rivosinc/scampi/scampi.kicad_sch

## KiCad design scampi.kicad_sch (2025-05-27)

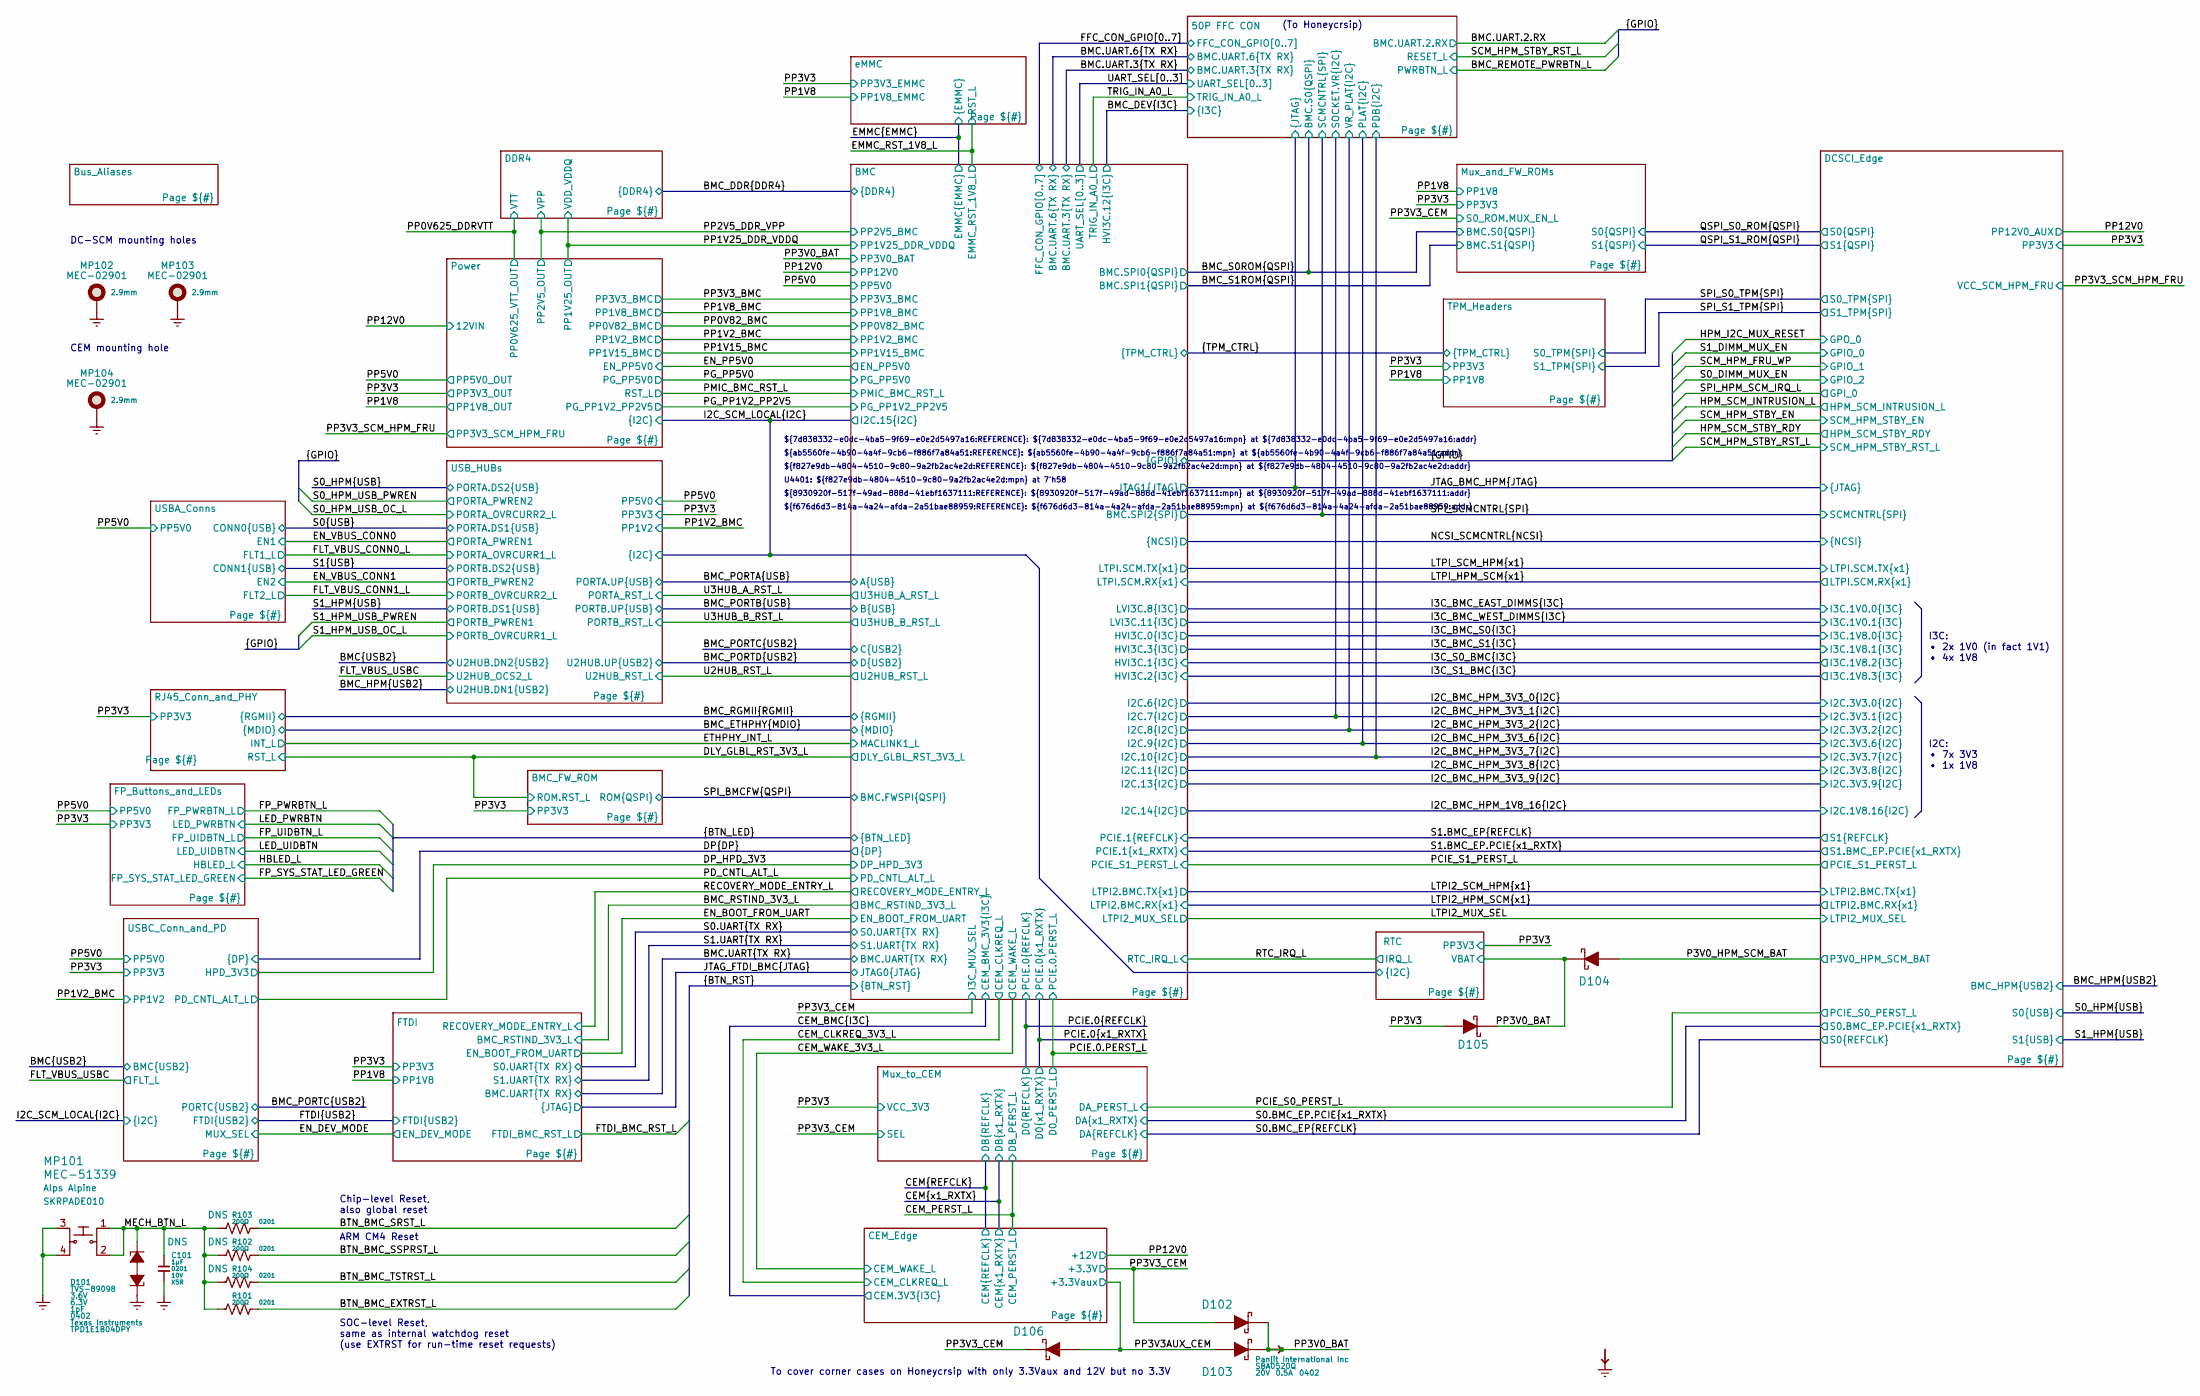
[picture p1: schematic scampi.kicad_sch]

Parts:
C101: CCM-710AD; mpn GRM033R61A105ME15
D101: TVS-89098; mpn TPD1E1B04DPY
D102, D103, D104, D105, D106: DIO-14387; mpn SBA0520Q
MP101: MEC-51339; mpn SKRPADE010
MP102, MP103, MP104: MEC-02901
R101, R102, R103, R104: RES-3200A

Connections:
BTN_BMC_EXTRST_L: R101.2
BTN_BMC_SRST_L: R103.2
BTN_BMC_SSPRST_L: R102.2
BTN_BMC_TSTRST_L: R104.2
GND: C101.2, D101.2, MP101.3, MP101.4, MP102.1, MP103.1, MP104.1
MECH_BTN_L: C101.1, D101.1, MP101.1, MP101.2, R101.1, R102.1, R103.1, R104.1
P3V0_HPM_SCM_BAT: D104.A
PP3V0_BAT: D102.K, D103.K, D104.K, D105.K
PP3V3: D105.A
PP3V3AUX_CEM: D103.A, D106.A
PP3V3_CEM: D102.A, D106.K

Notes on the sheet:
${f676d6d3-814a-4a24-afda-2a51bae88959:REFERENCE}: ${f676d6d3-814a-4a24-afda-2a51bae88959:mpn} at ${f676d6d3-814a-4a24-afda-2a51bae88959:addr}
I2C: • 7x 3V3 • 1x 1V8
${8930920f-517f-49ad-888d-41ebf1637111:REFERENCE}: ${8930920f-517f-49ad-888d-41ebf1637111:mpn} at ${8930920f-517f-49ad-888d-41ebf1637111:addr}
(To Honeycrsip)
DC-SCM mounting holes
${ab5560fe-4b90-4a4f-9cb6-f886f7a84a51:REFERENCE}: ${ab5560fe-4b90-4a4f-9cb6-f886f7a84a51:mpn} at ${ab5560fe-4b90-4a4f-9cb6-f886f7a84a51:addr}
CEM mounting hole
Chip-level Reset, also global reset
SOC-level Reset, same as internal watchdog reset (use EXTRST for run-time reset requests)
U4401: ${f827e9db-4804-4510-9c80-9a2fb2ac4e2d:mpn} at 7'h58
${7d838332-e0dc-4ba5-9f69-e0e2d5497a16:REFERENCE}: ${7d838332-e0dc-4ba5-9f69-e0e2d5497a16:mpn} at ${7d838332-e0dc-4ba5-9f69-e0e2d5497a16:addr}
ARM CM4 Reset
${f827e9db-4804-4510-9c80-9a2fb2ac4e2d:REFERENCE}: ${f827e9db-4804-4510-9c80-9a2fb2ac4e2d:mpn} at ${f827e9db-4804-4510-9c80-9a2fb2ac4e2d:addr}
I3C: • 2x 1V0 (in fact 1V1) • 4x 1V8
To cover corner cases on Honeycrsip with only 3.3Vaux and 12V but no 3.3V
