rivosinc/scampi/sch/adc.kicad_sch

## KiCad design sch/adc.kicad_sch (2025-05-27)

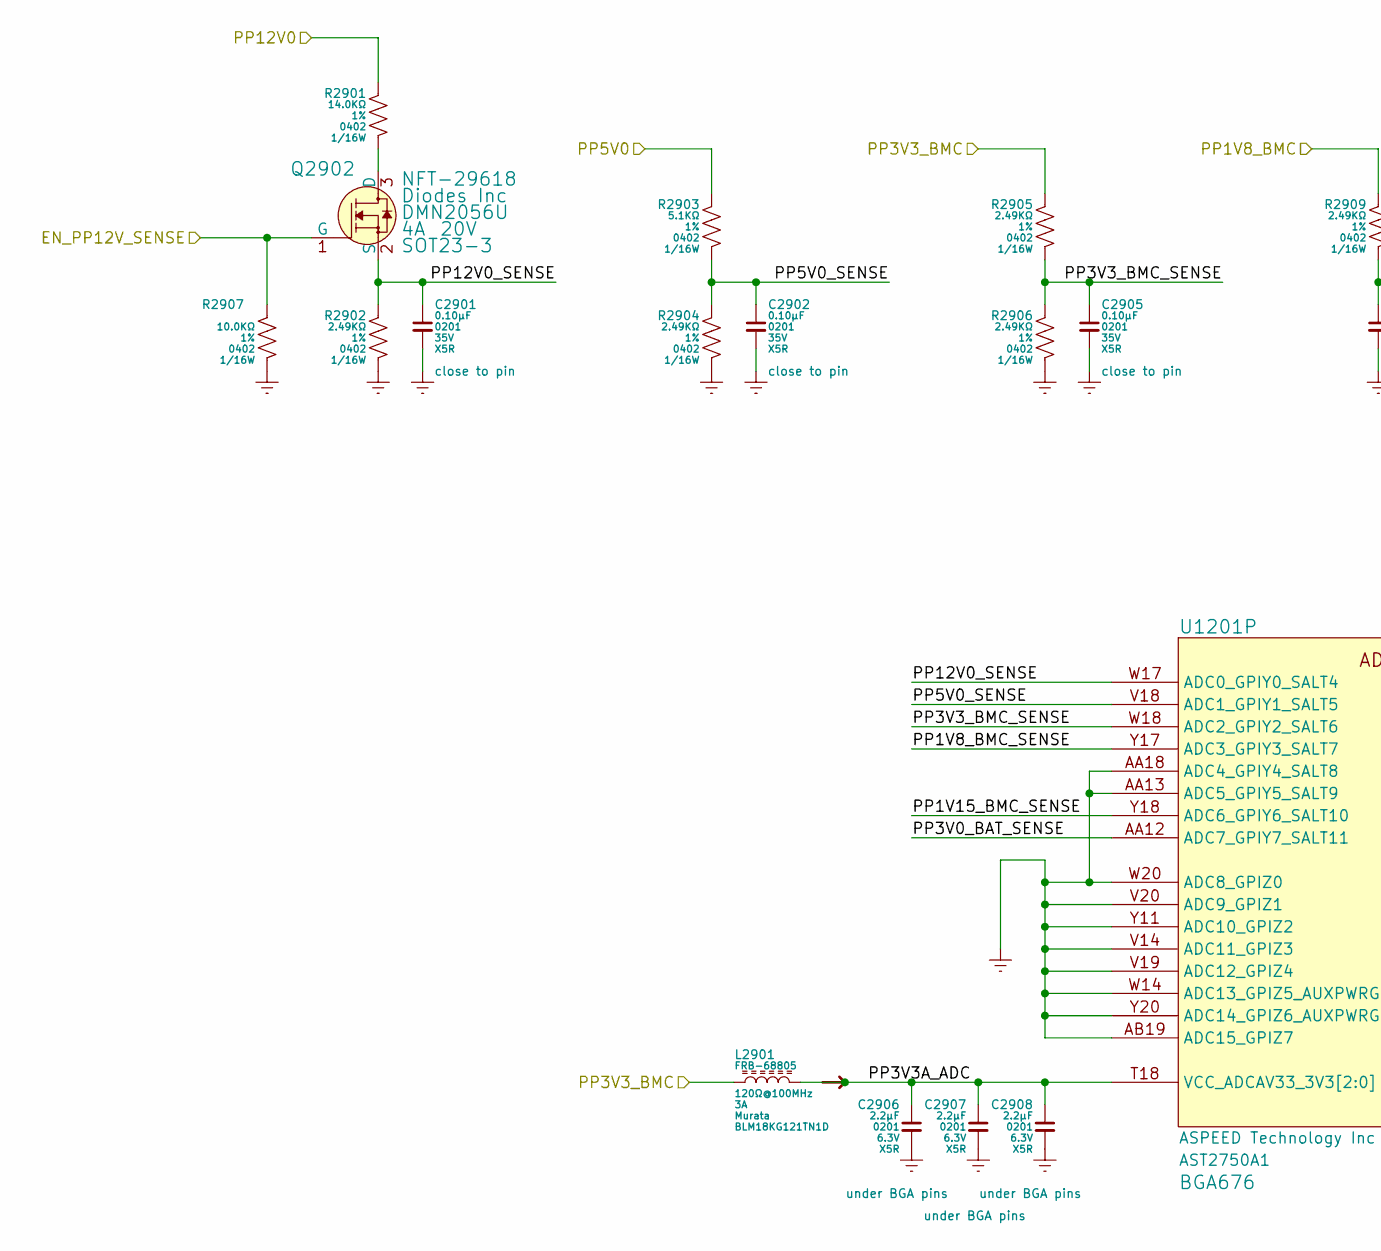
[picture p2: schematic adc.kicad_sch, part in row 1, column 1]

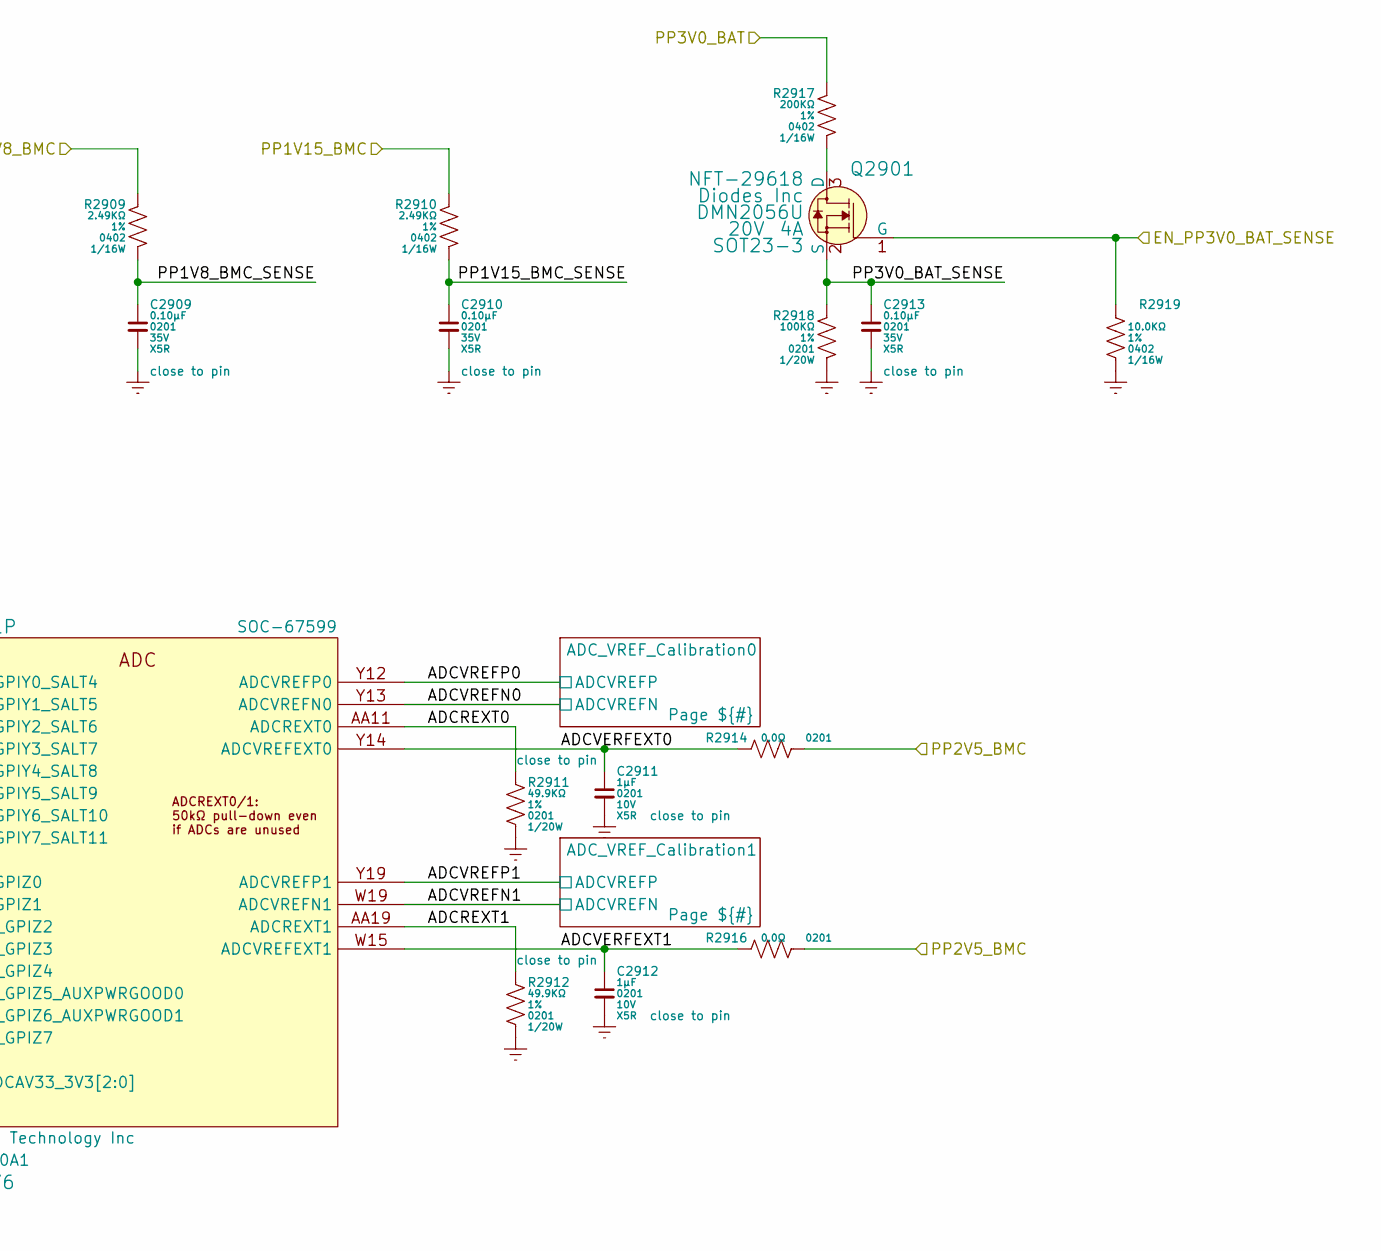
[picture p3: schematic adc.kicad_sch, part in row 1, column 2]

Parts:
C2901, C2902, C2905, C2909, C2910, C2913: CCM-610AE; mpn GRM033R6YA104ME14
C2906, C2907, C2908: CCM-722AA; mpn GRM033R60J225ME01
C2911, C2912: CCM-710AD; mpn GRM033R61A105ME15
L2901: FRB-68805; mpn BLM18KG121TN1D
Q2901, Q2902: NFT-29618; mpn DMN2056U
R2901: RES-5140B
R2902, R2904, R2905, R2906, R2909, R2910: RES-4249B
R2903: RES-4510B
R2907, R2919: RES-5100B
R2911, R2912: RES-5499A
R2914, R2916: RES-0000A
R2917: RES-6200B
R2918: RES-6100A
U1201: SOC-67599; mpn AST2750A1

Connections:
ADCREXT0: R2911.1, U1201.AA11 (ADCREXT0)
ADCREXT1: R2912.1, U1201.AA19 (ADCREXT1)
ADCVERFEXT0: C2911.1, R2914.1, U1201.Y14 (ADCVREFEXT0)
ADCVERFEXT1: C2912.1, R2916.1, U1201.W15 (ADCVREFEXT1)
ADCVREFN0: U1201.Y13 (ADCVREFN0)
ADCVREFN1: U1201.W19 (ADCVREFN1)
ADCVREFP0: U1201.Y12 (ADCVREFP0)
ADCVREFP1: U1201.Y19 (ADCVREFP1)
EN_PP3V0_BAT_SENSE: Q2901.1 (G), R2919.1
EN_PP12V_SENSE: Q2902.1 (G), R2907.1
GND: C2901.2, C2902.2, C2905.2, C2906.2, C2907.2, C2908.2, C2909.2, C2910.2, C2911.2, C2912.2, C2913.2, R2902.2, R2904.2, R2906.2, R2907.2, R2911.2, R2912.2, R2918.2, R2919.2, U1201.AA13 (ADC5_GPIY5_SALT9), U1201.AA18 (ADC4_GPIY4_SALT8), U1201.AB19 (ADC15_GPIZ7), U1201.V14 (ADC11_GPIZ3), U1201.V19 (ADC12_GPIZ4), U1201.V20 (ADC9_GPIZ1), U1201.W14 (ADC13_GPIZ5_AUXPWRGOOD0), U1201.W20 (ADC8_GPIZ0), U1201.Y11 (ADC10_GPIZ2), U1201.Y20 (ADC14_GPIZ6_AUXPWRGOOD1)
unnamed: Q2901.3 (D), R2917.2
unnamed: Q2902.3 (D), R2901.2
PP1V8_BMC: R2909.1
PP1V8_BMC_SENSE: C2909.1, R2909.2, U1201.Y17 (ADC3_GPIY3_SALT7)
PP1V15_BMC: R2910.1
PP1V15_BMC_SENSE: C2910.1, R2910.2, U1201.Y18 (ADC6_GPIY6_SALT10)
PP2V5_BMC: R2914.2, R2916.2
PP3V0_BAT: R2917.1
PP3V0_BAT_SENSE: C2913.1, Q2901.2 (S), R2918.1, U1201.AA12 (ADC7_GPIY7_SALT11)
PP3V3A_ADC: C2906.1, C2907.1, C2908.1, L2901.2, U1201.T18 (VCC_ADCAV33_3V3[2:0]), U1201.T19 (VCC_ADCAV33_3V3[2:0]), U1201.T20 (VCC_ADCAV33_3V3[2:0])
PP3V3_BMC: L2901.1, R2905.1
PP3V3_BMC_SENSE: C2905.1, R2905.2, R2906.1, U1201.W18 (ADC2_GPIY2_SALT6)
PP5V0: R2903.1
PP5V0_SENSE: C2902.1, R2903.2, R2904.1, U1201.V18 (ADC1_GPIY1_SALT5)
PP12V0: R2901.1
PP12V0_SENSE: C2901.1, Q2902.2 (S), R2902.1, U1201.W17 (ADC0_GPIY0_SALT4)
