rivosinc/scampi/sch/adc_vref_cali.kicad_sch

## KiCad design sch/adc_vref_cali.kicad_sch (2025-05-27)

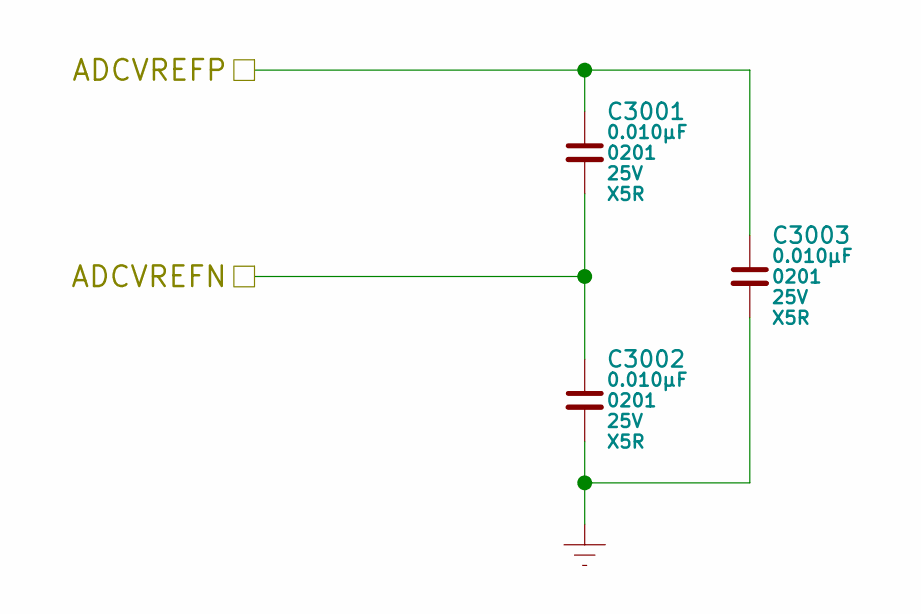
[picture p4: schematic adc_vref_cali.kicad_sch]

Parts:
C3001, C3002, C3003: CCM-510AC; mpn GRM033R61E103MA12

Connections:
ADCVREFN: C3001.2, C3002.1
ADCVREFP: C3001.1, C3003.1
GND: C3002.2, C3003.2
