rivosinc/scampi/sch/bmc.kicad_sch

## KiCad design sch/bmc.kicad_sch (2025-05-27)

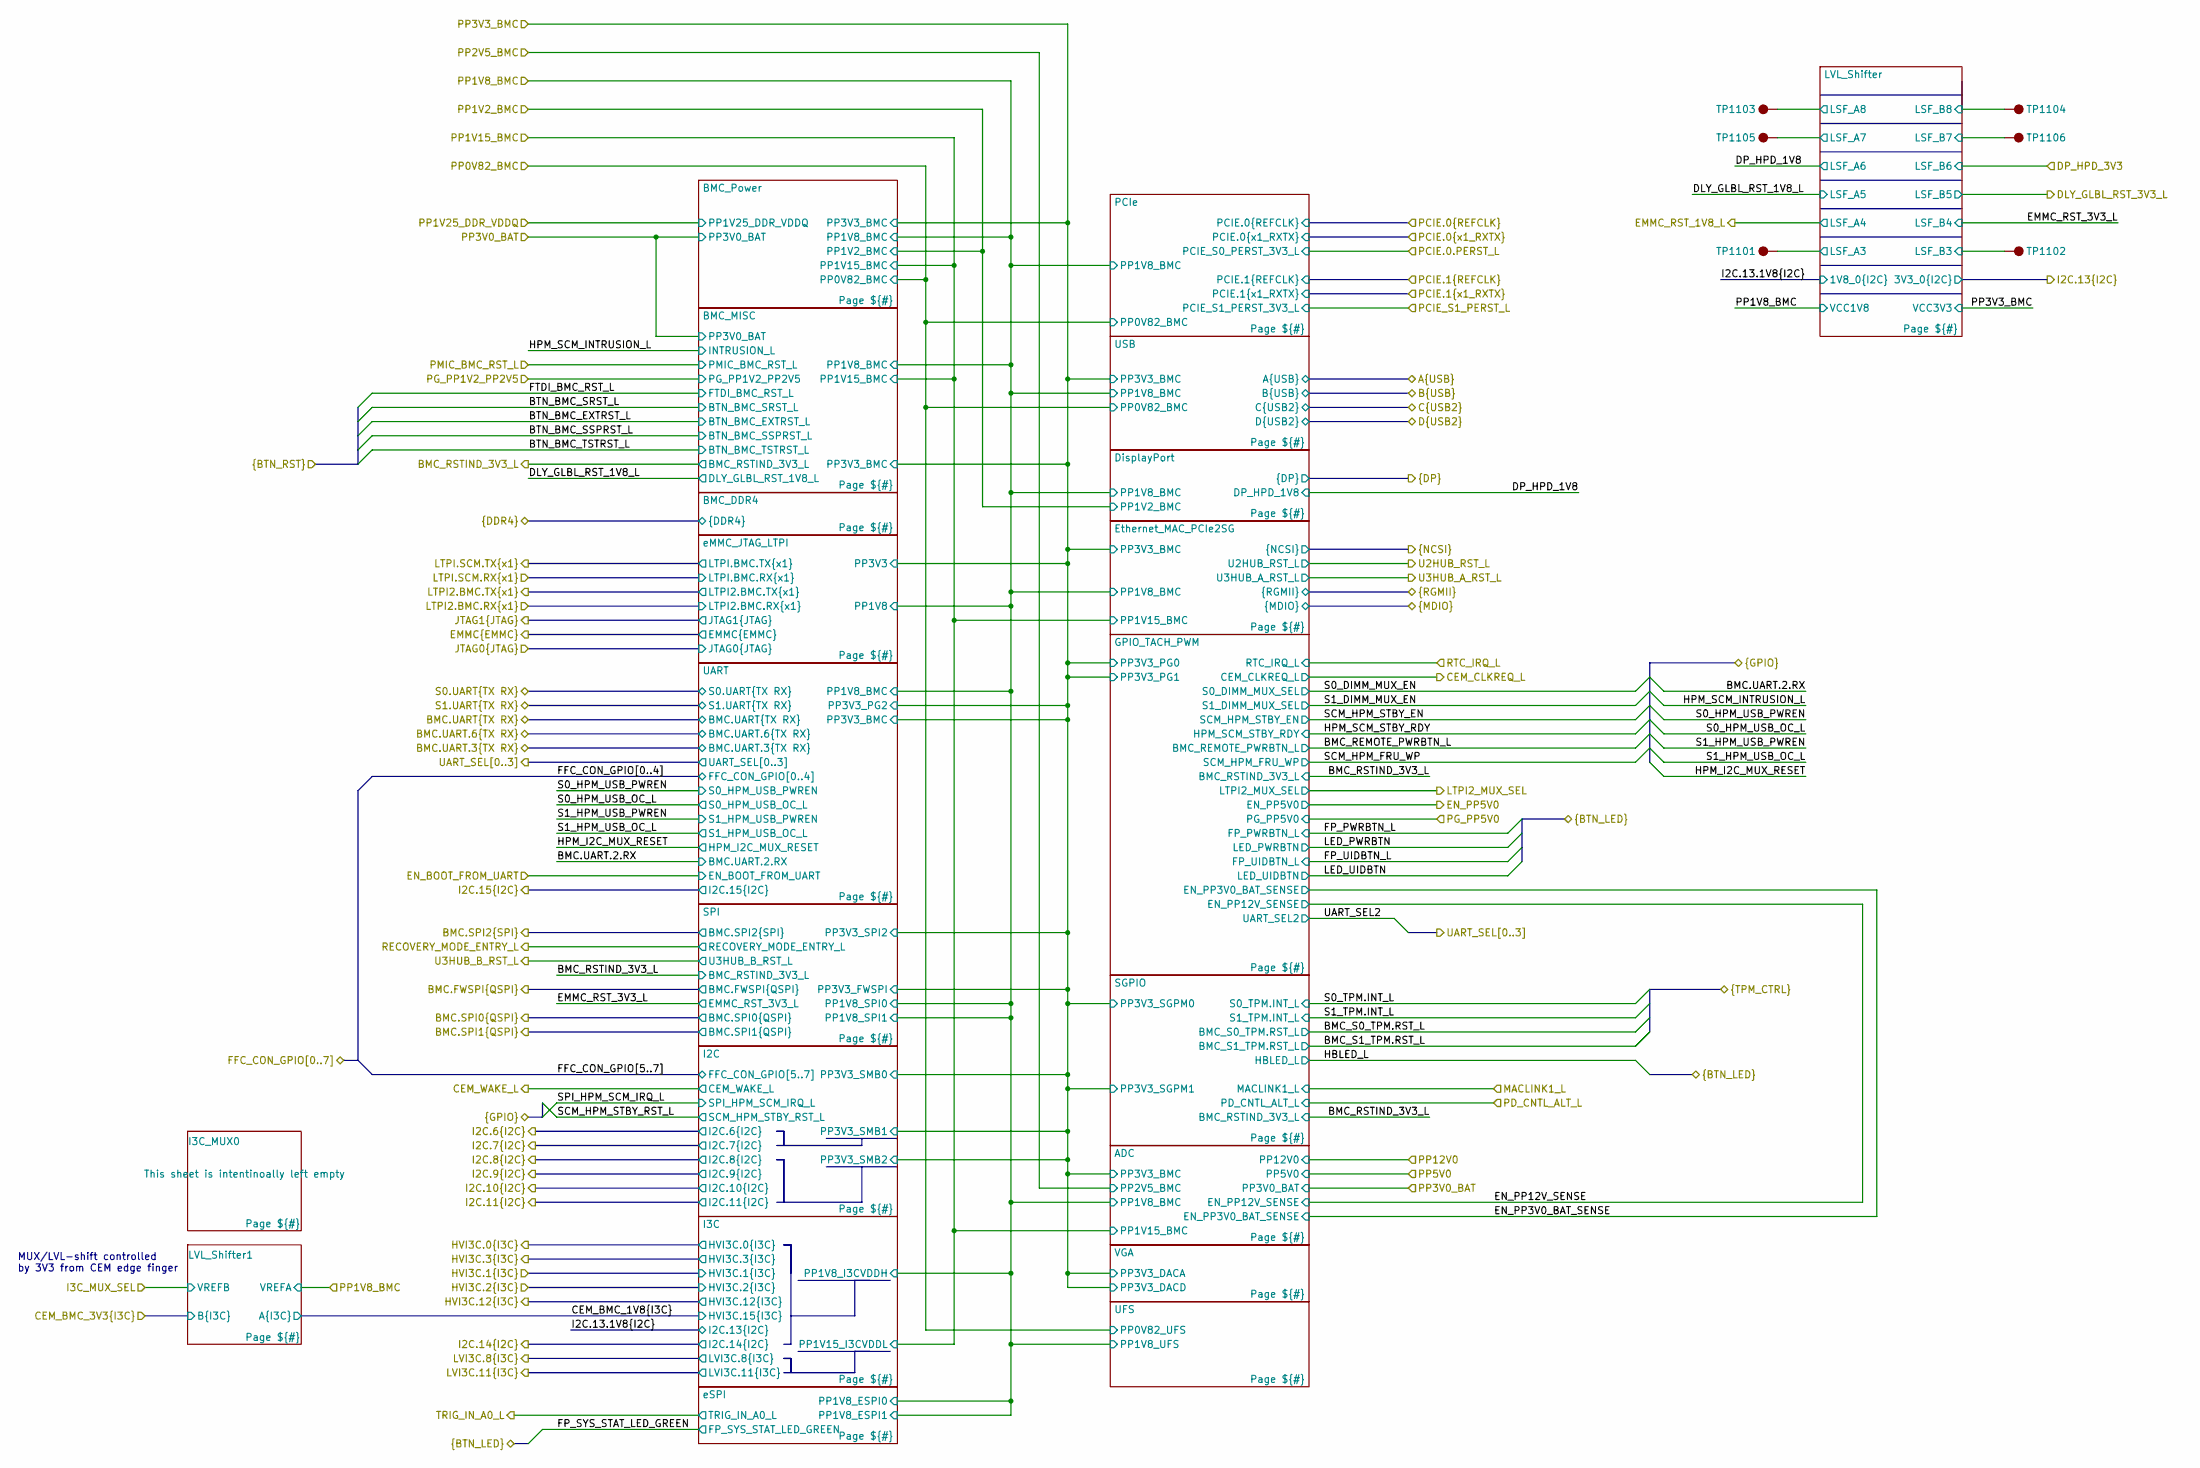
[picture p5: schematic bmc.kicad_sch]

Parts:
TP1101, TP1102, TP1103, TP1104, TP1105, TP1106: TST-01025

Connections:
LSF_A3: TP1101.1
LSF_A7: TP1105.1
LSF_A8: TP1103.1
LSF_B3: TP1102.1
LSF_B7: TP1106.1
LSF_B8: TP1104.1

Notes on the sheet:
MUX/LVL-shift controlled by 3V3 from CEM edge finger
