rivosinc/scampi/sch/bmc_ddr.kicad_sch

## KiCad design sch/bmc_ddr.kicad_sch (2025-05-27)

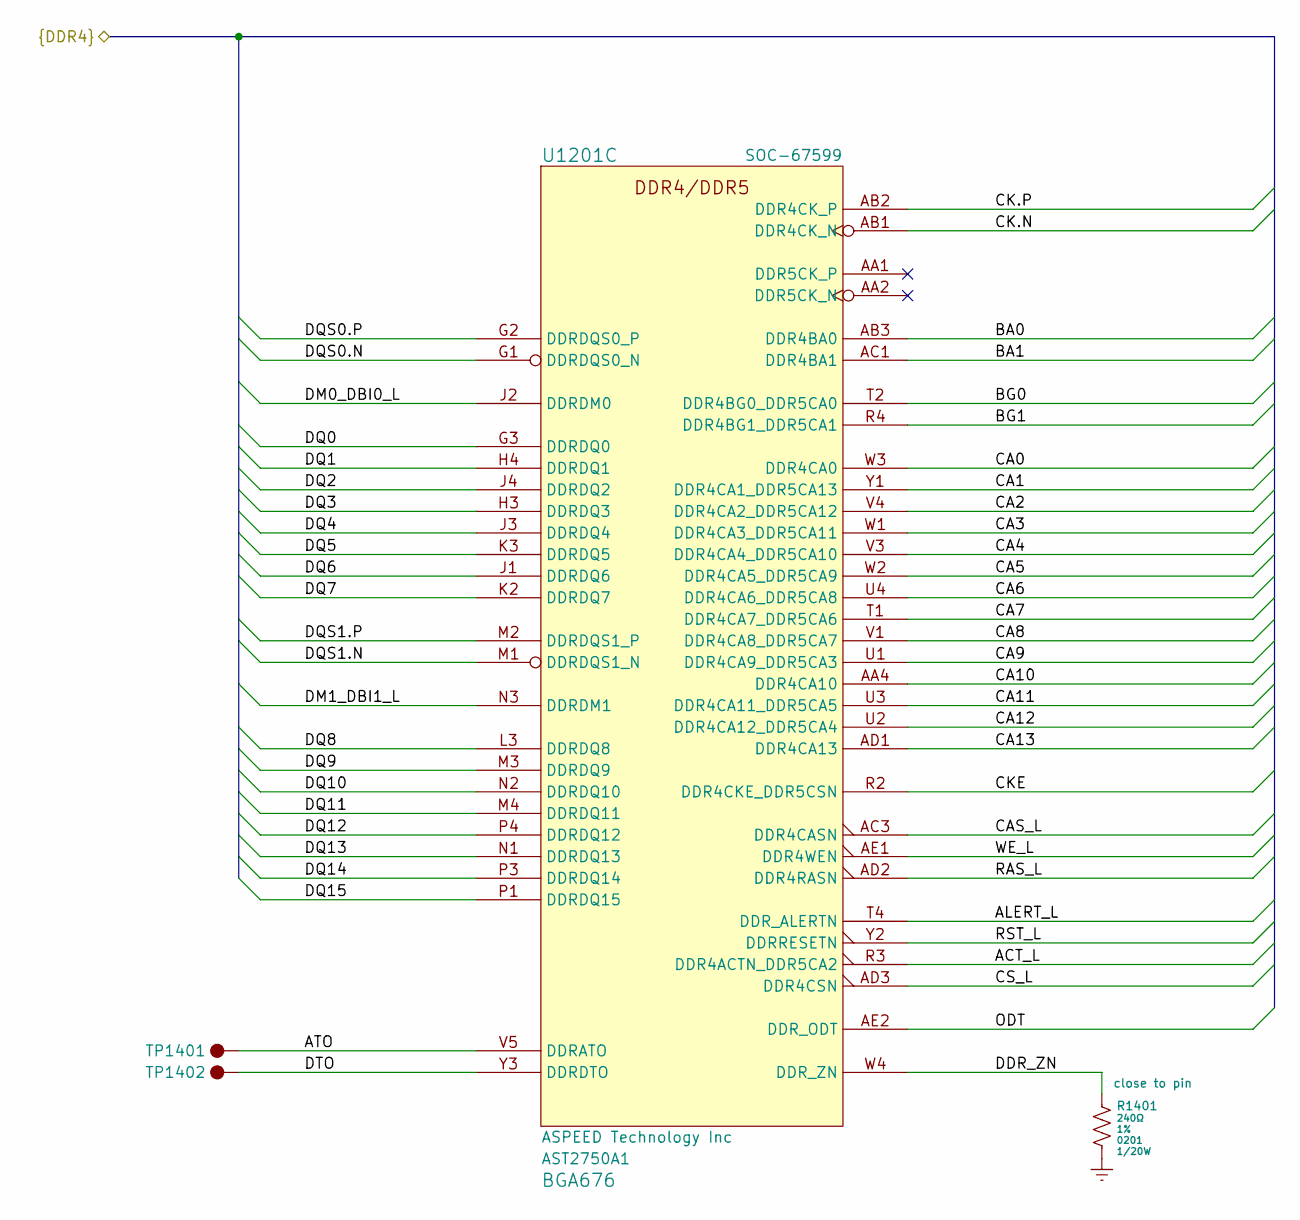
[picture p6: schematic bmc_ddr.kicad_sch]

Parts:
R1401: RES-3240A
TP1401, TP1402: TST-01025
U1201: SOC-67599; mpn AST2750A1

Connections:
ACT_L: U1201.R3 (DDR4ACTN_DDR5CA2)
ALERT_L: U1201.T4 (DDR_ALERTN)
ATO: TP1401.1, U1201.V5 (DDRATO)
BA0: U1201.AB3 (DDR4BA0)
BA1: U1201.AC1 (DDR4BA1)
BG0: U1201.T2 (DDR4BG0_DDR5CA0)
BG1: U1201.R4 (DDR4BG1_DDR5CA1)
CA0: U1201.W3 (DDR4CA0)
CA1: U1201.Y1 (DDR4CA1_DDR5CA13)
CA2: U1201.V4 (DDR4CA2_DDR5CA12)
CA3: U1201.W1 (DDR4CA3_DDR5CA11)
CA4: U1201.V3 (DDR4CA4_DDR5CA10)
CA5: U1201.W2 (DDR4CA5_DDR5CA9)
CA6: U1201.U4 (DDR4CA6_DDR5CA8)
CA7: U1201.T1 (DDR4CA7_DDR5CA6)
CA8: U1201.V1 (DDR4CA8_DDR5CA7)
CA9: U1201.U1 (DDR4CA9_DDR5CA3)
CA10: U1201.AA4 (DDR4CA10)
CA11: U1201.U3 (DDR4CA11_DDR5CA5)
CA12: U1201.U2 (DDR4CA12_DDR5CA4)
CA13: U1201.AD1 (DDR4CA13)
CAS_L: U1201.AC3 (DDR4CASN)
CK.N: U1201.AB1 (DDR4CK_N)
CK.P: U1201.AB2 (DDR4CK_P)
CKE: U1201.R2 (DDR4CKE_DDR5CSN)
CS_L: U1201.AD3 (DDR4CSN)
DDR_ZN: R1401.1, U1201.W4 (DDR_ZN)
DM0_DBI0_L: U1201.J2 (DDRDM0)
DM1_DBI1_L: U1201.N3 (DDRDM1)
DQ0: U1201.G3 (DDRDQ0)
DQ1: U1201.H4 (DDRDQ1)
DQ2: U1201.J4 (DDRDQ2)
DQ3: U1201.H3 (DDRDQ3)
DQ4: U1201.J3 (DDRDQ4)
DQ5: U1201.K3 (DDRDQ5)
DQ6: U1201.J1 (DDRDQ6)
DQ7: U1201.K2 (DDRDQ7)
DQ8: U1201.L3 (DDRDQ8)
DQ9: U1201.M3 (DDRDQ9)
DQ10: U1201.N2 (DDRDQ10)
DQ11: U1201.M4 (DDRDQ11)
DQ12: U1201.P4 (DDRDQ12)
DQ13: U1201.N1 (DDRDQ13)
DQ14: U1201.P3 (DDRDQ14)
DQ15: U1201.P1 (DDRDQ15)
DQS0.N: U1201.G1 (DDRDQS0_N)
DQS0.P: U1201.G2 (DDRDQS0_P)
DQS1.N: U1201.M1 (DDRDQS1_N)
DQS1.P: U1201.M2 (DDRDQS1_P)
DTO: TP1402.1, U1201.Y3 (DDRDTO)
GND: R1401.2
ODT: U1201.AE2 (DDR_ODT)
RAS_L: U1201.AD2 (DDR4RASN)
RST_L: U1201.Y2 (DDRRESETN)
WE_L: U1201.AE1 (DDR4WEN)
