rivosinc/scampi/sch/bmc_fw_rom.kicad_sch

## KiCad design sch/bmc_fw_rom.kicad_sch (2025-05-27)

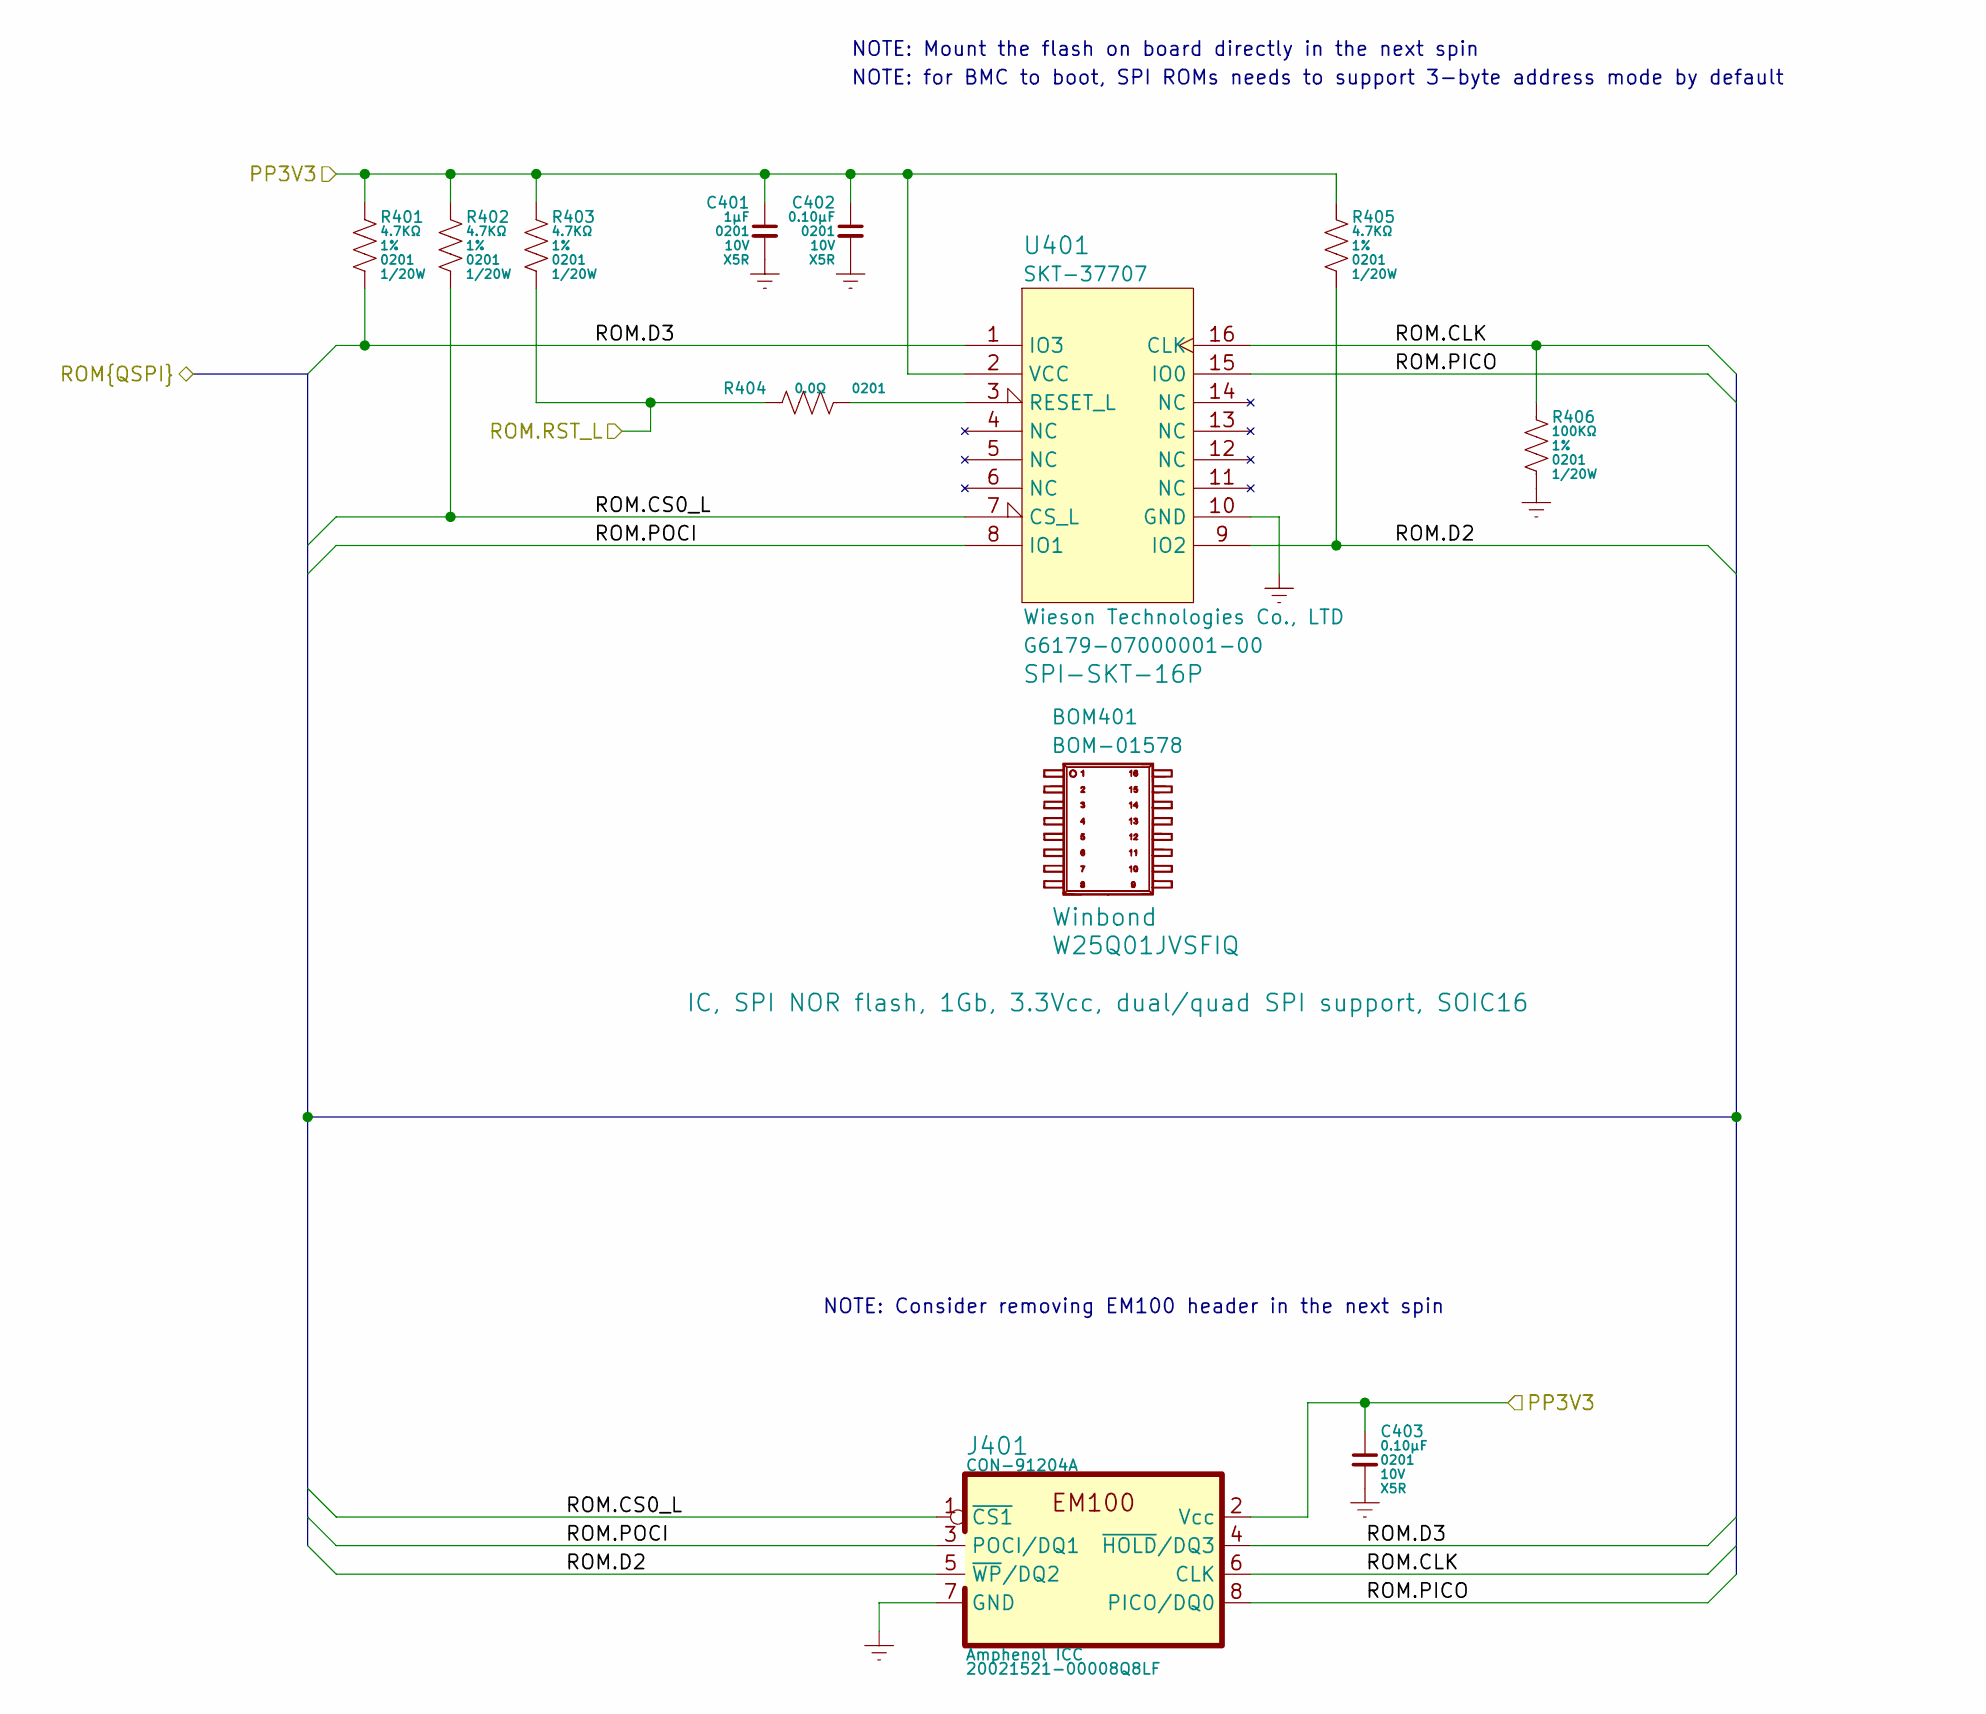
[picture p7: schematic bmc_fw_rom.kicad_sch]

Parts:
BOM401: BOM-01578; mpn W25Q01JVSFIQ
C401: CCM-710AD; mpn GRM033R61A105ME15
C402, C403: CCM-610AA; mpn GRM033R61A104ME15
J401: CON-91204A; mpn 20021521-00008Q8LF
R401, R402, R403, R405: RES-4470A
R404: RES-0000A
R406: RES-6100A
U401: SKT-37707; mpn G6179-07000001-00

Connections:
GND: C401.2, C402.2, C403.2, J401.7 (GND), R406.2, U401.10 (GND)
unnamed: R404.2, U401.3 (RESET_L)
PP3V3: C401.1, C402.1, C403.1, J401.2 (Vcc), R401.1, R402.1, R403.1, R405.1, U401.2 (VCC)
ROM.CLK: J401.6 (CLK), R406.1, U401.16 (CLK)
ROM.CS0_L: J401.1 (~CS1), R402.2, U401.7 (CS_L)
ROM.D2: J401.5 (~WP/DQ2), R405.2, U401.9 (IO2)
ROM.D3: J401.4 (~HOLD/DQ3), R401.2, U401.1 (IO3)
ROM.PICO: J401.8 (PICO/DQ0), U401.15 (IO0)
ROM.POCI: J401.3 (POCI/DQ1), U401.8 (IO1)
ROM.RST_L: R403.2, R404.1

Notes on the sheet:
NOTE: for BMC to boot, SPI ROMs needs to support 3-byte address mode by default
NOTE: Consider removing EM100 header in the next spin
NOTE: Mount the flash on board directly in the next spin
