rivosinc/scampi/sch/bmc_misc.kicad_sch

## KiCad design sch/bmc_misc.kicad_sch (2025-05-27)

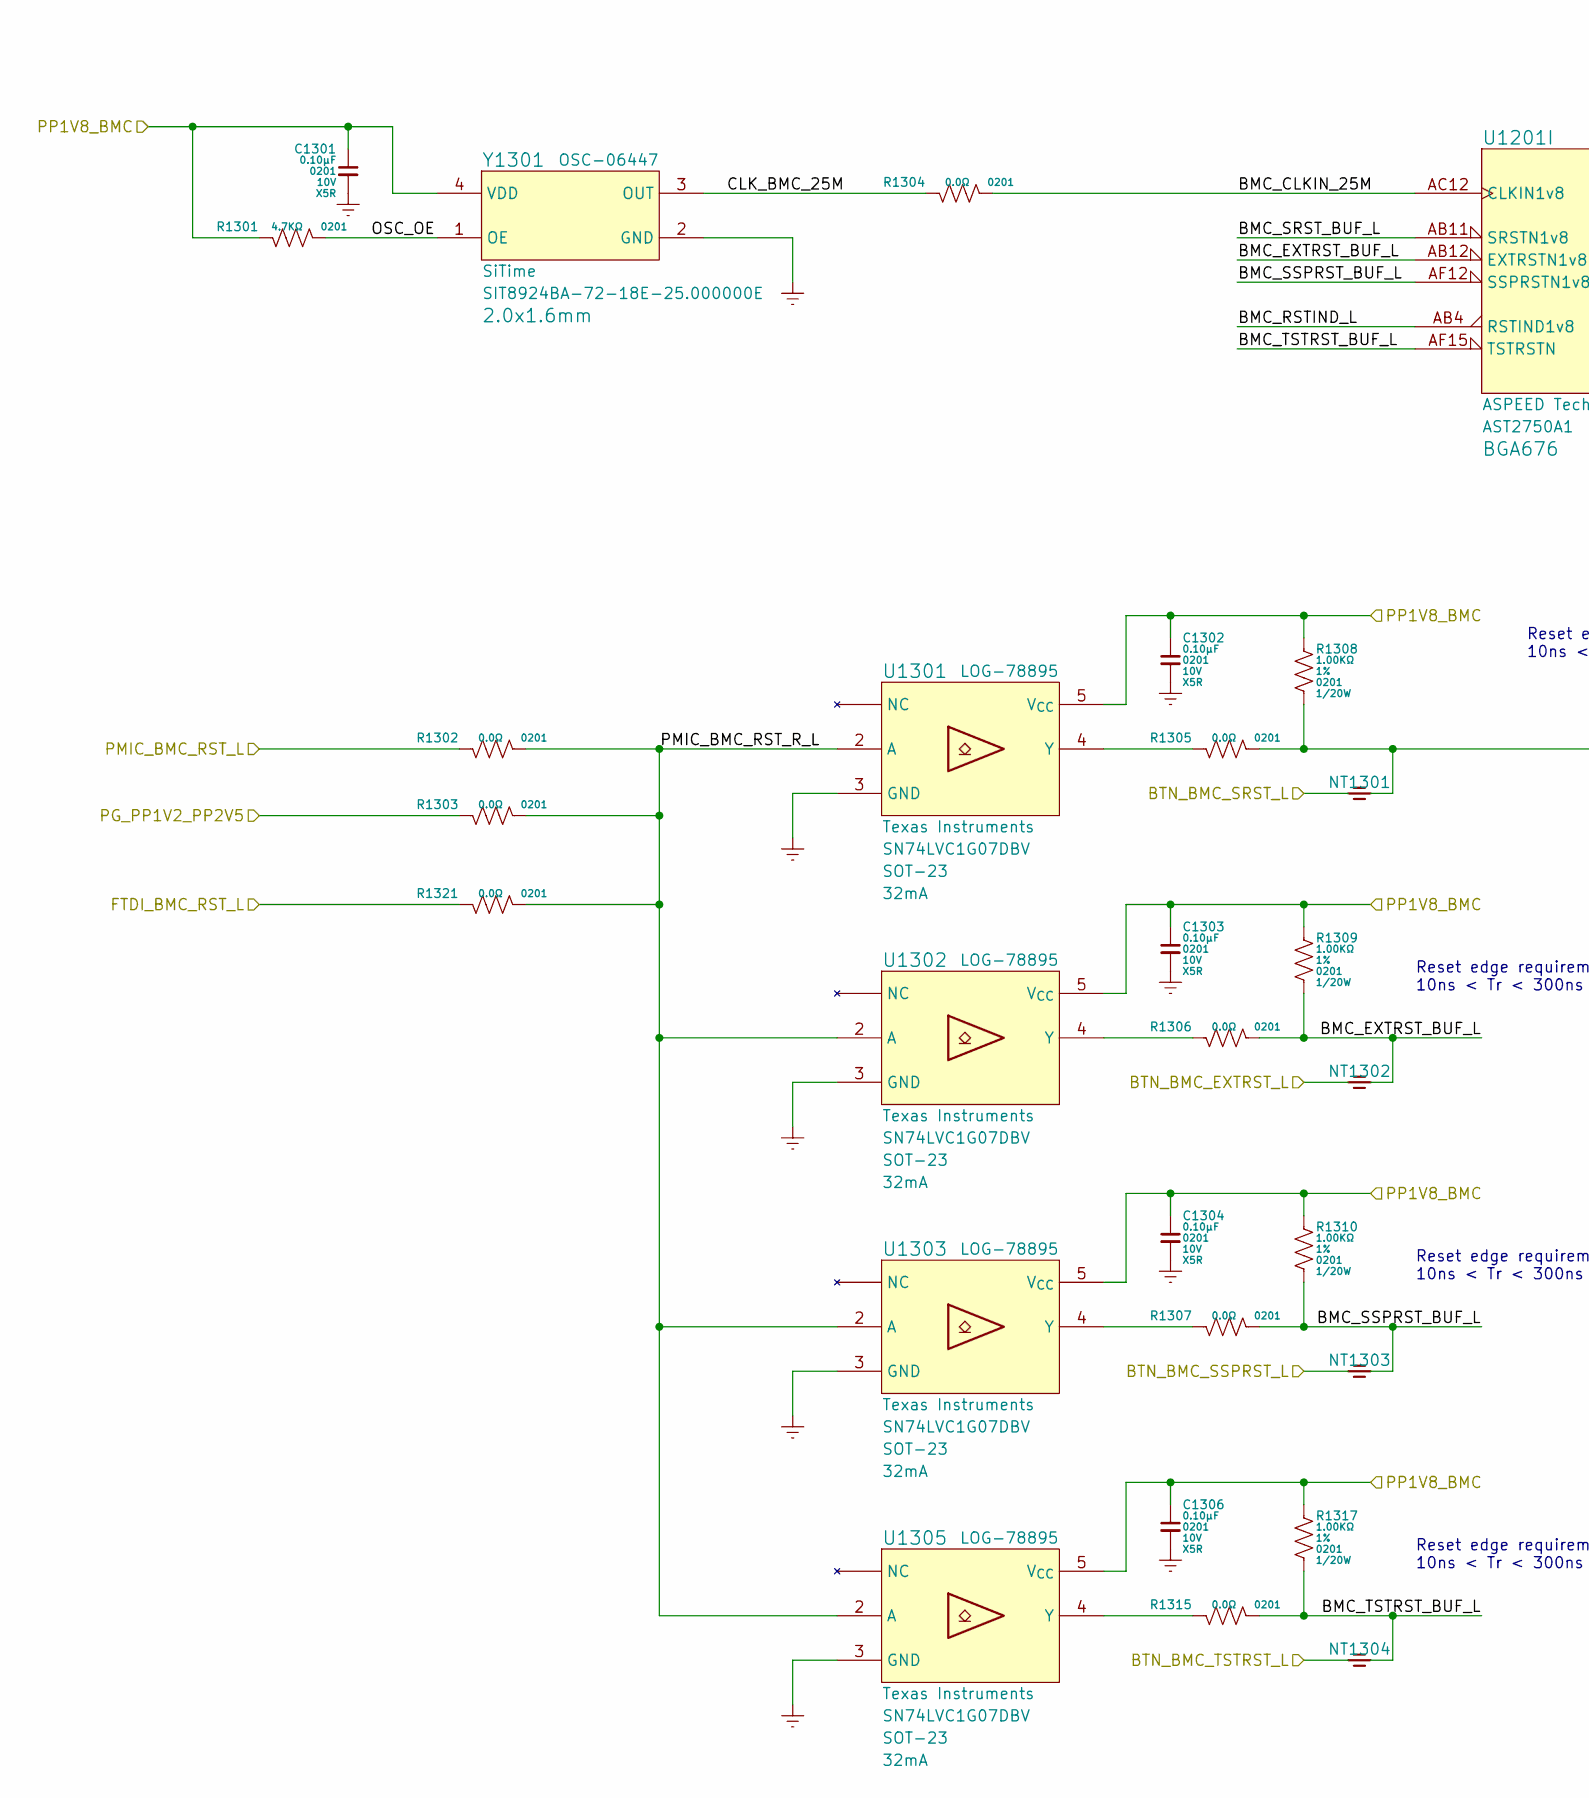
[picture p8: schematic bmc_misc.kicad_sch, part in row 1, column 1]

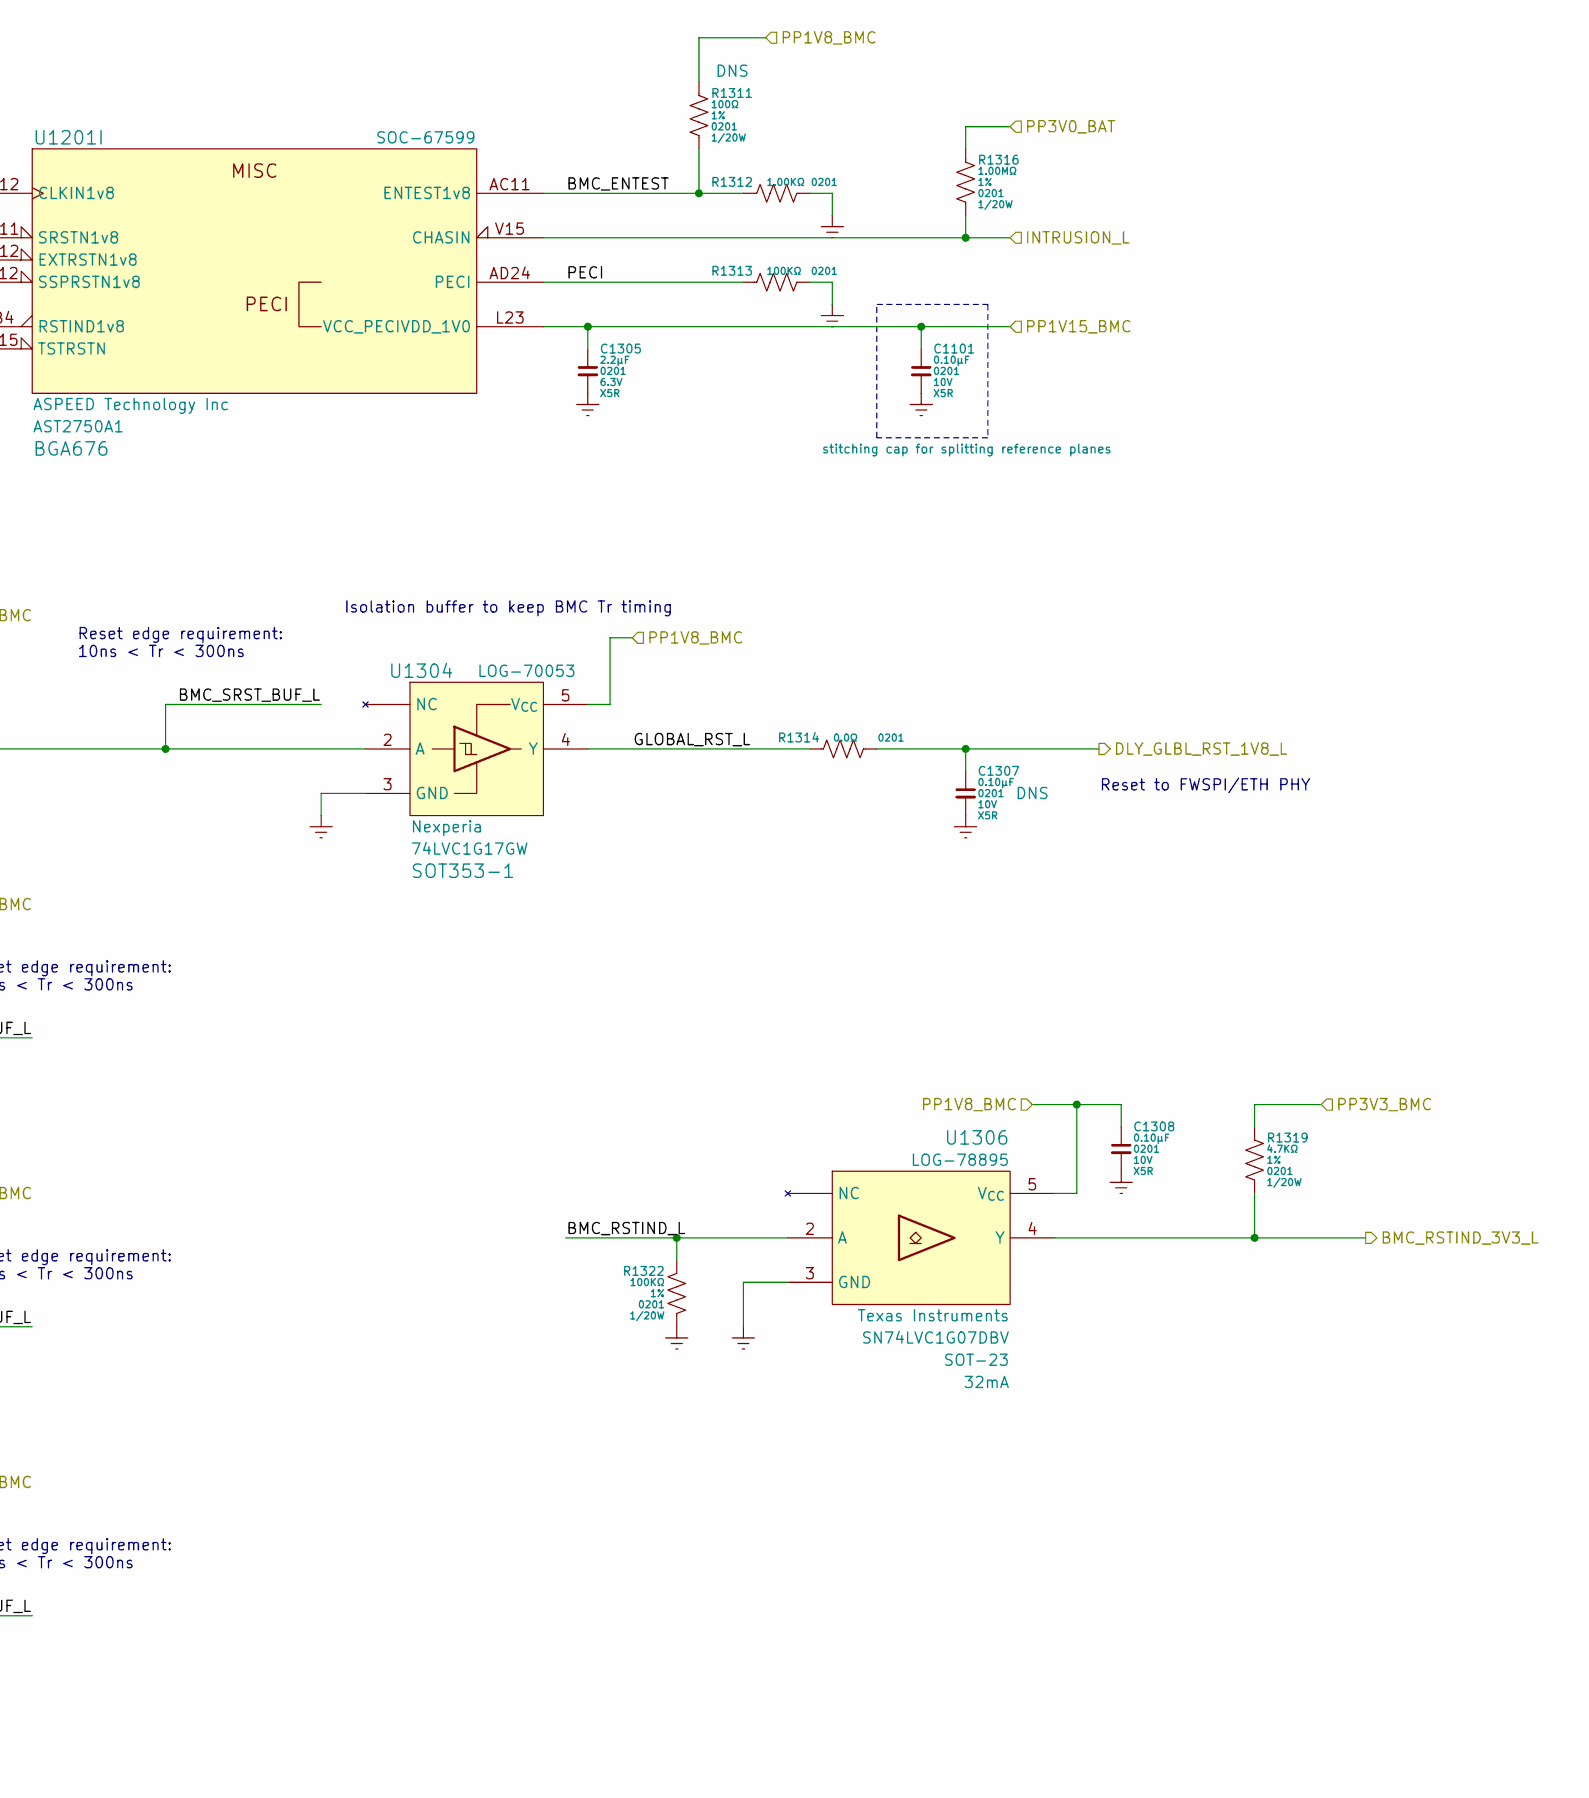
[picture p9: schematic bmc_misc.kicad_sch, part in row 1, column 2]

Parts:
C1101, C1301, C1302, C1303, C1304, C1306, C1307, C1308: CCM-610AA; mpn GRM033R61A104ME15
C1305: CCM-722AA; mpn GRM033R60J225ME01
NT1301, NT1302, NT1303, NT1304: NET-10002
R1301, R1319: RES-4470A
R1302, R1303, R1304, R1305, R1306, R1307, R1314, R1315, R1321: RES-0000A
R1308, R1309, R1310, R1312, R1317: RES-4100A
R1311: RES-3100A
R1313, R1322: RES-6100A
R1316: RES-7100A
U1201: SOC-67599; mpn AST2750A1
U1301, U1302, U1303, U1305, U1306: LOG-78895; mpn SN74LVC1G07DBV
U1304: LOG-70053; mpn 74LVC1G17GW
Y1301: OSC-06447; mpn SIT8924BA-72-18E-25.000000E

Connections:
BMC_CLKIN_25M: R1304.1, U1201.AC12 (CLKIN1v8)
BMC_ENTEST: R1311.2, R1312.1, U1201.AC11 (ENTEST1v8)
BMC_EXTRST_BUF_L: NT1302.2, R1306.1, R1309.2, U1201.AB12 (EXTRSTN1v8)
BMC_RSTIND_3V3_L: R1319.2, U1306.4 (Y)
BMC_RSTIND_L: R1322.1, U1201.AB4 (RSTIND1v8), U1306.2 (A)
BMC_SRST_BUF_L: NT1301.2, R1305.1, R1308.2, U1201.AB11 (SRSTN1v8), U1304.2 (A)
BMC_SSPRST_BUF_L: NT1303.2, R1307.1, R1310.2, U1201.AF12 (SSPRSTN1v8)
BMC_TSTRST_BUF_L: NT1304.2, R1315.1, R1317.2, U1201.AF15 (TSTRSTN)
BTN_BMC_EXTRST_L: NT1302.1
BTN_BMC_SRST_L: NT1301.1
BTN_BMC_SSPRST_L: NT1303.1
BTN_BMC_TSTRST_L: NT1304.1
CLK_BMC_25M: R1304.2, Y1301.3 (OUT)
DLY_GLBL_RST_1V8_L: C1307.1, R1314.2
FTDI_BMC_RST_L: R1321.2
GLOBAL_RST_L: R1314.1, U1304.4 (Y)
GND: C1101.2, C1301.2, C1302.2, C1303.2, C1304.2, C1305.2, C1306.2, C1307.2, C1308.2, R1312.2, R1313.2, R1322.2, U1301.3 (GND), U1302.3 (GND), U1303.3 (GND), U1304.3 (GND), U1305.3 (GND), U1306.3 (GND), Y1301.2 (GND)
INTRUSION_L: R1316.2, U1201.V15 (CHASIN)
unnamed: R1305.2, U1301.4 (Y)
unnamed: R1306.2, U1302.4 (Y)
unnamed: R1307.2, U1303.4 (Y)
unnamed: R1315.2, U1305.4 (Y)
OSC_OE: R1301.1, Y1301.1 (OE)
PECI: R1313.1, U1201.AD24 (PECI)
PG_PP1V2_PP2V5: R1303.2
PMIC_BMC_RST_L: R1302.2
PMIC_BMC_RST_R_L: R1302.1, R1303.1, R1321.1, U1301.2 (A), U1302.2 (A), U1303.2 (A), U1305.2 (A)
PP1V8_BMC: C1301.1, C1302.1, C1303.1, C1304.1, C1306.1, C1308.1, R1301.2, R1308.1, R1309.1, R1310.1, R1311.1, R1317.1, U1301.5 (V_{CC}), U1302.5 (V_{CC}), U1303.5 (V_{CC}), U1304.5 (V_{CC}), U1305.5 (V_{CC}), U1306.5 (V_{CC}), Y1301.4 (VDD)
PP1V15_BMC: C1101.1, C1305.1, U1201.L23 (VCC_PECIVDD_1V0)
PP3V0_BAT: R1316.1
PP3V3_BMC: R1319.1

Notes on the sheet:
Reset to FWSPI/ETH PHY
Reset edge requirement: 10ns < Tr < 300ns
Isolation buffer to keep BMC Tr timing
