rivosinc/scampi/sch/bmc_pwr.kicad_sch

## KiCad design sch/bmc_pwr.kicad_sch (2025-05-27)

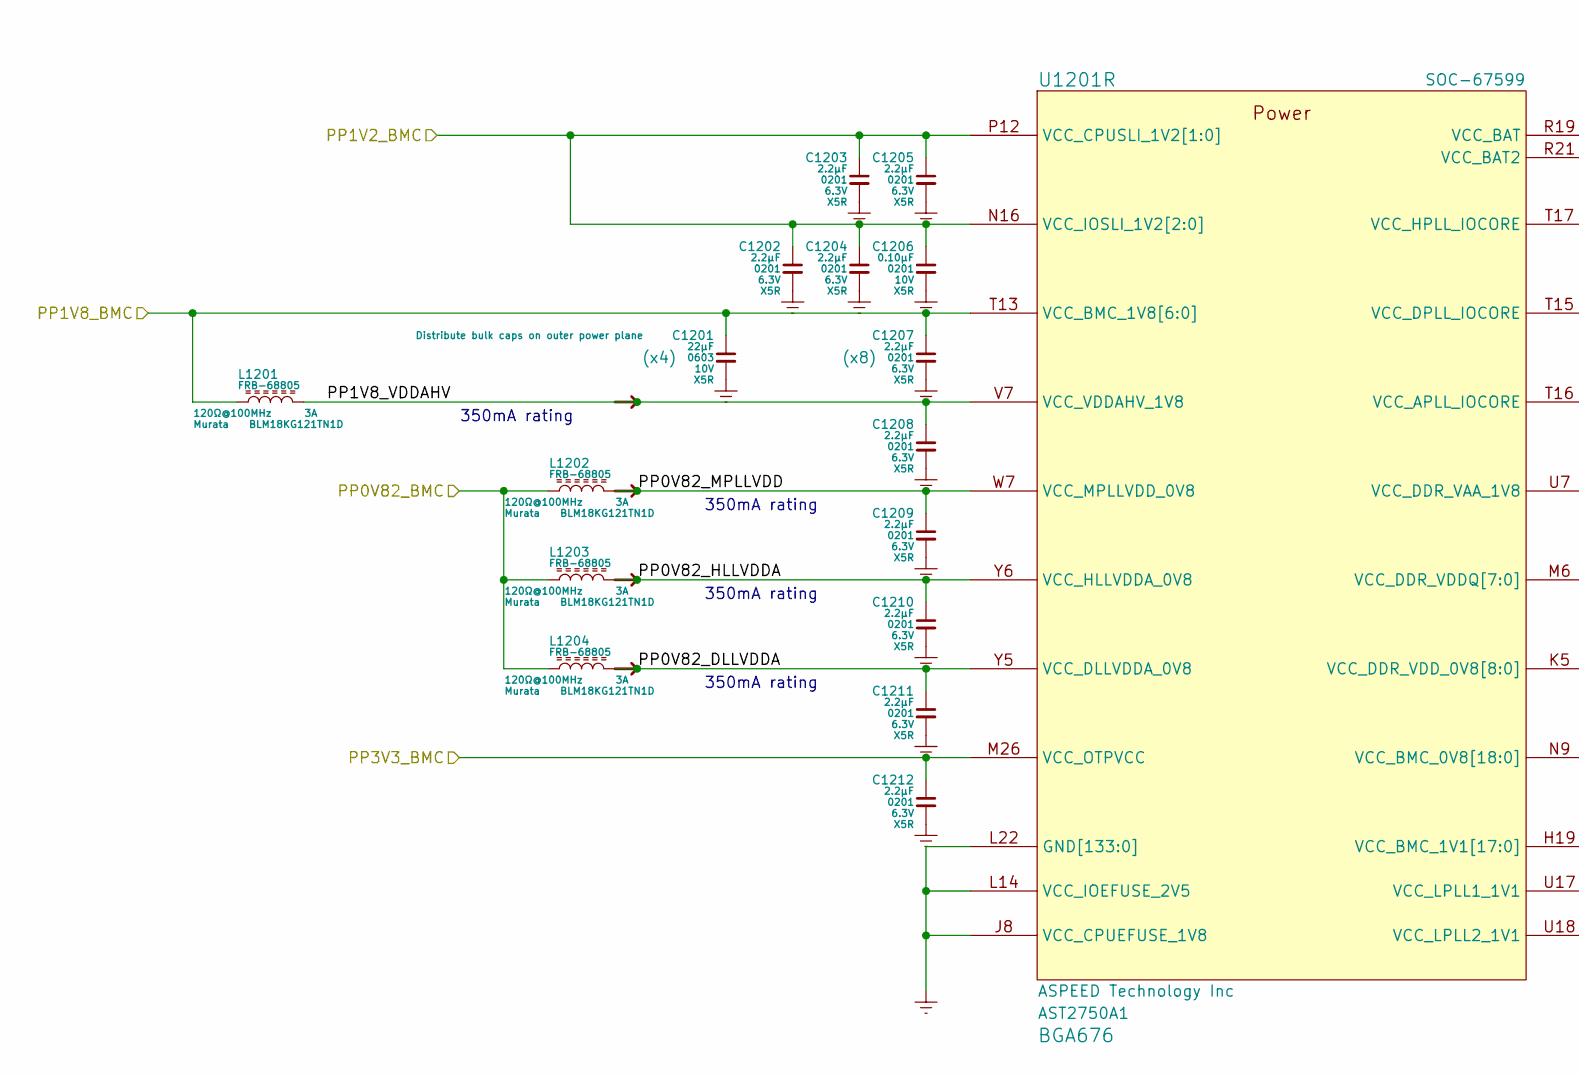
[picture p10: schematic bmc_pwr.kicad_sch, part in row 1, column 1]

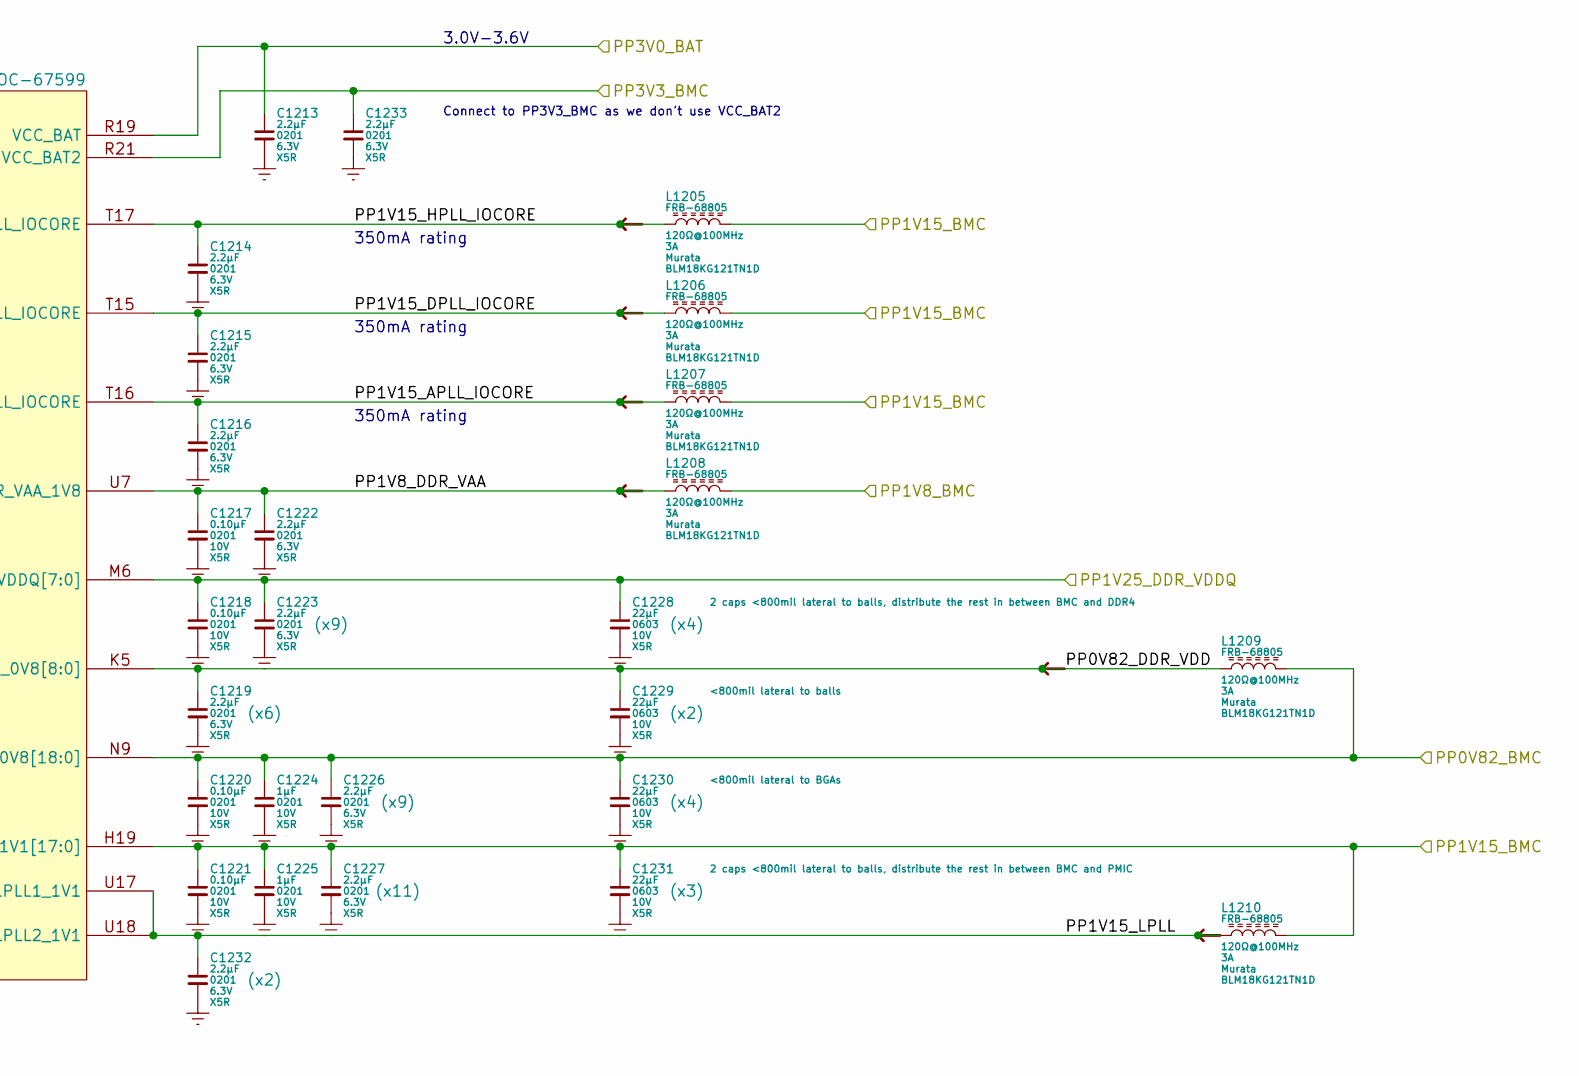
[picture p11: schematic bmc_pwr.kicad_sch, part in row 1, column 2]

Parts:
C1201, C1228, C1229, C1230, C1231: CCM-822CC; mpn GRM188R61A226ME15
C1202, C1203, C1204, C1205, C1207, C1208, C1209, C1210, C1211, C1212, C1213, C1214, C1215, C1216, C1219, C1222, C1223, C1226, C1227, C1232, C1233: CCM-722AA; mpn GRM033R60J225ME01
C1206, C1217, C1218, C1220, C1221: CCM-610AA; mpn GRM033R61A104ME15
C1224, C1225: CCM-710AD; mpn GRM033R61A105ME15
L1201, L1202, L1203, L1204, L1205, L1206, L1207, L1208, L1209, L1210: FRB-68805; mpn BLM18KG121TN1D
U1201: SOC-67599; mpn AST2750A1

Connections:
GND: C1201.2, C1202.2, C1203.2, C1204.2, C1205.2, C1206.2, C1207.2, C1208.2, C1209.2, C1210.2, C1211.2, C1212.2, C1213.2, C1214.2, C1215.2, C1216.2, C1217.2, C1218.2, C1219.2, C1220.2, C1221.2, C1222.2, C1223.2, C1224.2, C1225.2, C1226.2, C1227.2, C1228.2, C1229.2, C1230.2, C1231.2, C1232.2, C1233.2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
PP0V82_BMC: C1220.1, C1224.1, C1226.1, C1230.1, L1202.1, L1203.1, L1204.1, L1209.2, U1201.N9 (VCC_BMC_0V8[18:0]), U1201.N10 (VCC_BMC_0V8[18:0]), U1201.N11 (VCC_BMC_0V8[18:0]), U1201.P9 (VCC_BMC_0V8[18:0]), U1201.P10 (VCC_BMC_0V8[18:0]), U1201.P11 (VCC_BMC_0V8[18:0]), U1201.R9 (VCC_BMC_0V8[18:0]), U1201.R10 (VCC_BMC_0V8[18:0]), U1201.R11 (VCC_BMC_0V8[18:0]), U1201.T9 (VCC_BMC_0V8[18:0]), U1201.T10 (VCC_BMC_0V8[18:0]), U1201.T11 (VCC_BMC_0V8[18:0]), U1201.U9 (VCC_BMC_0V8[18:0]), U1201.U10 (VCC_BMC_0V8[18:0]), U1201.U11 (VCC_BMC_0V8[18:0]), U1201.V9 (VCC_BMC_0V8[18:0]), U1201.V10 (VCC_BMC_0V8[18:0]), U1201.V11 (VCC_BMC_0V8[18:0]), U1201.W10 (VCC_BMC_0V8[18:0])
PP0V82_DDR_VDD: C1219.1, C1229.1, L1209.1, U1201.K5 (VCC_DDR_VDD_0V8[8:0]), U1201.K6 (VCC_DDR_VDD_0V8[8:0]), U1201.L6 (VCC_DDR_VDD_0V8[8:0]), U1201.L7 (VCC_DDR_VDD_0V8[8:0]), U1201.M7 (VCC_DDR_VDD_0V8[8:0]), U1201.N7 (VCC_DDR_VDD_0V8[8:0]), U1201.P7 (VCC_DDR_VDD_0V8[8:0]), U1201.R7 (VCC_DDR_VDD_0V8[8:0]), U1201.T7 (VCC_DDR_VDD_0V8[8:0])
PP0V82_DLLVDDA: C1211.1, L1204.2, U1201.Y5 (VCC_DLLVDDA_0V8)
PP0V82_HLLVDDA: C1210.1, L1203.2, U1201.Y6 (VCC_HLLVDDA_0V8)
PP0V82_MPLLVDD: C1209.1, L1202.2, U1201.W7 (VCC_MPLLVDD_0V8)
PP1V2_BMC: C1202.1, C1203.1, C1204.1, C1205.1, C1206.1, U1201.N16 (VCC_IOSLI_1V2[2:0]), U1201.P12 (VCC_CPUSLI_1V2[1:0]), U1201.P16 (VCC_IOSLI_1V2[2:0]), U1201.R12 (VCC_CPUSLI_1V2[1:0]), U1201.R16 (VCC_IOSLI_1V2[2:0])
PP1V8_BMC: C1201.1, C1207.1, L1201.1, L1208.2, U1201.P17 (VCC_BMC_1V8[6:0]), U1201.P18 (VCC_BMC_1V8[6:0]), U1201.R17 (VCC_BMC_1V8[6:0]), U1201.T13 (VCC_BMC_1V8[6:0]), U1201.U13 (VCC_BMC_1V8[6:0]), U1201.V13 (VCC_BMC_1V8[6:0]), U1201.W13 (VCC_BMC_1V8[6:0])
PP1V8_DDR_VAA: C1217.1, C1222.1, L1208.1, U1201.U7 (VCC_DDR_VAA_1V8)
PP1V8_VDDAHV: C1208.1, L1201.2, U1201.V7 (VCC_VDDAHV_1V8)
PP1V15_APLL_IOCORE: C1216.1, L1207.1, U1201.T16 (VCC_APLL_IOCORE)
PP1V15_BMC: C1221.1, C1225.1, C1227.1, C1231.1, L1205.2, L1206.2, L1207.2, L1210.2, U1201.H19 (VCC_BMC_1V1[17:0]), U1201.H20 (VCC_BMC_1V1[17:0]), U1201.J18 (VCC_BMC_1V1[17:0]), U1201.J19 (VCC_BMC_1V1[17:0]), U1201.J20 (VCC_BMC_1V1[17:0]), U1201.J21 (VCC_BMC_1V1[17:0]), U1201.K18 (VCC_BMC_1V1[17:0]), U1201.K19 (VCC_BMC_1V1[17:0]), U1201.K20 (VCC_BMC_1V1[17:0]), U1201.K21 (VCC_BMC_1V1[17:0]), U1201.L18 (VCC_BMC_1V1[17:0]), U1201.L19 (VCC_BMC_1V1[17:0]), U1201.L20 (VCC_BMC_1V1[17:0]), U1201.L21 (VCC_BMC_1V1[17:0]), U1201.M18 (VCC_BMC_1V1[17:0]), U1201.M19 (VCC_BMC_1V1[17:0]), U1201.M20 (VCC_BMC_1V1[17:0]), U1201.M21 (VCC_BMC_1V1[17:0])
PP1V15_DPLL_IOCORE: C1215.1, L1206.1, U1201.T15 (VCC_DPLL_IOCORE)
PP1V15_HPLL_IOCORE: C1214.1, L1205.1, U1201.T17 (VCC_HPLL_IOCORE)
PP1V15_LPLL: C1232.1, L1210.1, U1201.U17 (VCC_LPLL1_1V1), U1201.U18 (VCC_LPLL2_1V1)
PP1V25_DDR_VDDQ: C1218.1, C1223.1, C1228.1, U1201.M6 (VCC_DDR_VDDQ[7:0]), U1201.N6 (VCC_DDR_VDDQ[7:0]), U1201.P6 (VCC_DDR_VDDQ[7:0]), U1201.R6 (VCC_DDR_VDDQ[7:0]), U1201.T6 (VCC_DDR_VDDQ[7:0]), U1201.U6 (VCC_DDR_VDDQ[7:0]), U1201.V6 (VCC_DDR_VDDQ[7:0]), U1201.W6 (VCC_DDR_VDDQ[7:0])
PP3V0_BAT: C1213.1, U1201.R19 (VCC_BAT)
PP3V3_BMC: C1212.1, C1233.1, U1201.M26 (VCC_OTPVCC), U1201.R21 (VCC_BAT2)

Notes on the sheet:
350mA rating
3.0V-3.6V
Connect to PP3V3_BMC as we don't use VCC_BAT2
