rivosinc/scampi/sch/cem_edge.kicad_sch

## KiCad design sch/cem_edge.kicad_sch (2025-05-27)

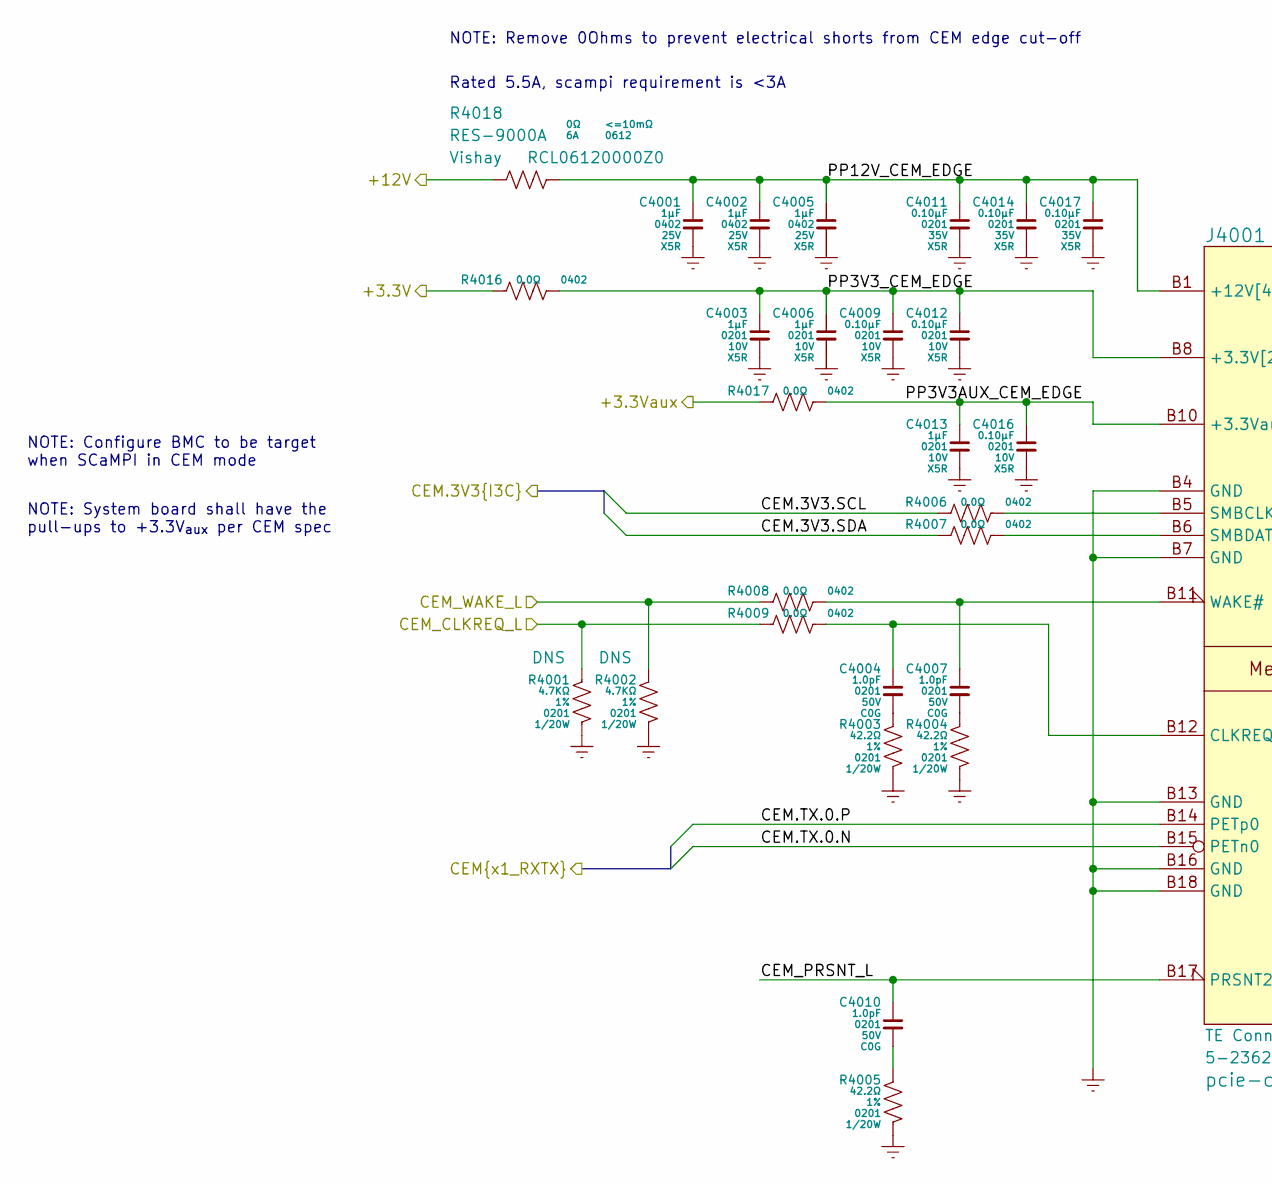
[picture p12: schematic cem_edge.kicad_sch, part in row 1, column 1]

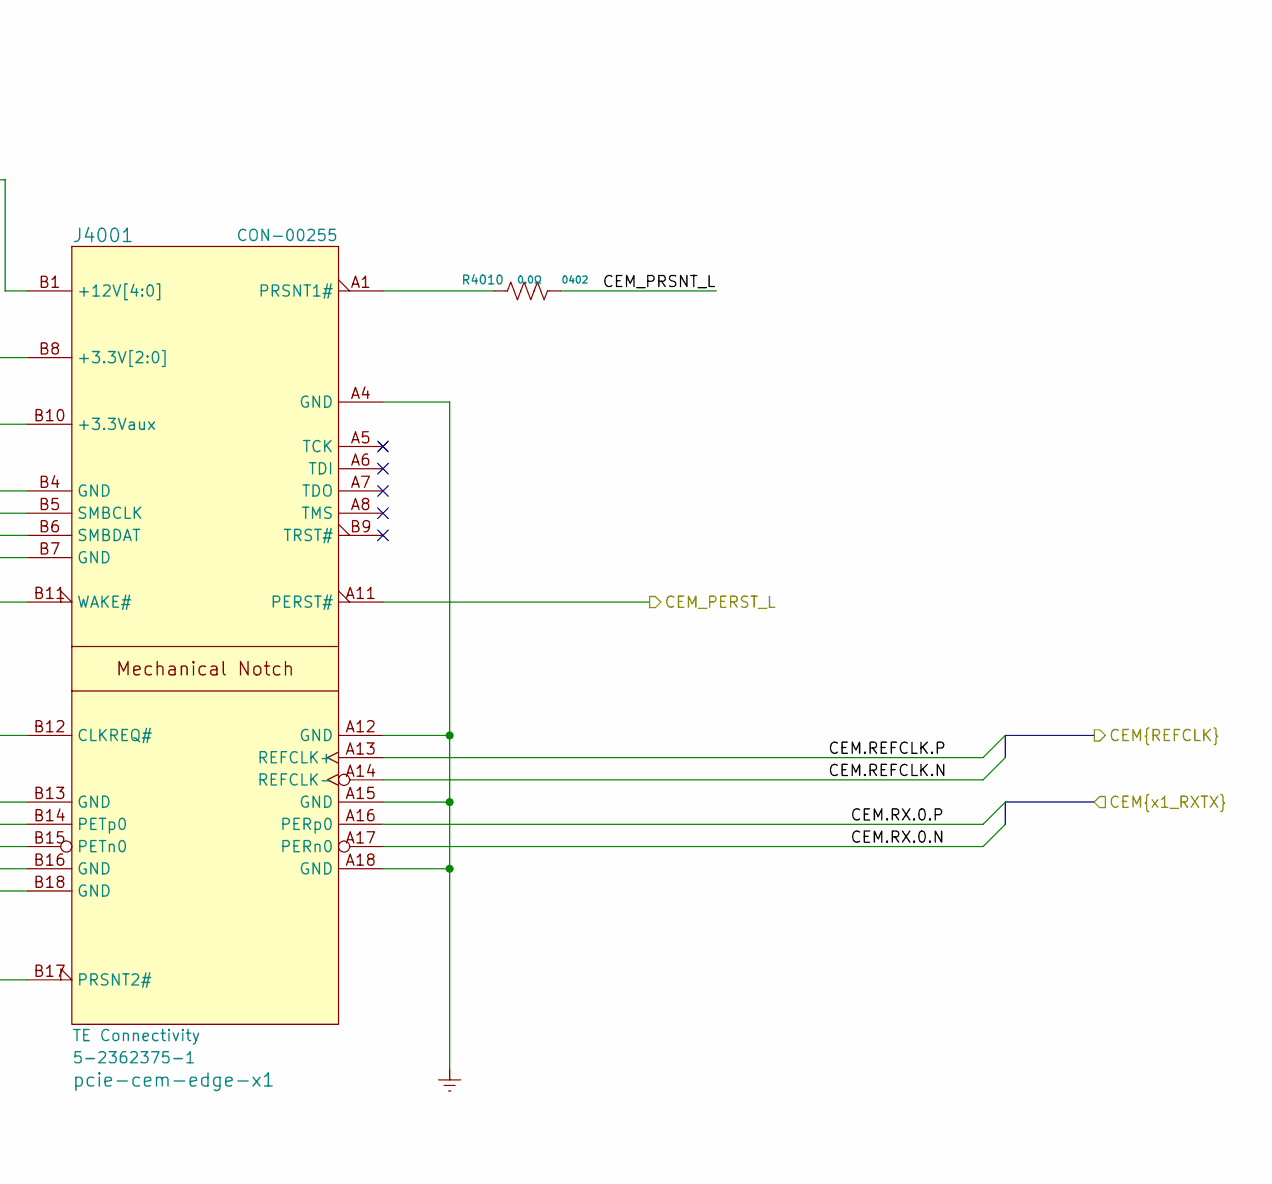
[picture p13: schematic cem_edge.kicad_sch, part in row 1, column 2]

Parts:
C4001, C4002, C4005: CCM-710BC; mpn GRM155R61E105KA12
C4003, C4006, C4013: CCM-710AD; mpn GRM033R61A105ME15
C4004, C4007, C4010: CCM-110AA; mpn GRM0335C1H1R0CA01
C4009, C4012, C4016: CCM-610AA; mpn GRM033R61A104ME15
C4011, C4014, C4017: CCM-610AE; mpn GRM033R6YA104ME14
J4001: CON-00255; mpn 5-2362375-1
R4001, R4002: RES-4470A
R4003, R4004, R4005: RES-2422A
R4006, R4007, R4008, R4009, R4010, R4016, R4017: RES-0000B
R4018: RES-9000A; mpn RCL06120000Z0

Connections:
+3.3V: R4016.1
+3.3Vaux: R4017.1
+12V: R4018.1
CEM.3V3.SCL: R4006.1
CEM.3V3.SDA: R4007.1
CEM.REFCLK.N: J4001.A14 (REFCLK-)
CEM.REFCLK.P: J4001.A13 (REFCLK+)
CEM.RX.0.N: J4001.A17 (PERn0)
CEM.RX.0.P: J4001.A16 (PERp0)
CEM.TX.0.N: J4001.B15 (PETn0)
CEM.TX.0.P: J4001.B14 (PETp0)
CEM_CLKREQ_L: R4001.1, R4009.1
CEM_PERST_L: J4001.A11 (PERST#)
CEM_PRSNT_L: C4010.1, J4001.B17 (PRSNT2#), R4010.2
CEM_WAKE_L: R4002.1, R4008.1
GND: C4001.2, C4002.2, C4003.2, C4005.2, C4006.2, C4009.2, C4011.2, C4012.2, C4013.2, C4014.2, C4016.2, C4017.2, J4001.A4 (GND), J4001.A12 (GND), J4001.A15 (GND), J4001.A18 (GND), J4001.B4 (GND), J4001.B7 (GND), J4001.B13 (GND), J4001.B16 (GND), J4001.B18 (GND), R4001.2, R4002.2, R4003.2, R4004.2, R4005.2
unnamed: C4004.1, J4001.B12 (CLKREQ#), R4009.2
unnamed: C4004.2, R4003.1
unnamed: C4007.1, J4001.B11 (WAKE#), R4008.2
unnamed: C4007.2, R4004.1
unnamed: C4010.2, R4005.1
unnamed: J4001.A1 (PRSNT1#), R4010.1
unnamed: J4001.B5 (SMBCLK), R4006.2
unnamed: J4001.B6 (SMBDAT), R4007.2
PP3V3AUX_CEM_EDGE: C4013.1, C4016.1, J4001.B10 (+3.3Vaux), R4017.2
PP3V3_CEM_EDGE: C4003.1, C4006.1, C4009.1, C4012.1, J4001.A9 (+3.3V[2:0]), J4001.A10 (+3.3V[2:0]), J4001.B8 (+3.3V[2:0]), R4016.2
PP12V_CEM_EDGE: C4001.1, C4002.1, C4005.1, C4011.1, C4014.1, C4017.1, J4001.A2 (+12V[4:0]), J4001.A3 (+12V[4:0]), J4001.B1 (+12V[4:0]), J4001.B2 (+12V[4:0]), J4001.B3 (+12V[4:0]), R4018.2

Notes on the sheet:
NOTE: Configure BMC to be target when SCaMPI in CEM mode
Rated 5.5A, scampi requirement is <3A
NOTE: System board shall have the pull-ups to +3.3V_{aux} per CEM spec
NOTE: Remove 0Ohms to prevent electrical shorts from CEM edge cut-off
