rivosinc/scampi/sch/dcsci_edge.kicad_sch

## KiCad design sch/dcsci_edge.kicad_sch (2025-05-27)

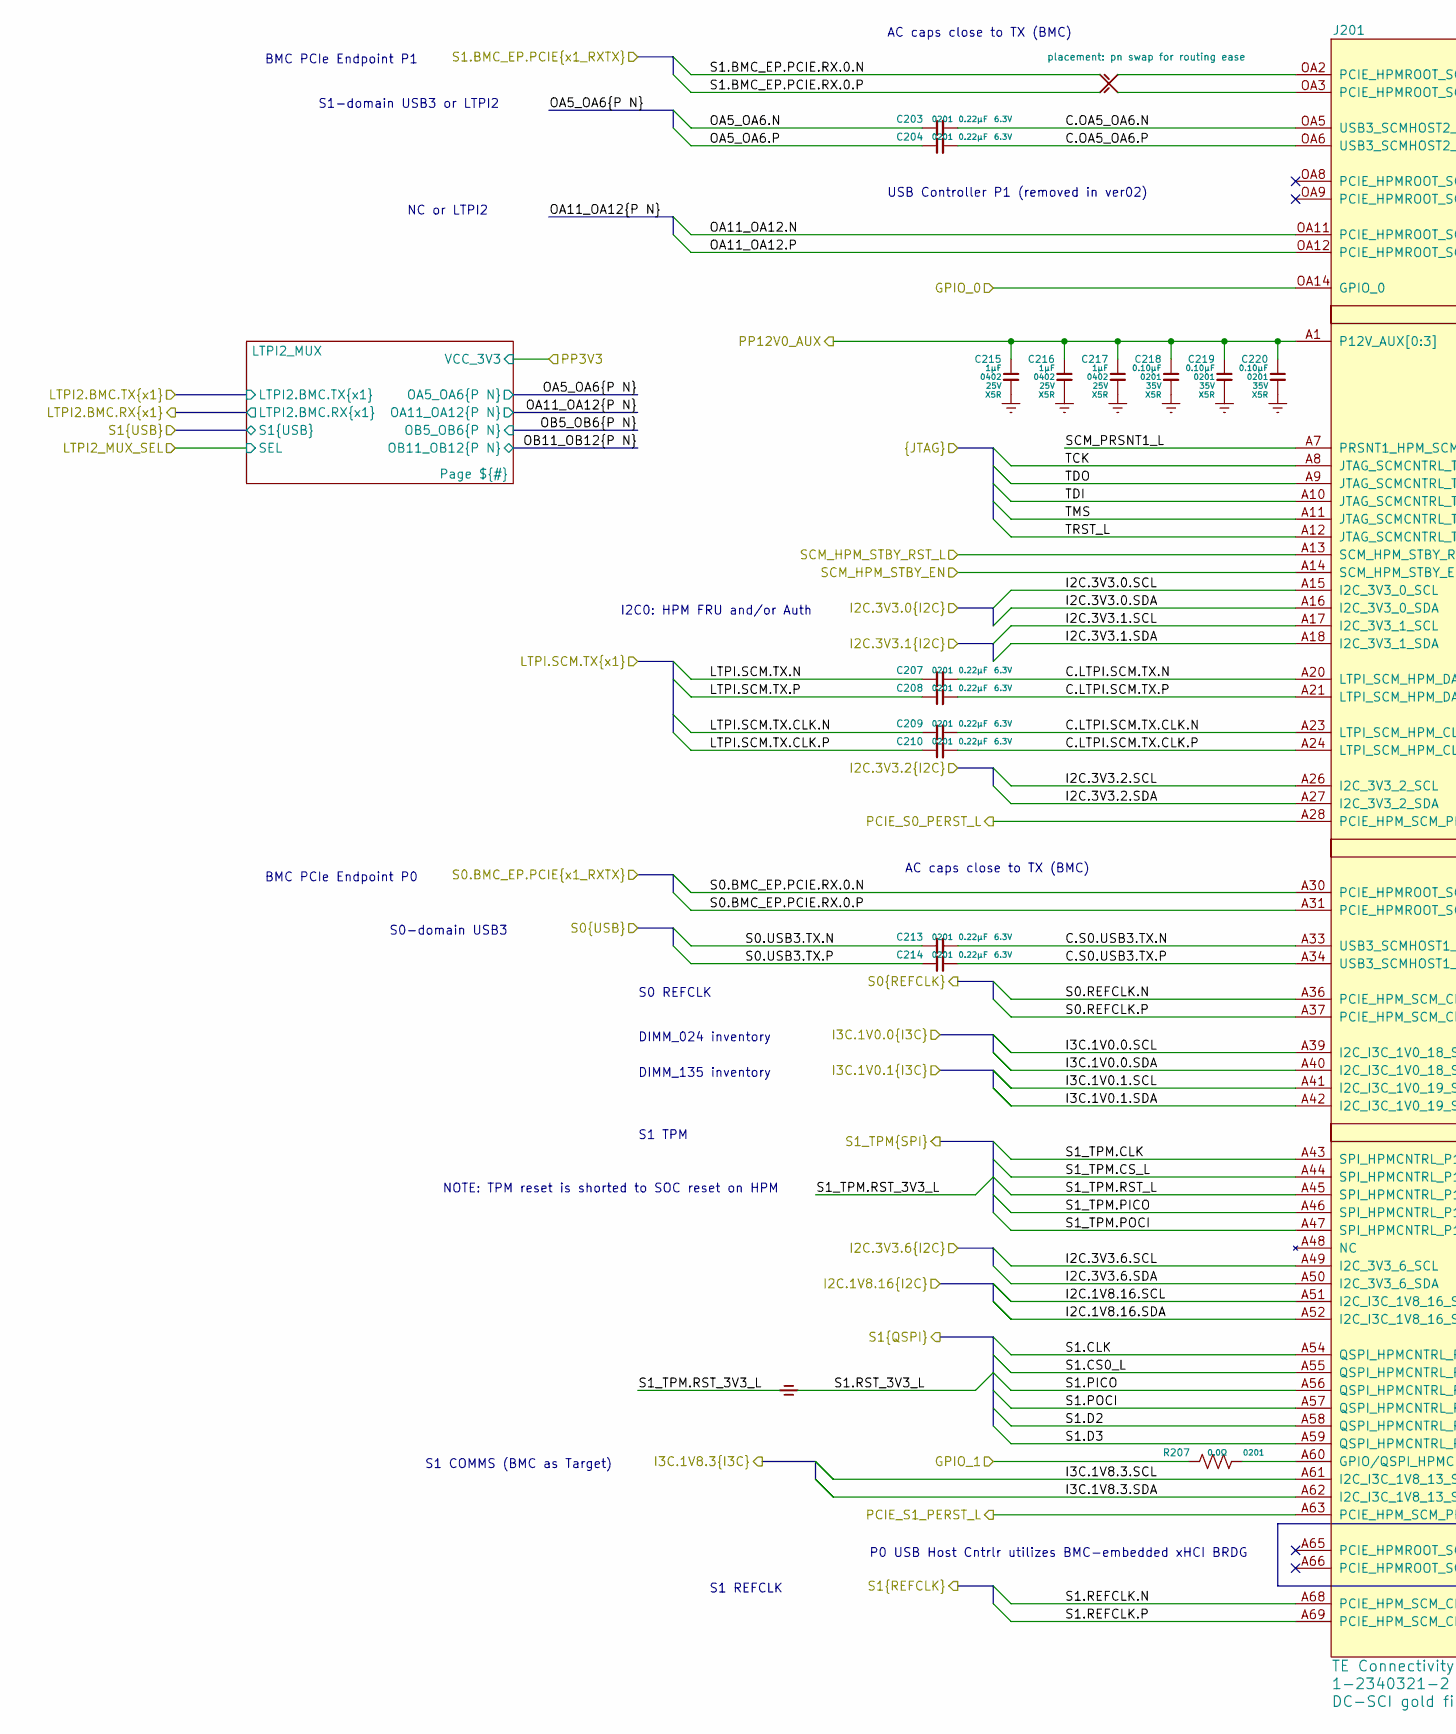
[picture p14: schematic dcsci_edge.kicad_sch, part in row 1, column 1]

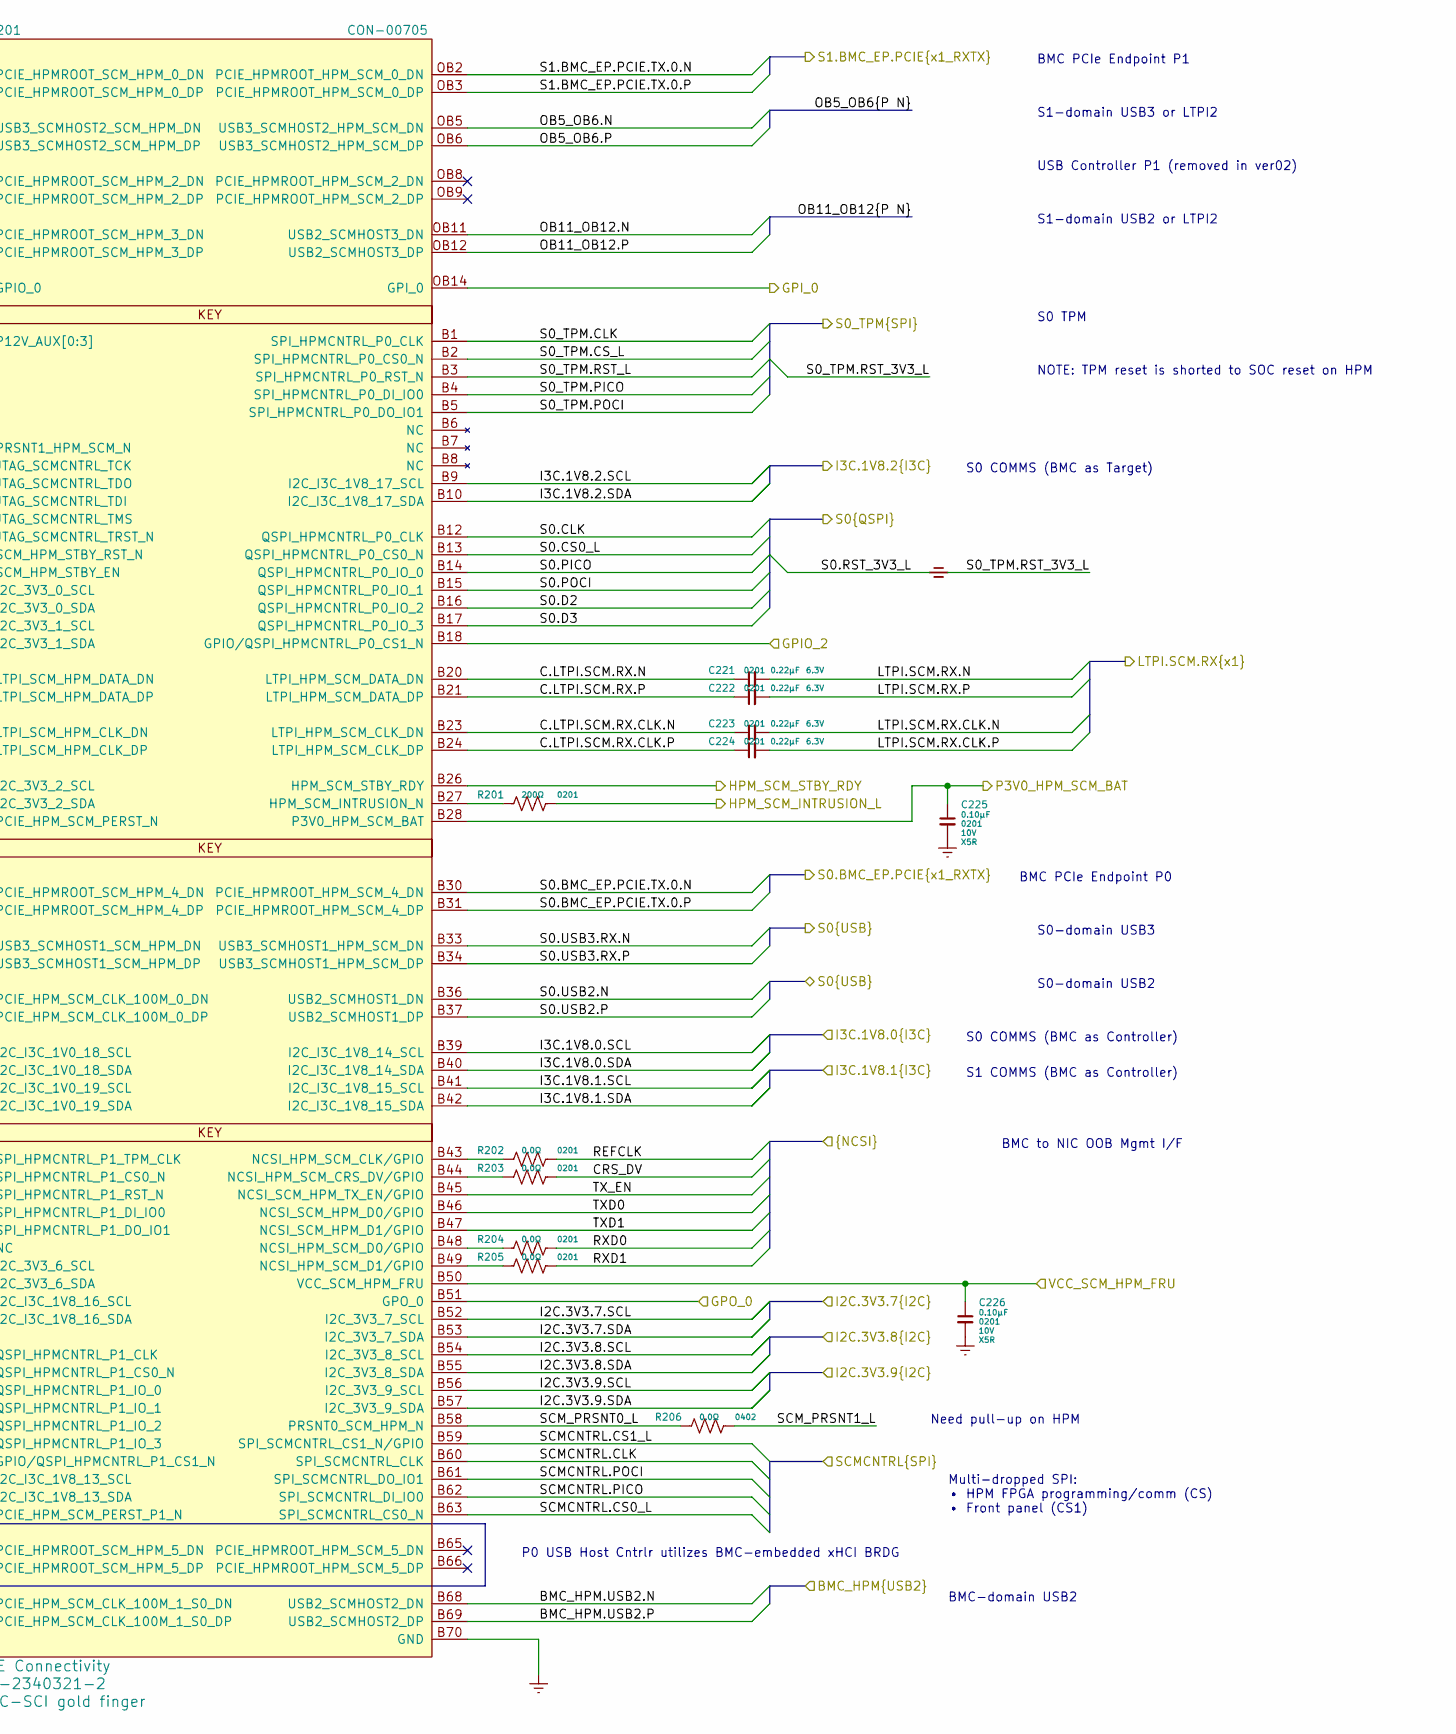
[picture p15: schematic dcsci_edge.kicad_sch, part in row 1, column 2]

Parts:
C203, C204, C207, C208, C209, C210, C213, C214, C221, C222, C223, C224: CCM-622AA; mpn GRM033R60J224ME15
C215, C216, C217: CCM-710BC; mpn GRM155R61E105KA12
C218, C219, C220: CCM-610AE; mpn GRM033R6YA104ME14
C225, C226: CCM-610AA; mpn GRM033R61A104ME15
J201: CON-00705; mpn 1-2340321-2
NT201, NT202: NET-10002
NT203: NET-20002
R201: RES-3200A
R202, R203, R204, R205, R207: RES-0000A
R206: RES-0000B

Connections:
BMC_HPM.USB2.N: J201.B68 (USB2_SCMHOST2_DN)
BMC_HPM.USB2.P: J201.B69 (USB2_SCMHOST2_DP)
C.LTPI.SCM.RX.CLK.N: C223.1, J201.B23 (LTPI_HPM_SCM_CLK_DN)
C.LTPI.SCM.RX.CLK.P: C224.1, J201.B24 (LTPI_HPM_SCM_CLK_DP)
C.LTPI.SCM.RX.N: C221.1, J201.B20 (LTPI_HPM_SCM_DATA_DN)
C.LTPI.SCM.RX.P: C222.1, J201.B21 (LTPI_HPM_SCM_DATA_DP)
C.LTPI.SCM.TX.CLK.N: C209.2, J201.A23 (LTPI_SCM_HPM_CLK_DN)
C.LTPI.SCM.TX.CLK.P: C210.2, J201.A24 (LTPI_SCM_HPM_CLK_DP)
C.LTPI.SCM.TX.N: C207.2, J201.A20 (LTPI_SCM_HPM_DATA_DN)
C.LTPI.SCM.TX.P: C208.2, J201.A21 (LTPI_SCM_HPM_DATA_DP)
C.OA5_OA6.N: C203.2, J201.OA5 (USB3_SCMHOST2_SCM_HPM_DN)
C.OA5_OA6.P: C204.2, J201.OA6 (USB3_SCMHOST2_SCM_HPM_DP)
C.S0.USB3.TX.N: C213.2, J201.A33 (USB3_SCMHOST1_SCM_HPM_DN)
C.S0.USB3.TX.P: C214.2, J201.A34 (USB3_SCMHOST1_SCM_HPM_DP)
CRS_DV: R203.2
GND: C215.2, C216.2, C217.2, C218.2, C219.2, C220.2, C225.2, C226.2, J201.A5 (GND), J201.A6 (GND), J201.A19 (GND), J201.A22 (GND), J201.A25 (GND), J201.A29 (GND), J201.A32 (GND), J201.A35 (GND), J201.A38 (GND), J201.A53 (GND), J201.A64 (GND), J201.A67 (GND), J201.A70 (GND), J201.B11 (GND), J201.B19 (GND), J201.B22 (GND), J201.B25 (GND), J201.B29 (GND), J201.B32 (GND), J201.B35 (GND), J201.B38 (GND), J201.B64 (GND), J201.B67 (GND), J201.B70 (GND), J201.OA1 (GND), J201.OA4 (GND), J201.OA7 (GND), J201.OA10 (GND), J201.OA13 (GND), J201.OB1 (GND), J201.OB4 (GND), J201.OB7 (GND), J201.OB10 (GND), J201.OB13 (GND)
GPIO_0: J201.OA14 (GPIO_0)
GPIO_1: R207.1
GPIO_2: J201.B18 (GPIO/QSPI_HPMCNTRL_P0_CS1_N)
GPI_0: J201.OB14 (GPI_0)
GPO_0: J201.B51 (GPO_0)
HPM_SCM_INTRUSION_L: R201.2
HPM_SCM_STBY_RDY: J201.B26 (HPM_SCM_STBY_RDY)
I2C.1V8.16.SCL: J201.A51 (I2C_I3C_1V8_16_SCL)
I2C.1V8.16.SDA: J201.A52 (I2C_I3C_1V8_16_SDA)
I2C.3V3.0.SCL: J201.A15 (I2C_3V3_0_SCL)
I2C.3V3.0.SDA: J201.A16 (I2C_3V3_0_SDA)
I2C.3V3.1.SCL: J201.A17 (I2C_3V3_1_SCL)
I2C.3V3.1.SDA: J201.A18 (I2C_3V3_1_SDA)
I2C.3V3.2.SCL: J201.A26 (I2C_3V3_2_SCL)
I2C.3V3.2.SDA: J201.A27 (I2C_3V3_2_SDA)
I2C.3V3.6.SCL: J201.A49 (I2C_3V3_6_SCL)
I2C.3V3.6.SDA: J201.A50 (I2C_3V3_6_SDA)
I2C.3V3.7.SCL: J201.B52 (I2C_3V3_7_SCL)
I2C.3V3.7.SDA: J201.B53 (I2C_3V3_7_SDA)
I2C.3V3.8.SCL: J201.B54 (I2C_3V3_8_SCL)
I2C.3V3.8.SDA: J201.B55 (I2C_3V3_8_SDA)
I2C.3V3.9.SCL: J201.B56 (I2C_3V3_9_SCL)
I2C.3V3.9.SDA: J201.B57 (I2C_3V3_9_SDA)
I3C.1V0.0.SCL: J201.A39 (I2C_I3C_1V0_18_SCL)
I3C.1V0.0.SDA: J201.A40 (I2C_I3C_1V0_18_SDA)
I3C.1V0.1.SCL: J201.A41 (I2C_I3C_1V0_19_SCL)
I3C.1V0.1.SDA: J201.A42 (I2C_I3C_1V0_19_SDA)
I3C.1V8.0.SCL: J201.B39 (I2C_I3C_1V8_14_SCL)
I3C.1V8.0.SDA: J201.B40 (I2C_I3C_1V8_14_SDA)
I3C.1V8.1.SCL: J201.B41 (I2C_I3C_1V8_15_SCL)
I3C.1V8.1.SDA: J201.B42 (I2C_I3C_1V8_15_SDA)
I3C.1V8.2.SCL: J201.B9 (I2C_I3C_1V8_17_SCL)
I3C.1V8.2.SDA: J201.B10 (I2C_I3C_1V8_17_SDA)
I3C.1V8.3.SCL: J201.A61 (I2C_I3C_1V8_13_SCL)
I3C.1V8.3.SDA: J201.A62 (I2C_I3C_1V8_13_SDA)
LTPI.SCM.RX.CLK.N: C223.2
LTPI.SCM.RX.CLK.P: C224.2
LTPI.SCM.RX.N: C221.2
LTPI.SCM.RX.P: C222.2
LTPI.SCM.TX.CLK.N: C209.1
LTPI.SCM.TX.CLK.P: C210.1
LTPI.SCM.TX.N: C207.1
LTPI.SCM.TX.P: C208.1
unnamed: J201.A60 (GPIO/QSPI_HPMCNTRL_P1_CS1_N), R207.2
unnamed: J201.B27 (HPM_SCM_INTRUSION_N), R201.1
unnamed: J201.B43 (NCSI_HPM_SCM_CLK/GPIO), R202.1
unnamed: J201.B44 (NCSI_HPM_SCM_CRS_DV/GPIO), R203.1
unnamed: J201.B48 (NCSI_HPM_SCM_D0/GPIO), R204.1
unnamed: J201.B49 (NCSI_HPM_SCM_D1/GPIO), R205.1
unnamed: J201.OA2 (PCIE_HPMROOT_SCM_HPM_0_DN), NT203.B4
unnamed: J201.OA3 (PCIE_HPMROOT_SCM_HPM_0_DP), NT203.B3
OA5_OA6.N: C203.1
OA5_OA6.P: C204.1
OA11_OA12.N: J201.OA11 (PCIE_HPMROOT_SCM_HPM_3_DN)
OA11_OA12.P: J201.OA12 (PCIE_HPMROOT_SCM_HPM_3_DP)
OB5_OB6.N: J201.OB5 (USB3_SCMHOST2_HPM_SCM_DN)
OB5_OB6.P: J201.OB6 (USB3_SCMHOST2_HPM_SCM_DP)
OB11_OB12.N: J201.OB11 (USB2_SCMHOST3_DN)
OB11_OB12.P: J201.OB12 (USB2_SCMHOST3_DP)
P3V0_HPM_SCM_BAT: C225.1, J201.B28 (P3V0_HPM_SCM_BAT)
PCIE_S0_PERST_L: J201.A28 (PCIE_HPM_SCM_PERST_N)
PCIE_S1_PERST_L: J201.A63 (PCIE_HPM_SCM_PERST_P1_N)
PP12V0_AUX: C215.1, C216.1, C217.1, C218.1, C219.1, C220.1, J201.A1 (P12V_AUX[0:3]), J201.A2 (P12V_AUX[0:3]), J201.A3 (P12V_AUX[0:3]), J201.A4 (P12V_AUX[0:3])
REFCLK: R202.2
RXD0: R204.2
RXD1: R205.2
S0.BMC_EP.PCIE.RX.0.N: J201.A30 (PCIE_HPMROOT_SCM_HPM_4_DN)
S0.BMC_EP.PCIE.RX.0.P: J201.A31 (PCIE_HPMROOT_SCM_HPM_4_DP)
S0.BMC_EP.PCIE.TX.0.N: J201.B30 (PCIE_HPMROOT_HPM_SCM_4_DN)
S0.BMC_EP.PCIE.TX.0.P: J201.B31 (PCIE_HPMROOT_HPM_SCM_4_DP)
S0.CLK: J201.B12 (QSPI_HPMCNTRL_P0_CLK)
S0.CS0_L: J201.B13 (QSPI_HPMCNTRL_P0_CS0_N)
S0.D2: J201.B16 (QSPI_HPMCNTRL_P0_IO_2)
S0.D3: J201.B17 (QSPI_HPMCNTRL_P0_IO_3)
S0.PICO: J201.B14 (QSPI_HPMCNTRL_P0_IO_0)
S0.POCI: J201.B15 (QSPI_HPMCNTRL_P0_IO_1)
S0.REFCLK.N: J201.A36 (PCIE_HPM_SCM_CLK_100M_0_DN)
S0.REFCLK.P: J201.A37 (PCIE_HPM_SCM_CLK_100M_0_DP)
S0.RST_3V3_L: NT202.1
S0.USB2.N: J201.B36 (USB2_SCMHOST1_DN)
S0.USB2.P: J201.B37 (USB2_SCMHOST1_DP)
S0.USB3.RX.N: J201.B33 (USB3_SCMHOST1_HPM_SCM_DN)
S0.USB3.RX.P: J201.B34 (USB3_SCMHOST1_HPM_SCM_DP)
S0.USB3.TX.N: C213.1
S0.USB3.TX.P: C214.1
S0_TPM.CLK: J201.B1 (SPI_HPMCNTRL_P0_CLK)
S0_TPM.CS_L: J201.B2 (SPI_HPMCNTRL_P0_CS0_N)
S0_TPM.PICO: J201.B4 (SPI_HPMCNTRL_P0_DI_IO0)
S0_TPM.POCI: J201.B5 (SPI_HPMCNTRL_P0_DO_IO1)
S0_TPM.RST_3V3_L: NT202.2
S0_TPM.RST_L: J201.B3 (SPI_HPMCNTRL_P0_RST_N)
S1.BMC_EP.PCIE.RX.0.N: NT203.A3
S1.BMC_EP.PCIE.RX.0.P: NT203.A4
S1.BMC_EP.PCIE.TX.0.N: J201.OB2 (PCIE_HPMROOT_HPM_SCM_0_DN)
S1.BMC_EP.PCIE.TX.0.P: J201.OB3 (PCIE_HPMROOT_HPM_SCM_0_DP)
S1.CLK: J201.A54 (QSPI_HPMCNTRL_P1_CLK)
S1.CS0_L: J201.A55 (QSPI_HPMCNTRL_P1_CS0_N)
S1.D2: J201.A58 (QSPI_HPMCNTRL_P1_IO_2)
S1.D3: J201.A59 (QSPI_HPMCNTRL_P1_IO_3)
S1.PICO: J201.A56 (QSPI_HPMCNTRL_P1_IO_0)
S1.POCI: J201.A57 (QSPI_HPMCNTRL_P1_IO_1)
S1.REFCLK.N: J201.A68 (PCIE_HPM_SCM_CLK_100M_1_S0_DN)
S1.REFCLK.P: J201.A69 (PCIE_HPM_SCM_CLK_100M_1_S0_DP)
S1.RST_3V3_L: NT201.2
S1_TPM.CLK: J201.A43 (SPI_HPMCNTRL_P1_TPM_CLK)
S1_TPM.CS_L: J201.A44 (SPI_HPMCNTRL_P1_CS0_N)
S1_TPM.PICO: J201.A46 (SPI_HPMCNTRL_P1_DI_IO0)
S1_TPM.POCI: J201.A47 (SPI_HPMCNTRL_P1_DO_IO1)
S1_TPM.RST_3V3_L: NT201.1
S1_TPM.RST_L: J201.A45 (SPI_HPMCNTRL_P1_RST_N)
SCMCNTRL.CLK: J201.B60 (SPI_SCMCNTRL_CLK)
SCMCNTRL.CS0_L: J201.B63 (SPI_SCMCNTRL_CS0_N)
SCMCNTRL.CS1_L: J201.B59 (SPI_SCMCNTRL_CS1_N/GPIO)
SCMCNTRL.PICO: J201.B62 (SPI_SCMCNTRL_DI_IO0)
SCMCNTRL.POCI: J201.B61 (SPI_SCMCNTRL_DO_IO1)
SCM_HPM_STBY_EN: J201.A14 (SCM_HPM_STBY_EN)
SCM_HPM_STBY_RST_L: J201.A13 (SCM_HPM_STBY_RST_N)
SCM_PRSNT0_L: J201.B58 (PRSNT0_SCM_HPM_N), R206.1
SCM_PRSNT1_L: J201.A7 (PRSNT1_HPM_SCM_N), R206.2
TCK: J201.A8 (JTAG_SCMCNTRL_TCK)
TDI: J201.A10 (JTAG_SCMCNTRL_TDI)
TDO: J201.A9 (JTAG_SCMCNTRL_TDO)
TMS: J201.A11 (JTAG_SCMCNTRL_TMS)
TRST_L: J201.A12 (JTAG_SCMCNTRL_TRST_N)
TXD0: J201.B46 (NCSI_SCM_HPM_D0/GPIO)
TXD1: J201.B47 (NCSI_SCM_HPM_D1/GPIO)
TX_EN: J201.B45 (NCSI_SCM_HPM_TX_EN/GPIO)
VCC_SCM_HPM_FRU: C226.1, J201.B50 (VCC_SCM_HPM_FRU)

Notes on the sheet:
S0-domain USB2
S1 REFCLK
S1 TPM
NOTE: TPM reset is shorted to SOC reset on HPM
S1 COMMS (BMC as Target)
BMC-domain USB2
S0 REFCLK
Multi-dropped SPI: • HPM FPGA programming/comm (CS) • Front panel (CS1)
USB Controller P1 (removed in ver02)
S1-domain USB2 or LTPI2
P0 USB Host Cntrlr utilizes BMC-embedded xHCI BRDG
BMC PCIe Endpoint P0
AC caps close to TX (BMC)
S0 COMMS (BMC as Target)
DIMM_024 inventory
S1-domain USB3 or LTPI2
BMC PCIe Endpoint P1
S0 COMMS (BMC as Controller)
S0-domain USB3
BMC to NIC OOB Mgmt I/F
DIMM_135 inventory
I2C0: HPM FRU and/or Auth
S0 TPM
S1 COMMS (BMC as Controller)
NC or LTPI2
Need pull-up on HPM
