rivosinc/scampi/sch/ddr4.kicad_sch

## KiCad design sch/ddr4.kicad_sch (2025-05-27)

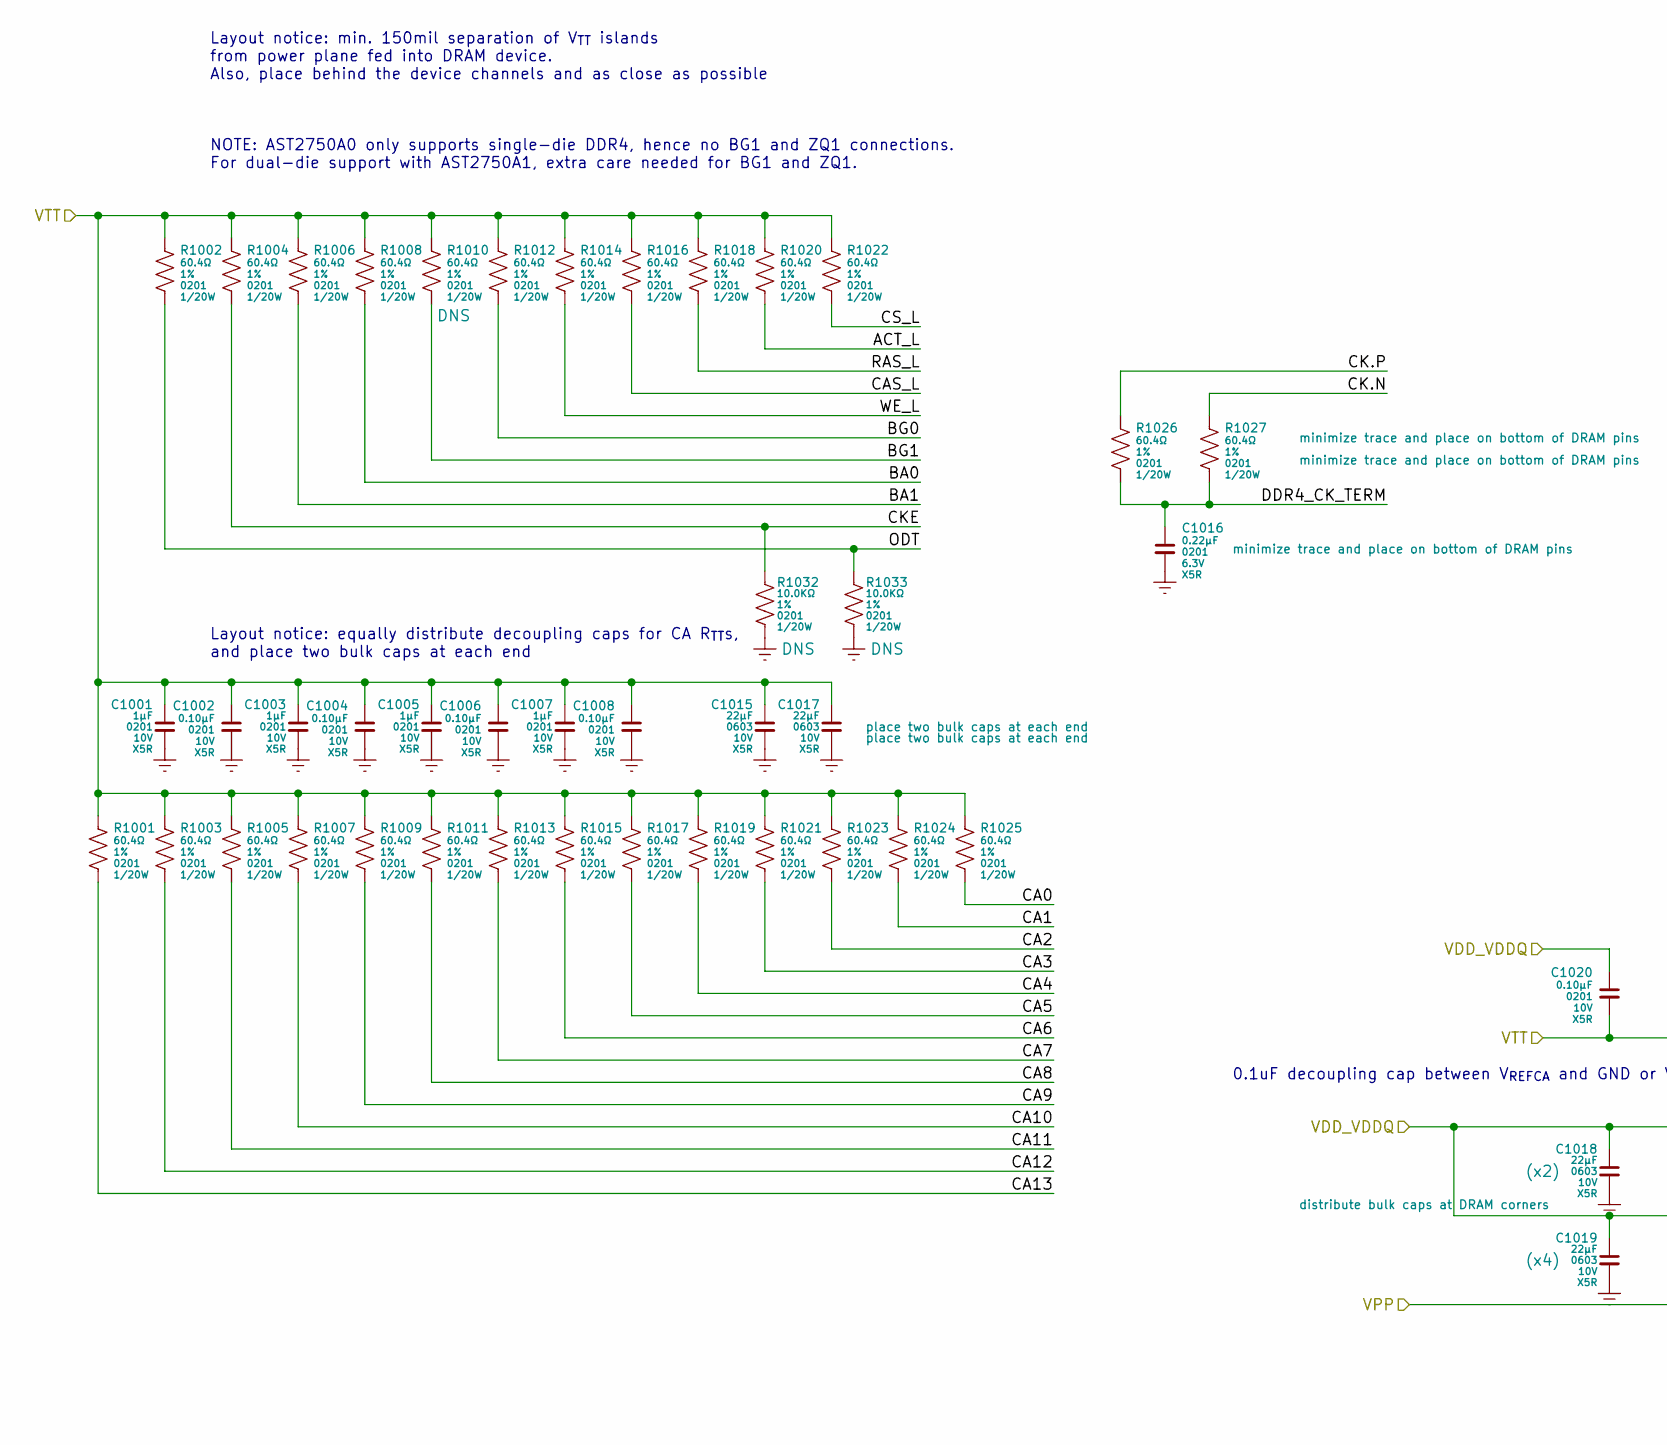
[picture p16: schematic ddr4.kicad_sch, part in row 1, column 1]

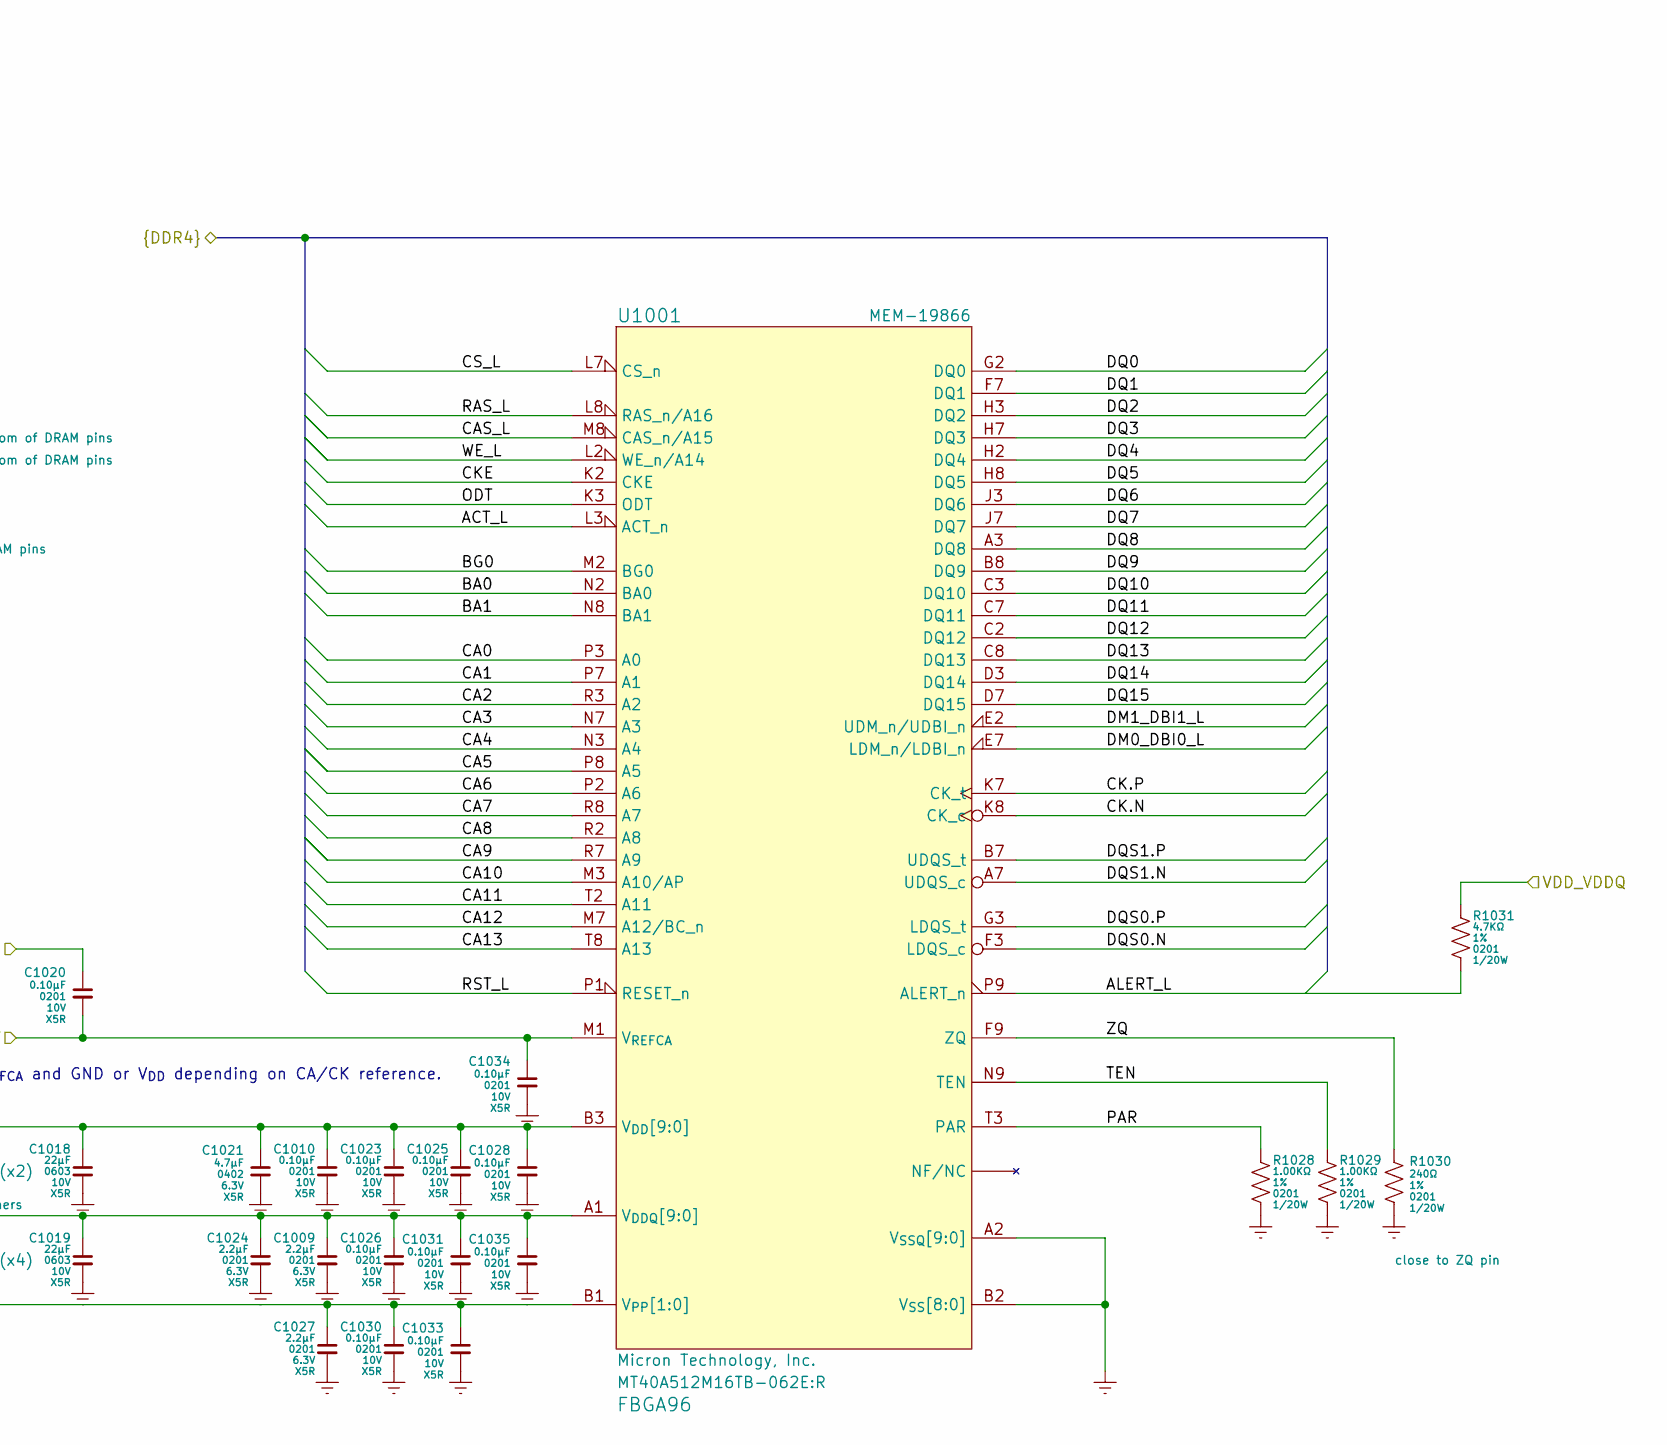
[picture p17: schematic ddr4.kicad_sch, part in row 1, column 2]

Parts:
C1001, C1003, C1005, C1007: CCM-710AD; mpn GRM033R61A105ME15
C1002, C1004, C1006, C1008, C1010, C1020, C1023, C1025, C1026, C1028, C1030, C1031, C1033, C1034, C1035: CCM-610AA; mpn GRM033R61A104ME15
C1009, C1024, C1027: CCM-722AA; mpn GRM033R60J225ME01
C1015, C1017, C1018, C1019: CCM-822CC; mpn GRM188R61A226ME15
C1016: CCM-622AA; mpn GRM033R60J224ME15
C1021: CCM-747BC; mpn GRM155R60J475ME47
R1001, R1002, R1003, R1004, R1005, R1006, R1007, R1008, R1009, R1010, R1011, R1012, R1013, R1014, R1015, R1016, R1017, R1018, R1019, R1020, R1021, R1022, R1023, R1024, R1025, R1026, R1027: RES-2604A
R1028, R1029: RES-4100A
R1030: RES-3240A
R1031: RES-4470A
R1032, R1033: RES-5100A
U1001: MEM-19866; mpn MT40A512M16TB-062E:R

Connections:
ACT_L: R1020.2, U1001.L3 (ACT_n)
ALERT_L: R1031.2, U1001.P9 (ALERT_n)
BA0: R1008.2, U1001.N2 (BA0)
BA1: R1006.2, U1001.N8 (BA1)
BG0: R1012.2, U1001.M2 (BG0)
BG1: R1010.2
CA0: R1025.2, U1001.P3 (A0)
CA1: R1024.2, U1001.P7 (A1)
CA2: R1023.2, U1001.R3 (A2)
CA3: R1021.2, U1001.N7 (A3)
CA4: R1019.2, U1001.N3 (A4)
CA5: R1017.2, U1001.P8 (A5)
CA6: R1015.2, U1001.P2 (A6)
CA7: R1013.2, U1001.R8 (A7)
CA8: R1011.2, U1001.R2 (A8)
CA9: R1009.2, U1001.R7 (A9)
CA10: R1007.2, U1001.M3 (A10/AP)
CA11: R1005.2, U1001.T2 (A11)
CA12: R1003.2, U1001.M7 (A12/BC_n)
CA13: R1001.2, U1001.T8 (A13)
CAS_L: R1016.2, U1001.M8 (CAS_n/A15)
CK.N: R1027.1, U1001.K8 (CK_c)
CK.P: R1026.1, U1001.K7 (CK_t)
CKE: R1004.2, R1032.1, U1001.K2 (CKE)
CS_L: R1022.2, U1001.L7 (CS_n)
DDR4_CK_TERM: C1016.1, R1026.2, R1027.2
DM0_DBI0_L: U1001.E7 (LDM_n/LDBI_n)
DM1_DBI1_L: U1001.E2 (UDM_n/UDBI_n)
DQ0: U1001.G2 (DQ0)
DQ1: U1001.F7 (DQ1)
DQ2: U1001.H3 (DQ2)
DQ3: U1001.H7 (DQ3)
DQ4: U1001.H2 (DQ4)
DQ5: U1001.H8 (DQ5)
DQ6: U1001.J3 (DQ6)
DQ7: U1001.J7 (DQ7)
DQ8: U1001.A3 (DQ8)
DQ9: U1001.B8 (DQ9)
DQ10: U1001.C3 (DQ10)
DQ11: U1001.C7 (DQ11)
DQ12: U1001.C2 (DQ12)
DQ13: U1001.C8 (DQ13)
DQ14: U1001.D3 (DQ14)
DQ15: U1001.D7 (DQ15)
DQS0.N: U1001.F3 (LDQS_c)
DQS0.P: U1001.G3 (LDQS_t)
DQS1.N: U1001.A7 (UDQS_c)
DQS1.P: U1001.B7 (UDQS_t)
GND: C1001.2, C1002.2, C1003.2, C1004.2, C1005.2, C1006.2, C1007.2, C1008.2, C1009.2, C1010.2, C1015.2, C1016.2, C1017.2, C1018.2, C1019.2, C1021.2, C1023.2, C1024.2, C1025.2, C1026.2, C1027.2, C1028.2, C1030.2, C1031.2, C1033.2, C1034.2, C1035.2, R1028.2, R1029.2, R1030.2, R1032.2, R1033.2, U1001.A2 (V_{SSQ}[9:0]), U1001.A8 (V_{SSQ}[9:0]), U1001.B2 (V_{SS}[8:0]), U1001.C9 (V_{SSQ}[9:0]), U1001.D2 (V_{SSQ}[9:0]), U1001.D8 (V_{SSQ}[9:0]), U1001.E1 (V_{SS}[8:0]), U1001.E3 (V_{SSQ}[9:0]), U1001.E8 (V_{SSQ}[9:0]), U1001.E9 (V_{SS}[8:0]), U1001.F1 (V_{SSQ}[9:0]), U1001.G8 (V_{SS}[8:0]), U1001.H1 (V_{SSQ}[9:0]), U1001.H9 (V_{SSQ}[9:0]), U1001.K1 (V_{SS}[8:0]), U1001.K9 (V_{SS}[8:0]), U1001.M9 (V_{SS}[8:0]), U1001.N1 (V_{SS}[8:0]), U1001.T1 (V_{SS}[8:0])
ODT: R1002.2, R1033.1, U1001.K3 (ODT)
PAR: R1028.1, U1001.T3 (PAR)
RAS_L: R1018.2, U1001.L8 (RAS_n/A16)
RST_L: U1001.P1 (RESET_n)
TEN: R1029.1, U1001.N9 (TEN)
VDD_VDDQ: C1009.1, C1010.1, C1018.1, C1019.1, C1020.1, C1021.1, C1023.1, C1024.1, C1025.1, C1026.1, C1028.1, C1031.1, C1035.1, R1031.1, U1001.A1 (V_{DDQ}[9:0]), U1001.A9 (V_{DDQ}[9:0]), U1001.B3 (V_{DD}[9:0]), U1001.B9 (V_{DD}[9:0]), U1001.C1 (V_{DDQ}[9:0]), U1001.D1 (V_{DD}[9:0]), U1001.D9 (V_{DDQ}[9:0]), U1001.F2 (V_{DDQ}[9:0]), U1001.F8 (V_{DDQ}[9:0]), U1001.G1 (V_{DDQ}[9:0]), U1001.G7 (V_{DD}[9:0]), U1001.G9 (V_{DDQ}[9:0]), U1001.J1 (V_{DD}[9:0]), U1001.J2 (V_{DDQ}[9:0]), U1001.J8 (V_{DDQ}[9:0]), U1001.J9 (V_{DD}[9:0]), U1001.L1 (V_{DD}[9:0]), U1001.L9 (V_{DD}[9:0]), U1001.R1 (V_{DD}[9:0]), U1001.T9 (V_{DD}[9:0])
VPP: C1027.1, C1030.1, C1033.1, U1001.B1 (V_{PP}[1:0]), U1001.R9 (V_{PP}[1:0])
VTT: C1001.1, C1002.1, C1003.1, C1004.1, C1005.1, C1006.1, C1007.1, C1008.1, C1015.1, C1017.1, C1020.2, C1034.1, R1001.1, R1002.1, R1003.1, R1004.1, R1005.1, R1006.1, R1007.1, R1008.1, R1009.1, R1010.1, R1011.1, R1012.1, R1013.1, R1014.1, R1015.1, R1016.1, R1017.1, R1018.1, R1019.1, R1020.1, R1021.1, R1022.1, R1023.1, R1024.1, R1025.1, U1001.M1 (V_{REFCA})
WE_L: R1014.2, U1001.L2 (WE_n/A14)
ZQ: R1030.1, U1001.F9 (ZQ)

Notes on the sheet:
NOTE: AST2750A0 only supports single-die DDR4, hence no BG1 and ZQ1 connections. For dual-die support with AST2750A1, extra care needed for BG1 and ZQ1.
0.1uF decoupling cap between V_{REFCA} and GND or V_{DD} depending on CA/CK reference.
Layout notice: equally distribute decoupling caps for CA R_{TT}s, and place two bulk caps at each end
Layout notice: min. 150mil separation of V_{TT} islands from power plane fed into DRAM device. Also, place behind the device channels and as close as possible
