rivosinc/scampi/sch/dev_header.kicad_sch

## KiCad design sch/dev_header.kicad_sch (2025-05-27)

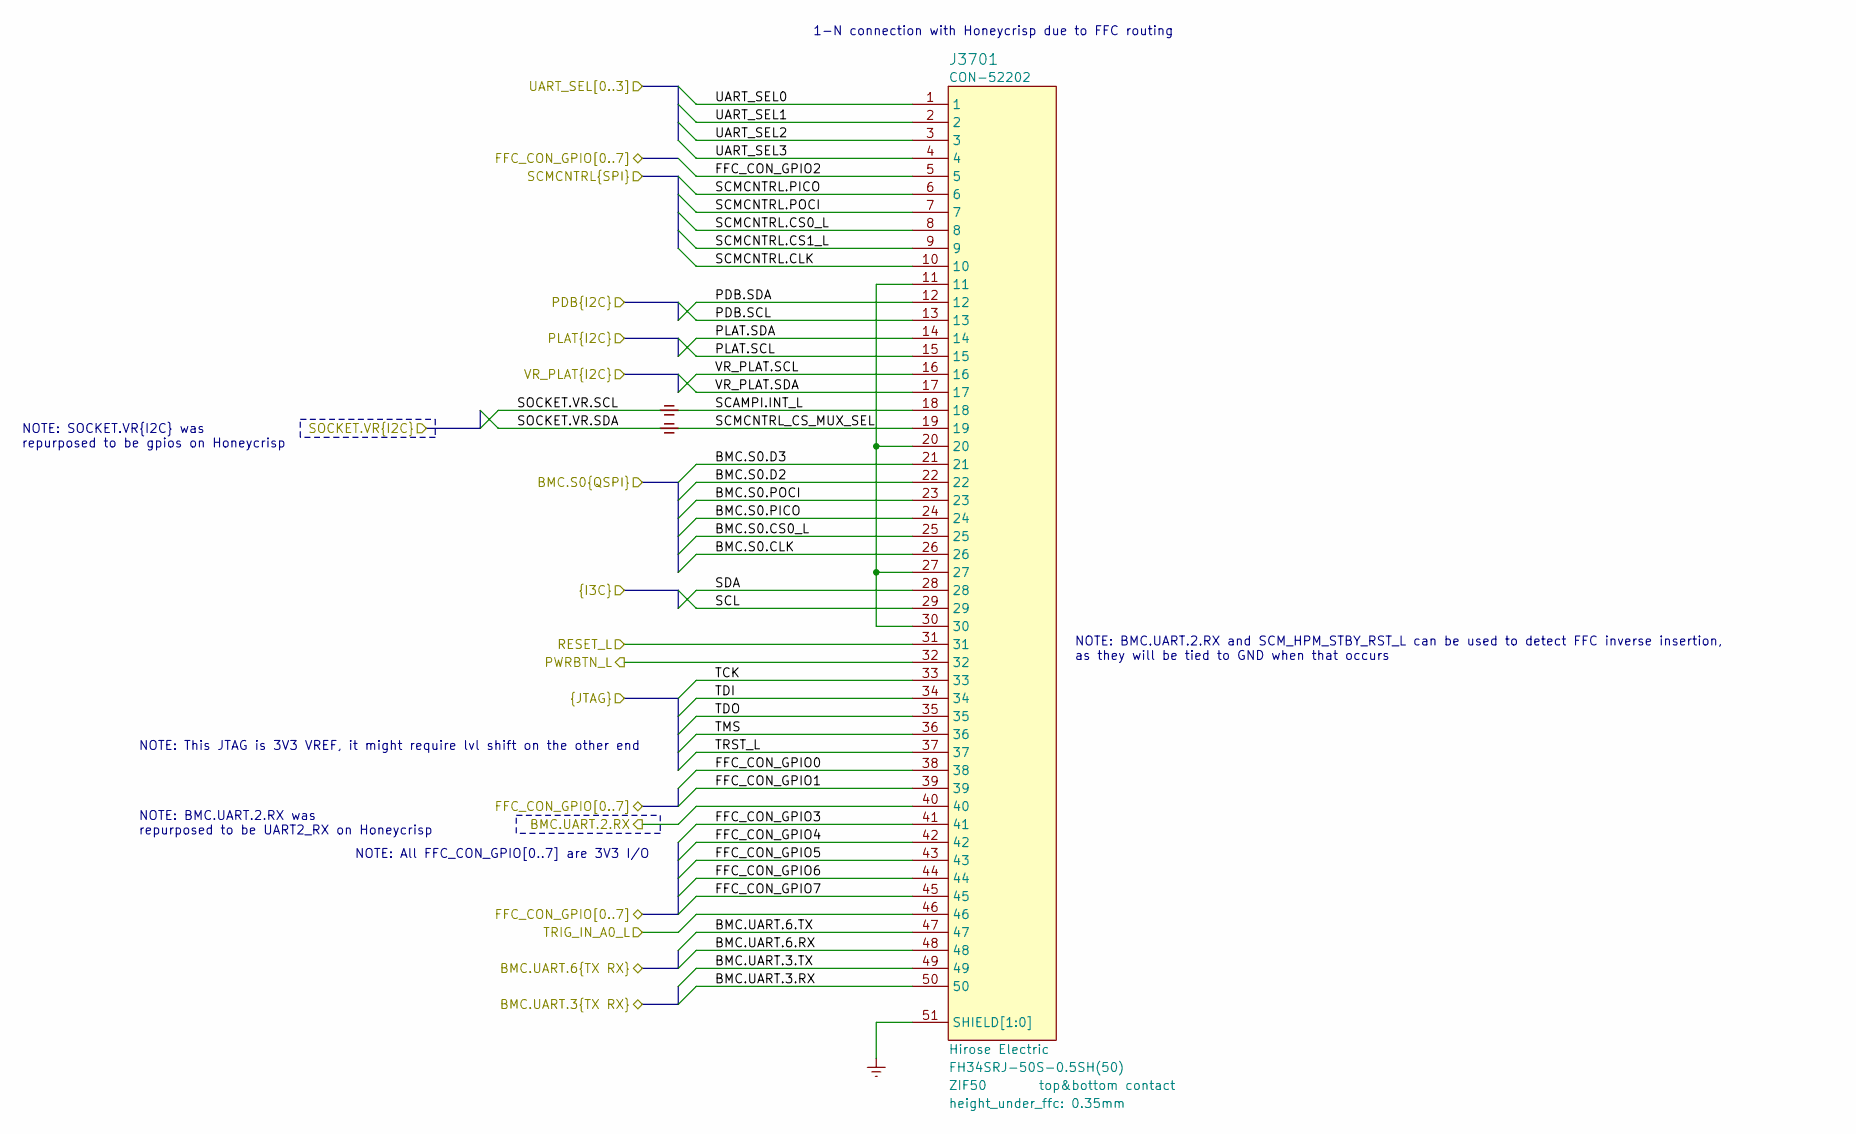
[picture p18: schematic dev_header.kicad_sch]

Parts:
J3701: CON-52202; mpn FH34SRJ-50S-0.5SH(50)
NT3701, NT3702: NET-10002

Connections:
BMC.S0.CLK: J3701.26
BMC.S0.CS0_L: J3701.25
BMC.S0.D2: J3701.22
BMC.S0.D3: J3701.21
BMC.S0.PICO: J3701.24
BMC.S0.POCI: J3701.23
BMC.UART.2.RX: J3701.40
BMC.UART.3.RX: J3701.50
BMC.UART.3.TX: J3701.49
BMC.UART.6.RX: J3701.48
BMC.UART.6.TX: J3701.47
FFC_CON_GPIO0: J3701.38
FFC_CON_GPIO1: J3701.39
FFC_CON_GPIO2: J3701.5
FFC_CON_GPIO3: J3701.41
FFC_CON_GPIO4: J3701.42
FFC_CON_GPIO5: J3701.43
FFC_CON_GPIO6: J3701.44
FFC_CON_GPIO7: J3701.45
GND: J3701.51 (SHIELD[1:0]), J3701.52 (SHIELD[1:0])
unnamed: J3701.11, J3701.20, J3701.27, J3701.30
PDB.SCL: J3701.13
PDB.SDA: J3701.12
PLAT.SCL: J3701.15
PLAT.SDA: J3701.14
PWRBTN_L: J3701.32
RESET_L: J3701.31
SCAMPI.INT_L: J3701.18, NT3701.2
SCL: J3701.29
SCMCNTRL.CLK: J3701.10
SCMCNTRL.CS0_L: J3701.8
SCMCNTRL.CS1_L: J3701.9
SCMCNTRL.PICO: J3701.6
SCMCNTRL.POCI: J3701.7
SCMCNTRL_CS_MUX_SEL: J3701.19, NT3702.2
SDA: J3701.28
SOCKET.VR.SCL: NT3701.1
SOCKET.VR.SDA: NT3702.1
TCK: J3701.33
TDI: J3701.34
TDO: J3701.35
TMS: J3701.36
TRIG_IN_A0_L: J3701.46
TRST_L: J3701.37
UART_SEL0: J3701.1
UART_SEL1: J3701.2
UART_SEL2: J3701.3
UART_SEL3: J3701.4
VR_PLAT.SCL: J3701.16
VR_PLAT.SDA: J3701.17

Notes on the sheet:
NOTE: BMC.UART.2.RX and SCM_HPM_STBY_RST_L can be used to detect FFC inverse insertion, as they will be tied to GND when that occurs
1-N connection with Honeycrisp due to FFC routing
NOTE: BMC.UART.2.RX was repurposed to be UART2_RX on Honeycrisp
NOTE: All FFC_CON_GPIO[0..7] are 3V3 I/O
NOTE: SOCKET.VR{I2C} was repurposed to be gpios on Honeycrisp
NOTE: This JTAG is 3V3 VREF, it might require lvl shift on the other end
