rivosinc/scampi/sch/dp.kicad_sch

## KiCad design sch/dp.kicad_sch (2025-05-27)

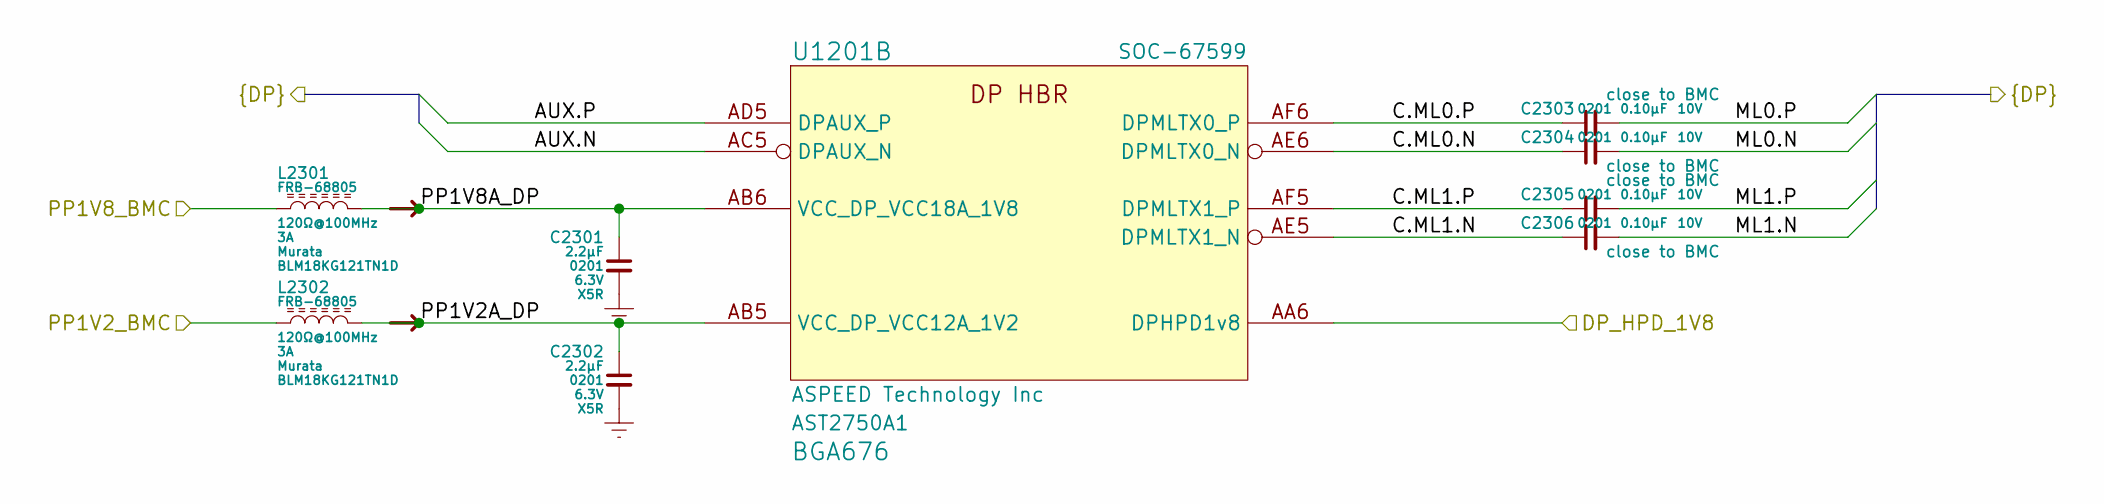
[picture p19: schematic dp.kicad_sch]

Parts:
C2301, C2302: CCM-722AA; mpn GRM033R60J225ME01
C2303, C2304, C2305, C2306: CCM-610AA; mpn GRM033R61A104ME15
L2301, L2302: FRB-68805; mpn BLM18KG121TN1D
U1201: SOC-67599; mpn AST2750A1

Connections:
AUX.N: U1201.AC5 (DPAUX_N)
AUX.P: U1201.AD5 (DPAUX_P)
C.ML0.N: C2304.1, U1201.AE6 (DPMLTX0_N)
C.ML0.P: C2303.1, U1201.AF6 (DPMLTX0_P)
C.ML1.N: C2306.1, U1201.AE5 (DPMLTX1_N)
C.ML1.P: C2305.1, U1201.AF5 (DPMLTX1_P)
DP_HPD_1V8: U1201.AA6 (DPHPD1v8)
GND: C2301.2, C2302.2
ML0.N: C2304.2
ML0.P: C2303.2
ML1.N: C2306.2
ML1.P: C2305.2
PP1V2A_DP: C2302.1, L2302.2, U1201.AB5 (VCC_DP_VCC12A_1V2)
PP1V2_BMC: L2302.1
PP1V8A_DP: C2301.1, L2301.2, U1201.AB6 (VCC_DP_VCC18A_1V8)
PP1V8_BMC: L2301.1
