rivosinc/scampi/sch/emmc.kicad_sch

## KiCad design sch/emmc.kicad_sch (2025-05-27)

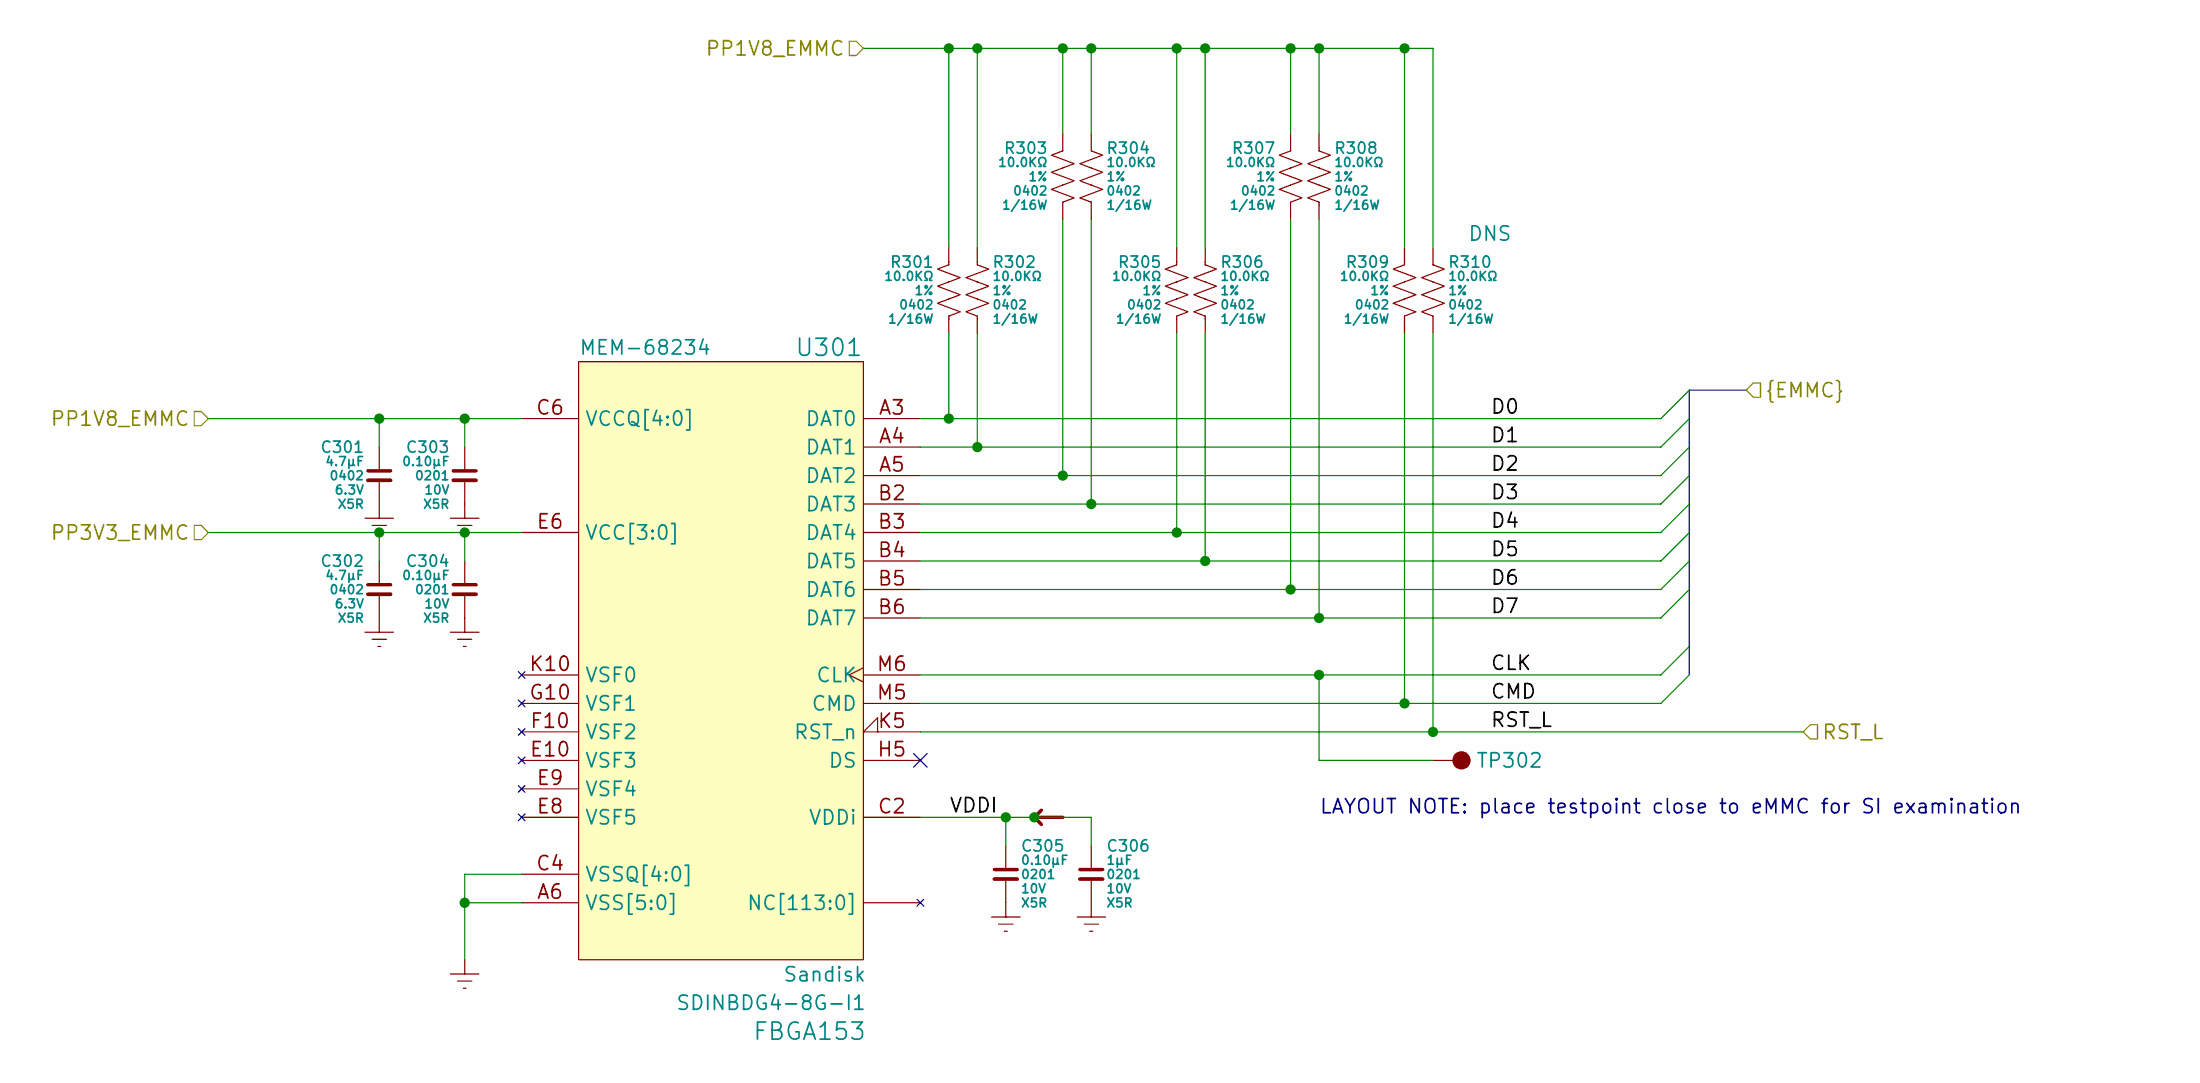
[picture p20: schematic emmc.kicad_sch]

Parts:
C301, C302: CCM-747BC; mpn GRM155R60J475ME47
C303, C304, C305: CCM-610AA; mpn GRM033R61A104ME15
C306: CCM-710AD; mpn GRM033R61A105ME15
R301, R302, R303, R304, R305, R306, R307, R308, R309, R310: RES-5100B
TP302: TST-01025
U301: MEM-68234; mpn SDINBDG4-8G-I1

Connections:
CLK: TP302.1, U301.M6 (CLK)
CMD: R309.2, U301.M5 (CMD)
D0: R301.2, U301.A3 (DAT0)
D1: R302.2, U301.A4 (DAT1)
D2: R303.2, U301.A5 (DAT2)
D3: R304.2, U301.B2 (DAT3)
D4: R305.2, U301.B3 (DAT4)
D5: R306.2, U301.B4 (DAT5)
D6: R307.2, U301.B5 (DAT6)
D7: R308.2, U301.B6 (DAT7)
GND: C301.2, C302.2, C303.2, C304.2, C305.2, C306.2, U301.A6 (VSS[5:0]), U301.C4 (VSSQ[4:0]), U301.E7 (VSS[5:0]), U301.G5 (VSS[5:0]), U301.H10 (VSS[5:0]), U301.J5 (VSS[5:0]), U301.K8 (VSS[5:0]), U301.N2 (VSSQ[4:0]), U301.N5 (VSSQ[4:0]), U301.P4 (VSSQ[4:0]), U301.P6 (VSSQ[4:0])
PP1V8_EMMC: C301.1, C303.1, R301.1, R302.1, R303.1, R304.1, R305.1, R306.1, R307.1, R308.1, R309.1, R310.1, U301.C6 (VCCQ[4:0]), U301.M4 (VCCQ[4:0]), U301.N4 (VCCQ[4:0]), U301.P3 (VCCQ[4:0]), U301.P5 (VCCQ[4:0])
PP3V3_EMMC: C302.1, C304.1, U301.E6 (VCC[3:0]), U301.F5 (VCC[3:0]), U301.J10 (VCC[3:0]), U301.K9 (VCC[3:0])
RST_L: R310.2, U301.K5 (RST_n)
VDDI: C305.1, C306.1, U301.C2 (VDDi)

Notes on the sheet:
LAYOUT NOTE: place testpoint close to eMMC for SI examination
