rivosinc/scampi/sch/emmc_jtag_ltpi.kicad_sch

## KiCad design sch/emmc_jtag_ltpi.kicad_sch (2025-05-27)

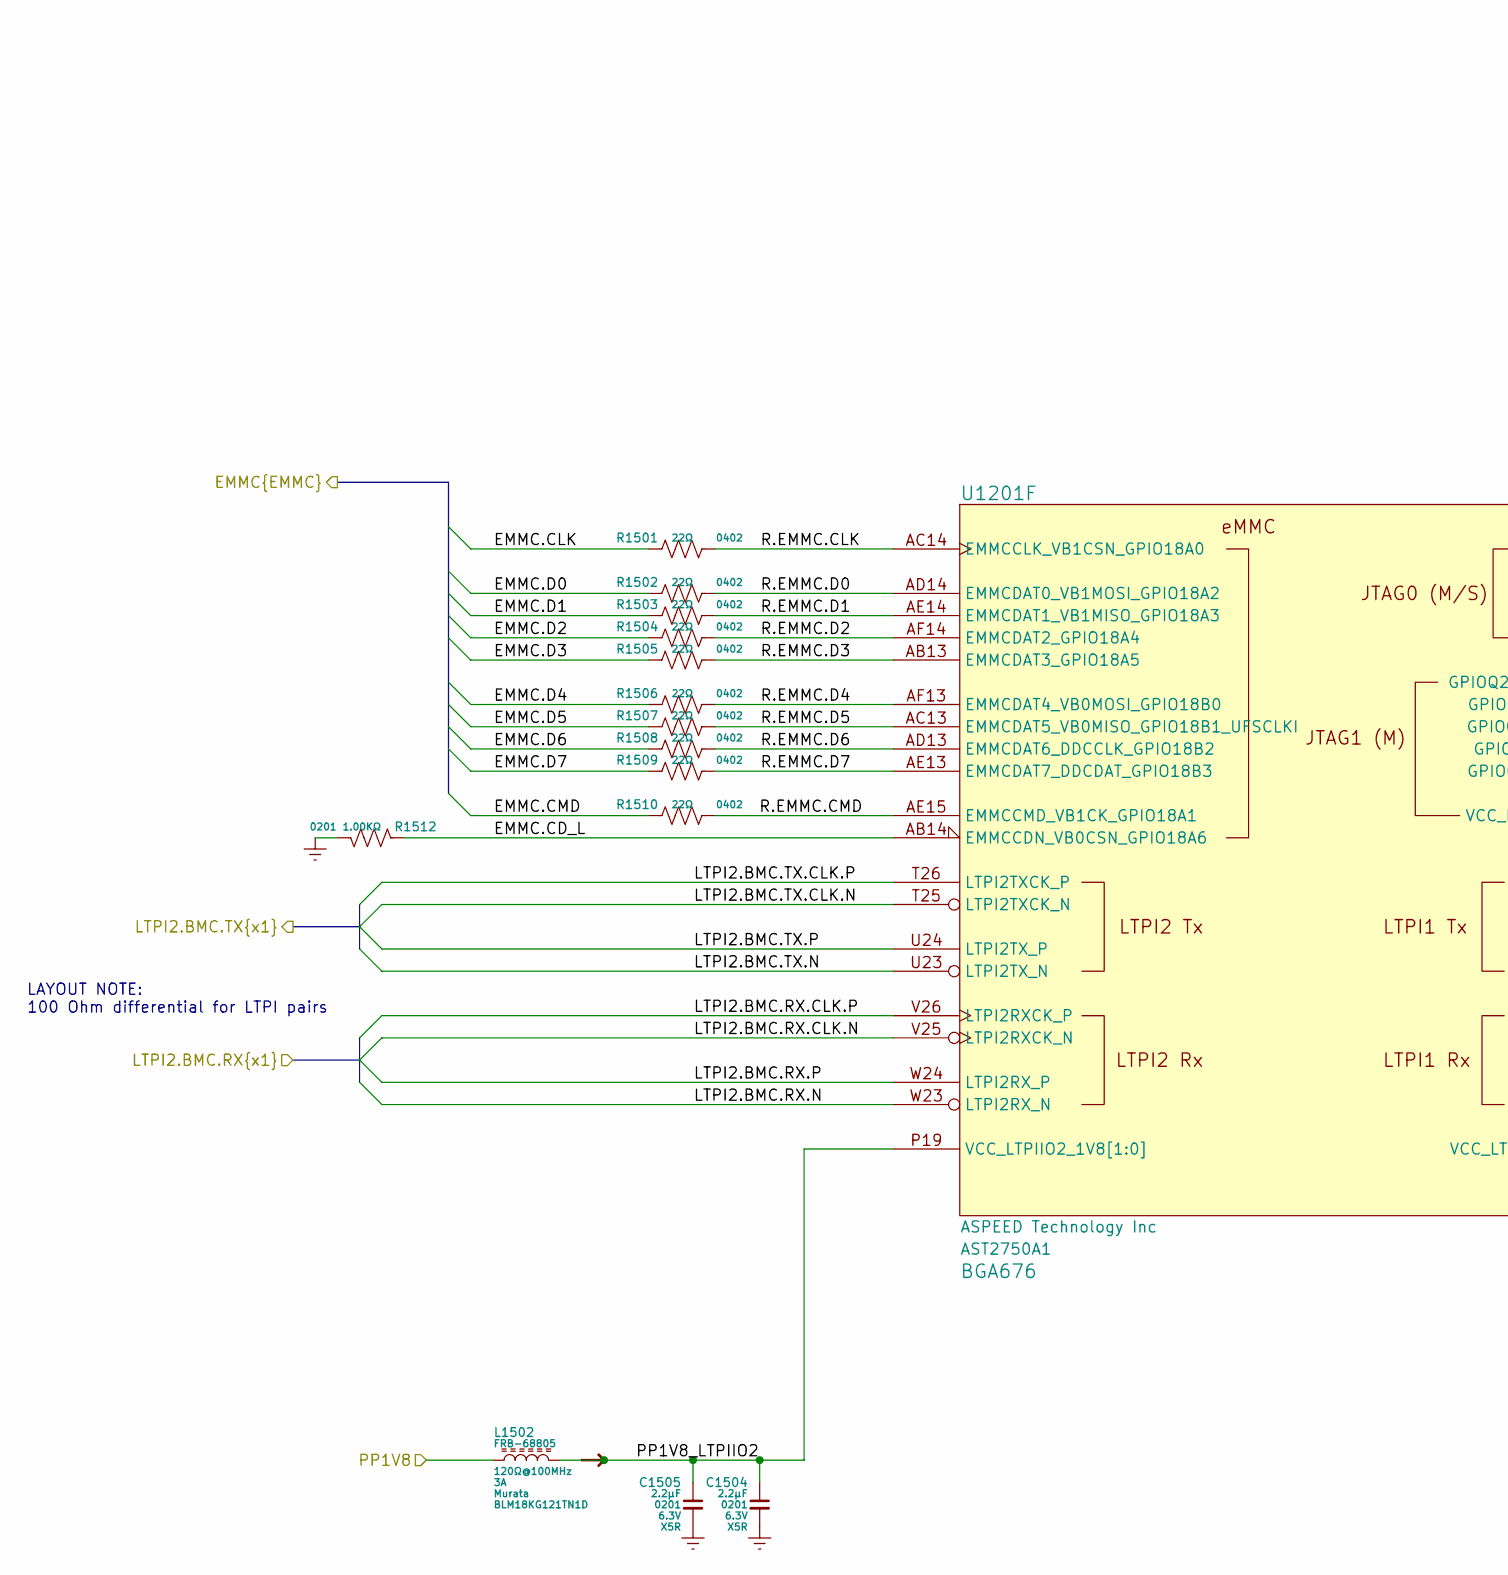
[picture p21: schematic emmc_jtag_ltpi.kicad_sch, part in row 1, column 1]

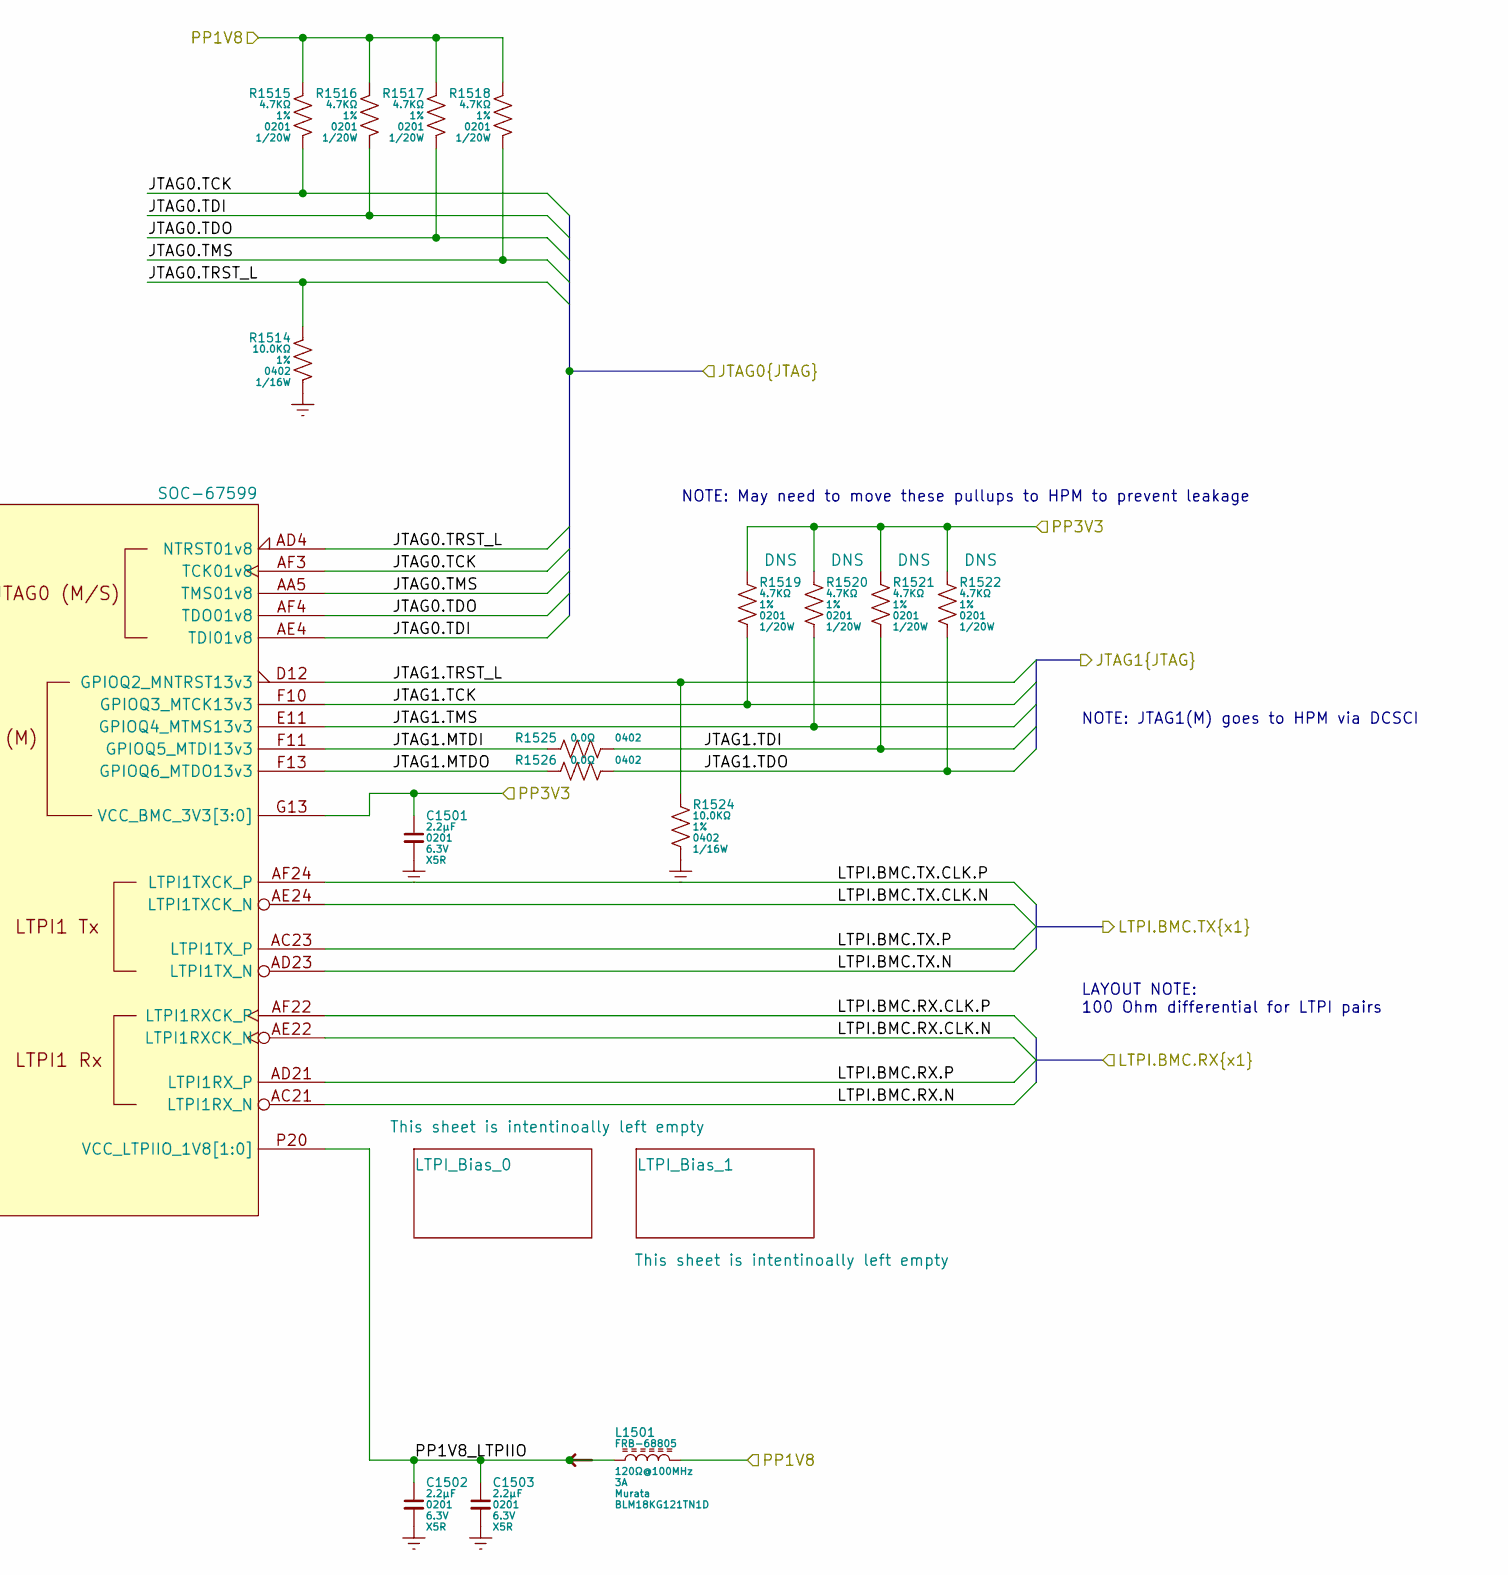
[picture p22: schematic emmc_jtag_ltpi.kicad_sch, part in row 1, column 2]

Parts:
C1501, C1502, C1503, C1504, C1505: CCM-722AA; mpn GRM033R60J225ME01
L1501, L1502: FRB-68805; mpn BLM18KG121TN1D
R1501, R1502, R1503, R1504, R1505, R1506, R1507, R1508, R1509, R1510: RES-2220B
R1512: RES-4100A
R1514, R1524: RES-5100B
R1515, R1516, R1517, R1518, R1519, R1520, R1521, R1522: RES-4470A
R1525, R1526: RES-0000B
U1201: SOC-67599; mpn AST2750A1

Connections:
EMMC.CD_L: R1512.1, U1201.AB14 (EMMCCDN_VB0CSN_GPIO18A6)
EMMC.CLK: R1501.1
EMMC.CMD: R1510.1
EMMC.D0: R1502.1
EMMC.D1: R1503.1
EMMC.D2: R1504.1
EMMC.D3: R1505.1
EMMC.D4: R1506.1
EMMC.D5: R1507.1
EMMC.D6: R1508.1
EMMC.D7: R1509.1
GND: C1501.2, C1502.2, C1503.2, C1504.2, C1505.2, R1512.2, R1514.2, R1524.2
JTAG0.TCK: R1515.2, U1201.AF3 (TCK01v8)
JTAG0.TDI: R1516.2, U1201.AE4 (TDI01v8)
JTAG0.TDO: R1517.2, U1201.AF4 (TDO01v8)
JTAG0.TMS: R1518.2, U1201.AA5 (TMS01v8)
JTAG0.TRST_L: R1514.1, U1201.AD4 (NTRST01v8)
JTAG1.MTDI: R1525.1, U1201.F11 (GPIOQ5_MTDI13v3)
JTAG1.MTDO: R1526.1, U1201.F13 (GPIOQ6_MTDO13v3)
JTAG1.TCK: R1519.2, U1201.F10 (GPIOQ3_MTCK13v3)
JTAG1.TDI: R1521.2, R1525.2
JTAG1.TDO: R1522.2, R1526.2
JTAG1.TMS: R1520.2, U1201.E11 (GPIOQ4_MTMS13v3)
JTAG1.TRST_L: R1524.1, U1201.D12 (GPIOQ2_MNTRST13v3)
LTPI2.BMC.RX.CLK.N: U1201.V25 (LTPI2RXCK_N)
LTPI2.BMC.RX.CLK.P: U1201.V26 (LTPI2RXCK_P)
LTPI2.BMC.RX.N: U1201.W23 (LTPI2RX_N)
LTPI2.BMC.RX.P: U1201.W24 (LTPI2RX_P)
LTPI2.BMC.TX.CLK.N: U1201.T25 (LTPI2TXCK_N)
LTPI2.BMC.TX.CLK.P: U1201.T26 (LTPI2TXCK_P)
LTPI2.BMC.TX.N: U1201.U23 (LTPI2TX_N)
LTPI2.BMC.TX.P: U1201.U24 (LTPI2TX_P)
LTPI.BMC.RX.CLK.N: U1201.AE22 (LTPI1RXCK_N)
LTPI.BMC.RX.CLK.P: U1201.AF22 (LTPI1RXCK_P)
LTPI.BMC.RX.N: U1201.AC21 (LTPI1RX_N)
LTPI.BMC.RX.P: U1201.AD21 (LTPI1RX_P)
LTPI.BMC.TX.CLK.N: U1201.AE24 (LTPI1TXCK_N)
LTPI.BMC.TX.CLK.P: U1201.AF24 (LTPI1TXCK_P)
LTPI.BMC.TX.N: U1201.AD23 (LTPI1TX_N)
LTPI.BMC.TX.P: U1201.AC23 (LTPI1TX_P)
PP1V8: L1501.2, L1502.1, R1515.1, R1516.1, R1517.1, R1518.1
PP1V8_LTPIIO: C1502.1, C1503.1, L1501.1, U1201.P20 (VCC_LTPIIO_1V8[1:0]), U1201.P21 (VCC_LTPIIO_1V8[1:0])
PP1V8_LTPIIO2: C1504.1, C1505.1, L1502.2, U1201.P19 (VCC_LTPIIO2_1V8[1:0]), U1201.R20 (VCC_LTPIIO2_1V8[1:0])
PP3V3: C1501.1, R1519.1, R1520.1, R1521.1, R1522.1, U1201.G13 (VCC_BMC_3V3[3:0])
R.EMMC.CLK: R1501.2, U1201.AC14 (EMMCCLK_VB1CSN_GPIO18A0)
R.EMMC.CMD: R1510.2, U1201.AE15 (EMMCCMD_VB1CK_GPIO18A1)
R.EMMC.D0: R1502.2, U1201.AD14 (EMMCDAT0_VB1MOSI_GPIO18A2)
R.EMMC.D1: R1503.2, U1201.AE14 (EMMCDAT1_VB1MISO_GPIO18A3)
R.EMMC.D2: R1504.2, U1201.AF14 (EMMCDAT2_GPIO18A4)
R.EMMC.D3: R1505.2, U1201.AB13 (EMMCDAT3_GPIO18A5)
R.EMMC.D4: R1506.2, U1201.AF13 (EMMCDAT4_VB0MOSI_GPIO18B0)
R.EMMC.D5: R1507.2, U1201.AC13 (EMMCDAT5_VB0MISO_GPIO18B1_UFSCLKI)
R.EMMC.D6: R1508.2, U1201.AD13 (EMMCDAT6_DDCCLK_GPIO18B2)
R.EMMC.D7: R1509.2, U1201.AE13 (EMMCDAT7_DDCDAT_GPIO18B3)

Notes on the sheet:
NOTE: JTAG1(M) goes to HPM via DCSCI
LAYOUT NOTE: 100 Ohm differential for LTPI pairs
NOTE: May need to move these pullups to HPM to prevent leakage
