rivosinc/scampi/sch/espi.kicad_sch

## KiCad design sch/espi.kicad_sch (2025-05-27)

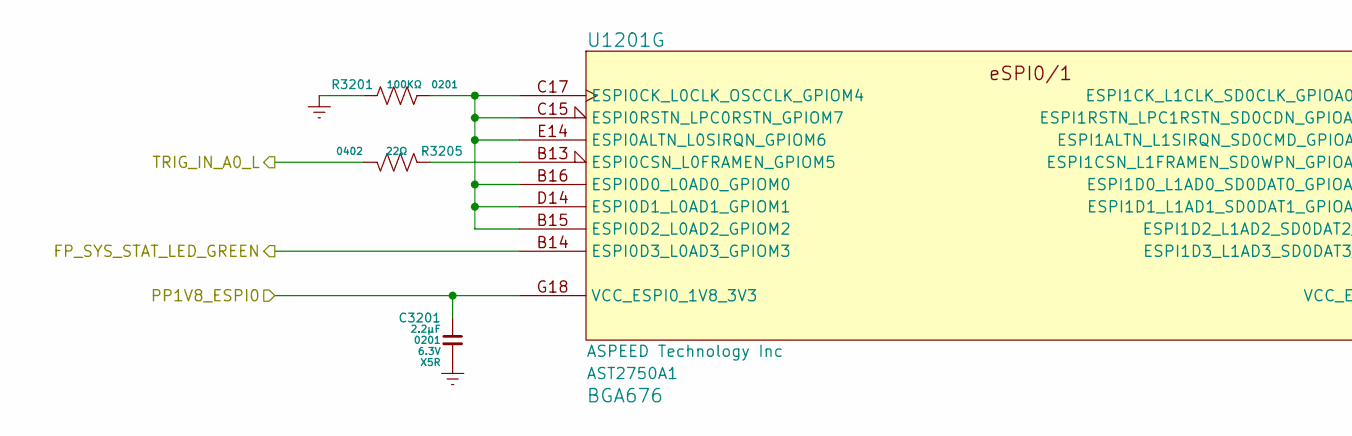
[picture p23: schematic espi.kicad_sch, part in row 1, column 1]

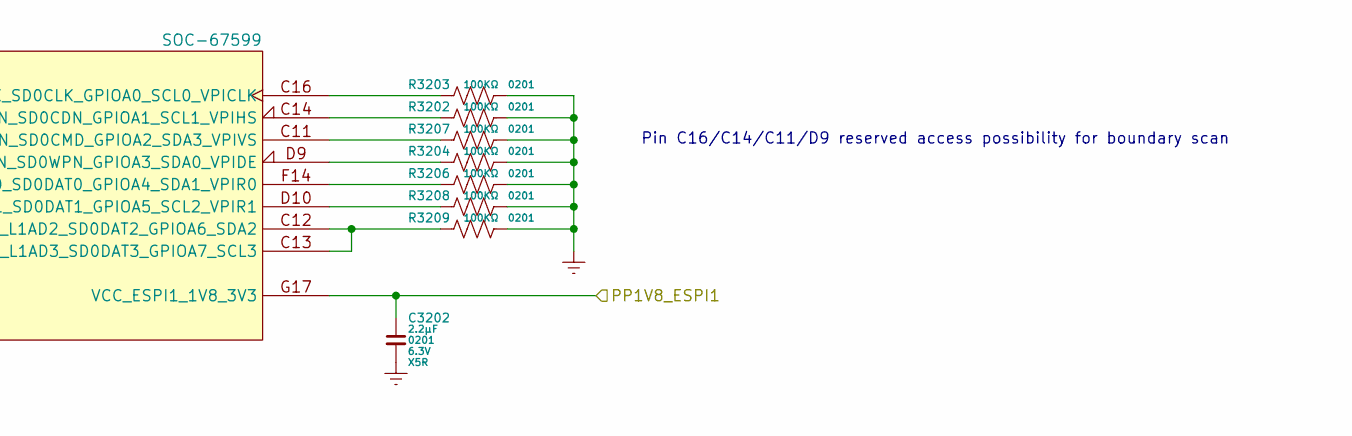
[picture p24: schematic espi.kicad_sch, part in row 1, column 2]

Parts:
C3201, C3202: CCM-722AA; mpn GRM033R60J225ME01
R3201, R3202, R3203, R3204, R3206, R3207, R3208, R3209: RES-6100A
R3205: RES-2220B
U1201: SOC-67599; mpn AST2750A1

Connections:
FP_SYS_STAT_LED_GREEN: U1201.B14 (ESPI0D3_L0AD3_GPIOM3)
GND: C3201.2, C3202.2, R3201.1, R3202.2, R3203.2, R3204.2, R3206.2, R3207.2, R3208.2, R3209.2
unnamed: R3201.2, U1201.B15 (ESPI0D2_L0AD2_GPIOM2), U1201.B16 (ESPI0D0_L0AD0_GPIOM0), U1201.C15 (ESPI0RSTN_LPC0RSTN_GPIOM7), U1201.C17 (ESPI0CK_L0CLK_OSCCLK_GPIOM4), U1201.D14 (ESPI0D1_L0AD1_GPIOM1), U1201.E14 (ESPI0ALTN_L0SIRQN_GPIOM6)
unnamed: R3202.1, U1201.C14 (ESPI1RSTN_LPC1RSTN_SD0CDN_GPIOA1_SCL1_V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)
unnamed: R3203.1, U1201.C16 (ESPI1CK_L1CLK_SD0CLK_GPIOA0_SCL0_VPICLK)
unnamed: R3204.1, U1201.D9 (ESPI1CSN_L1FRAMEN_SD0WPN_GPIOA3_SDA0_VP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)
unnamed: R3205.1, U1201.B13 (ESPI0CSN_L0FRAMEN_GPIOM5)
unnamed: R3206.1, U1201.F14 (ESPI1D0_L1AD0_SD0DAT0_GPIOA4_SDA1_VPIR0)
unnamed: R3207.1, U1201.C11 (ESPI1ALTN_L1SIRQN_SD0CMD_GPIOA2_SDA3_VP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)
unnamed: R3208.1, U1201.D10 (ESPI1D1_L1AD1_SD0DAT1_GPIOA5_SCL2_VPIR1)
unnamed: R3209.1, U1201.C12 (ESPI1D2_L1AD2_SD0DAT2_GPIOA6_SDA2), U1201.C13 (ESPI1D3_L1AD3_SD0DAT3_GPIOA7_SCL3)
PP1V8_ESPI0: C3201.1, U1201.G18 (VCC_ESPI0_1V8_3V3)
PP1V8_ESPI1: C3202.1, U1201.G17 (VCC_ESPI1_1V8_3V3)
TRIG_IN_A0_L: R3205.2

Notes on the sheet:
Pin C16/C14/C11/D9 reserved access possibility for boundary scan
