rivosinc/scampi/sch/eth_phy_conn.kicad_sch

## KiCad design sch/eth_phy_conn.kicad_sch (2025-05-27)

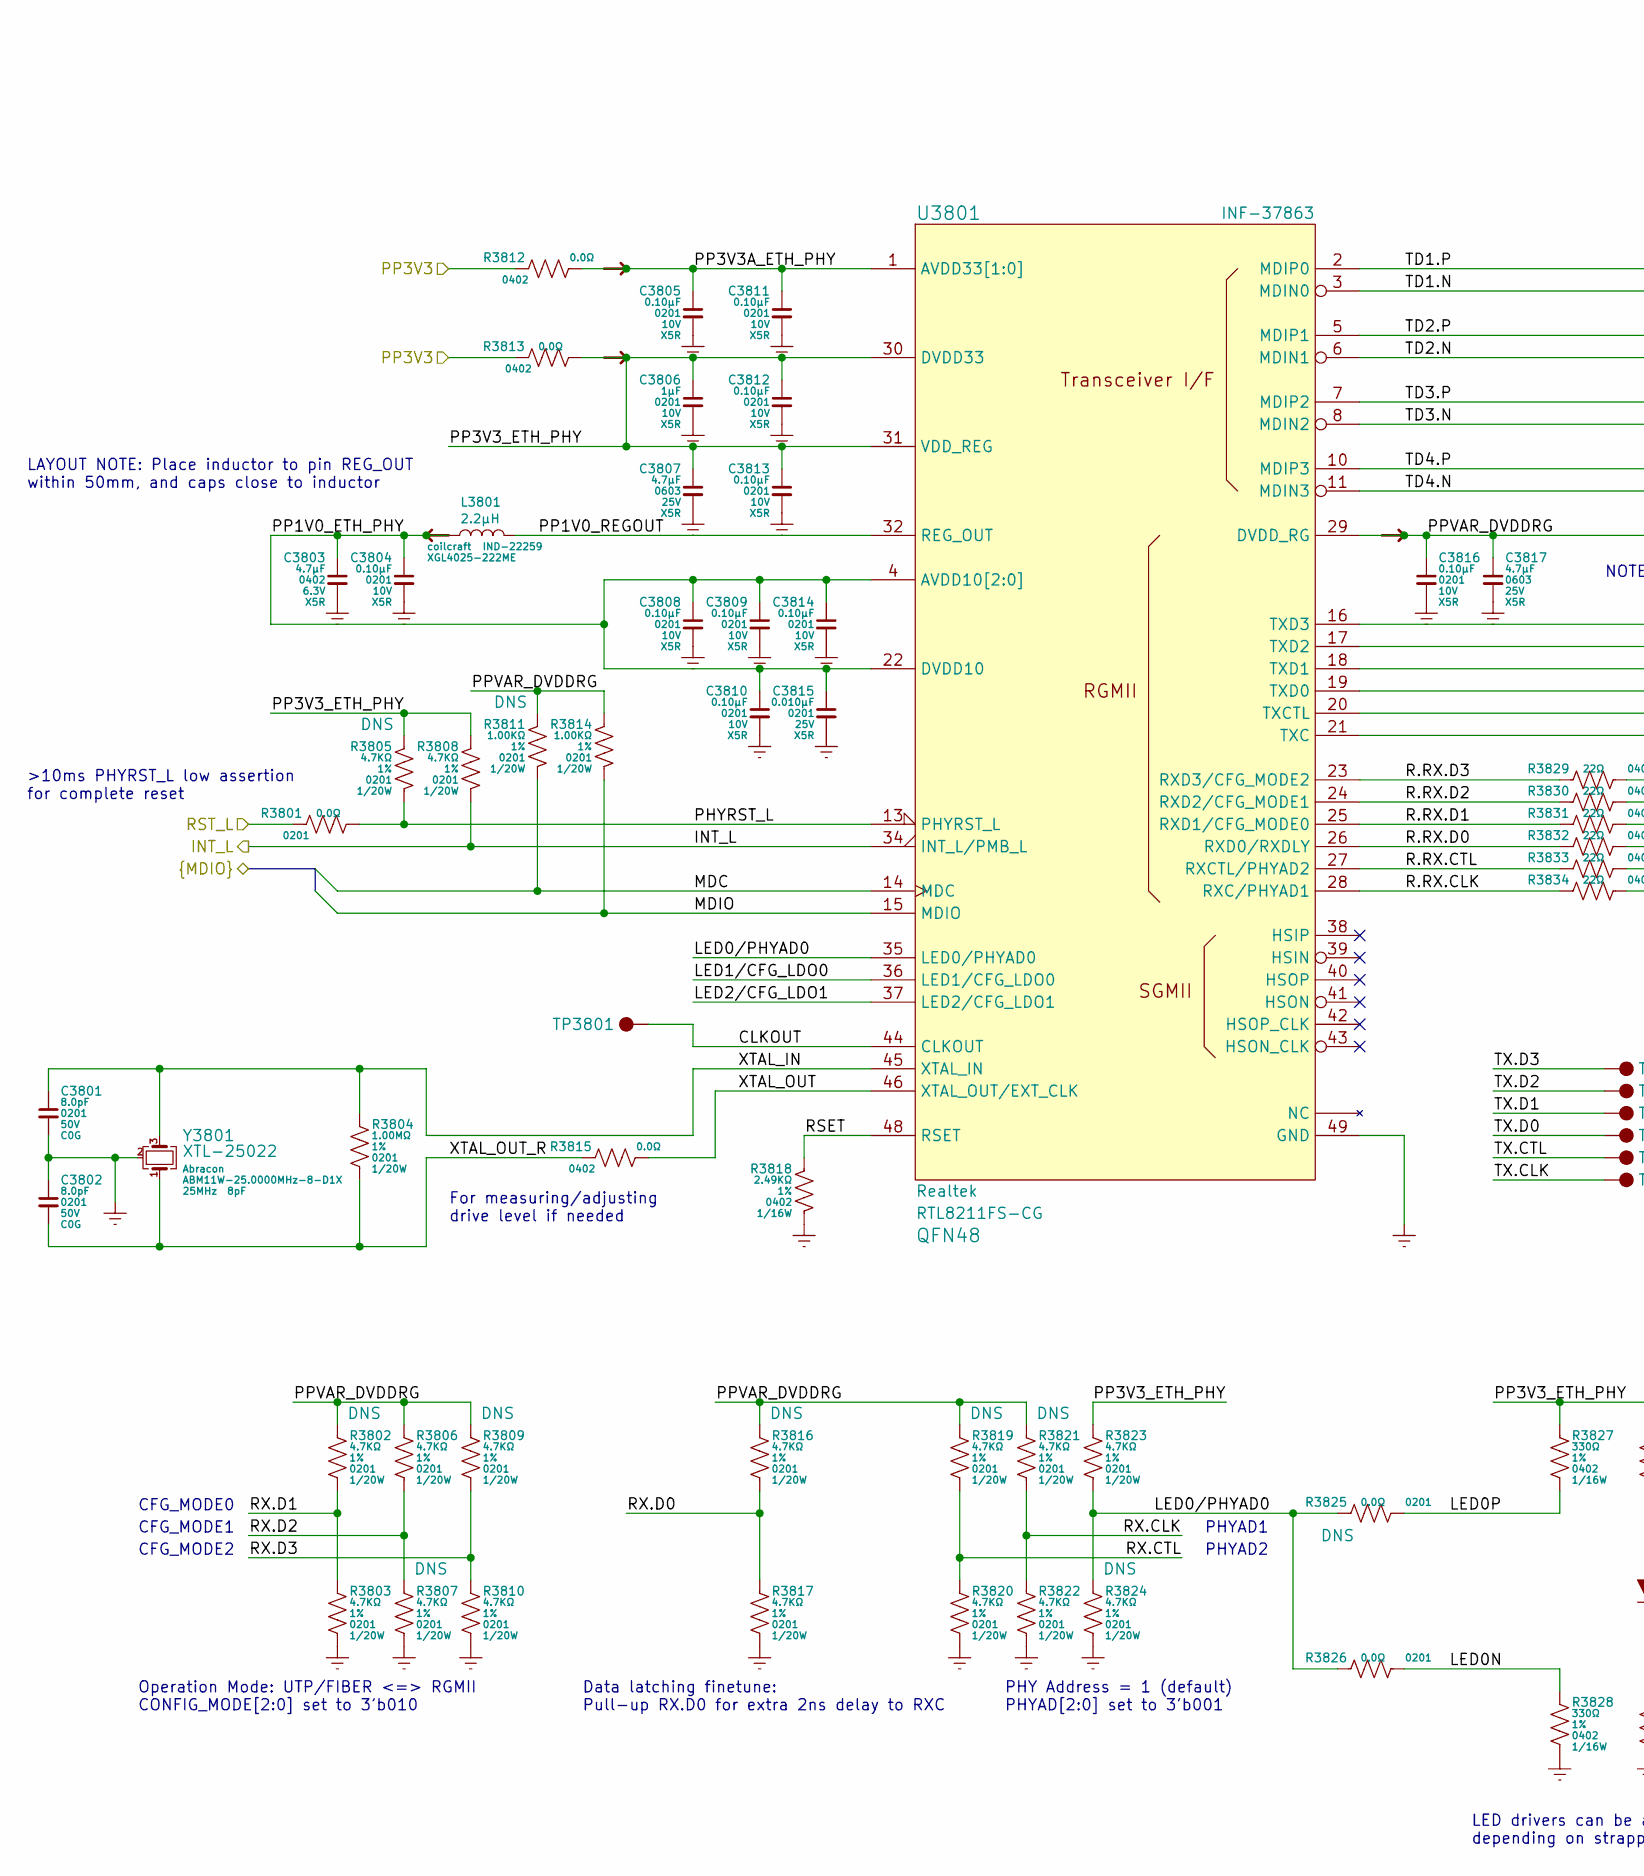
[picture p25: schematic eth_phy_conn.kicad_sch, part in row 1, column 1]

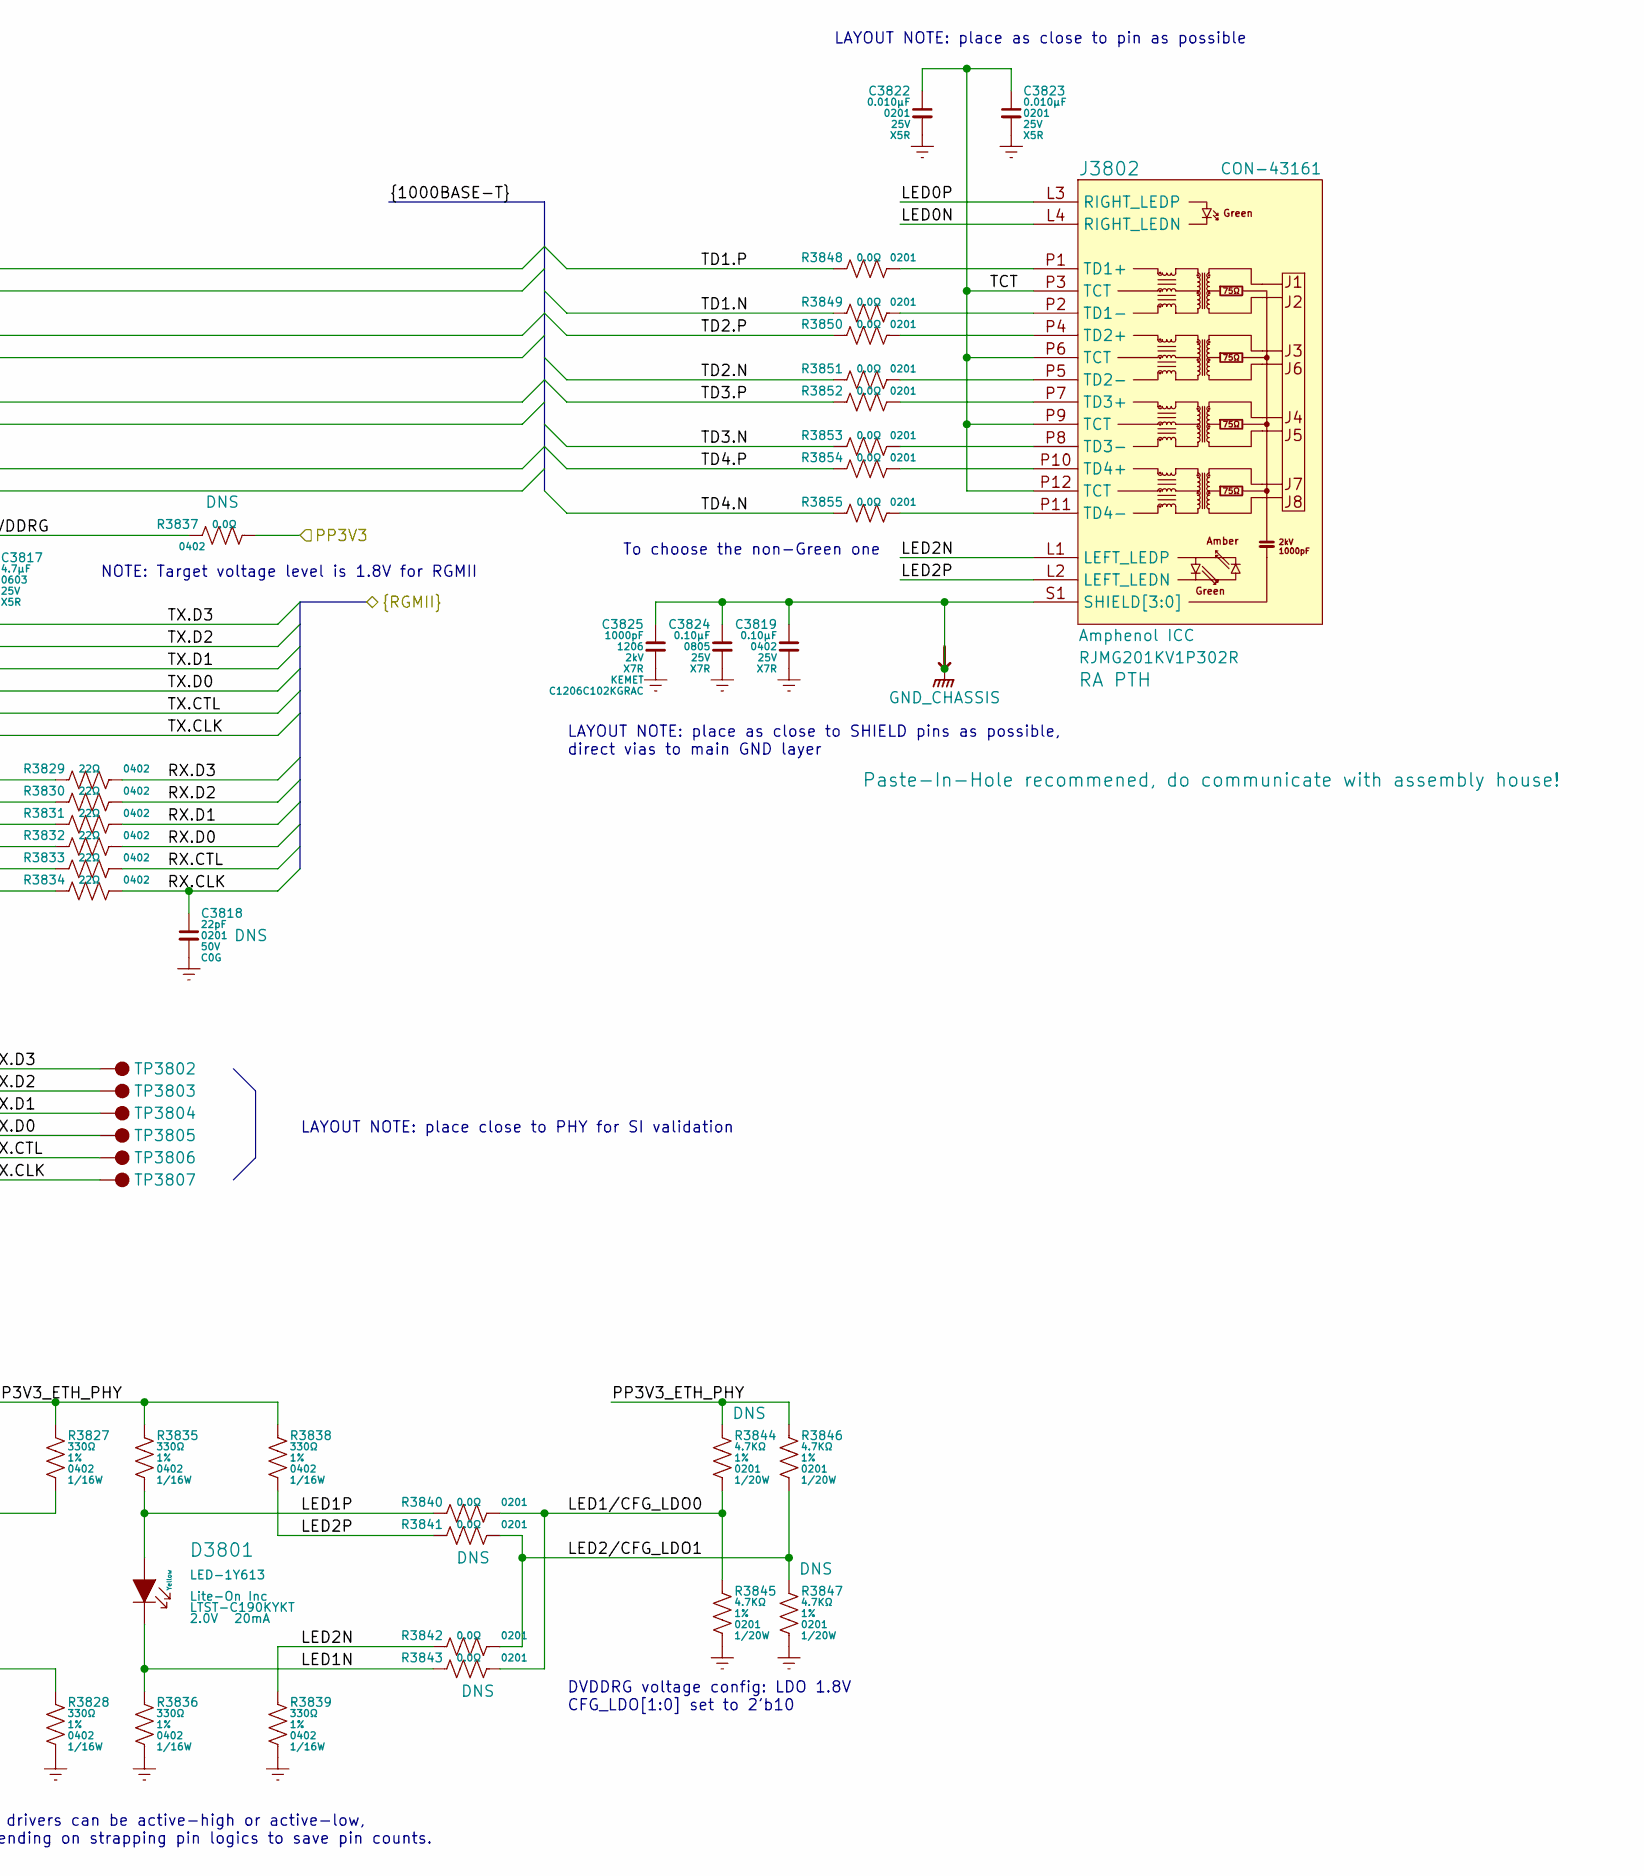
[picture p26: schematic eth_phy_conn.kicad_sch, part in row 1, column 2]

Parts:
C3801, C3802: CCM-180AA; mpn GRM0335C1H8R0DA01
C3803: CCM-747BC; mpn GRM155R60J475ME47
C3804, C3805, C3808, C3809, C3810, C3811, C3812, C3813, C3814, C3816: CCM-610AA; mpn GRM033R61A104ME15
C3806: CCM-710AD; mpn GRM033R61A105ME15
C3807, C3817: CCM-747CB; mpn GRM188R61E475KE11
C3815, C3822, C3823: CCM-510AC; mpn GRM033R61E103MA12
C3818: CCM-222AA; mpn GRM0335C1H220JA01
C3819: CCM-610BA; mpn GRM155R71E104KE14
C3824: CCM-610DA; mpn GRM21BR71E104KA01
C3825: CAP-72821; mpn C1206C102KGRAC
D3801: LED-1Y613; mpn LTST-C190KYKT
J3802: CON-43161; mpn RJMG201KV1P302R
L3801: IND-22259; mpn XGL4025-222ME
R3801, R3825, R3826, R3840, R3841, R3842, R3843, R3848, R3849, R3850, R3851, R3852, R3853, R3854, R3855: RES-0000A
R3802, R3803, R3805, R3806, R3807, R3808, R3809, R3810, R3816, R3817, R3819, R3820, R3821, R3822, R3823, R3824, R3844, R3845, R3846, R3847: RES-4470A
R3804: RES-7100A
R3811, R3814: RES-4100A
R3812, R3813, R3815, R3837: RES-0000B
R3818: RES-4249B
R3827, R3828, R3835, R3836, R3838, R3839: RES-3330B
R3829, R3830, R3831, R3832, R3833, R3834: RES-2220B
TP3801, TP3802, TP3803, TP3804, TP3805, TP3806, TP3807: TST-01025
U3801: INF-37863; mpn RTL8211FS-CG
Y3801: XTL-25022; mpn ABM11W-25.0000MHz-8-D1X

Connections:
CLKOUT: TP3801.1, U3801.44 (CLKOUT)
GND: C3801.2, C3802.1, C3803.2, C3804.2, C3805.2, C3806.2, C3807.2, C3808.2, C3809.2, C3810.2, C3811.2, C3812.2, C3813.2, C3814.2, C3815.2, C3816.2, C3817.2, C3818.2, C3819.2, C3822.2, C3823.2, C3824.2, C3825.2, R3803.2, R3807.2, R3810.2, R3817.2, R3818.2, R3820.2, R3822.2, R3824.2, R3828.2, R3836.2, R3839.2, R3845.2, R3847.2, U3801.49 (GND), Y3801.2, Y3801.4
GND_CHASSIS: C3819.1, C3824.1, C3825.1, J3802.S1 (SHIELD[3:0]), J3802.S2 (SHIELD[3:0]), J3802.S3 (SHIELD[3:0]), J3802.S4 (SHIELD[3:0])
INT_L: R3808.2, U3801.34 (INT_L/PMB_L)
LED0N: J3802.L4 (RIGHT_LEDN), R3826.2, R3828.1
LED0P: J3802.L3 (RIGHT_LEDP), R3825.2, R3827.2
LED0/PHYAD0: R3823.2, R3824.1, R3825.1, R3826.1, U3801.35 (LED0/PHYAD0)
LED1N: D3801.K, R3836.1, R3843.1
LED1P: D3801.A, R3835.2, R3840.1
LED1/CFG_LDO0: R3840.2, R3843.2, R3844.2, R3845.1, U3801.36 (LED1/CFG_LDO0)
LED2N: J3802.L1 (LEFT_LEDP), R3839.1, R3842.1
LED2P: J3802.L2 (LEFT_LEDN), R3838.2, R3841.1
LED2/CFG_LDO1: R3841.2, R3842.2, R3846.2, R3847.1, U3801.37 (LED2/CFG_LDO1)
MDC: R3811.2, U3801.14 (MDC)
MDIO: R3814.2, U3801.15 (MDIO)
unnamed: J3802.P1 (TD1+), R3848.2
unnamed: J3802.P2 (TD1-), R3849.2
unnamed: J3802.P4 (TD2+), R3850.2
unnamed: J3802.P5 (TD2-), R3851.2
unnamed: J3802.P7 (TD3+), R3852.2
unnamed: J3802.P8 (TD3-), R3853.2
unnamed: J3802.P10 (TD4+), R3854.2
unnamed: J3802.P11 (TD4-), R3855.2
PHYRST_L: R3801.2, R3805.2, U3801.13 (PHYRST_L)
PP1V0_ETH_PHY: C3803.1, C3804.1, C3808.1, C3809.1, C3810.1, C3814.1, C3815.1, L3801.1, U3801.4 (AVDD10[2:0]), U3801.9 (AVDD10[2:0]), U3801.22 (DVDD10), U3801.47 (AVDD10[2:0])
PP1V0_REGOUT: L3801.2, U3801.32 (REG_OUT)
PP3V3: R3812.1, R3813.1, R3837.2
PP3V3A_ETH_PHY: C3805.1, C3811.1, R3812.2, U3801.1 (AVDD33[1:0]), U3801.12 (AVDD33[1:0])
PP3V3_ETH_PHY: C3806.1, C3807.1, C3812.1, C3813.1, R3805.1, R3808.1, R3813.2, R3823.1, R3827.1, R3835.1, R3838.1, R3844.1, R3846.1, U3801.30 (DVDD33), U3801.31 (VDD_REG)
PPVAR_DVDDRG: C3816.1, C3817.1, R3802.1, R3806.1, R3809.1, R3811.1, R3814.1, R3816.1, R3819.1, R3821.1, R3837.1, U3801.29 (DVDD_RG)
R.RX.CLK: R3834.1, U3801.28 (RXC/PHYAD1)
R.RX.CTL: R3833.1, U3801.27 (RXCTL/PHYAD2)
R.RX.D0: R3832.1, U3801.26 (RXD0/RXDLY)
R.RX.D1: R3831.1, U3801.25 (RXD1/CFG_MODE0)
R.RX.D2: R3830.1, U3801.24 (RXD2/CFG_MODE1)
R.RX.D3: R3829.1, U3801.23 (RXD3/CFG_MODE2)
RSET: R3818.1, U3801.48 (RSET)
RST_L: R3801.1
RX.CLK: C3818.1, R3821.2, R3822.1, R3834.2
RX.CTL: R3819.2, R3820.1, R3833.2
RX.D0: R3816.2, R3817.1, R3832.2
RX.D1: R3802.2, R3803.1, R3831.2
RX.D2: R3806.2, R3807.1, R3830.2
RX.D3: R3809.2, R3810.1, R3829.2
TCT: C3822.1, C3823.1, J3802.P3 (TCT), J3802.P6 (TCT), J3802.P9 (TCT), J3802.P12 (TCT)
TD1.N: R3849.1, U3801.3 (MDIN0)
TD1.P: R3848.1, U3801.2 (MDIP0)
TD2.N: R3851.1, U3801.6 (MDIN1)
TD2.P: R3850.1, U3801.5 (MDIP1)
TD3.N: R3853.1, U3801.8 (MDIN2)
TD3.P: R3852.1, U3801.7 (MDIP2)
TD4.N: R3855.1, U3801.11 (MDIN3)
TD4.P: R3854.1, U3801.10 (MDIP3)
TX.CLK: TP3807.1, U3801.21 (TXC)
TX.CTL: TP3806.1, U3801.20 (TXCTL)
TX.D0: TP3805.1, U3801.19 (TXD0)
TX.D1: TP3804.1, U3801.18 (TXD1)
TX.D2: TP3803.1, U3801.17 (TXD2)
TX.D3: TP3802.1, U3801.16 (TXD3)
XTAL_IN: C3801.1, R3804.1, U3801.45 (XTAL_IN), Y3801.3
XTAL_OUT: R3815.2, U3801.46 (XTAL_OUT/EXT_CLK)
XTAL_OUT_R: C3802.2, R3804.2, R3815.1, Y3801.1

Notes on the sheet:
Operation Mode: UTP/FIBER <=> RGMII CONFIG_MODE[2:0] set to 3'b010
For measuring/adjusting drive level if needed
LAYOUT NOTE: place as close to SHIELD pins as possible, direct vias to main GND layer
PHY Address = 1 (default) PHYAD[2:0] set to 3'b001
LAYOUT NOTE: place as close to pin as possible
CFG_MODE2
To choose the non-Green one
PHYAD2
PHYAD1
LAYOUT NOTE: Place inductor to pin REG_OUT within 50mm, and caps close to inductor
DVDDRG voltage config: LDO 1.8V CFG_LDO[1:0] set to 2'b10
CFG_MODE0
LED drivers can be active-high or active-low, depending on strapping pin logics to save pin counts.
NOTE: Target voltage level is 1.8V for RGMII
Data latching finetune: Pull-up RX.D0 for extra 2ns delay to RXC
>10ms PHYRST_L low assertion for complete reset
CFG_MODE1
LAYOUT NOTE: place close to PHY for SI validation
