rivosinc/scampi/sch/fp_btn_led.kicad_sch

## KiCad design sch/fp_btn_led.kicad_sch (2025-05-27)

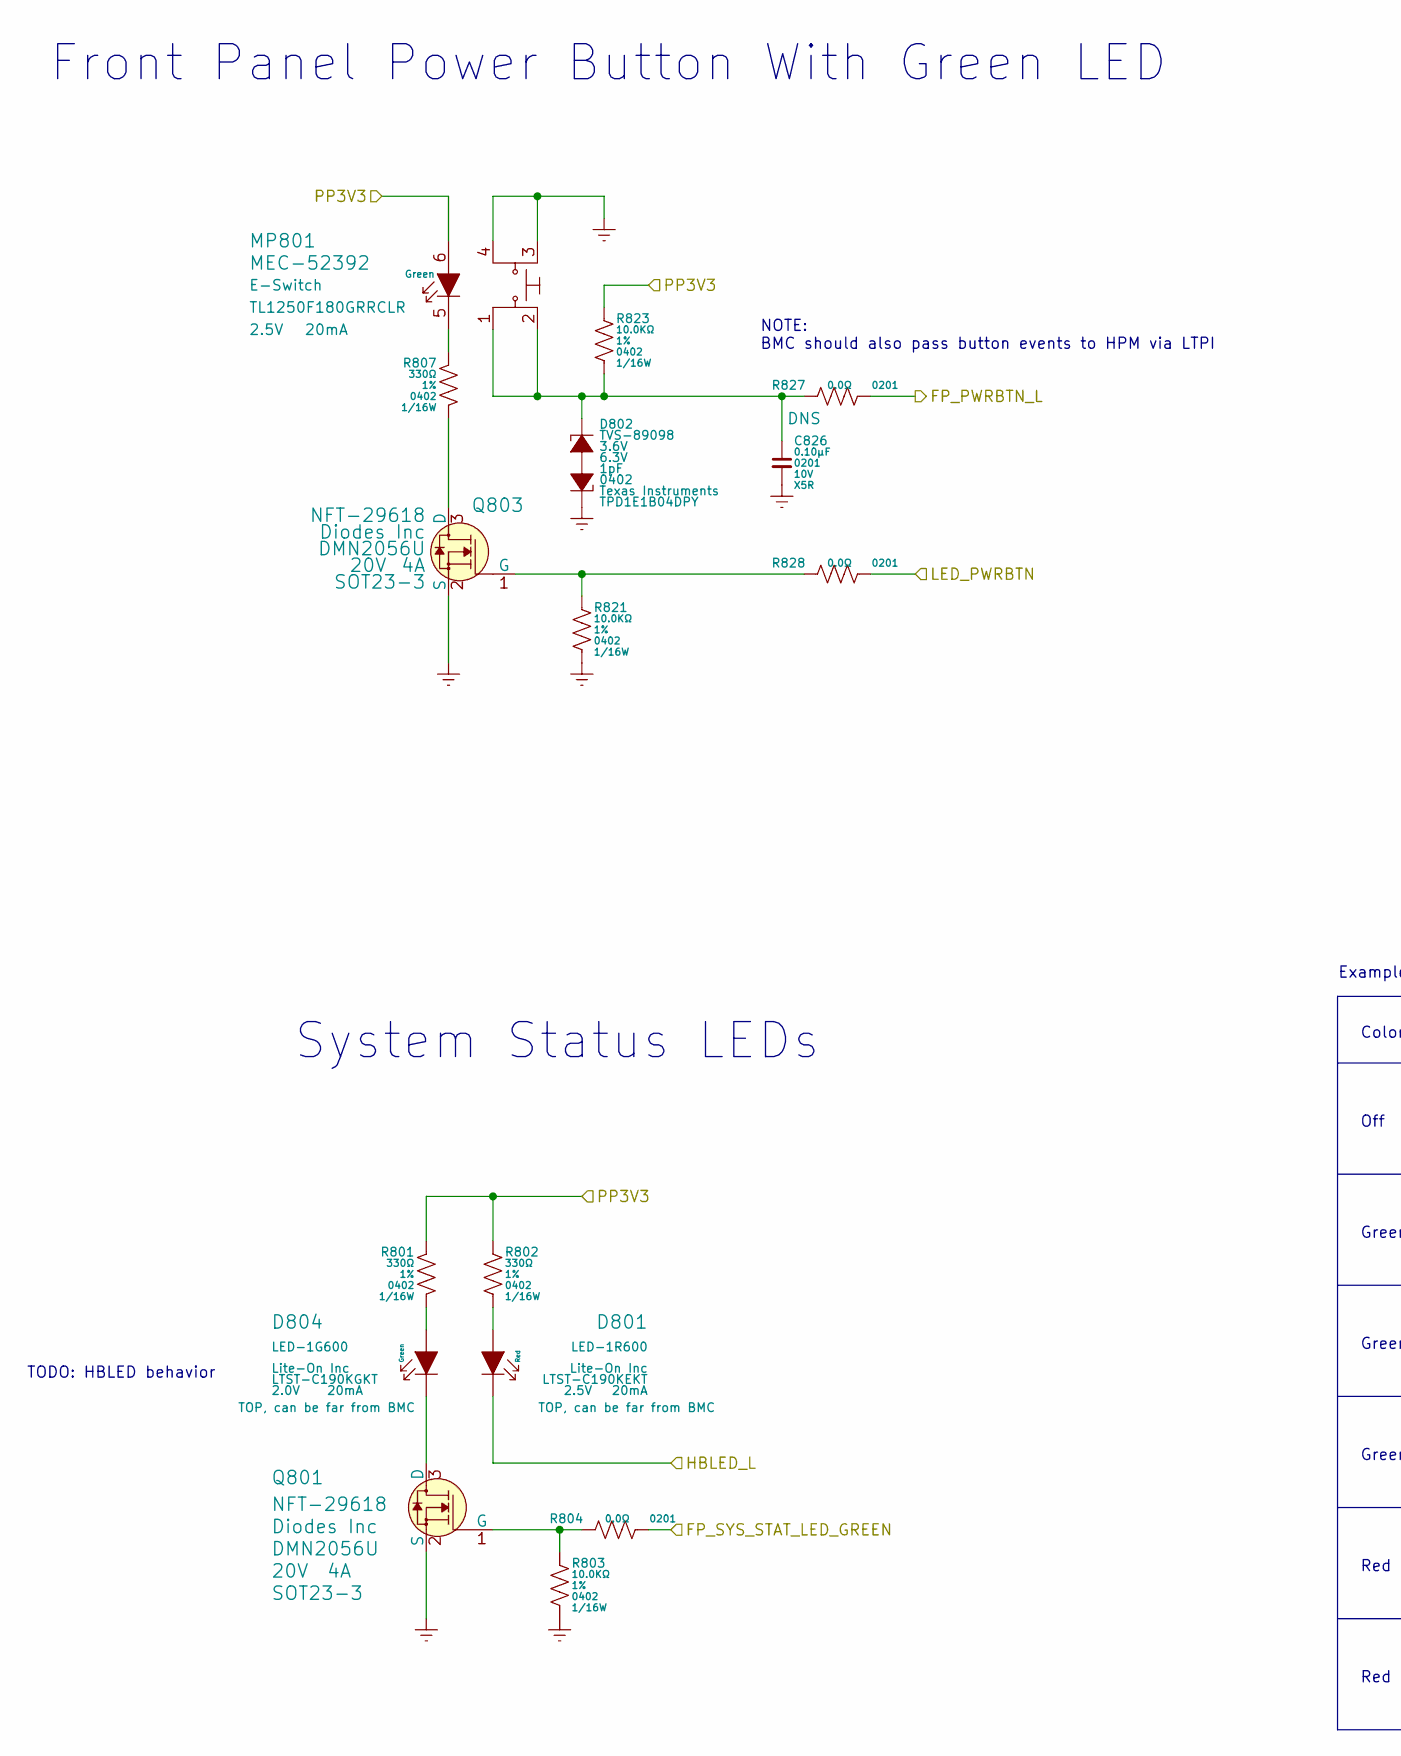
[picture p27: schematic fp_btn_led.kicad_sch, part in row 1, column 1]

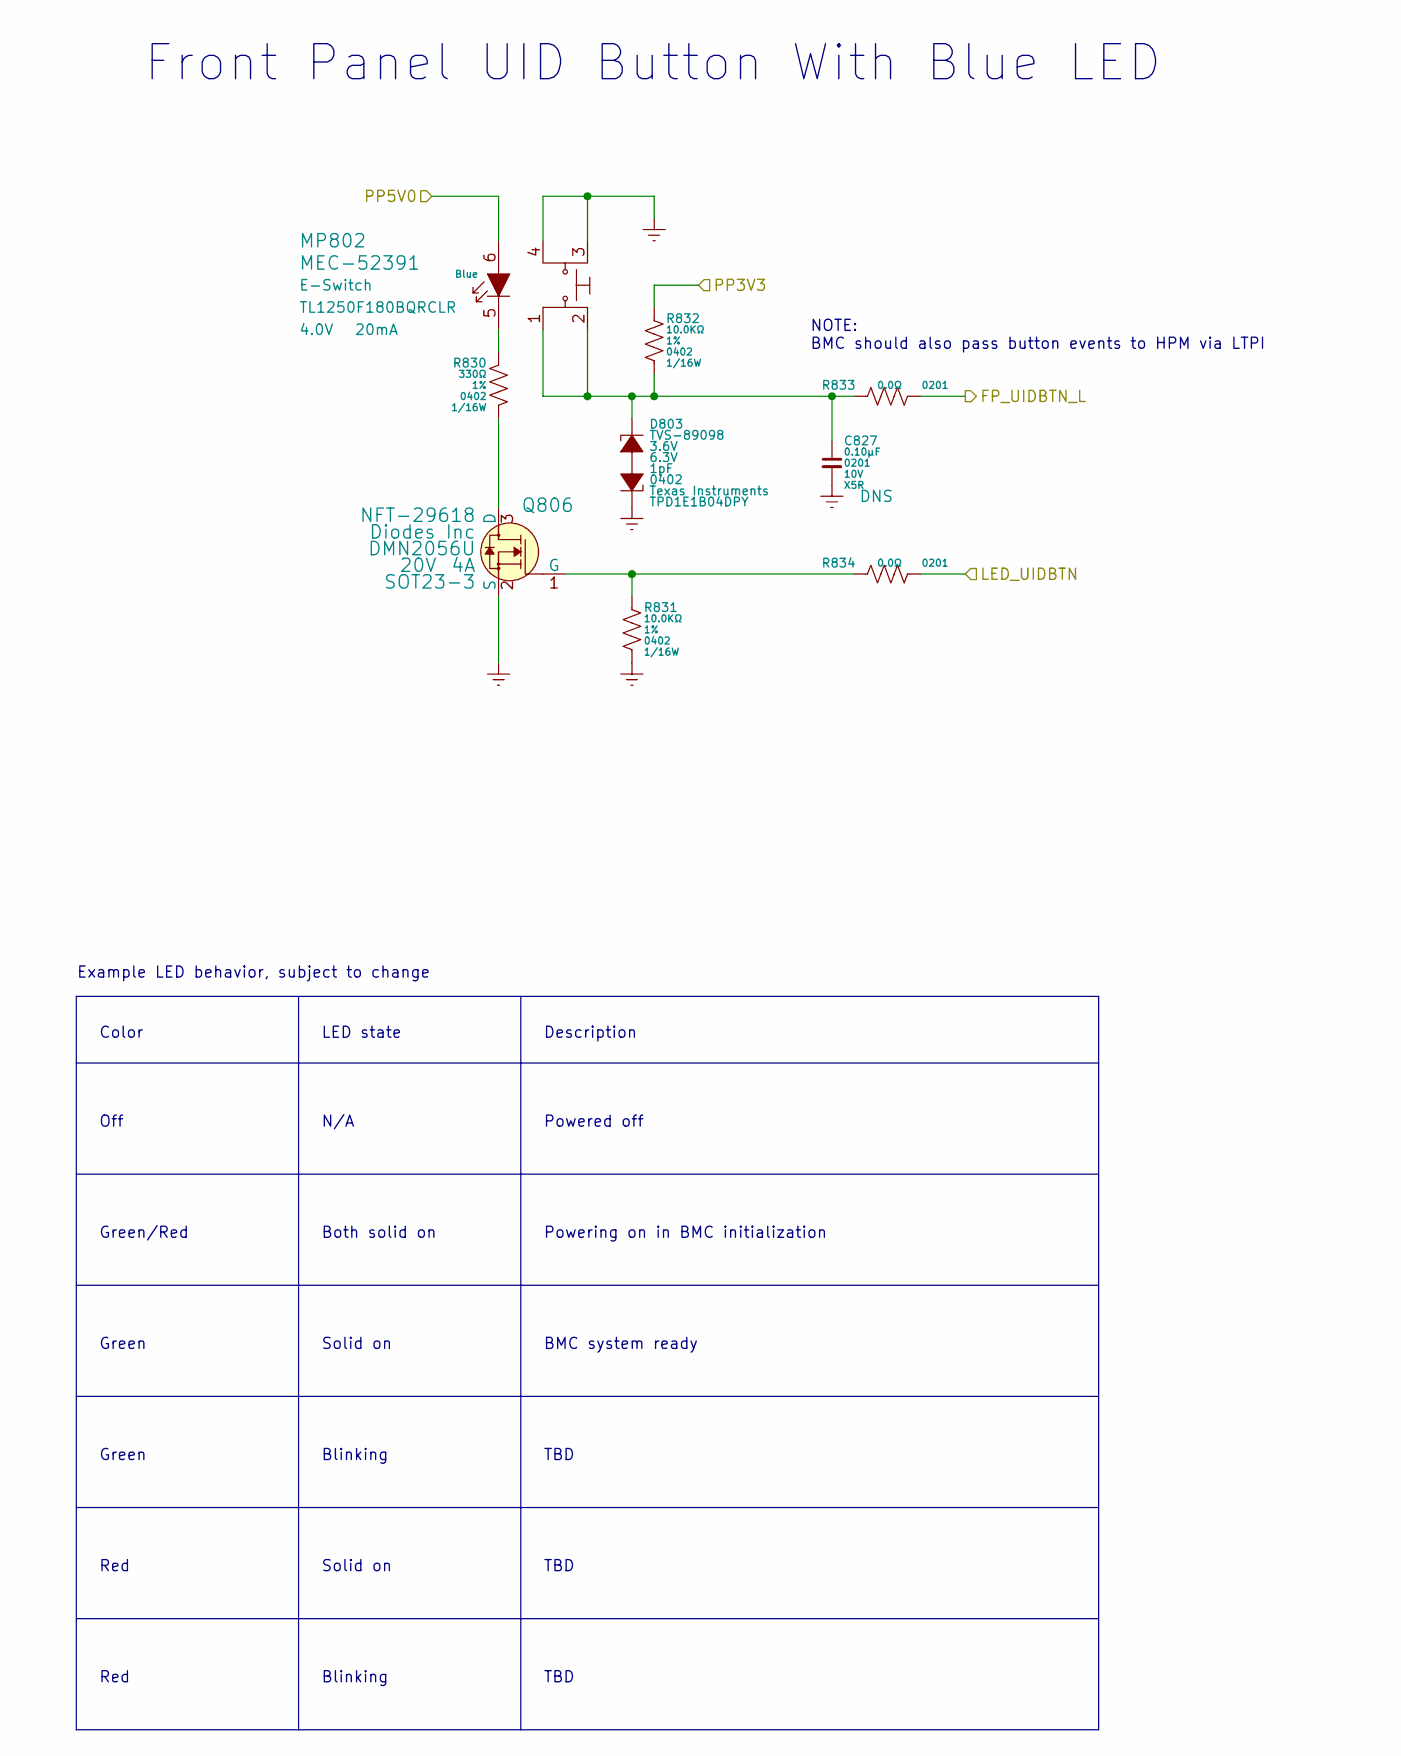
[picture p28: schematic fp_btn_led.kicad_sch, part in row 1, column 2]

Parts:
C826, C827: CCM-610AA; mpn GRM033R61A104ME15
D801: LED-1R600; mpn LTST-C190KEKT
D802, D803: TVS-89098; mpn TPD1E1B04DPY
D804: LED-1G600; mpn LTST-C190KGKT
MP801: MEC-52392; mpn TL1250F180GRRCLR
MP802: MEC-52391; mpn TL1250F180BQRCLR
Q801, Q803, Q806: NFT-29618; mpn DMN2056U
R801, R802, R807, R830: RES-3330B
R803, R821, R823, R831, R832: RES-5100B
R804, R827, R828, R833, R834: RES-0000A

Connections:
FP_PWRBTN_L: R827.2
FP_SYS_STAT_LED_GREEN: R804.2
FP_UIDBTN_L: R833.2
GND: C826.2, C827.2, D802.2, D803.2, MP801.3, MP801.4, MP802.3, MP802.4, Q801.2 (S), Q803.2 (S), Q806.2 (S), R803.2, R821.2, R831.2
HBLED_L: D801.K
LED_PWRBTN: R828.2
LED_UIDBTN: R834.2
unnamed: C826.1, D802.1, MP801.1, MP801.2, R823.2, R827.1
unnamed: C827.1, D803.1, MP802.1, MP802.2, R832.2, R833.1
unnamed: D801.A, R802.2
unnamed: D804.A, R801.2
unnamed: D804.K, Q801.3 (D)
unnamed: MP801.5, R807.1
unnamed: MP802.5, R830.1
unnamed: Q801.1 (G), R803.1, R804.1
unnamed: Q803.1 (G), R821.1, R828.1
unnamed: Q803.3 (D), R807.2
unnamed: Q806.1 (G), R831.1, R834.1
unnamed: Q806.3 (D), R830.2
PP3V3: MP801.6, R801.1, R802.1, R823.1, R832.1
PP5V0: MP802.6

Notes on the sheet:
BMC system ready
Off
Description
Front Panel Power Button With Green LED
Front Panel UID Button With Blue LED
Green
N/A
Powered off
Color
TBD
Solid on
Both solid on
Blinking
Red
Green/Red
NOTE: BMC should also pass button events to HPM via LTPI
Powering on in BMC initialization
TODO: HBLED behavior
LED state
System Status LEDs
Example LED behavior, subject to change
