rivosinc/scampi/sch/ftdi.kicad_sch

## KiCad design sch/ftdi.kicad_sch (2025-05-27)

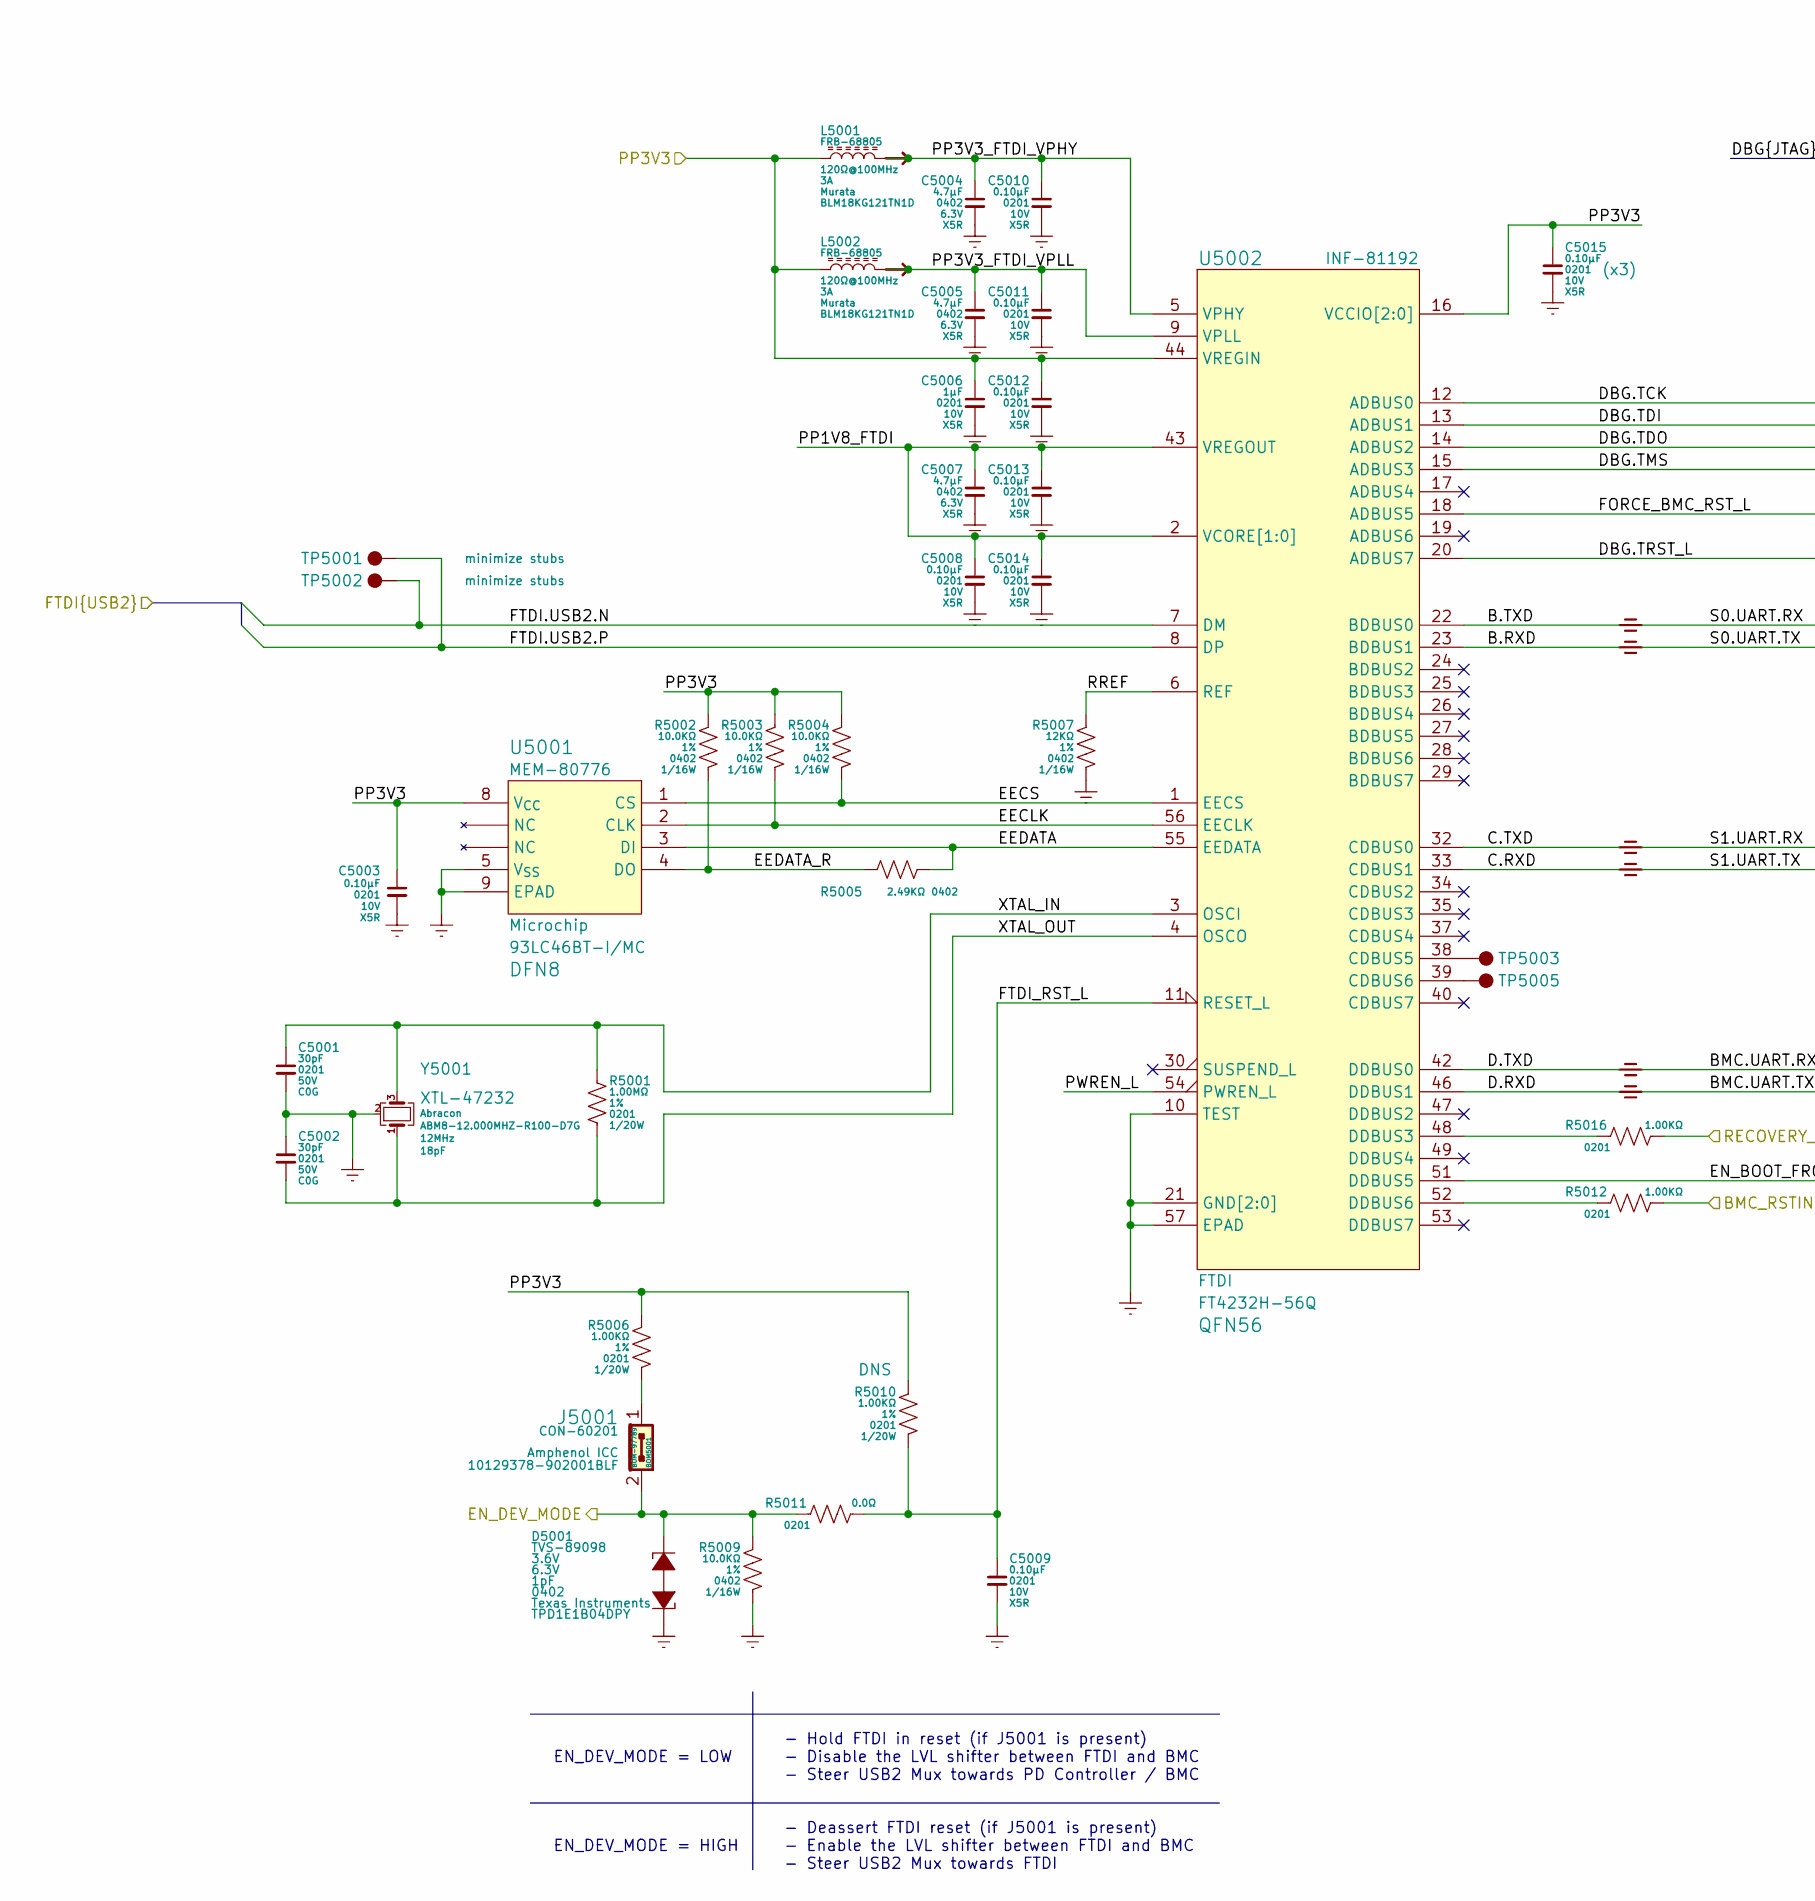
[picture p29: schematic ftdi.kicad_sch, part in row 1, column 1]

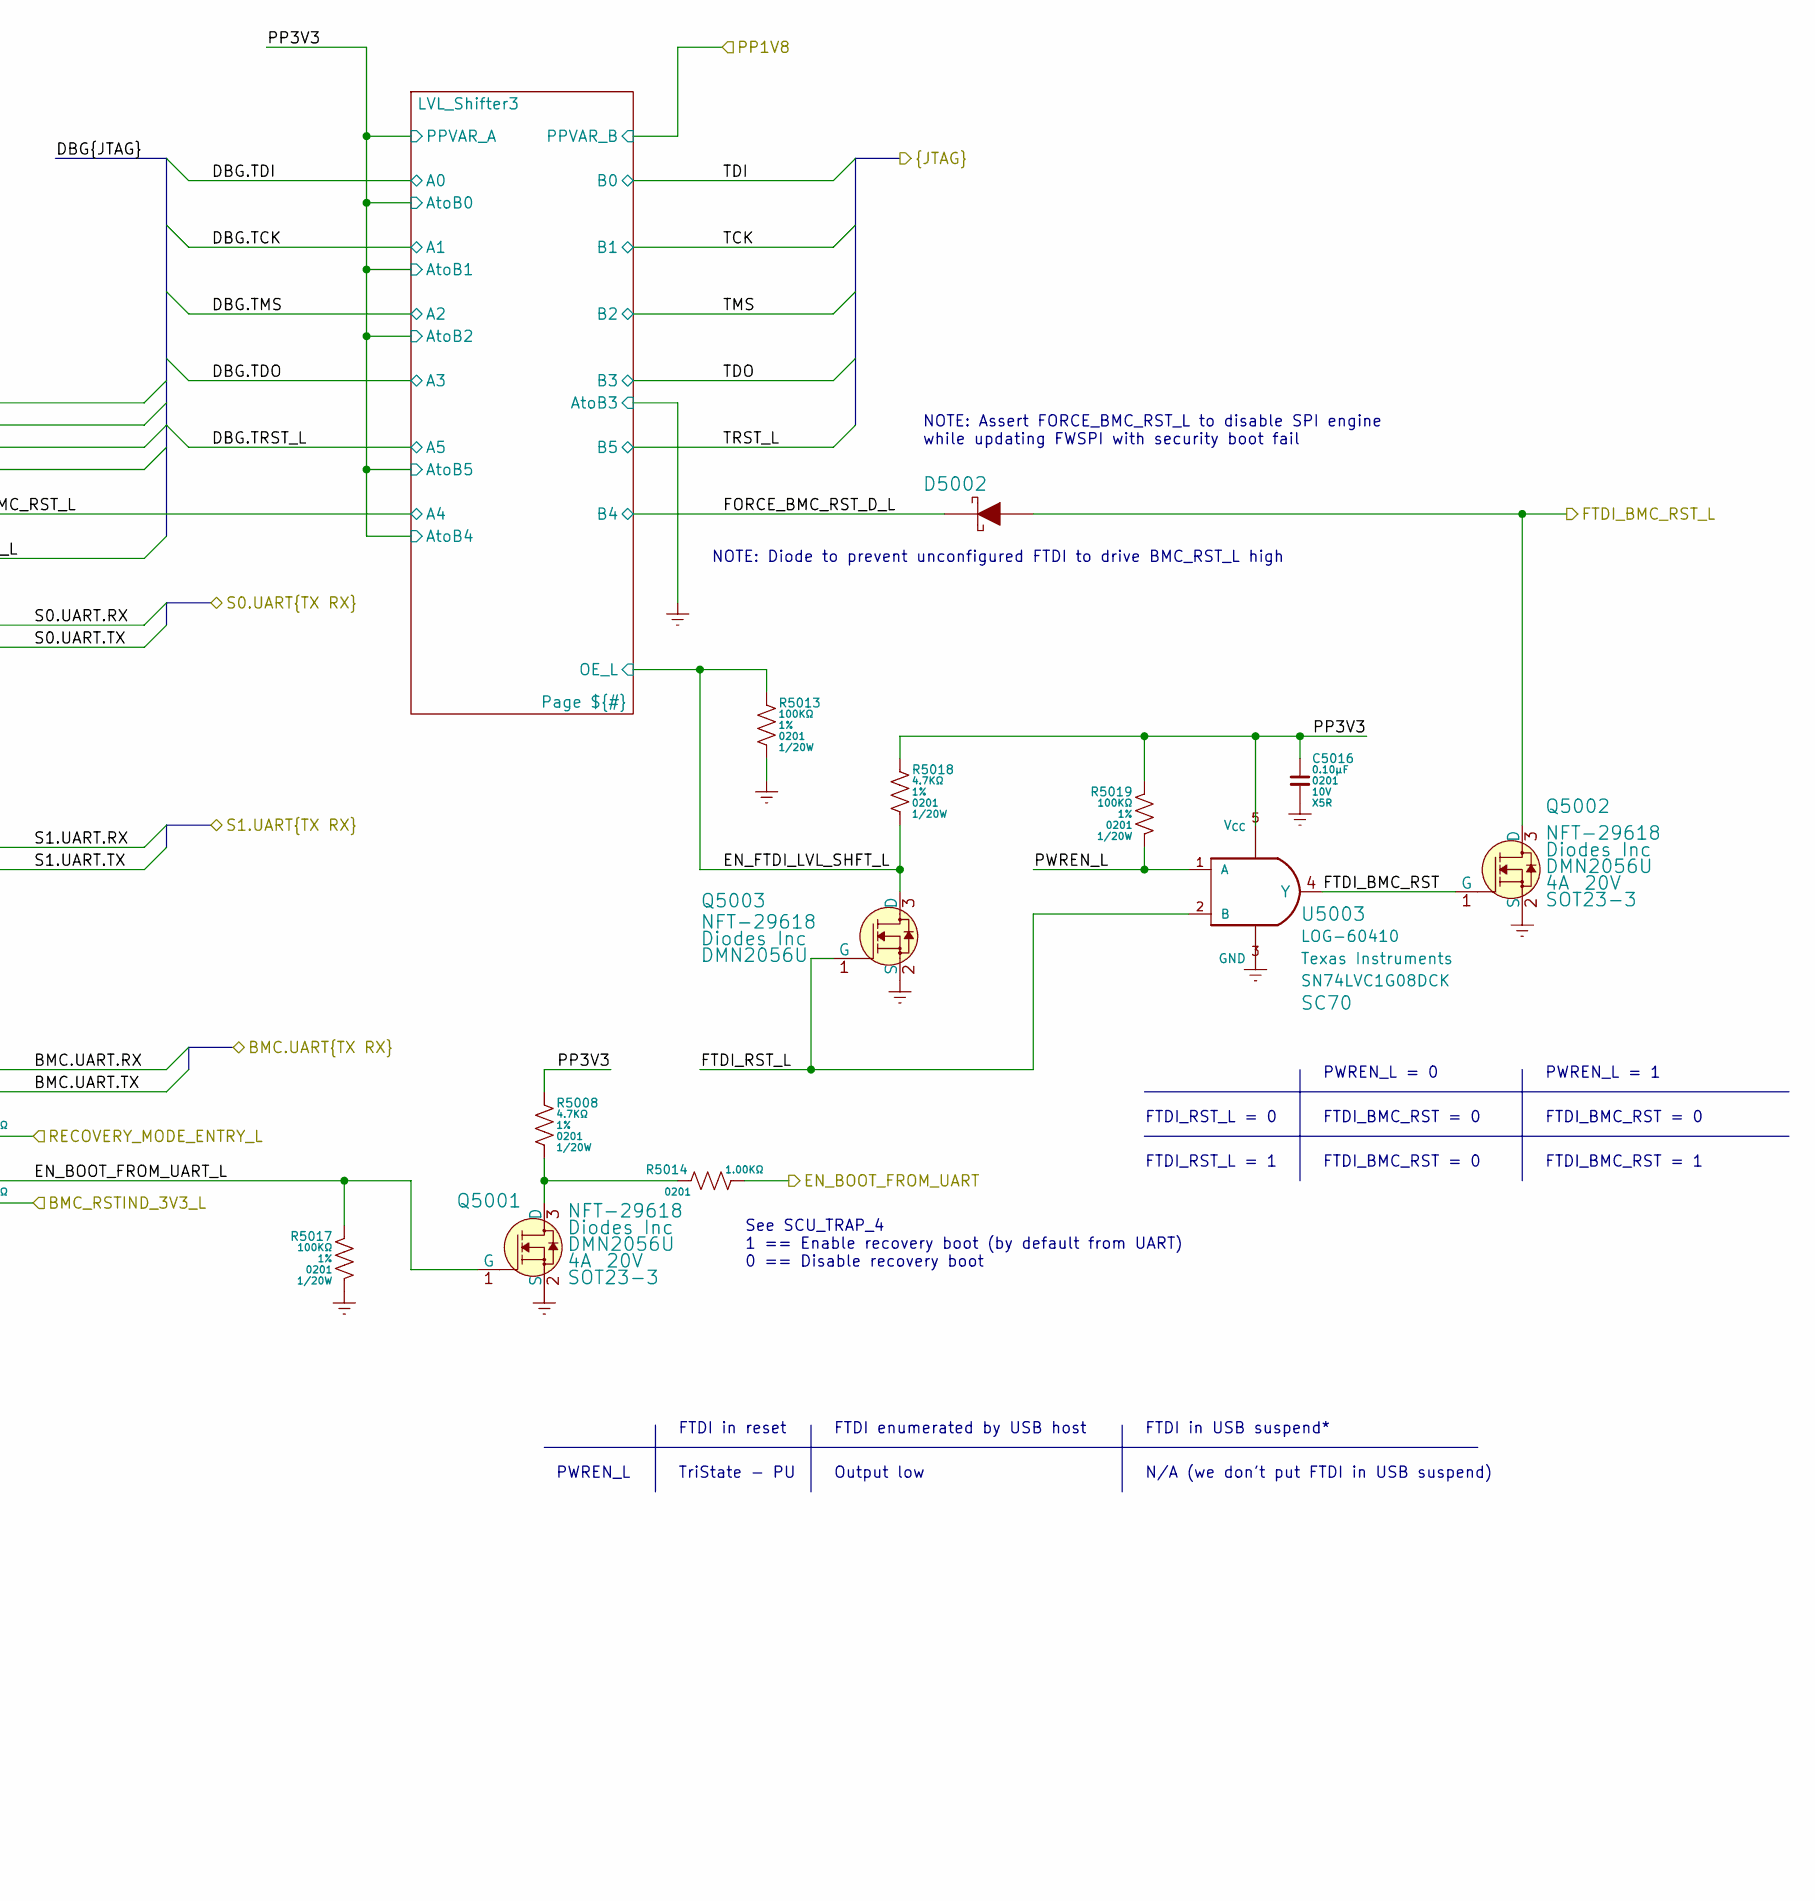
[picture p30: schematic ftdi.kicad_sch, part in row 1, column 2]

Parts:
BOM5001: BOM-97789; mpn 881545-1
C5001, C5002: CCM-230AA; mpn GRM0335C1H300JA01
C5003, C5008, C5009, C5010, C5011, C5012, C5013, C5014, C5015, C5016: CCM-610AA; mpn GRM033R61A104ME15
C5004, C5005, C5007: CCM-747BC; mpn GRM155R60J475ME47
C5006: CCM-710AD; mpn GRM033R61A105ME15
D5001: TVS-89098; mpn TPD1E1B04DPY
D5002: DIO-14387; mpn SBA0520Q
J5001: CON-60201; mpn 10129378-902001BLF
L5001, L5002: FRB-68805; mpn BLM18KG121TN1D
NT5002, NT5003, NT5004, NT5005, NT5006, NT5007: NET-10002
Q5001, Q5002, Q5003: NFT-29618; mpn DMN2056U
R5001: RES-7100A
R5002, R5003, R5004, R5009: RES-5100B
R5005: RES-4249B
R5006, R5010, R5012, R5014, R5016: RES-4100A
R5007: RES-5120B
R5008, R5018: RES-4470A
R5011: RES-0000A
R5013, R5017, R5019: RES-6100A
TP5001, TP5002, TP5003, TP5005: TST-01025
U5001: MEM-80776; mpn 93LC46BT-I/MC
U5002: INF-81192; mpn FT4232H-56Q
U5003: LOG-60410; mpn SN74LVC1G08DCK
Y5001: XTL-47232; mpn ABM8-12.000MHZ-R100-D7G

Connections:
B.RXD: NT5003.1, U5002.23 (BDBUS1)
B.TXD: NT5002.1, U5002.22 (BDBUS0)
BMC.UART.RX: NT5006.2
BMC.UART.TX: NT5007.2
BMC_RSTIND_3V3_L: R5012.2
C.RXD: NT5005.1, U5002.33 (CDBUS1)
C.TXD: NT5004.1, U5002.32 (CDBUS0)
D.RXD: NT5007.1, U5002.46 (DDBUS1)
D.TXD: NT5006.1, U5002.42 (DDBUS0)
DBG.TCK: U5002.12 (ADBUS0)
DBG.TDI: U5002.13 (ADBUS1)
DBG.TDO: U5002.14 (ADBUS2)
DBG.TMS: U5002.15 (ADBUS3)
DBG.TRST_L: U5002.20 (ADBUS7)
EECLK: R5003.2, U5001.2 (CLK), U5002.56 (EECLK)
EECS: R5004.2, U5001.1 (CS), U5002.1 (EECS)
EEDATA: R5005.2, U5001.3 (DI), U5002.55 (EEDATA)
EEDATA_R: R5002.2, R5005.1, U5001.4 (DO)
EN_BOOT_FROM_UART: R5014.2
EN_BOOT_FROM_UART_L: Q5001.1 (G), R5017.1, U5002.51 (DDBUS5)
EN_DEV_MODE: D5001.1, J5001.2, R5009.1, R5011.1
EN_FTDI_LVL_SHFT_L: Q5003.3 (D), R5013.1, R5018.2
FORCE_BMC_RST_D_L: D5002.K
FORCE_BMC_RST_L: U5002.18 (ADBUS5)
FTDI.USB2.N: TP5002.1, U5002.7 (DM)
FTDI.USB2.P: TP5001.1, U5002.8 (DP)
FTDI_BMC_RST: Q5002.1 (G), U5003.4 (Y)
FTDI_BMC_RST_L: D5002.A, Q5002.3 (D)
FTDI_RST_L: C5009.1, Q5003.1 (G), R5010.2, R5011.2, U5002.11 (RESET_L), U5003.2 (B)
GND: C5001.2, C5002.1, C5003.2, C5004.2, C5005.2, C5006.2, C5007.2, C5008.2, C5009.2, C5010.2, C5011.2, C5012.2, C5013.2, C5014.2, C5015.2, C5016.2, D5001.2, Q5001.2 (S), Q5002.2 (S), Q5003.2 (S), R5007.2, R5009.2, R5013.2, R5017.2, U5001.5 (V_{SS}), U5001.9 (EPAD), U5002.10 (TEST), U5002.21 (GND[2:0]), U5002.41 (GND[2:0]), U5002.45 (GND[2:0]), U5002.57 (EPAD), U5003.3 (GND), Y5001.2, Y5001.4
unnamed: J5001.1, R5006.2
unnamed: Q5001.3 (D), R5008.2, R5014.1
unnamed: R5012.1, U5002.52 (DDBUS6)
unnamed: R5016.1, U5002.48 (DDBUS3)
unnamed: TP5003.1, U5002.38 (CDBUS5)
unnamed: TP5005.1, U5002.39 (CDBUS6)
PP1V8_FTDI: C5007.1, C5008.1, C5013.1, C5014.1, U5002.2 (VCORE[1:0]), U5002.31 (VCORE[1:0]), U5002.43 (VREGOUT)
PP3V3: C5003.1, C5006.1, C5012.1, C5015.1, C5016.1, L5001.1, L5002.1, R5002.1, R5003.1, R5004.1, R5006.1, R5008.1, R5010.1, R5018.1, R5019.1, U5001.8 (V_{CC}), U5002.16 (VCCIO[2:0]), U5002.36 (VCCIO[2:0]), U5002.44 (VREGIN), U5002.50 (VCCIO[2:0]), U5003.5 (V_{CC})
PP3V3_FTDI_VPHY: C5004.1, C5010.1, L5001.2, U5002.5 (VPHY)
PP3V3_FTDI_VPLL: C5005.1, C5011.1, L5002.2, U5002.9 (VPLL)
PWREN_L: R5019.2, U5002.54 (PWREN_L), U5003.1 (A)
RECOVERY_MODE_ENTRY_L: R5016.2
RREF: R5007.1, U5002.6 (REF)
S0.UART.RX: NT5002.2
S0.UART.TX: NT5003.2
S1.UART.RX: NT5004.2
S1.UART.TX: NT5005.2
XTAL_IN: C5001.1, R5001.1, U5002.3 (OSCI), Y5001.3
XTAL_OUT: C5002.2, R5001.2, U5002.4 (OSCO), Y5001.1

Notes on the sheet:
- Deassert FTDI reset (if J5001 is present) - Enable the LVL shifter between FTDI and BMC - Steer USB2 Mux towards FTDI
EN_DEV_MODE = HIGH
Output low
N/A (we don't put FTDI in USB suspend)
FTDI enumerated by USB host
- Hold FTDI in reset (if J5001 is present) - Disable the LVL shifter between FTDI and BMC - Steer USB2 Mux towards PD Controller / BMC
TriState - PU
FTDI_RST_L = 1
FTDI in reset
FTDI_BMC_RST = 0
PWREN_L = 0
EN_DEV_MODE = LOW
FTDI_RST_L = 0
NOTE: Assert FORCE_BMC_RST_L to disable SPI engine while updating FWSPI with security boot fail
See SCU_TRAP_4 1 == Enable recovery boot (by default from UART) 0 == Disable recovery boot
PWREN_L
FTDI in USB suspend*
PWREN_L = 1
NOTE: Diode to prevent unconfigured FTDI to drive BMC_RST_L high
FTDI_BMC_RST = 1
