rivosinc/scampi/sch/gpio.kicad_sch

## KiCad design sch/gpio.kicad_sch (2025-05-27)

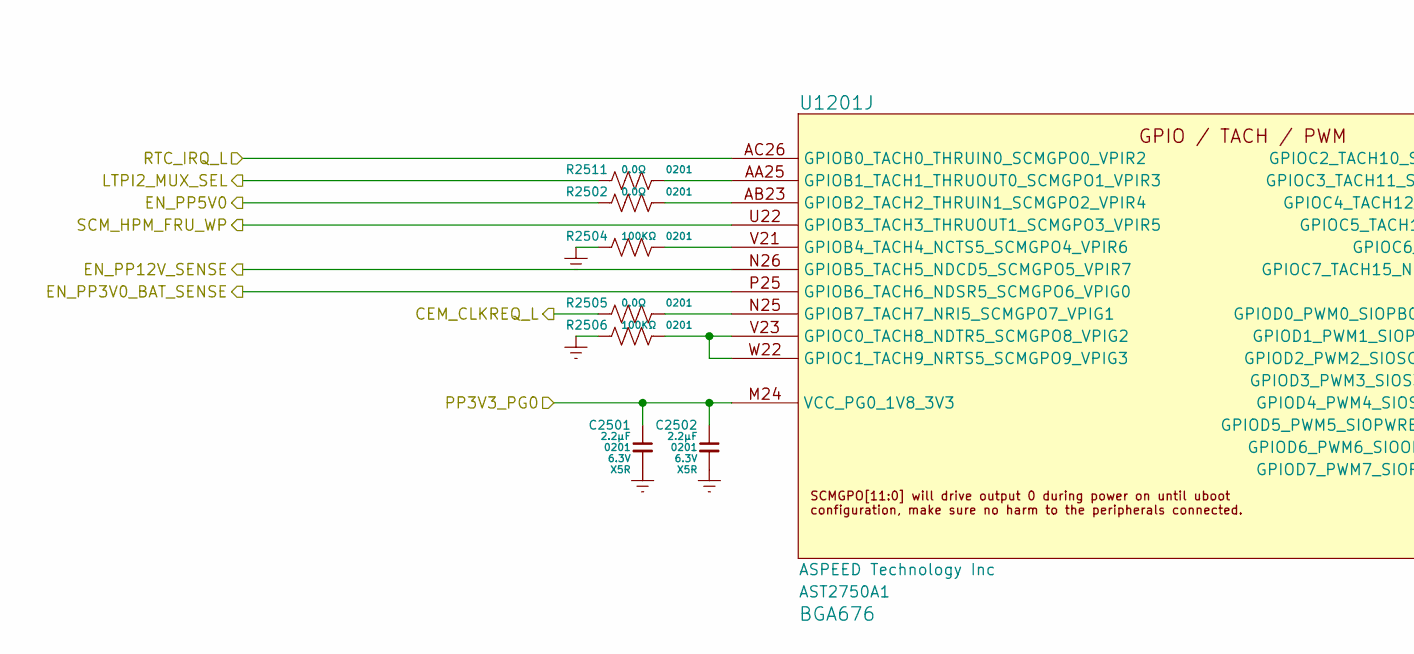
[picture p31: schematic gpio.kicad_sch, part in row 1, column 1]

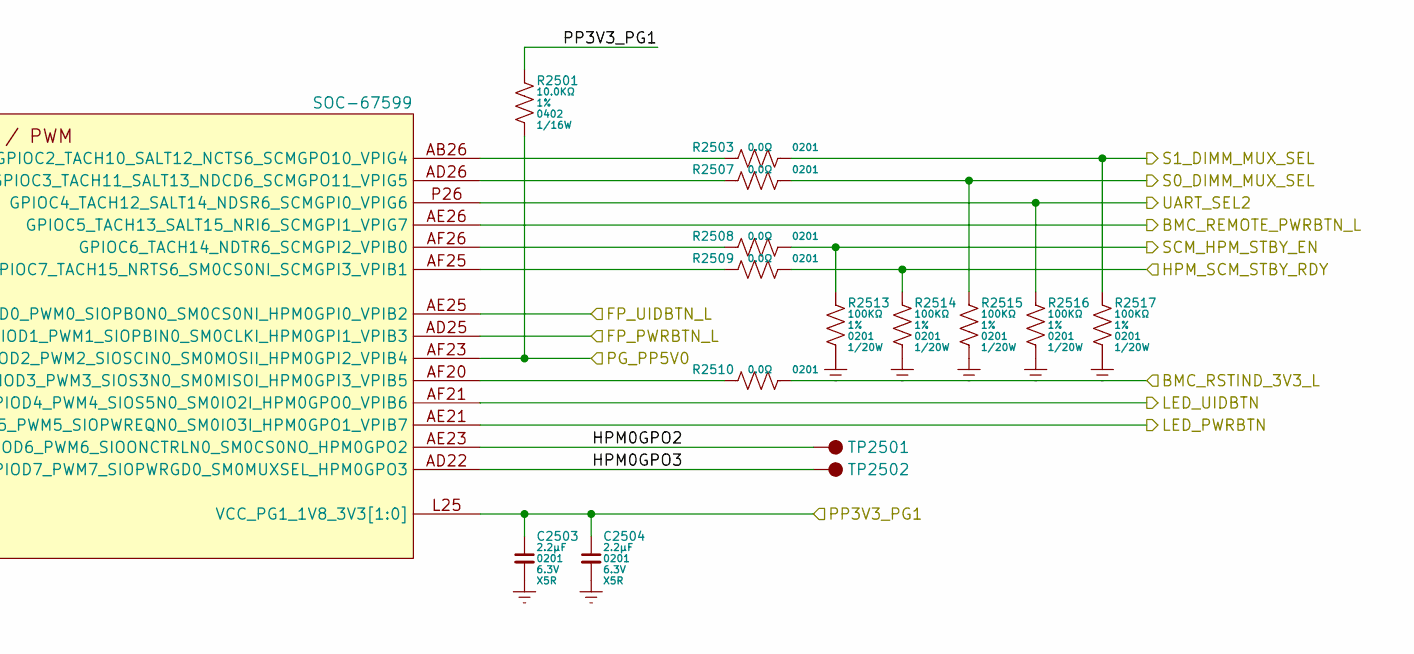
[picture p32: schematic gpio.kicad_sch, part in row 1, column 2]

Parts:
C2501, C2502, C2503, C2504: CCM-722AA; mpn GRM033R60J225ME01
R2501: RES-5100B
R2502, R2503, R2505, R2507, R2508, R2509, R2510, R2511: RES-0000A
R2504, R2506, R2513, R2514, R2515, R2516, R2517: RES-6100A
TP2501, TP2502: TST-01025
U1201: SOC-67599; mpn AST2750A1

Connections:
BMC_REMOTE_PWRBTN_L: U1201.AE26 (GPIOC5_TACH13_SALT15_NRI6_SCMGPI1_VPIG7)
BMC_RSTIND_3V3_L: R2510.2
CEM_CLKREQ_L: R2505.1
EN_PP3V0_BAT_SENSE: U1201.P25 (GPIOB6_TACH6_NDSR5_SCMGPO6_VPIG0)
EN_PP5V0: R2502.1
EN_PP12V_SENSE: U1201.N26 (GPIOB5_TACH5_NDCD5_SCMGPO5_VPIR7)
FP_PWRBTN_L: U1201.AD25 (GPIOD1_PWM1_SIOPBIN0_SM0CLKI_HPM0GPI1_V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)
FP_UIDBTN_L: U1201.AE25 (GPIOD0_PWM0_SIOPBON0_SM0CS0NI_HPM0GPI0_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)
GND: C2501.2, C2502.2, C2503.2, C2504.2, R2504.1, R2506.1, R2513.2, R2514.2, R2515.2, R2516.2, R2517.2
HPM0GPO2: TP2501.1, U1201.AE23 (GPIOD6_PWM6_SIOONCTRLN0_SM0CS0NO_HPM0GP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)
HPM0GPO3: TP2502.1, U1201.AD22 (GPIOD7_PWM7_SIOPWRGD0_SM0MUXSEL_HPM0GPO3)
HPM_SCM_STBY_RDY: R2509.2, R2514.1
LED_PWRBTN: U1201.AE21 (GPIOD5_PWM5_SIOPWREQN0_SM0IO3I_HPM0GPO1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)
LED_UIDBTN: U1201.AF21 (GPIOD4_PWM4_SIOS5N0_SM0IO2I_HPM0GPO0_VP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)
LTPI2_MUX_SEL: R2511.1
unnamed: R2502.2, U1201.AB23 (GPIOB2_TACH2_THRUIN1_SCMGPO2_VPIR4)
unnamed: R2503.1, U1201.AB26 (GPIOC2_TACH10_SALT12_NCTS6_SCMGPO10_VPI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)
unnamed: R2504.2, U1201.V21 (GPIOB4_TACH4_NCTS5_SCMGPO4_VPIR6)
unnamed: R2505.2, U1201.N25 (GPIOB7_TACH7_NRI5_SCMGPO7_VPIG1)
unnamed: R2506.2, U1201.V23 (GPIOC0_TACH8_NDTR5_SCMGPO8_VPIG2), U1201.W22 (GPIOC1_TACH9_NRTS5_SCMGPO9_VPIG3)
unnamed: R2507.1, U1201.AD26 (GPIOC3_TACH11_SALT13_NDCD6_SCMGPO11_VPI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)
unnamed: R2508.1, U1201.AF26 (GPIOC6_TACH14_NDTR6_SCMGPI2_VPIB0)
unnamed: R2509.1, U1201.AF25 (GPIOC7_TACH15_NRTS6_SM0CS0NI_SCMGPI3_VP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)
unnamed: R2510.1, U1201.AF20 (GPIOD3_PWM3_SIOS3N0_SM0MISOI_HPM0GPI3_V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)
unnamed: R2511.2, U1201.AA25 (GPIOB1_TACH1_THRUOUT0_SCMGPO1_VPIR3)
PG_PP5V0: R2501.2, U1201.AF23 (GPIOD2_PWM2_SIOSCIN0_SM0MOSII_HPM0GPI2_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)
PP3V3_PG0: C2501.1, C2502.1, U1201.M24 (VCC_PG0_1V8_3V3)
PP3V3_PG1: C2503.1, C2504.1, R2501.1, U1201.L25 (VCC_PG1_1V8_3V3[1:0]), U1201.M25 (VCC_PG1_1V8_3V3[1:0])
RTC_IRQ_L: U1201.AC26 (GPIOB0_TACH0_THRUIN0_SCMGPO0_VPIR2)
S0_DIMM_MUX_SEL: R2507.2, R2515.1
S1_DIMM_MUX_SEL: R2503.2, R2517.1
SCM_HPM_FRU_WP: U1201.U22 (GPIOB3_TACH3_THRUOUT1_SCMGPO3_VPIR5)
SCM_HPM_STBY_EN: R2508.2, R2513.1
UART_SEL2: R2516.1, U1201.P26 (GPIOC4_TACH12_SALT14_NDSR6_SCMGPI0_VPIG6)
