rivosinc/scampi/sch/i2c.kicad_sch

## KiCad design sch/i2c.kicad_sch (2025-05-27)

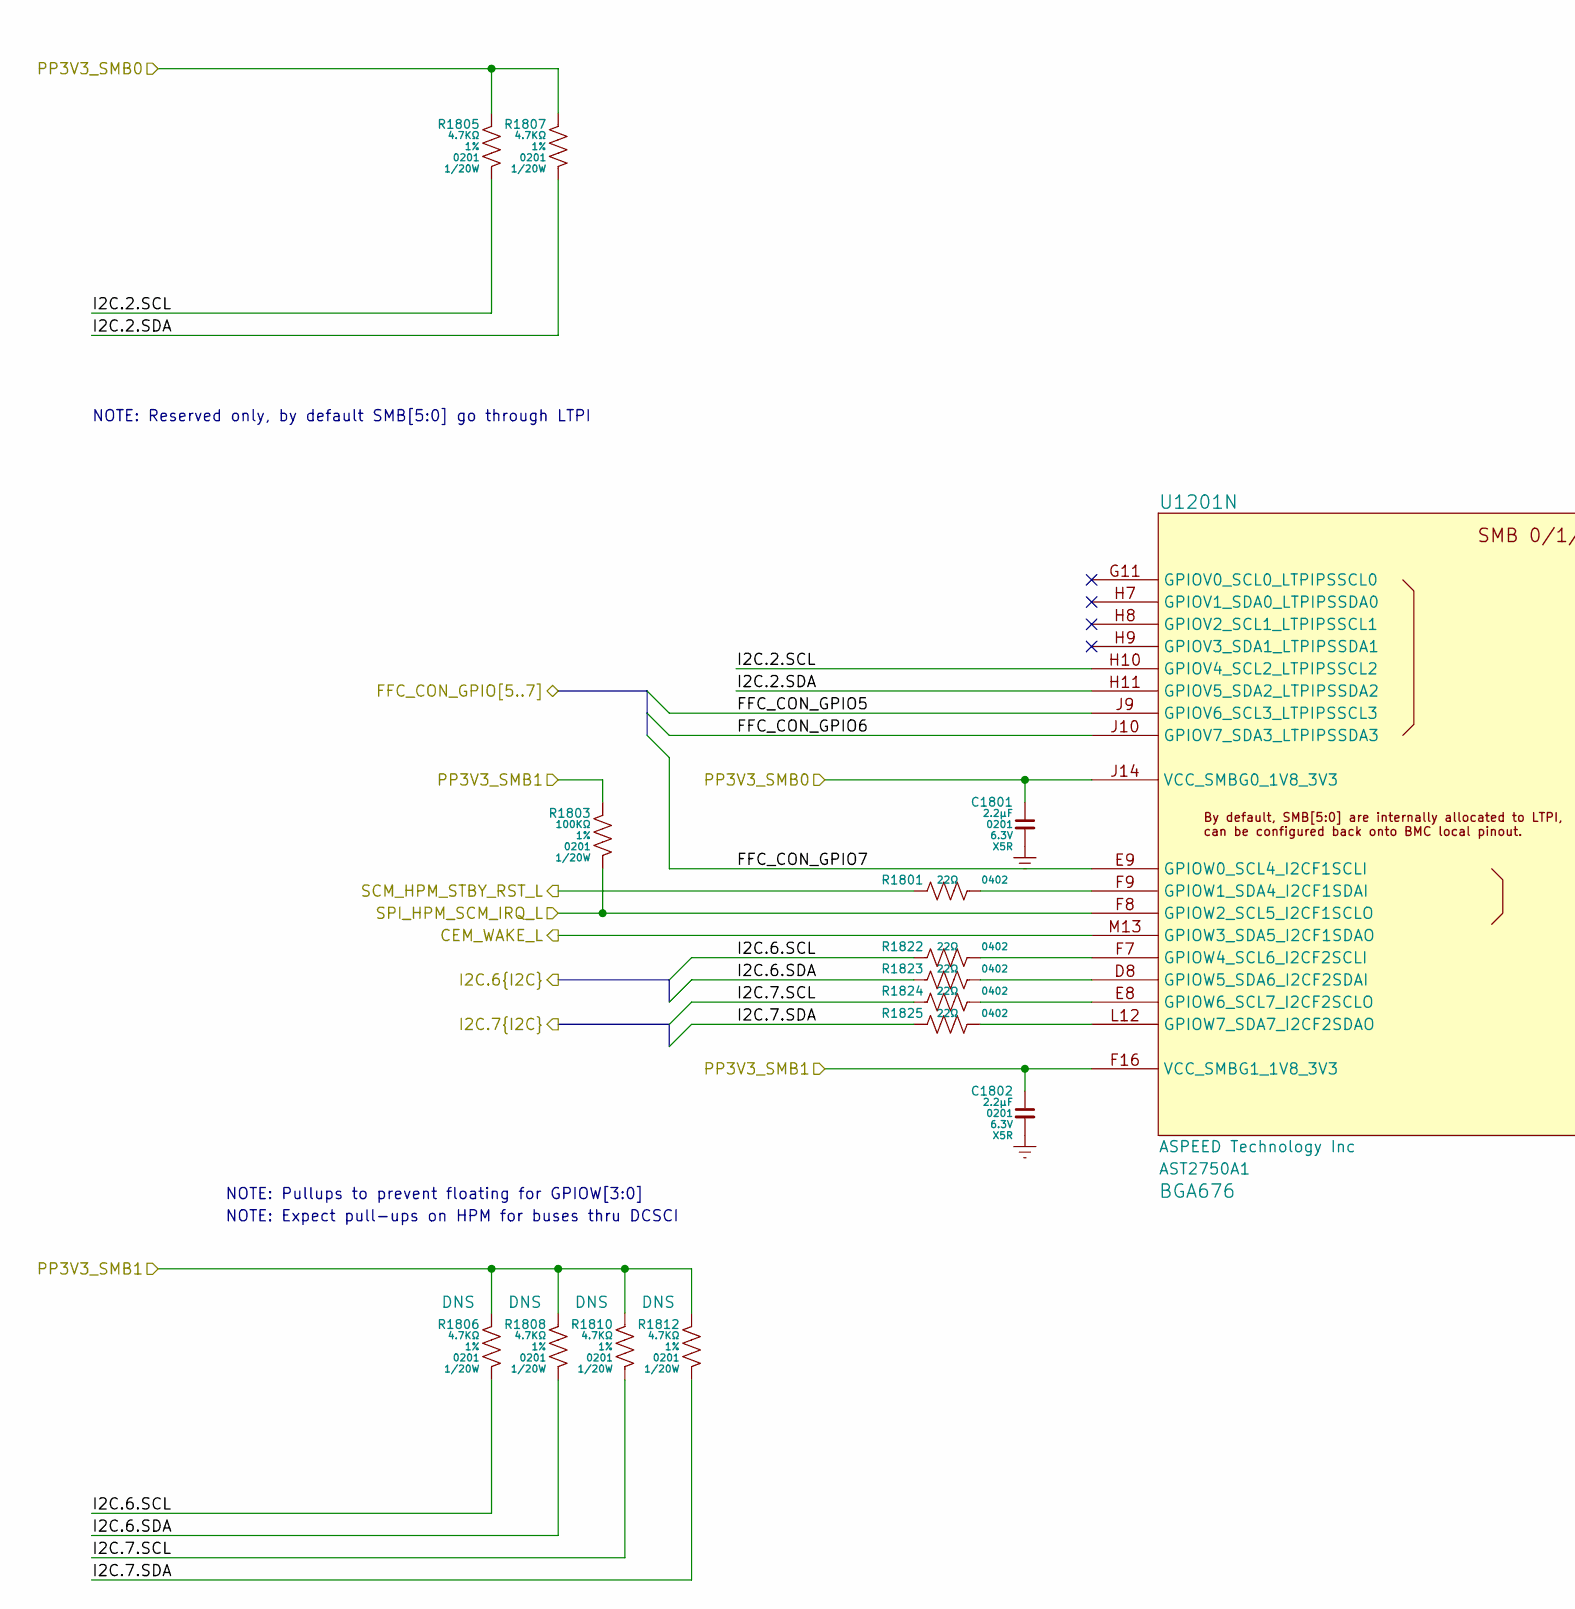
[picture p33: schematic i2c.kicad_sch, part in row 1, column 1]

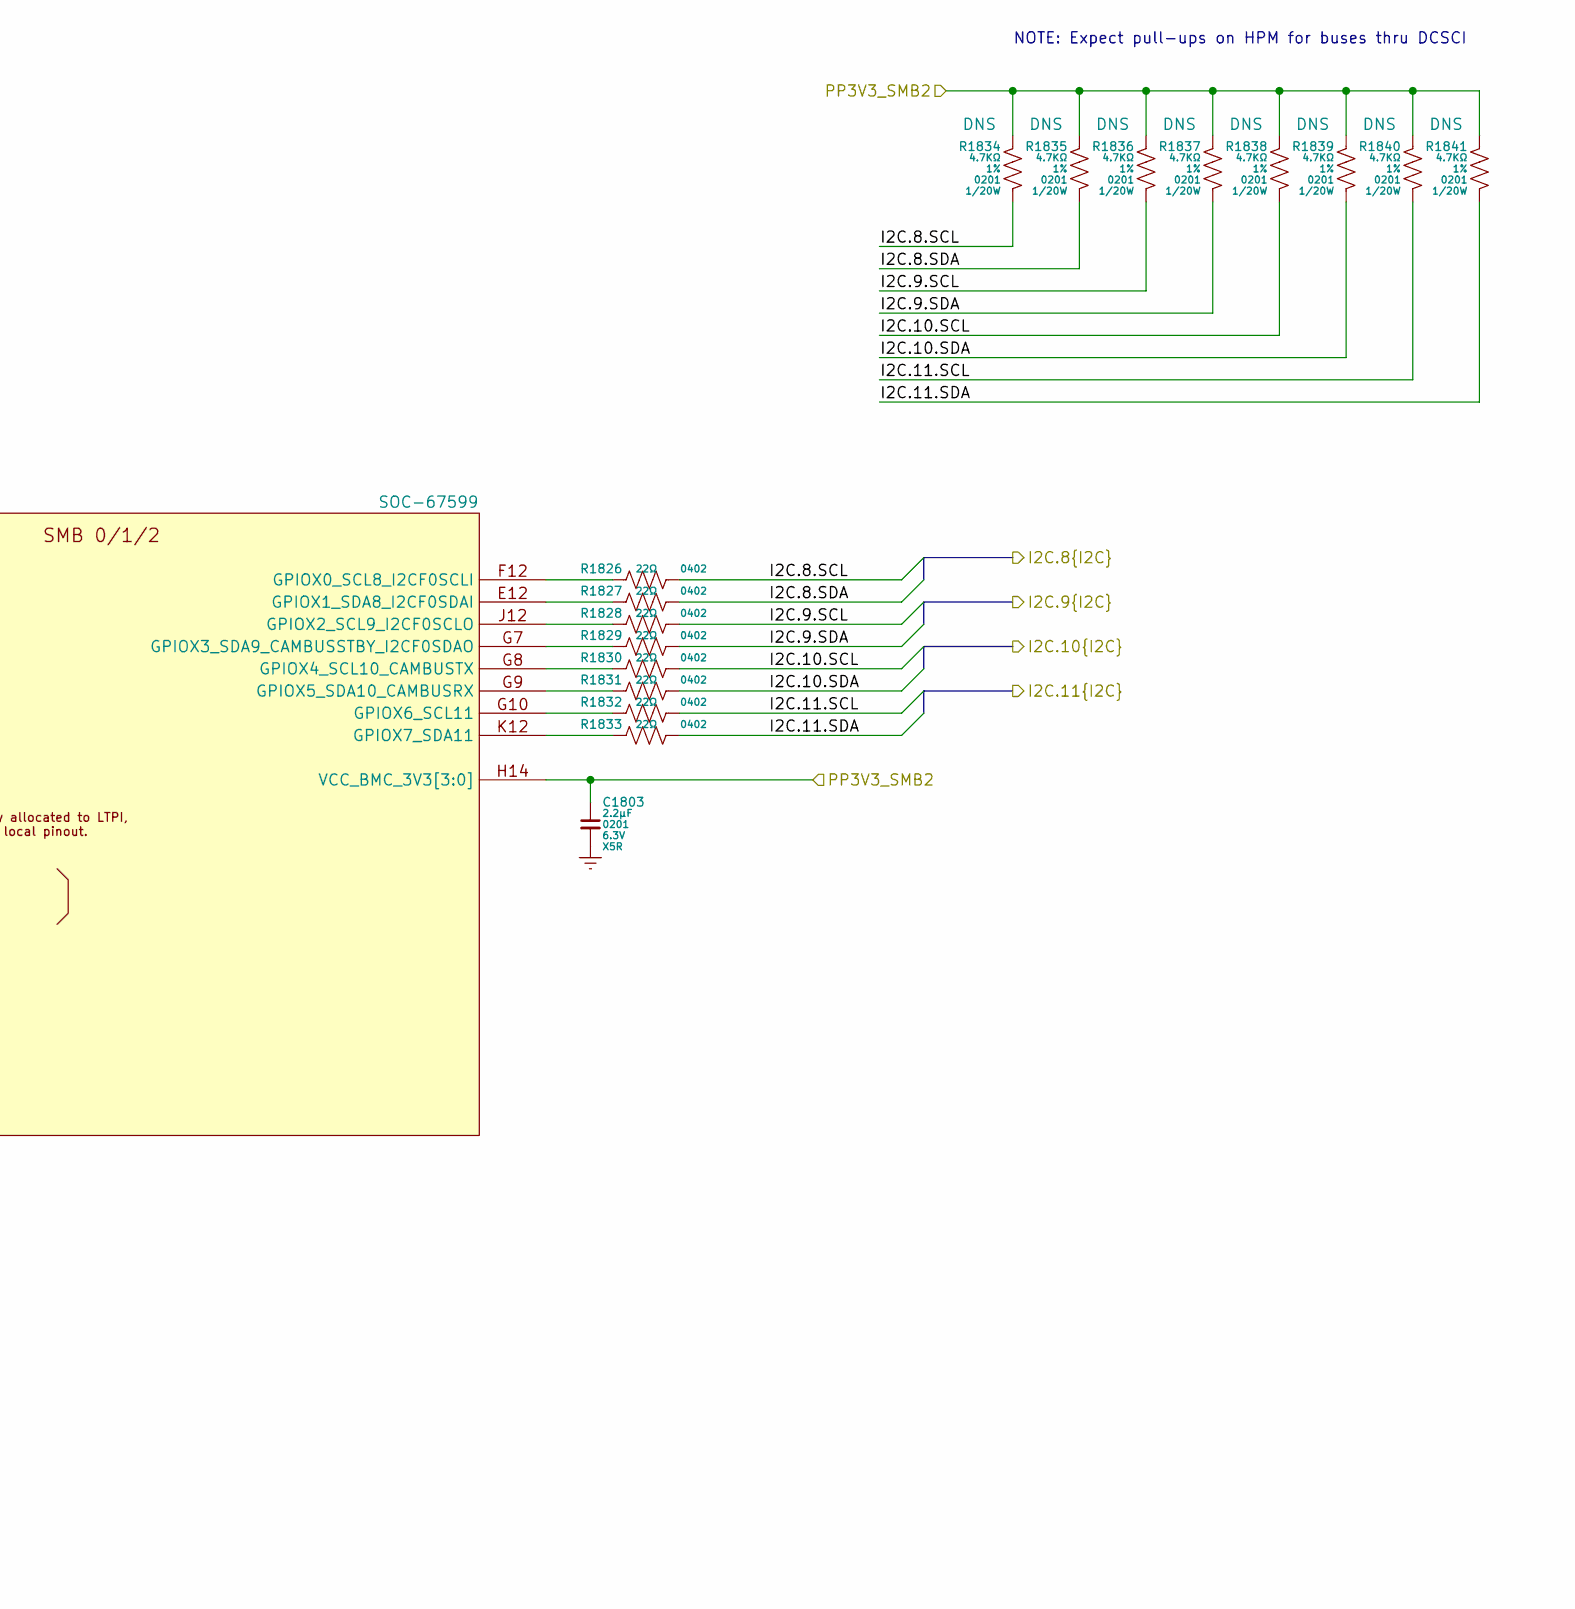
[picture p34: schematic i2c.kicad_sch, part in row 1, column 2]

Parts:
C1801, C1802, C1803: CCM-722AA; mpn GRM033R60J225ME01
R1801, R1822, R1823, R1824, R1825, R1826, R1827, R1828, R1829, R1830, R1831, R1832, R1833: RES-2220B
R1803: RES-6100A
R1805, R1806, R1807, R1808, R1810, R1812, R1834, R1835, R1836, R1837, R1838, R1839, R1840, R1841: RES-4470A
U1201: SOC-67599; mpn AST2750A1

Connections:
CEM_WAKE_L: U1201.M13 (GPIOW3_SDA5_I2CF1SDAO)
FFC_CON_GPIO5: U1201.J9 (GPIOV6_SCL3_LTPIPSSCL3)
FFC_CON_GPIO6: U1201.J10 (GPIOV7_SDA3_LTPIPSSDA3)
FFC_CON_GPIO7: U1201.E9 (GPIOW0_SCL4_I2CF1SCLI)
GND: C1801.2, C1802.2, C1803.2
I2C.2.SCL: R1805.2, U1201.H10 (GPIOV4_SCL2_LTPIPSSCL2)
I2C.2.SDA: R1807.2, U1201.H11 (GPIOV5_SDA2_LTPIPSSDA2)
I2C.6.SCL: R1806.2, R1822.1
I2C.6.SDA: R1808.2, R1823.1
I2C.7.SCL: R1810.2, R1824.1
I2C.7.SDA: R1812.2, R1825.1
I2C.8.SCL: R1826.2, R1834.2
I2C.8.SDA: R1827.2, R1835.2
I2C.9.SCL: R1828.2, R1836.2
I2C.9.SDA: R1829.2, R1837.2
I2C.10.SCL: R1830.2, R1838.2
I2C.10.SDA: R1831.2, R1839.2
I2C.11.SCL: R1832.2, R1840.2
I2C.11.SDA: R1833.2, R1841.2
unnamed: R1801.2, U1201.F9 (GPIOW1_SDA4_I2CF1SDAI)
unnamed: R1822.2, U1201.F7 (GPIOW4_SCL6_I2CF2SCLI)
unnamed: R1823.2, U1201.D8 (GPIOW5_SDA6_I2CF2SDAI)
unnamed: R1824.2, U1201.E8 (GPIOW6_SCL7_I2CF2SCLO)
unnamed: R1825.2, U1201.L12 (GPIOW7_SDA7_I2CF2SDAO)
unnamed: R1826.1, U1201.F12 (GPIOX0_SCL8_I2CF0SCLI)
unnamed: R1827.1, U1201.E12 (GPIOX1_SDA8_I2CF0SDAI)
unnamed: R1828.1, U1201.J12 (GPIOX2_SCL9_I2CF0SCLO)
unnamed: R1829.1, U1201.G7 (GPIOX3_SDA9_CAMBUSSTBY_I2CF0SDAO)
unnamed: R1830.1, U1201.G8 (GPIOX4_SCL10_CAMBUSTX)
unnamed: R1831.1, U1201.G9 (GPIOX5_SDA10_CAMBUSRX)
unnamed: R1832.1, U1201.G10 (GPIOX6_SCL11)
unnamed: R1833.1, U1201.K12 (GPIOX7_SDA11)
PP3V3_SMB0: C1801.1, R1805.1, R1807.1, U1201.J14 (VCC_SMBG0_1V8_3V3)
PP3V3_SMB1: C1802.1, R1803.1, R1806.1, R1808.1, R1810.1, R1812.1, U1201.F16 (VCC_SMBG1_1V8_3V3)
PP3V3_SMB2: C1803.1, R1834.1, R1835.1, R1836.1, R1837.1, R1838.1, R1839.1, R1840.1, R1841.1, U1201.H14 (VCC_BMC_3V3[3:0])
SCM_HPM_STBY_RST_L: R1801.1
SPI_HPM_SCM_IRQ_L: R1803.2, U1201.F8 (GPIOW2_SCL5_I2CF1SCLO)

Notes on the sheet:
NOTE: Reserved only, by default SMB[5:0] go through LTPI
NOTE: Expect pull-ups on HPM for buses thru DCSCI
NOTE: Pullups to prevent floating for GPIOW[3:0]
