rivosinc/scampi/sch/i3c.kicad_sch

## KiCad design sch/i3c.kicad_sch (2025-05-27)

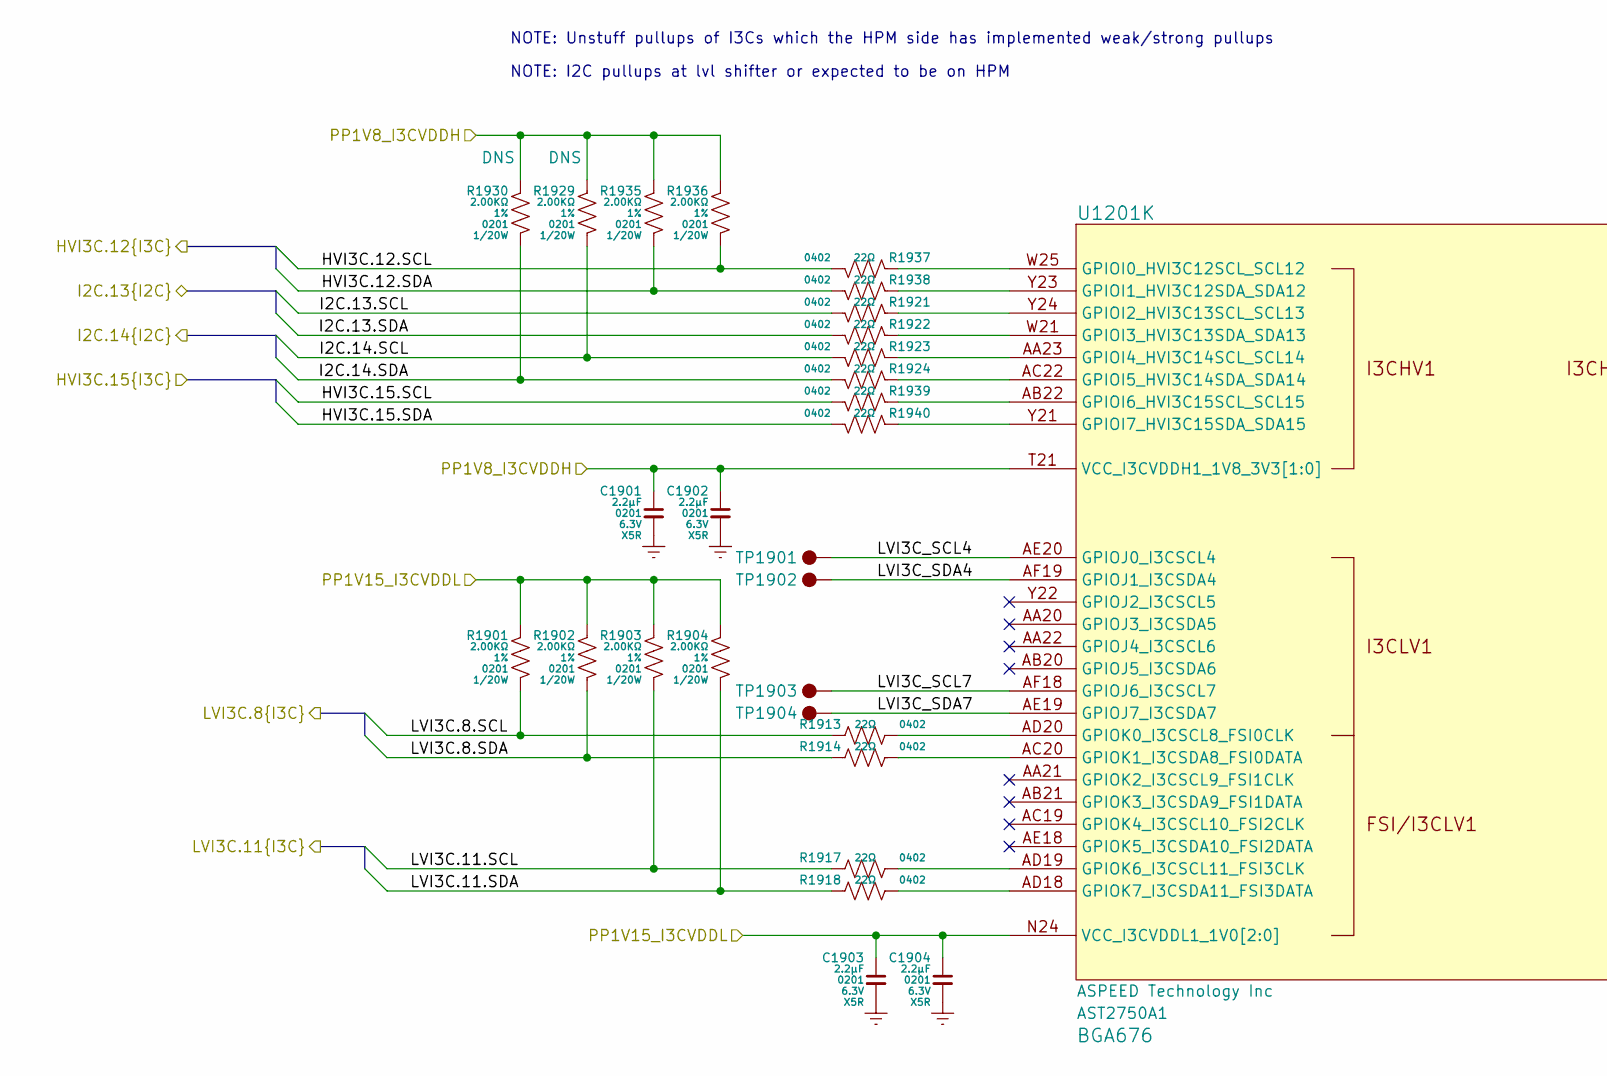
[picture p35: schematic i3c.kicad_sch, part in row 1, column 1]

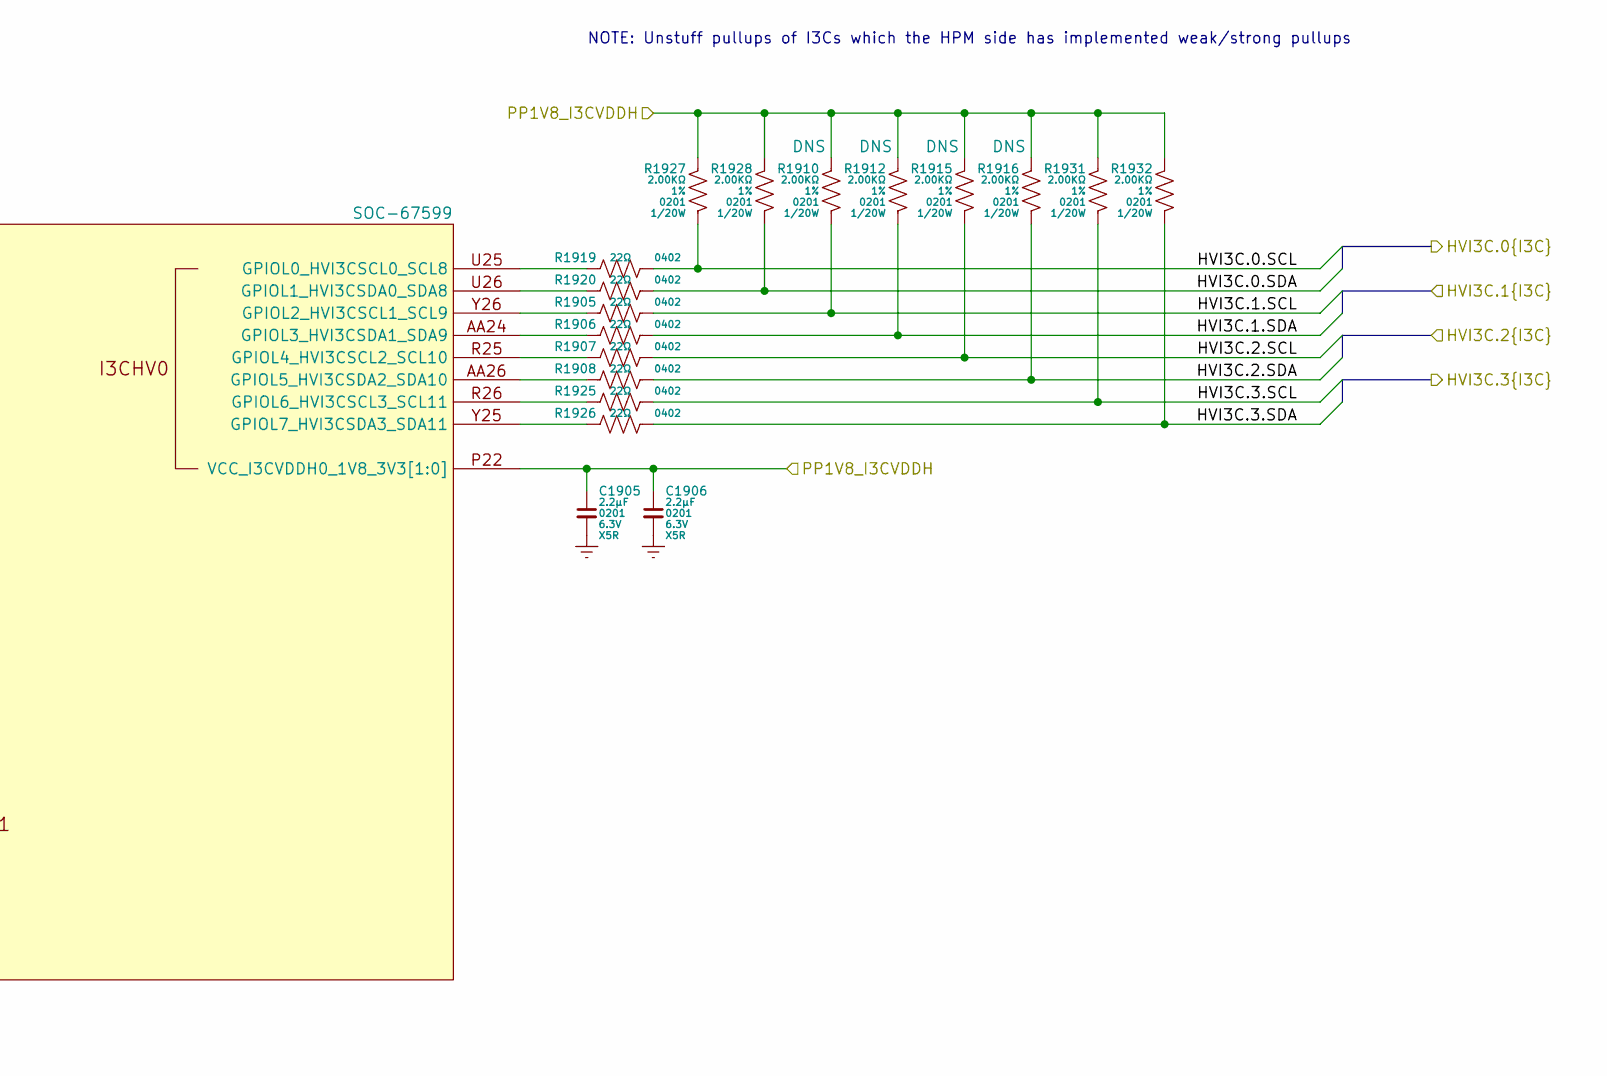
[picture p36: schematic i3c.kicad_sch, part in row 1, column 2]

Parts:
C1901, C1902, C1903, C1904, C1905, C1906: CCM-722AA; mpn GRM033R60J225ME01
R1901, R1902, R1903, R1904, R1910, R1912, R1915, R1916, R1927, R1928, R1929, R1930, R1931, R1932, R1935, R1936: RES-4200A
R1905, R1906, R1907, R1908, R1913, R1914, R1917, R1918, R1919, R1920, R1921, R1922, R1923, R1924, R1925, R1926, R1937, R1938, R1939, R1940: RES-2220B
TP1901, TP1902, TP1903, TP1904: TST-01025
U1201: SOC-67599; mpn AST2750A1

Connections:
GND: C1901.2, C1902.2, C1903.2, C1904.2, C1905.2, C1906.2
HVI3C.0.SCL: R1919.2, R1927.2
HVI3C.0.SDA: R1920.2, R1928.2
HVI3C.1.SCL: R1905.2, R1910.2
HVI3C.1.SDA: R1906.2, R1912.2
HVI3C.2.SCL: R1907.2, R1915.2
HVI3C.2.SDA: R1908.2, R1916.2
HVI3C.3.SCL: R1925.2, R1931.2
HVI3C.3.SDA: R1926.2, R1932.2
HVI3C.12.SCL: R1936.2, R1937.2
HVI3C.12.SDA: R1935.2, R1938.2
HVI3C.15.SCL: R1939.2
HVI3C.15.SDA: R1940.2
I2C.13.SCL: R1921.2
I2C.13.SDA: R1922.2
I2C.14.SCL: R1923.2, R1929.2
I2C.14.SDA: R1924.2, R1930.2
LVI3C.8.SCL: R1901.2, R1913.1
LVI3C.8.SDA: R1902.2, R1914.1
LVI3C.11.SCL: R1903.2, R1917.1
LVI3C.11.SDA: R1904.2, R1918.1
LVI3C_SCL4: TP1901.1, U1201.AE20 (GPIOJ0_I3CSCL4)
LVI3C_SCL7: TP1903.1, U1201.AF18 (GPIOJ6_I3CSCL7)
LVI3C_SDA4: TP1902.1, U1201.AF19 (GPIOJ1_I3CSDA4)
LVI3C_SDA7: TP1904.1, U1201.AE19 (GPIOJ7_I3CSDA7)
unnamed: R1905.1, U1201.Y26 (GPIOL2_HVI3CSCL1_SCL9)
unnamed: R1906.1, U1201.AA24 (GPIOL3_HVI3CSDA1_SDA9)
unnamed: R1907.1, U1201.R25 (GPIOL4_HVI3CSCL2_SCL10)
unnamed: R1908.1, U1201.AA26 (GPIOL5_HVI3CSDA2_SDA10)
unnamed: R1913.2, U1201.AD20 (GPIOK0_I3CSCL8_FSI0CLK)
unnamed: R1914.2, U1201.AC20 (GPIOK1_I3CSDA8_FSI0DATA)
unnamed: R1917.2, U1201.AD19 (GPIOK6_I3CSCL11_FSI3CLK)
unnamed: R1918.2, U1201.AD18 (GPIOK7_I3CSDA11_FSI3DATA)
unnamed: R1919.1, U1201.U25 (GPIOL0_HVI3CSCL0_SCL8)
unnamed: R1920.1, U1201.U26 (GPIOL1_HVI3CSDA0_SDA8)
unnamed: R1921.1, U1201.Y24 (GPIOI2_HVI3C13SCL_SCL13)
unnamed: R1922.1, U1201.W21 (GPIOI3_HVI3C13SDA_SDA13)
unnamed: R1923.1, U1201.AA23 (GPIOI4_HVI3C14SCL_SCL14)
unnamed: R1924.1, U1201.AC22 (GPIOI5_HVI3C14SDA_SDA14)
unnamed: R1925.1, U1201.R26 (GPIOL6_HVI3CSCL3_SCL11)
unnamed: R1926.1, U1201.Y25 (GPIOL7_HVI3CSDA3_SDA11)
unnamed: R1937.1, U1201.W25 (GPIOI0_HVI3C12SCL_SCL12)
unnamed: R1938.1, U1201.Y23 (GPIOI1_HVI3C12SDA_SDA12)
unnamed: R1939.1, U1201.AB22 (GPIOI6_HVI3C15SCL_SCL15)
unnamed: R1940.1, U1201.Y21 (GPIOI7_HVI3C15SDA_SDA15)
PP1V8_I3CVDDH: C1901.1, C1902.1, C1905.1, C1906.1, R1910.1, R1912.1, R1915.1, R1916.1, R1927.1, R1928.1, R1929.1, R1930.1, R1931.1, R1932.1, R1935.1, R1936.1, U1201.P22 (VCC_I3CVDDH0_1V8_3V3[1:0]), U1201.P23 (VCC_I3CVDDH0_1V8_3V3[1:0]), U1201.T21 (VCC_I3CVDDH1_1V8_3V3[1:0]), U1201.T22 (VCC_I3CVDDH1_1V8_3V3[1:0])
PP1V15_I3CVDDL: C1903.1, C1904.1, R1901.1, R1902.1, R1903.1, R1904.1, U1201.N24 (VCC_I3CVDDL1_1V0[2:0]), U1201.P24 (VCC_I3CVDDL1_1V0[2:0]), U1201.R24 (VCC_I3CVDDL1_1V0[2:0])

Notes on the sheet:
NOTE: I2C pullups at lvl shifter or expected to be on HPM
NOTE: Unstuff pullups of I3Cs which the HPM side has implemented weak/strong pullups
