rivosinc/scampi/sch/i3c_lvl_shift.kicad_sch

## KiCad design sch/i3c_lvl_shift.kicad_sch (2025-05-27)

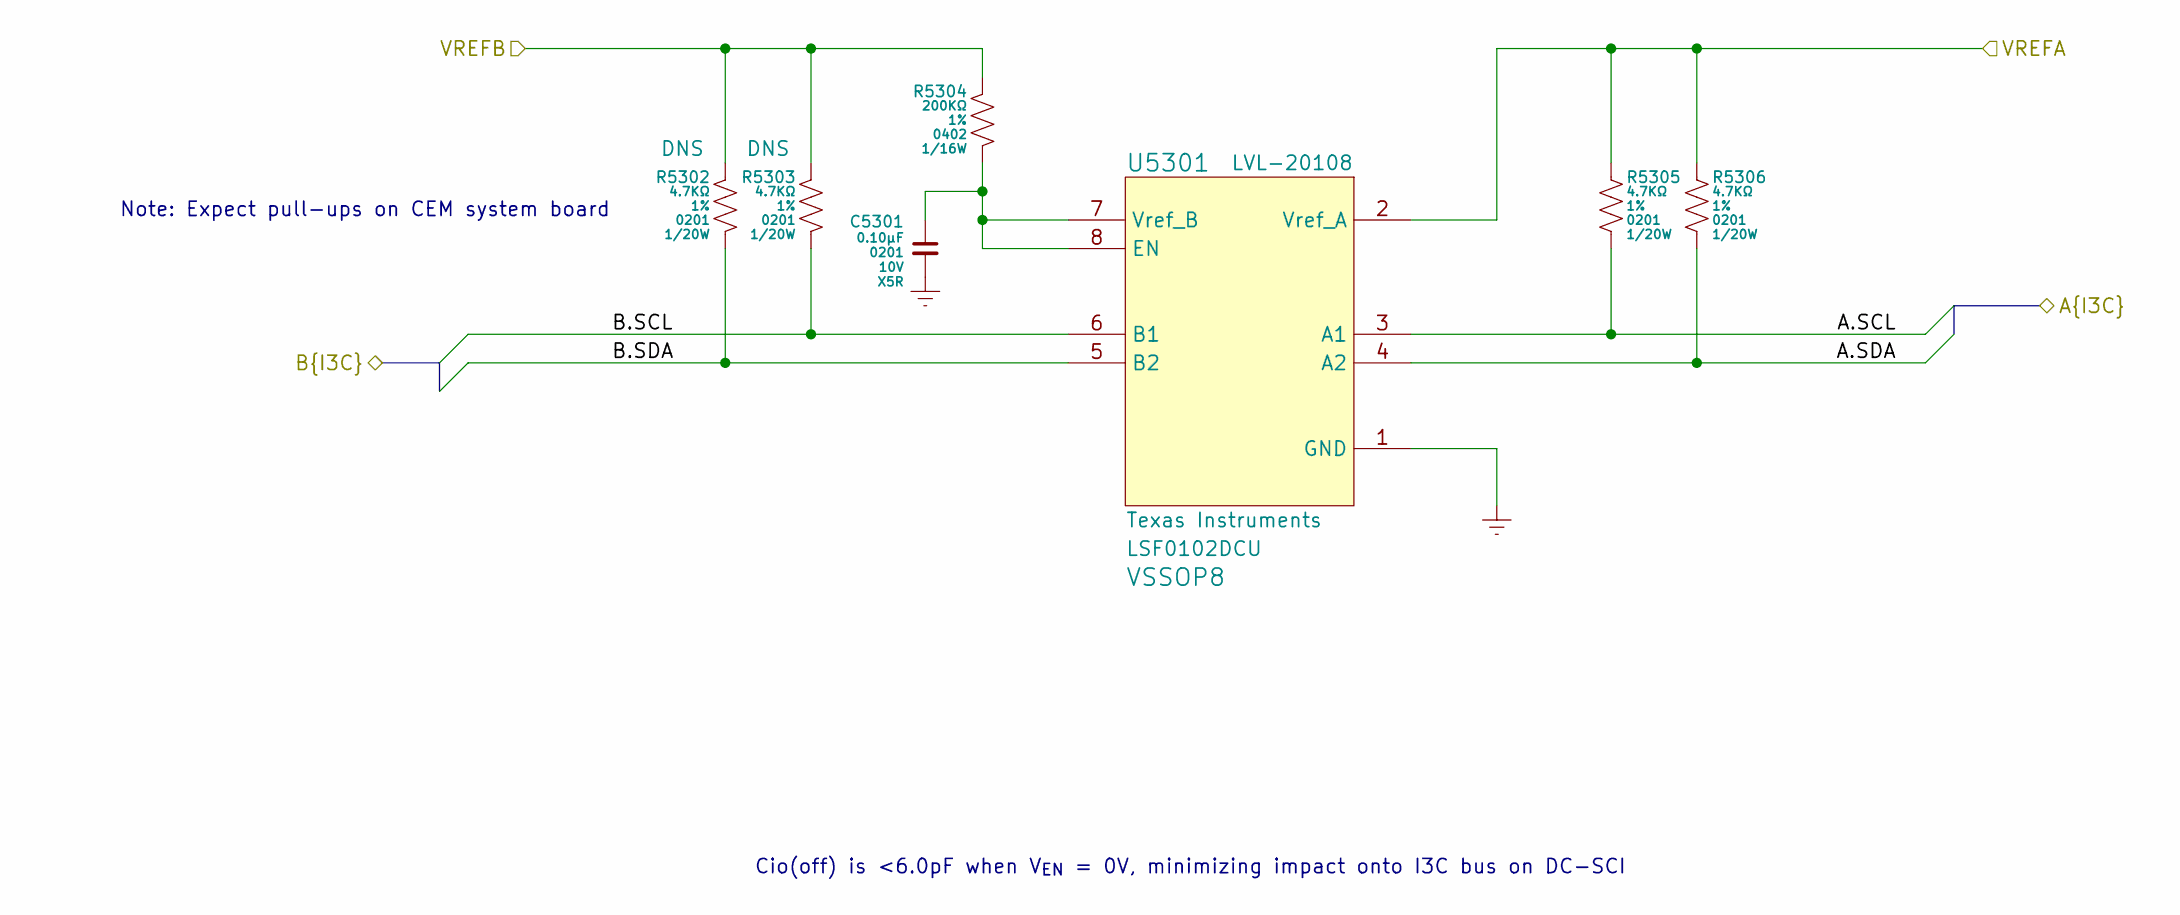
[picture p37: schematic i3c_lvl_shift.kicad_sch]

Parts:
C5301: CCM-610AA; mpn GRM033R61A104ME15
R5302, R5303, R5305, R5306: RES-4470A
R5304: RES-6200B
U5301: LVL-20108; mpn LSF0102DCU

Connections:
A.SCL: R5305.2, U5301.3 (A1)
A.SDA: R5306.2, U5301.4 (A2)
B.SCL: R5303.2, U5301.6 (B1)
B.SDA: R5302.2, U5301.5 (B2)
GND: C5301.2, U5301.1 (GND)
unnamed: C5301.1, R5304.2, U5301.7 (Vref_B), U5301.8 (EN)
VREFA: R5305.1, R5306.1, U5301.2 (Vref_A)
VREFB: R5302.1, R5303.1, R5304.1

Notes on the sheet:
Note: Expect pull-ups on CEM system board
Cio(off) is <6.0pF when V_{EN} = 0V, minimizing impact onto I3C bus on DC-SCI
