rivosinc/scampi/sch/ltpi2_mux.kicad_sch

## KiCad design sch/ltpi2_mux.kicad_sch (2025-05-27)

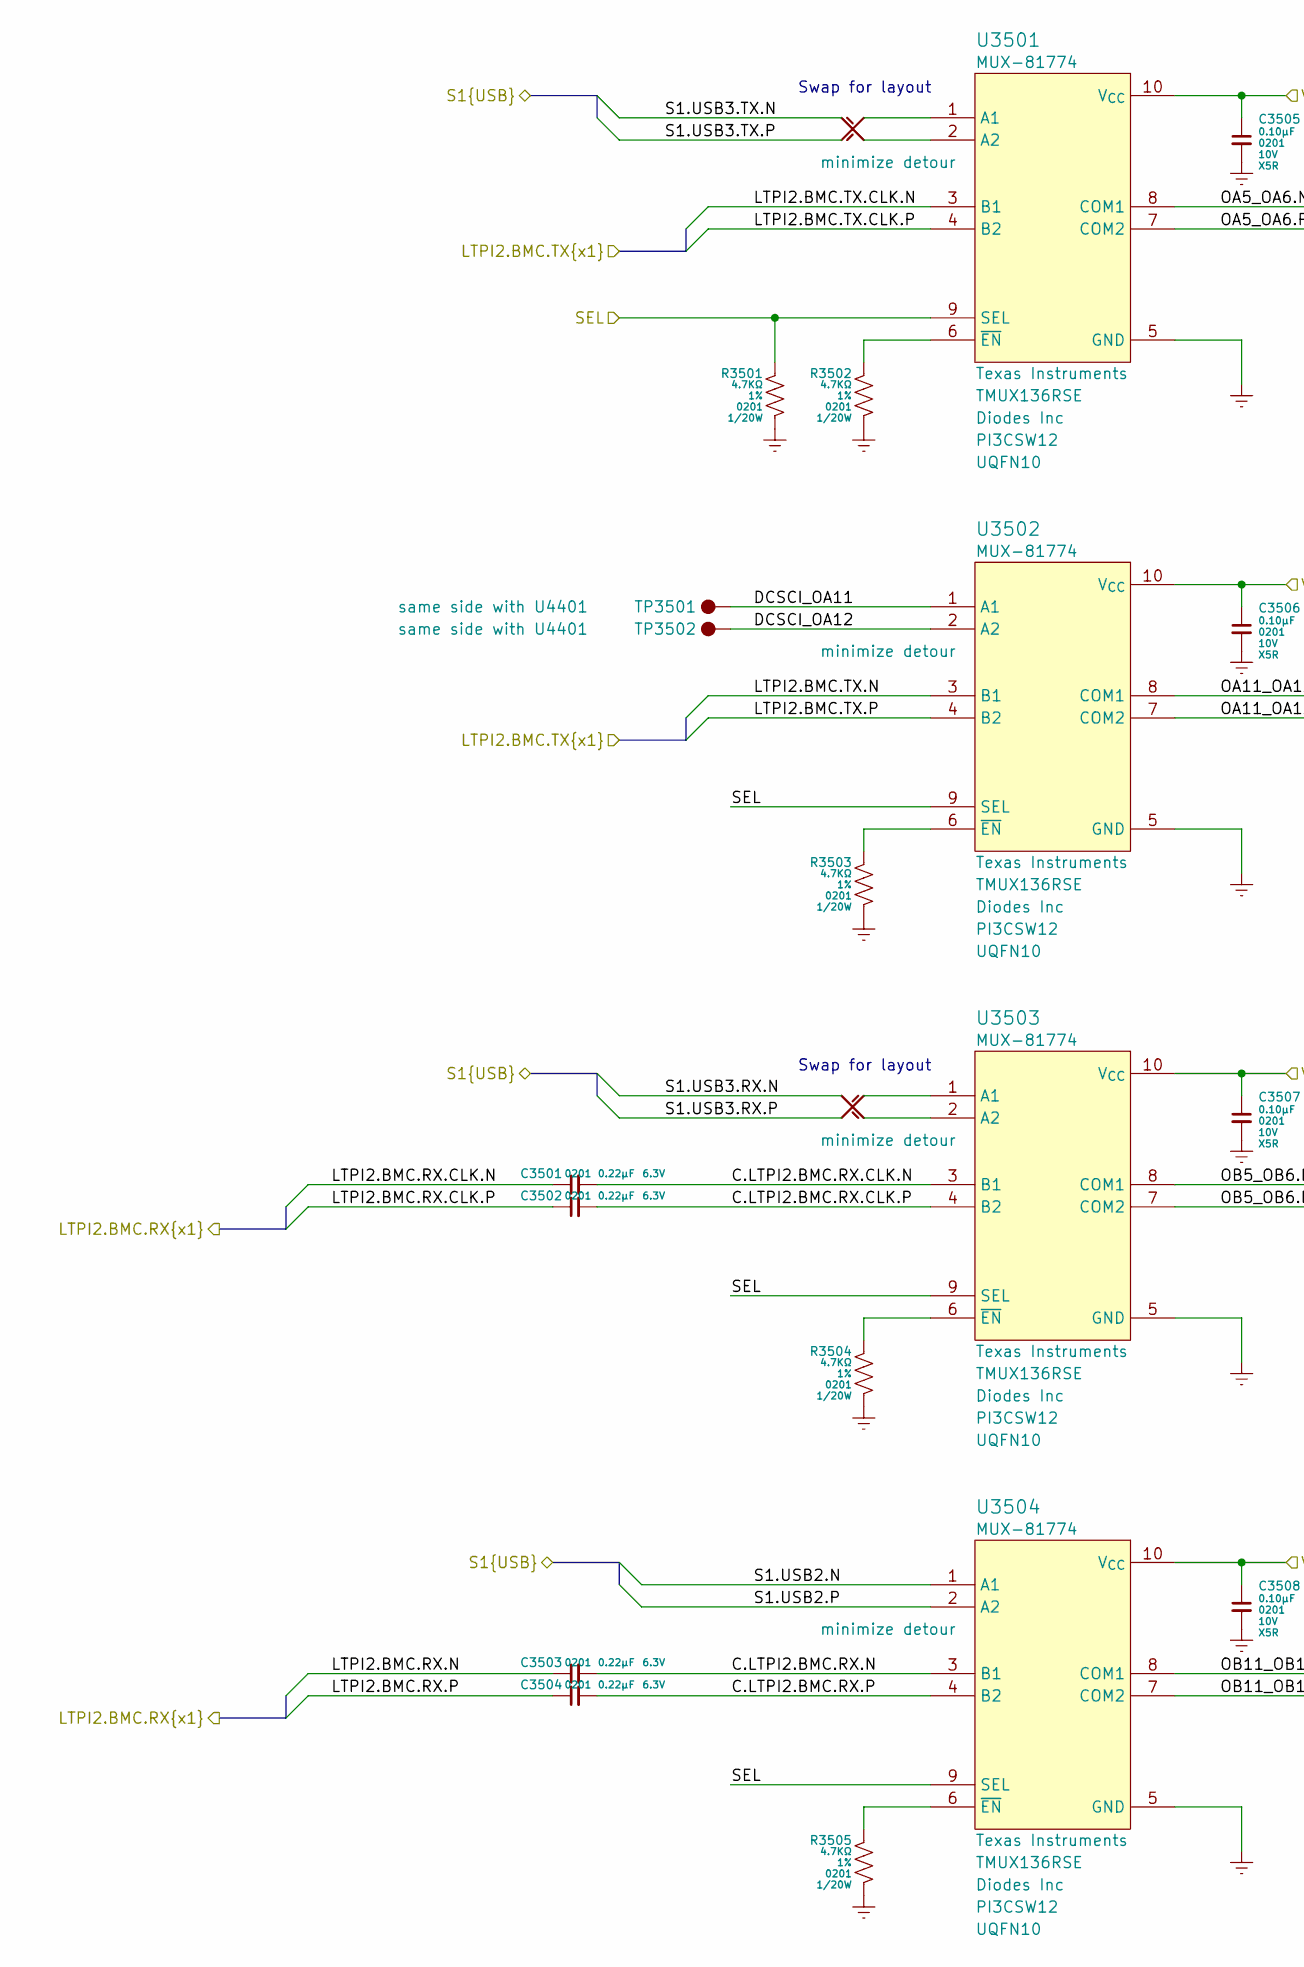
[picture p38: schematic ltpi2_mux.kicad_sch, part in row 1, column 1]

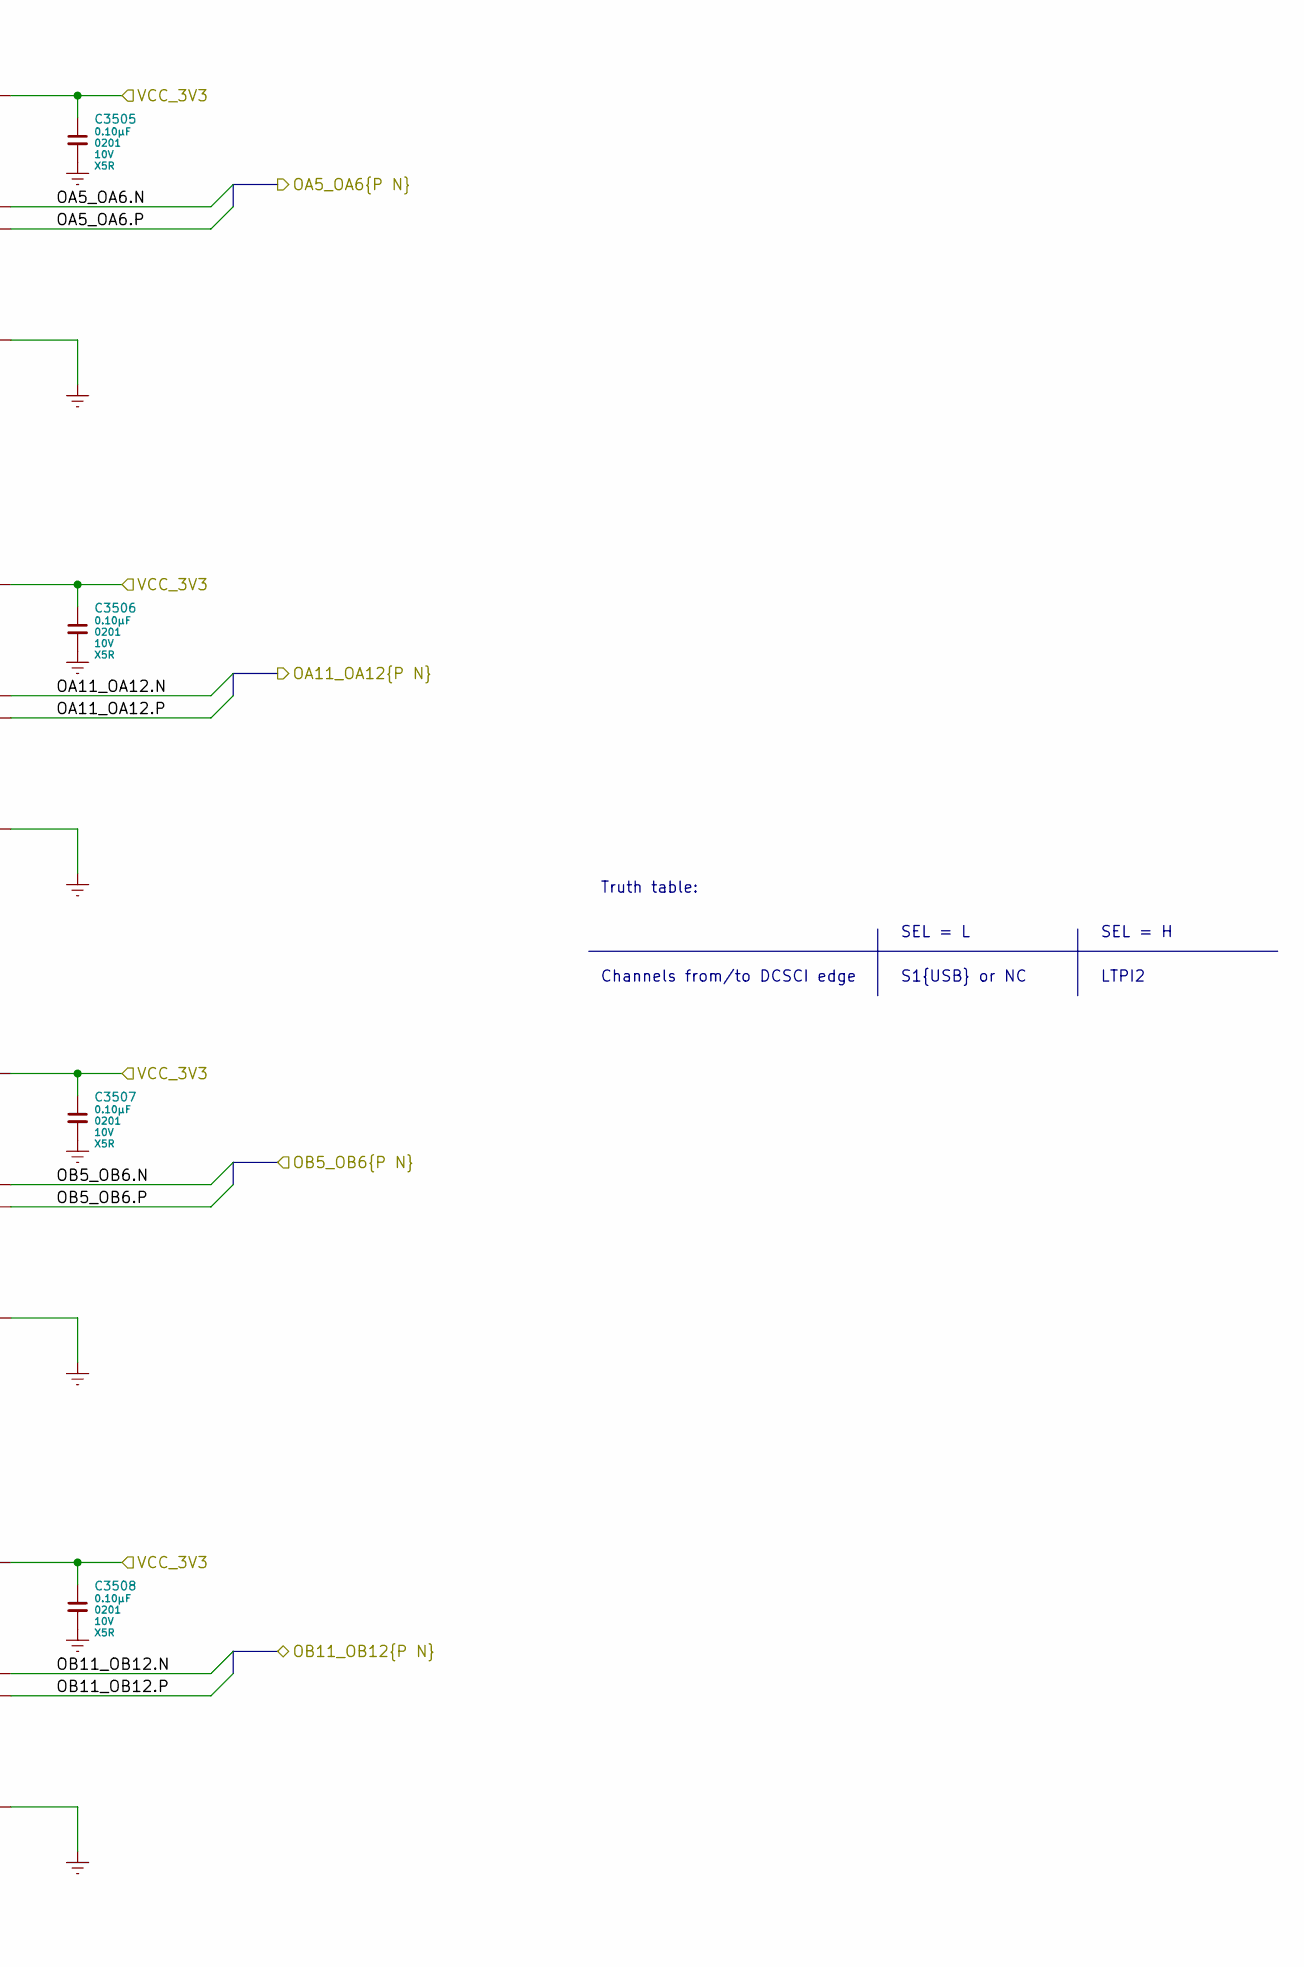
[picture p39: schematic ltpi2_mux.kicad_sch, part in row 1, column 2]

Parts:
C3501, C3502, C3503, C3504: CCM-622AA; mpn GRM033R60J224ME15
C3505, C3506, C3507, C3508: CCM-610AA; mpn GRM033R61A104ME15
NT3503, NT3504: NET-20002
R3501, R3502, R3503, R3504, R3505: RES-4470A
TP3501, TP3502: TST-01025
U3501, U3502, U3503, U3504: MUX-81774; mpn TMUX136RSE

Connections:
C.LTPI2.BMC.RX.CLK.N: C3501.2, U3503.3 (B1)
C.LTPI2.BMC.RX.CLK.P: C3502.2, U3503.4 (B2)
C.LTPI2.BMC.RX.N: C3503.2, U3504.3 (B1)
C.LTPI2.BMC.RX.P: C3504.2, U3504.4 (B2)
DCSCI_OA11: TP3501.1, U3502.1 (A1)
DCSCI_OA12: TP3502.1, U3502.2 (A2)
GND: C3505.2, C3506.2, C3507.2, C3508.2, R3501.2, R3502.2, R3503.2, R3504.2, R3505.2, U3501.5 (GND), U3502.5 (GND), U3503.5 (GND), U3504.5 (GND)
LTPI2.BMC.RX.CLK.N: C3501.1
LTPI2.BMC.RX.CLK.P: C3502.1
LTPI2.BMC.RX.N: C3503.1
LTPI2.BMC.RX.P: C3504.1
LTPI2.BMC.TX.CLK.N: U3501.3 (B1)
LTPI2.BMC.TX.CLK.P: U3501.4 (B2)
LTPI2.BMC.TX.N: U3502.3 (B1)
LTPI2.BMC.TX.P: U3502.4 (B2)
unnamed: NT3503.A3, U3503.1 (A1)
unnamed: NT3503.A4, U3503.2 (A2)
unnamed: NT3504.B3, U3501.2 (A2)
unnamed: NT3504.B4, U3501.1 (A1)
unnamed: R3502.1, U3501.6 (~EN)
unnamed: R3503.1, U3502.6 (~EN)
unnamed: R3504.1, U3503.6 (~EN)
unnamed: R3505.1, U3504.6 (~EN)
OA5_OA6.N: U3501.8 (COM1)
OA5_OA6.P: U3501.7 (COM2)
OA11_OA12.N: U3502.8 (COM1)
OA11_OA12.P: U3502.7 (COM2)
OB5_OB6.N: U3503.8 (COM1)
OB5_OB6.P: U3503.7 (COM2)
OB11_OB12.N: U3504.8 (COM1)
OB11_OB12.P: U3504.7 (COM2)
S1.USB2.N: U3504.1 (A1)
S1.USB2.P: U3504.2 (A2)
S1.USB3.RX.N: NT3503.B4
S1.USB3.RX.P: NT3503.B3
S1.USB3.TX.N: NT3504.A3
S1.USB3.TX.P: NT3504.A4
SEL: R3501.1, U3501.9 (SEL), U3502.9 (SEL), U3503.9 (SEL), U3504.9 (SEL)
VCC_3V3: C3505.1, C3506.1, C3507.1, C3508.1, U3501.10 (V_{CC}), U3502.10 (V_{CC}), U3503.10 (V_{CC}), U3504.10 (V_{CC})

Notes on the sheet:
Truth table:
LTPI2
S1{USB} or NC
Swap for layout
SEL = H
Channels from/to DCSCI edge
SEL = L
