rivosinc/scampi/sch/lvl_shifter1.kicad_sch

## KiCad design sch/lvl_shifter1.kicad_sch (2025-05-27)

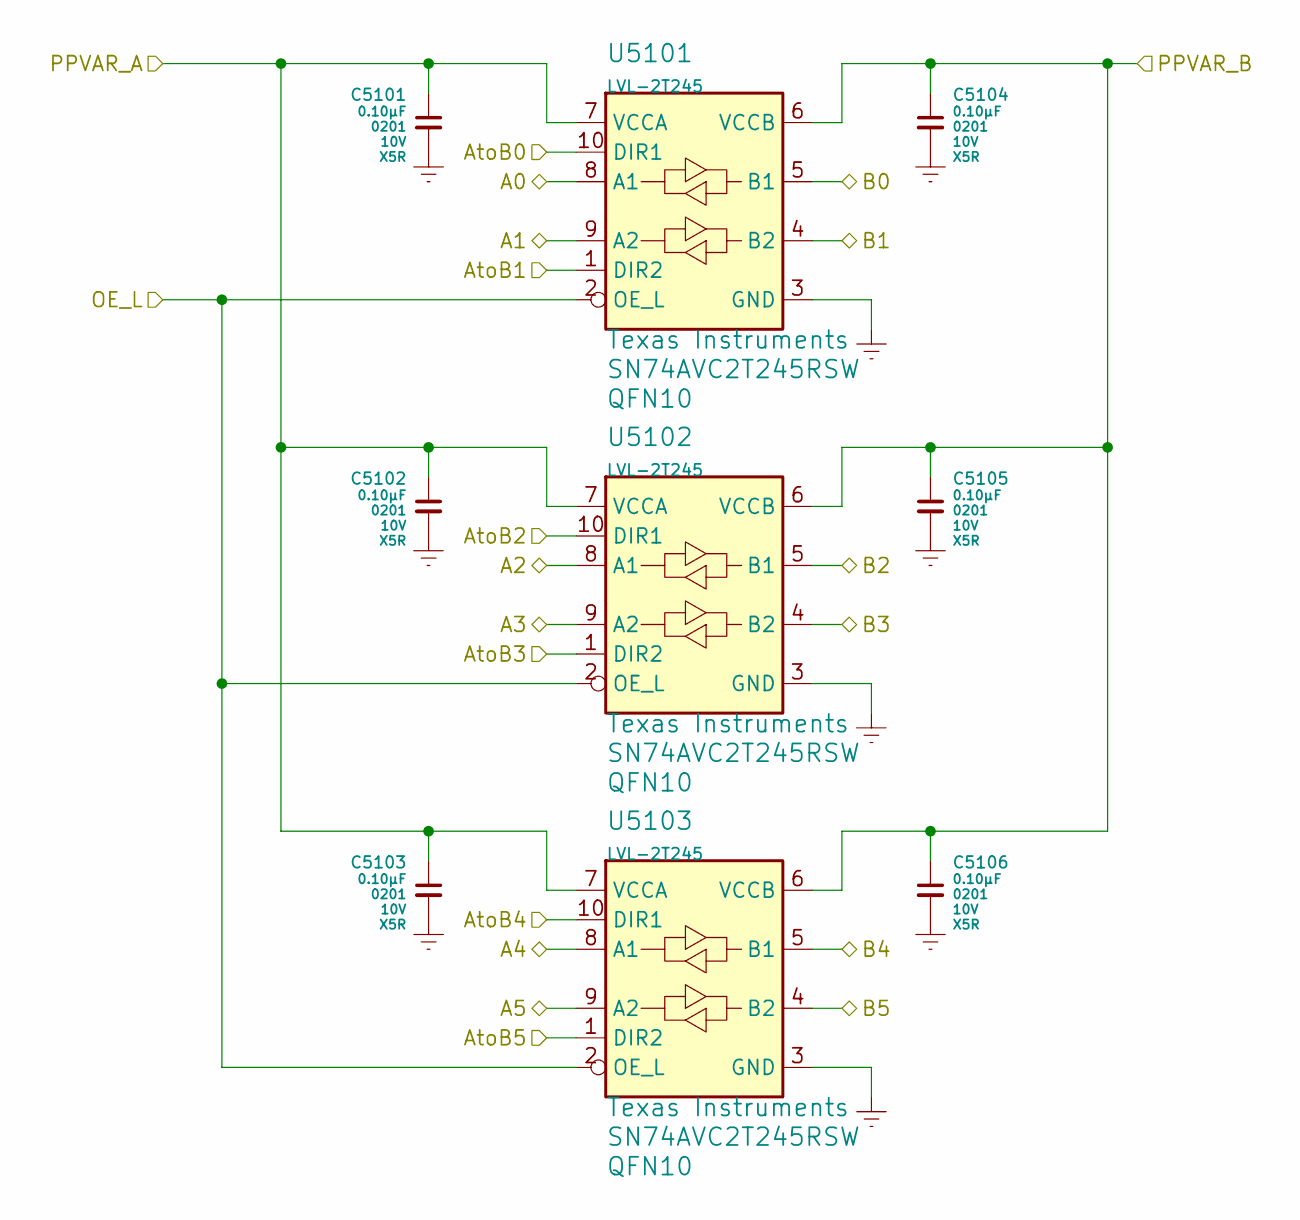
[picture p40: schematic lvl_shifter1.kicad_sch]

Parts:
C5101, C5102, C5103, C5104, C5105, C5106: CCM-610AA; mpn GRM033R61A104ME15
U5101, U5102, U5103: LVL-2T245; mpn SN74AVC2T245RSW

Connections:
A0: U5101.8 (A1)
A1: U5101.9 (A2)
A2: U5102.8 (A1)
A3: U5102.9 (A2)
A4: U5103.8 (A1)
A5: U5103.9 (A2)
AtoB0: U5101.10 (DIR1)
AtoB1: U5101.1 (DIR2)
AtoB2: U5102.10 (DIR1)
AtoB3: U5102.1 (DIR2)
AtoB4: U5103.10 (DIR1)
AtoB5: U5103.1 (DIR2)
B0: U5101.5 (B1)
B1: U5101.4 (B2)
B2: U5102.5 (B1)
B3: U5102.4 (B2)
B4: U5103.5 (B1)
B5: U5103.4 (B2)
GND: C5101.2, C5102.2, C5103.2, C5104.2, C5105.2, C5106.2, U5101.3 (GND), U5102.3 (GND), U5103.3 (GND)
OE_L: U5101.2 (OE_L), U5102.2 (OE_L), U5103.2 (OE_L)
PPVAR_A: C5101.1, C5102.1, C5103.1, U5101.7 (VCCA), U5102.7 (VCCA), U5103.7 (VCCA)
PPVAR_B: C5104.1, C5105.1, C5106.1, U5101.6 (VCCB), U5102.6 (VCCB), U5103.6 (VCCB)
