rivosinc/scampi/sch/lvl_shifter2.kicad_sch

## KiCad design sch/lvl_shifter2.kicad_sch (2025-05-27)

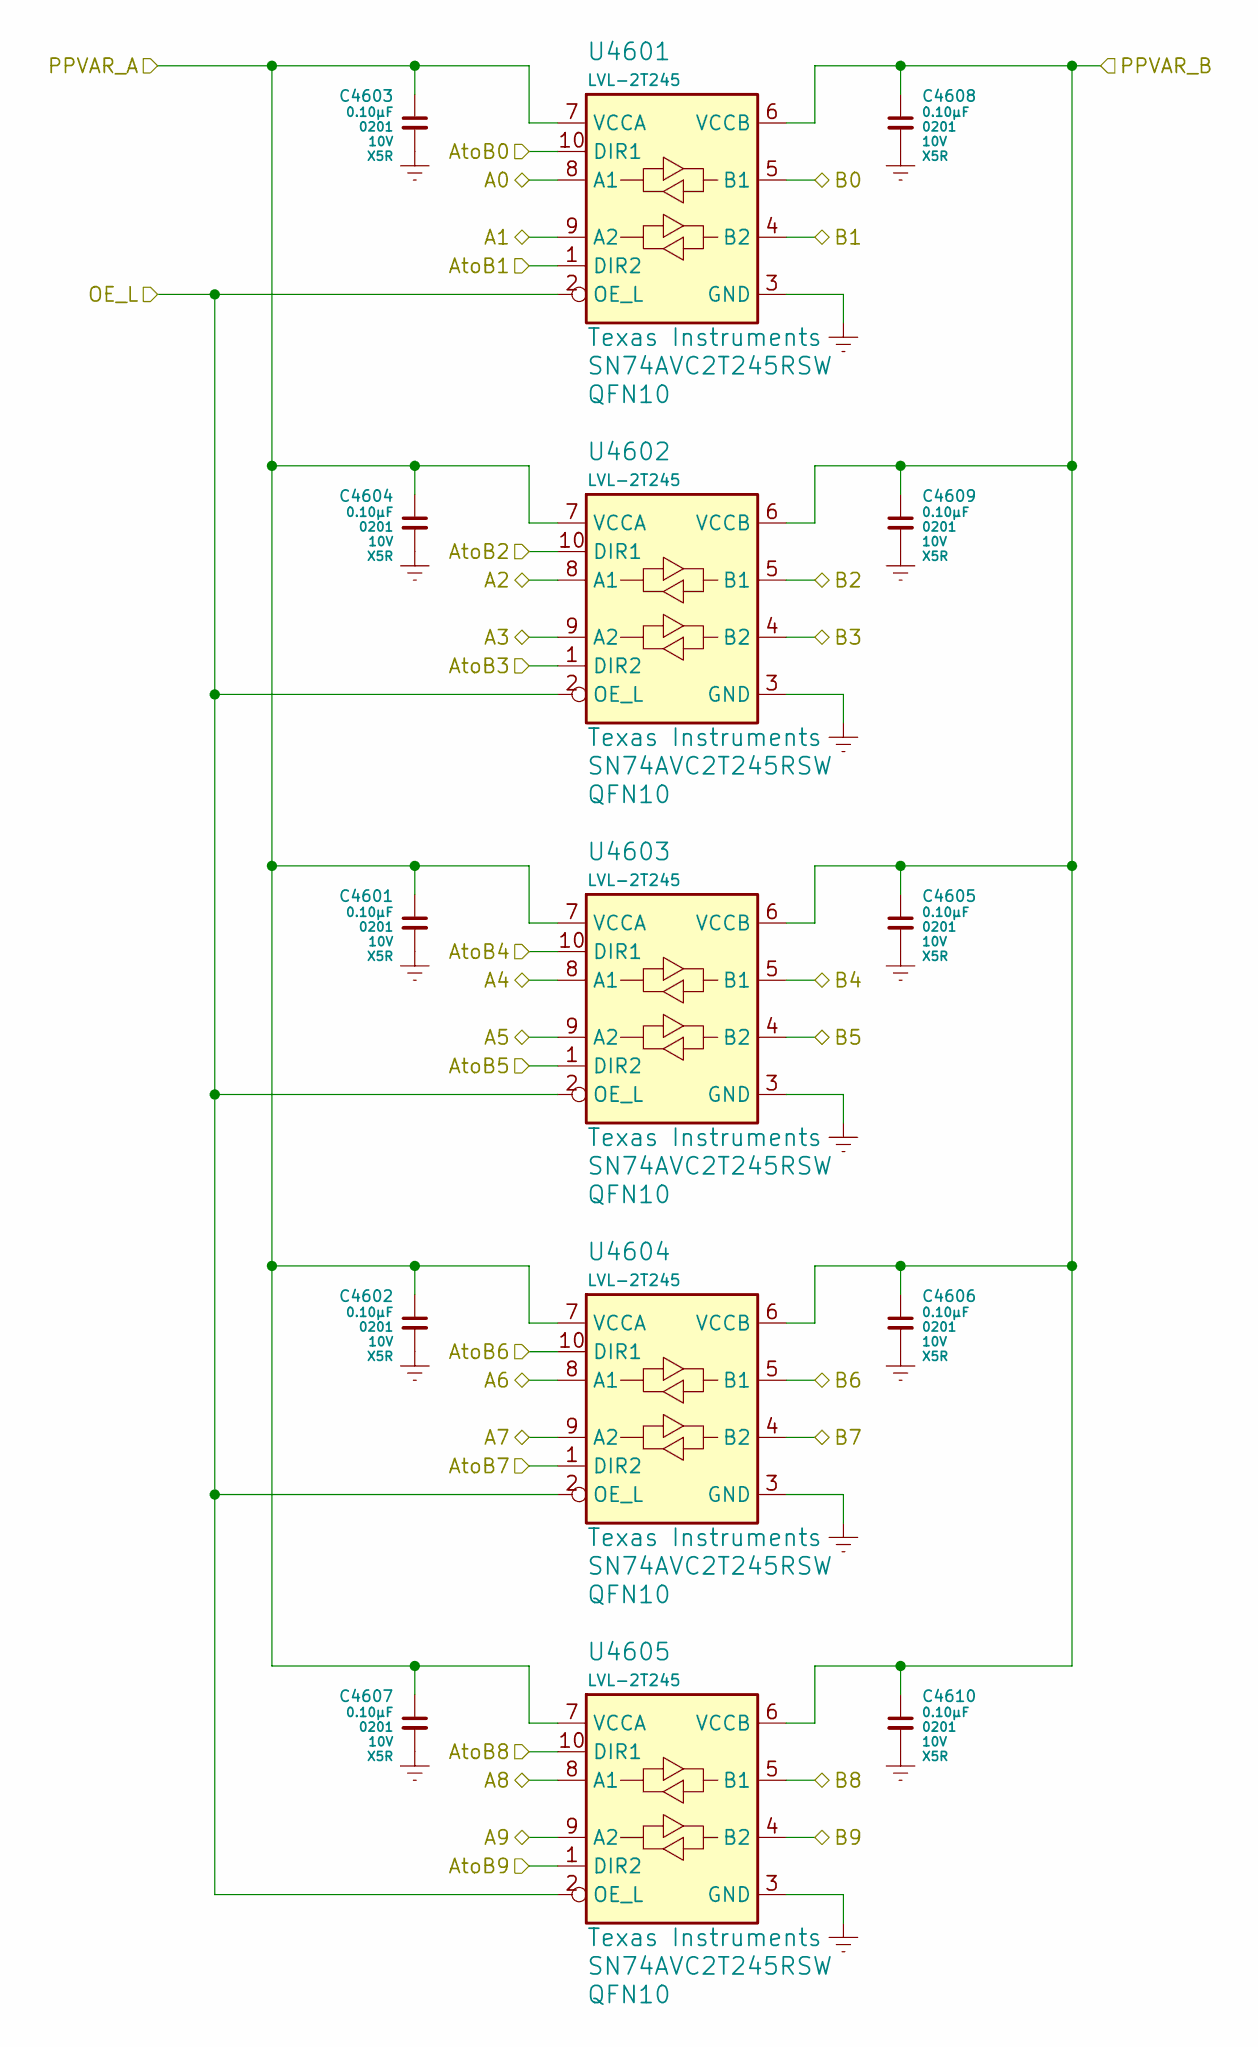
[picture p41: schematic lvl_shifter2.kicad_sch]

Parts:
C4601, C4602, C4603, C4604, C4605, C4606, C4607, C4608, C4609, C4610: CCM-610AA; mpn GRM033R61A104ME15
U4601, U4602, U4603, U4604, U4605: LVL-2T245; mpn SN74AVC2T245RSW

Connections:
A0: U4601.8 (A1)
A1: U4601.9 (A2)
A2: U4602.8 (A1)
A3: U4602.9 (A2)
A4: U4603.8 (A1)
A5: U4603.9 (A2)
A6: U4604.8 (A1)
A7: U4604.9 (A2)
A8: U4605.8 (A1)
A9: U4605.9 (A2)
AtoB0: U4601.10 (DIR1)
AtoB1: U4601.1 (DIR2)
AtoB2: U4602.10 (DIR1)
AtoB3: U4602.1 (DIR2)
AtoB4: U4603.10 (DIR1)
AtoB5: U4603.1 (DIR2)
AtoB6: U4604.10 (DIR1)
AtoB7: U4604.1 (DIR2)
AtoB8: U4605.10 (DIR1)
AtoB9: U4605.1 (DIR2)
B0: U4601.5 (B1)
B1: U4601.4 (B2)
B2: U4602.5 (B1)
B3: U4602.4 (B2)
B4: U4603.5 (B1)
B5: U4603.4 (B2)
B6: U4604.5 (B1)
B7: U4604.4 (B2)
B8: U4605.5 (B1)
B9: U4605.4 (B2)
GND: C4601.2, C4602.2, C4603.2, C4604.2, C4605.2, C4606.2, C4607.2, C4608.2, C4609.2, C4610.2, U4601.3 (GND), U4602.3 (GND), U4603.3 (GND), U4604.3 (GND), U4605.3 (GND)
OE_L: U4601.2 (OE_L), U4602.2 (OE_L), U4603.2 (OE_L), U4604.2 (OE_L), U4605.2 (OE_L)
PPVAR_A: C4601.1, C4602.1, C4603.1, C4604.1, C4607.1, U4601.7 (VCCA), U4602.7 (VCCA), U4603.7 (VCCA), U4604.7 (VCCA), U4605.7 (VCCA)
PPVAR_B: C4605.1, C4606.1, C4608.1, C4609.1, C4610.1, U4601.6 (VCCB), U4602.6 (VCCB), U4603.6 (VCCB), U4604.6 (VCCB), U4605.6 (VCCB)
