rivosinc/scampi/sch/lvl_shifter.kicad_sch

## KiCad design sch/lvl_shifter.kicad_sch (2025-05-27)

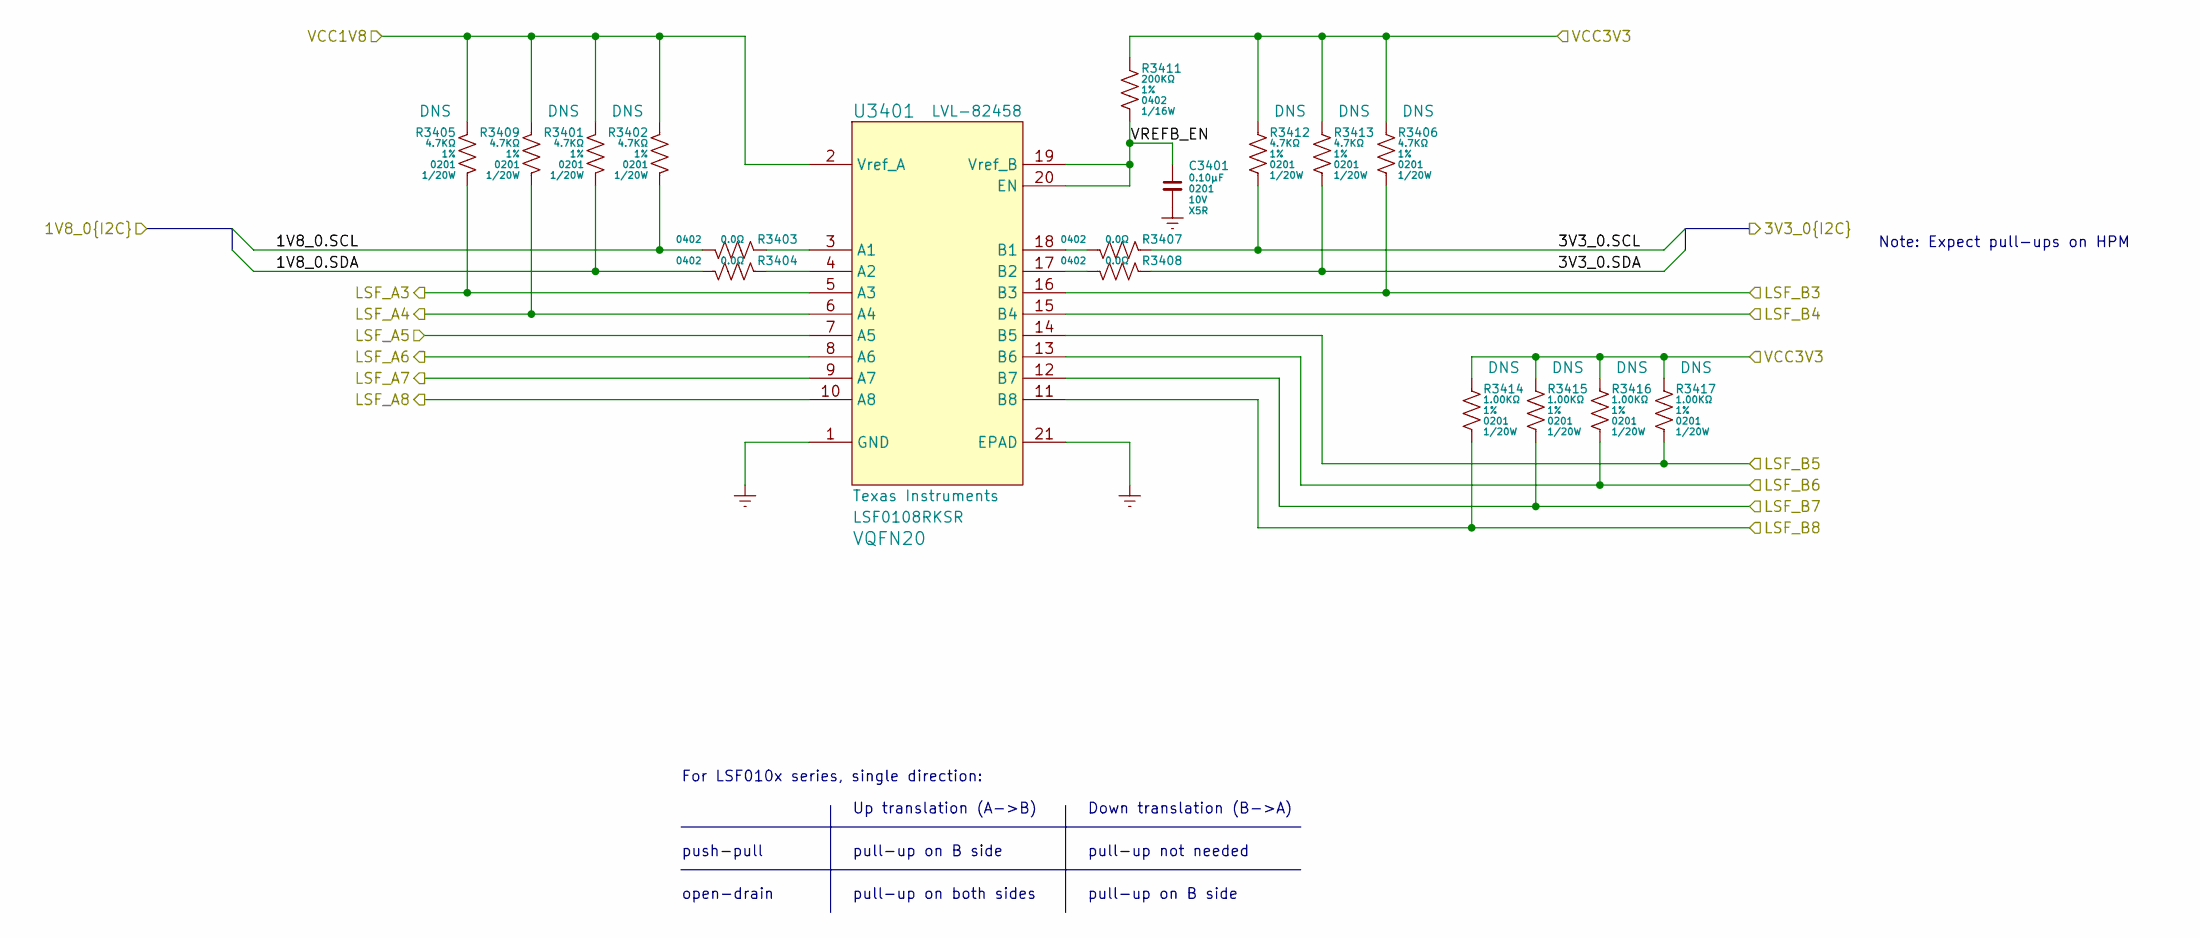
[picture p42: schematic lvl_shifter.kicad_sch]

Parts:
C3401: CCM-610AA; mpn GRM033R61A104ME15
R3401, R3402, R3405, R3406, R3409, R3412, R3413: RES-4470A
R3403, R3404, R3407, R3408: RES-0000B
R3411: RES-6200B
R3414, R3415, R3416, R3417: RES-4100A
U3401: LVL-82458; mpn LSF0108RKSR

Connections:
1V8_0.SCL: R3402.2, R3403.2
1V8_0.SDA: R3401.2, R3404.2
3V3_0.SCL: R3407.1, R3412.2
3V3_0.SDA: R3408.1, R3413.2
GND: C3401.2, U3401.1 (GND), U3401.21 (EPAD)
LSF_A3: R3405.2, U3401.5 (A3)
LSF_A4: R3409.2, U3401.6 (A4)
LSF_A5: U3401.7 (A5)
LSF_A6: U3401.8 (A6)
LSF_A7: U3401.9 (A7)
LSF_A8: U3401.10 (A8)
LSF_B3: R3406.2, U3401.16 (B3)
LSF_B4: U3401.15 (B4)
LSF_B5: R3417.2, U3401.14 (B5)
LSF_B6: R3416.2, U3401.13 (B6)
LSF_B7: R3415.2, U3401.12 (B7)
LSF_B8: R3414.2, U3401.11 (B8)
unnamed: R3403.1, U3401.3 (A1)
unnamed: R3404.1, U3401.4 (A2)
unnamed: R3407.2, U3401.18 (B1)
unnamed: R3408.2, U3401.17 (B2)
VCC1V8: R3401.1, R3402.1, R3405.1, R3409.1, U3401.2 (Vref_A)
VCC3V3: R3406.1, R3411.1, R3412.1, R3413.1, R3414.1, R3415.1, R3416.1, R3417.1
VREFB_EN: C3401.1, R3411.2, U3401.19 (Vref_B), U3401.20 (EN)

Notes on the sheet:
Up translation (A->B)
push-pull
pull-up on both sides
pull-up on B side
Down translation (B->A)
pull-up not needed
For LSF010x series, single direction:
Note: Expect pull-ups on HPM
open-drain
