rivosinc/scampi/sch/mac.kicad_sch

## KiCad design sch/mac.kicad_sch (2025-05-27)

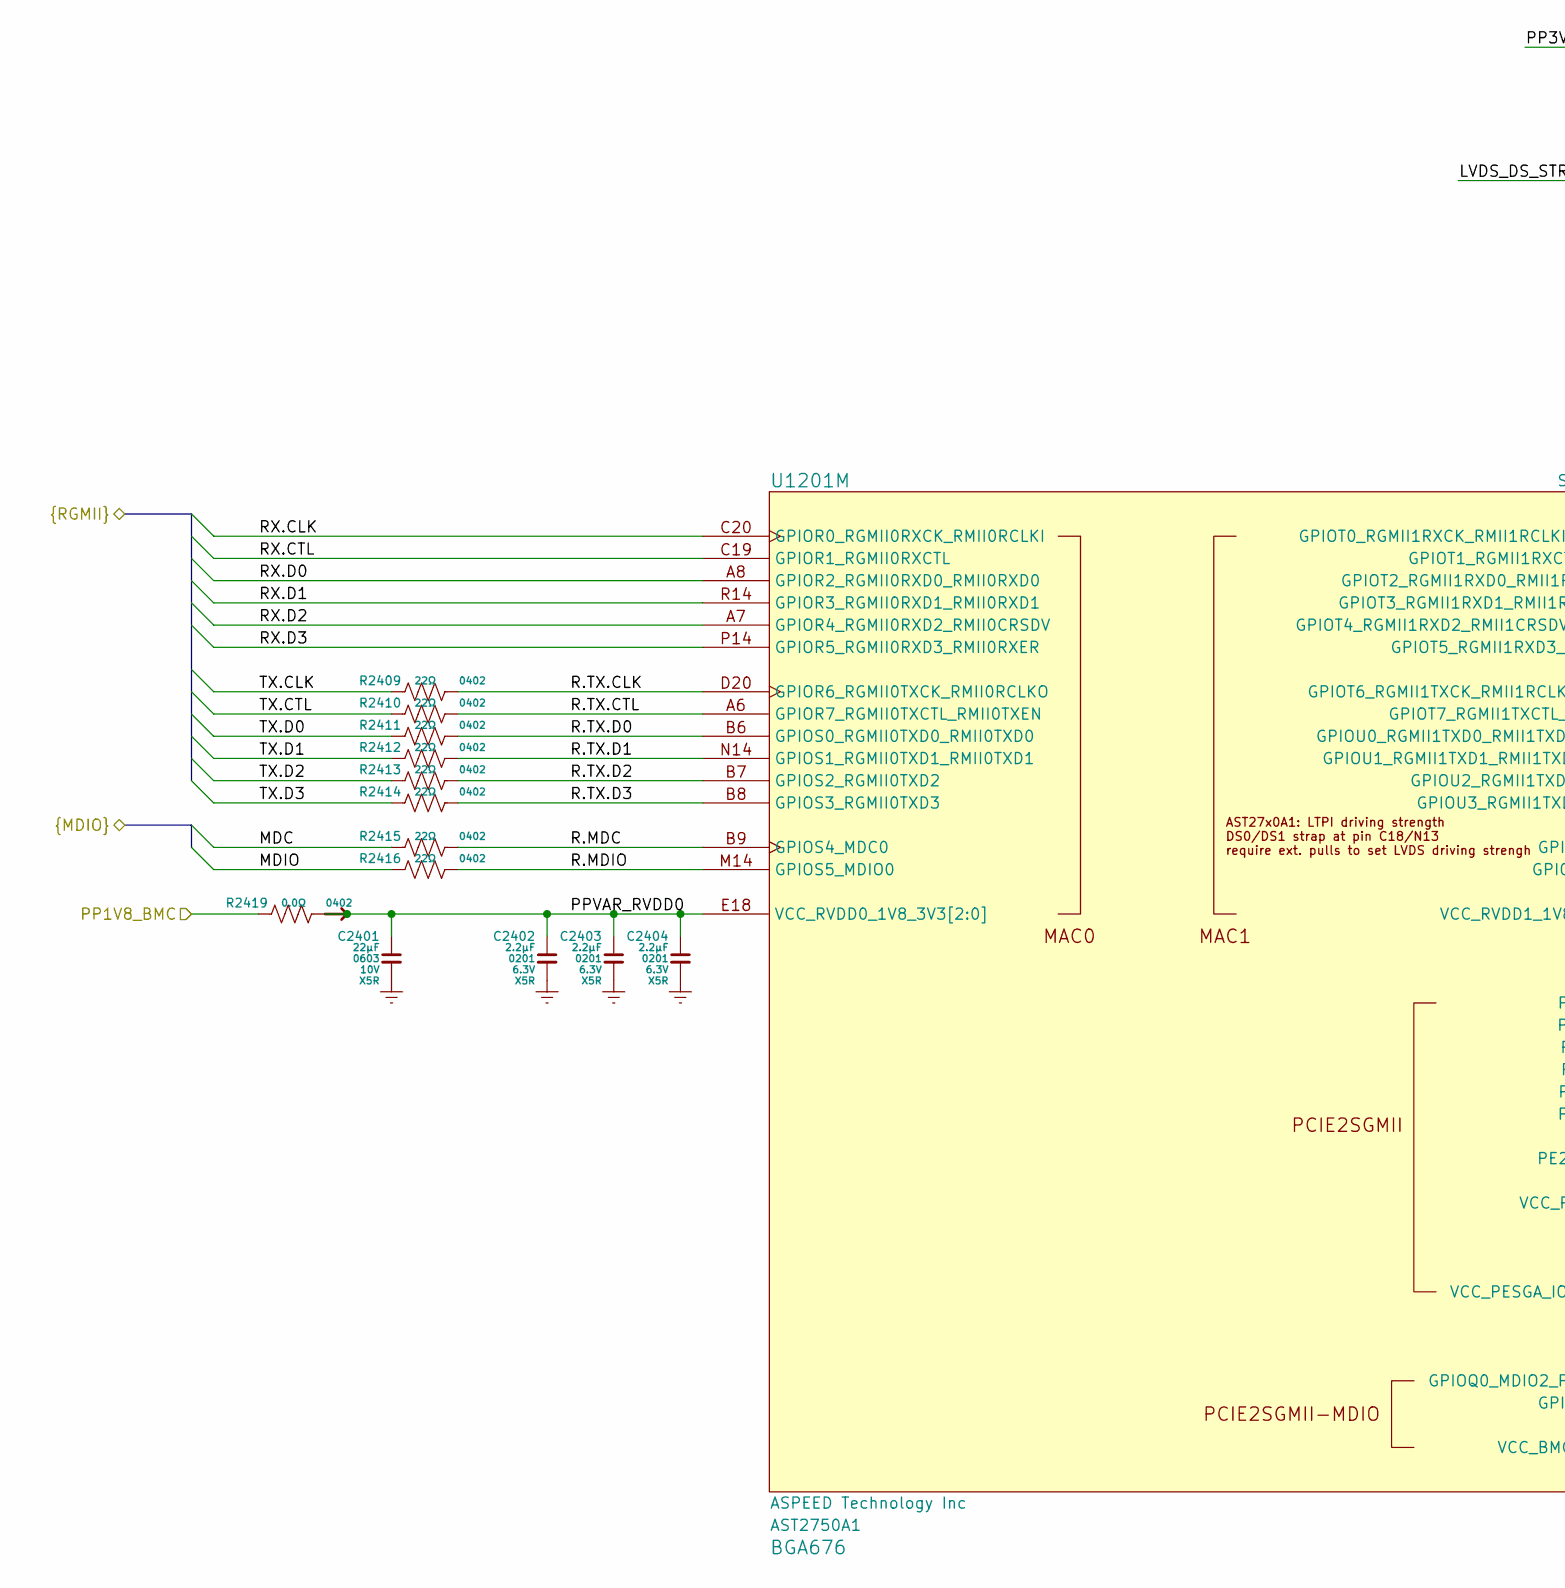
[picture p43: schematic mac.kicad_sch, part in row 1, column 1]

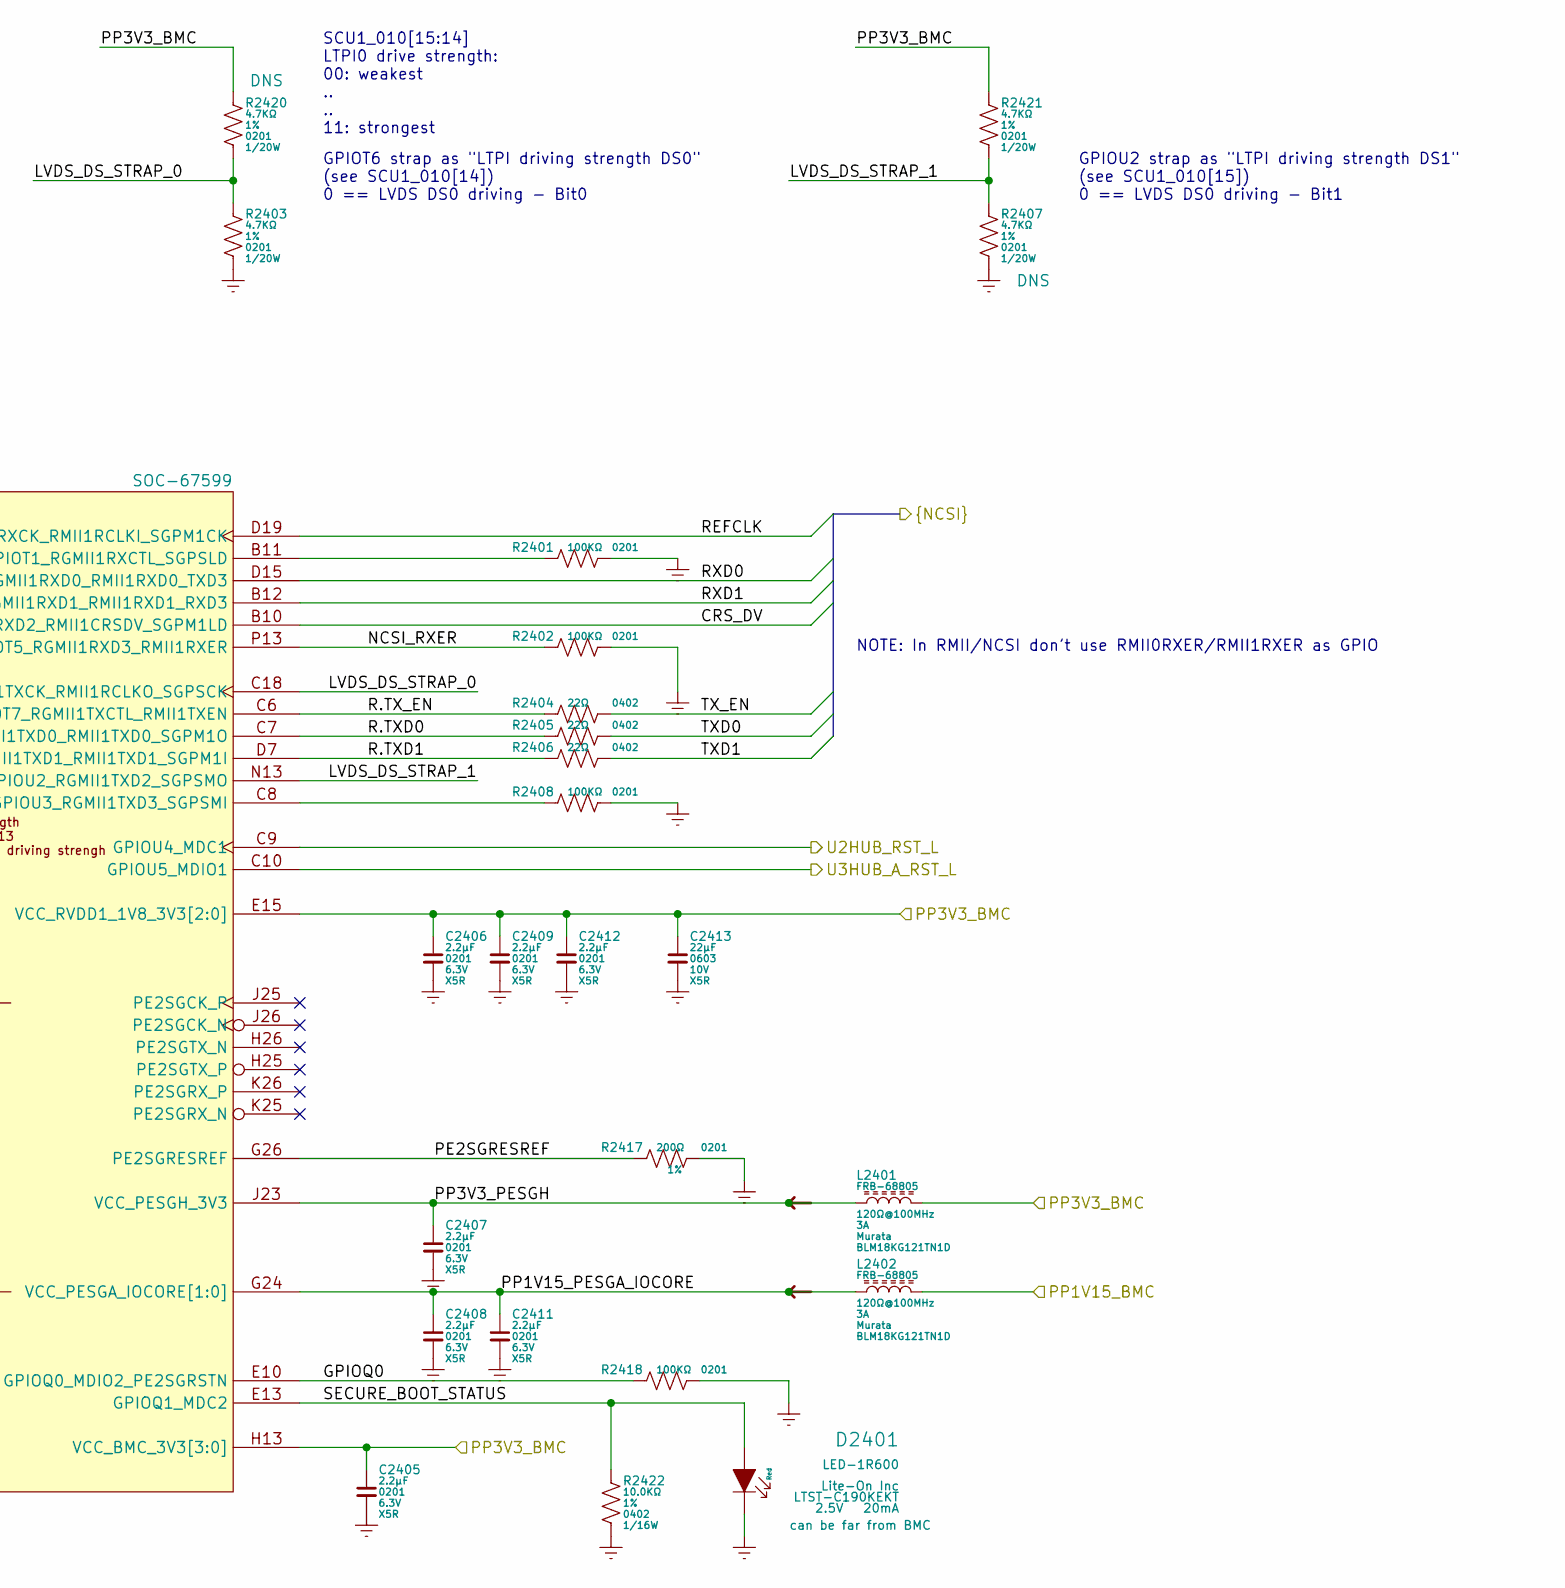
[picture p44: schematic mac.kicad_sch, part in row 1, column 2]

Parts:
C2401, C2413: CCM-822CC; mpn GRM188R61A226ME15
C2402, C2403, C2404, C2405, C2406, C2407, C2408, C2409, C2411, C2412: CCM-722AA; mpn GRM033R60J225ME01
D2401: LED-1R600; mpn LTST-C190KEKT
L2401, L2402: FRB-68805; mpn BLM18KG121TN1D
R2401, R2402, R2408, R2418: RES-6100A
R2403, R2407, R2420, R2421: RES-4470A
R2404, R2405, R2406, R2409, R2410, R2411, R2412, R2413, R2414, R2415, R2416: RES-2220B
R2417: RES-3200A
R2419: RES-0000B
R2422: RES-5100B
U1201: SOC-67599; mpn AST2750A1

Connections:
CRS_DV: U1201.B10 (GPIOT4_RGMII1RXD2_RMII1CRSDV_SGPM1LD)
GND: C2401.2, C2402.2, C2403.2, C2404.2, C2405.2, C2406.2, C2407.2, C2408.2, C2409.2, C2411.2, C2412.2, C2413.2, D2401.K, R2401.2, R2402.2, R2403.2, R2407.2, R2408.2, R2417.2, R2418.2, R2422.2
GPIOQ0: R2418.1, U1201.E10 (GPIOQ0_MDIO2_PE2SGRSTN)
LVDS_DS_STRAP_0: R2403.1, R2420.2, U1201.C18 (GPIOT6_RGMII1TXCK_RMII1RCLKO_SGPSCK)
LVDS_DS_STRAP_1: R2407.1, R2421.2, U1201.N13 (GPIOU2_RGMII1TXD2_SGPSMO)
MDC: R2415.1
MDIO: R2416.1
NCSI_RXER: R2402.1, U1201.P13 (GPIOT5_RGMII1RXD3_RMII1RXER)
unnamed: R2401.1, U1201.B11 (GPIOT1_RGMII1RXCTL_SGPSLD)
unnamed: R2408.1, U1201.C8 (GPIOU3_RGMII1TXD3_SGPSMI)
PE2SGRESREF: R2417.1, U1201.G26 (PE2SGRESREF)
PP1V8_BMC: R2419.1
PP1V15_BMC: L2402.2
PP1V15_PESGA_IOCORE: C2408.1, C2411.1, L2402.1, U1201.G24 (VCC_PESGA_IOCORE[1:0]), U1201.H24 (VCC_PESGA_IOCORE[1:0])
PP3V3_BMC: C2405.1, C2406.1, C2409.1, C2412.1, C2413.1, L2401.2, R2420.1, R2421.1, U1201.E15 (VCC_RVDD1_1V8_3V3[2:0]), U1201.E16 (VCC_RVDD1_1V8_3V3[2:0]), U1201.E17 (VCC_RVDD1_1V8_3V3[2:0]), U1201.H13 (VCC_BMC_3V3[3:0])
PP3V3_PESGH: C2407.1, L2401.1, U1201.J23 (VCC_PESGH_3V3)
PPVAR_RVDD0: C2401.1, C2402.1, C2403.1, C2404.1, R2419.2, U1201.E18 (VCC_RVDD0_1V8_3V3[2:0]), U1201.E19 (VCC_RVDD0_1V8_3V3[2:0]), U1201.E20 (VCC_RVDD0_1V8_3V3[2:0])
R.MDC: R2415.2, U1201.B9 (GPIOS4_MDC0)
R.MDIO: R2416.2, U1201.M14 (GPIOS5_MDIO0)
R.TX.CLK: R2409.2, U1201.D20 (GPIOR6_RGMII0TXCK_RMII0RCLKO)
R.TX.CTL: R2410.2, U1201.A6 (GPIOR7_RGMII0TXCTL_RMII0TXEN)
R.TX.D0: R2411.2, U1201.B6 (GPIOS0_RGMII0TXD0_RMII0TXD0)
R.TX.D1: R2412.2, U1201.N14 (GPIOS1_RGMII0TXD1_RMII0TXD1)
R.TX.D2: R2413.2, U1201.B7 (GPIOS2_RGMII0TXD2)
R.TX.D3: R2414.2, U1201.B8 (GPIOS3_RGMII0TXD3)
R.TXD0: R2405.1, U1201.C7 (GPIOU0_RGMII1TXD0_RMII1TXD0_SGPM1O)
R.TXD1: R2406.1, U1201.D7 (GPIOU1_RGMII1TXD1_RMII1TXD1_SGPM1I)
R.TX_EN: R2404.1, U1201.C6 (GPIOT7_RGMII1TXCTL_RMII1TXEN)
REFCLK: U1201.D19 (GPIOT0_RGMII1RXCK_RMII1RCLKI_SGPM1CK)
RX.CLK: U1201.C20 (GPIOR0_RGMII0RXCK_RMII0RCLKI)
RX.CTL: U1201.C19 (GPIOR1_RGMII0RXCTL)
RX.D0: U1201.A8 (GPIOR2_RGMII0RXD0_RMII0RXD0)
RX.D1: U1201.R14 (GPIOR3_RGMII0RXD1_RMII0RXD1)
RX.D2: U1201.A7 (GPIOR4_RGMII0RXD2_RMII0CRSDV)
RX.D3: U1201.P14 (GPIOR5_RGMII0RXD3_RMII0RXER)
RXD0: U1201.D15 (GPIOT2_RGMII1RXD0_RMII1RXD0_TXD3)
RXD1: U1201.B12 (GPIOT3_RGMII1RXD1_RMII1RXD1_RXD3)
SECURE_BOOT_STATUS: D2401.A, R2422.1, U1201.E13 (GPIOQ1_MDC2)
TX.CLK: R2409.1
TX.CTL: R2410.1
TX.D0: R2411.1
TX.D1: R2412.1
TX.D2: R2413.1
TX.D3: R2414.1
TXD0: R2405.2
TXD1: R2406.2
TX_EN: R2404.2
U2HUB_RST_L: U1201.C9 (GPIOU4_MDC1)
U3HUB_A_RST_L: U1201.C10 (GPIOU5_MDIO1)

Notes on the sheet:
SCU1_010[15:14] LTPI0 drive strength: 00: weakest .. .. 11: strongest
NOTE: In RMII/NCSI don't use RMII0RXER/RMII1RXER as GPIO
GPIOT6 strap as "LTPI driving strength DS0" (see SCU1_010[14]) 0 == LVDS DS0 driving - Bit0
GPIOU2 strap as "LTPI driving strength DS1" (see SCU1_010[15]) 0 == LVDS DS0 driving - Bit1
