rivosinc/scampi/sch/mux_and_roms.kicad_sch

## KiCad design sch/mux_and_roms.kicad_sch (2025-05-27)

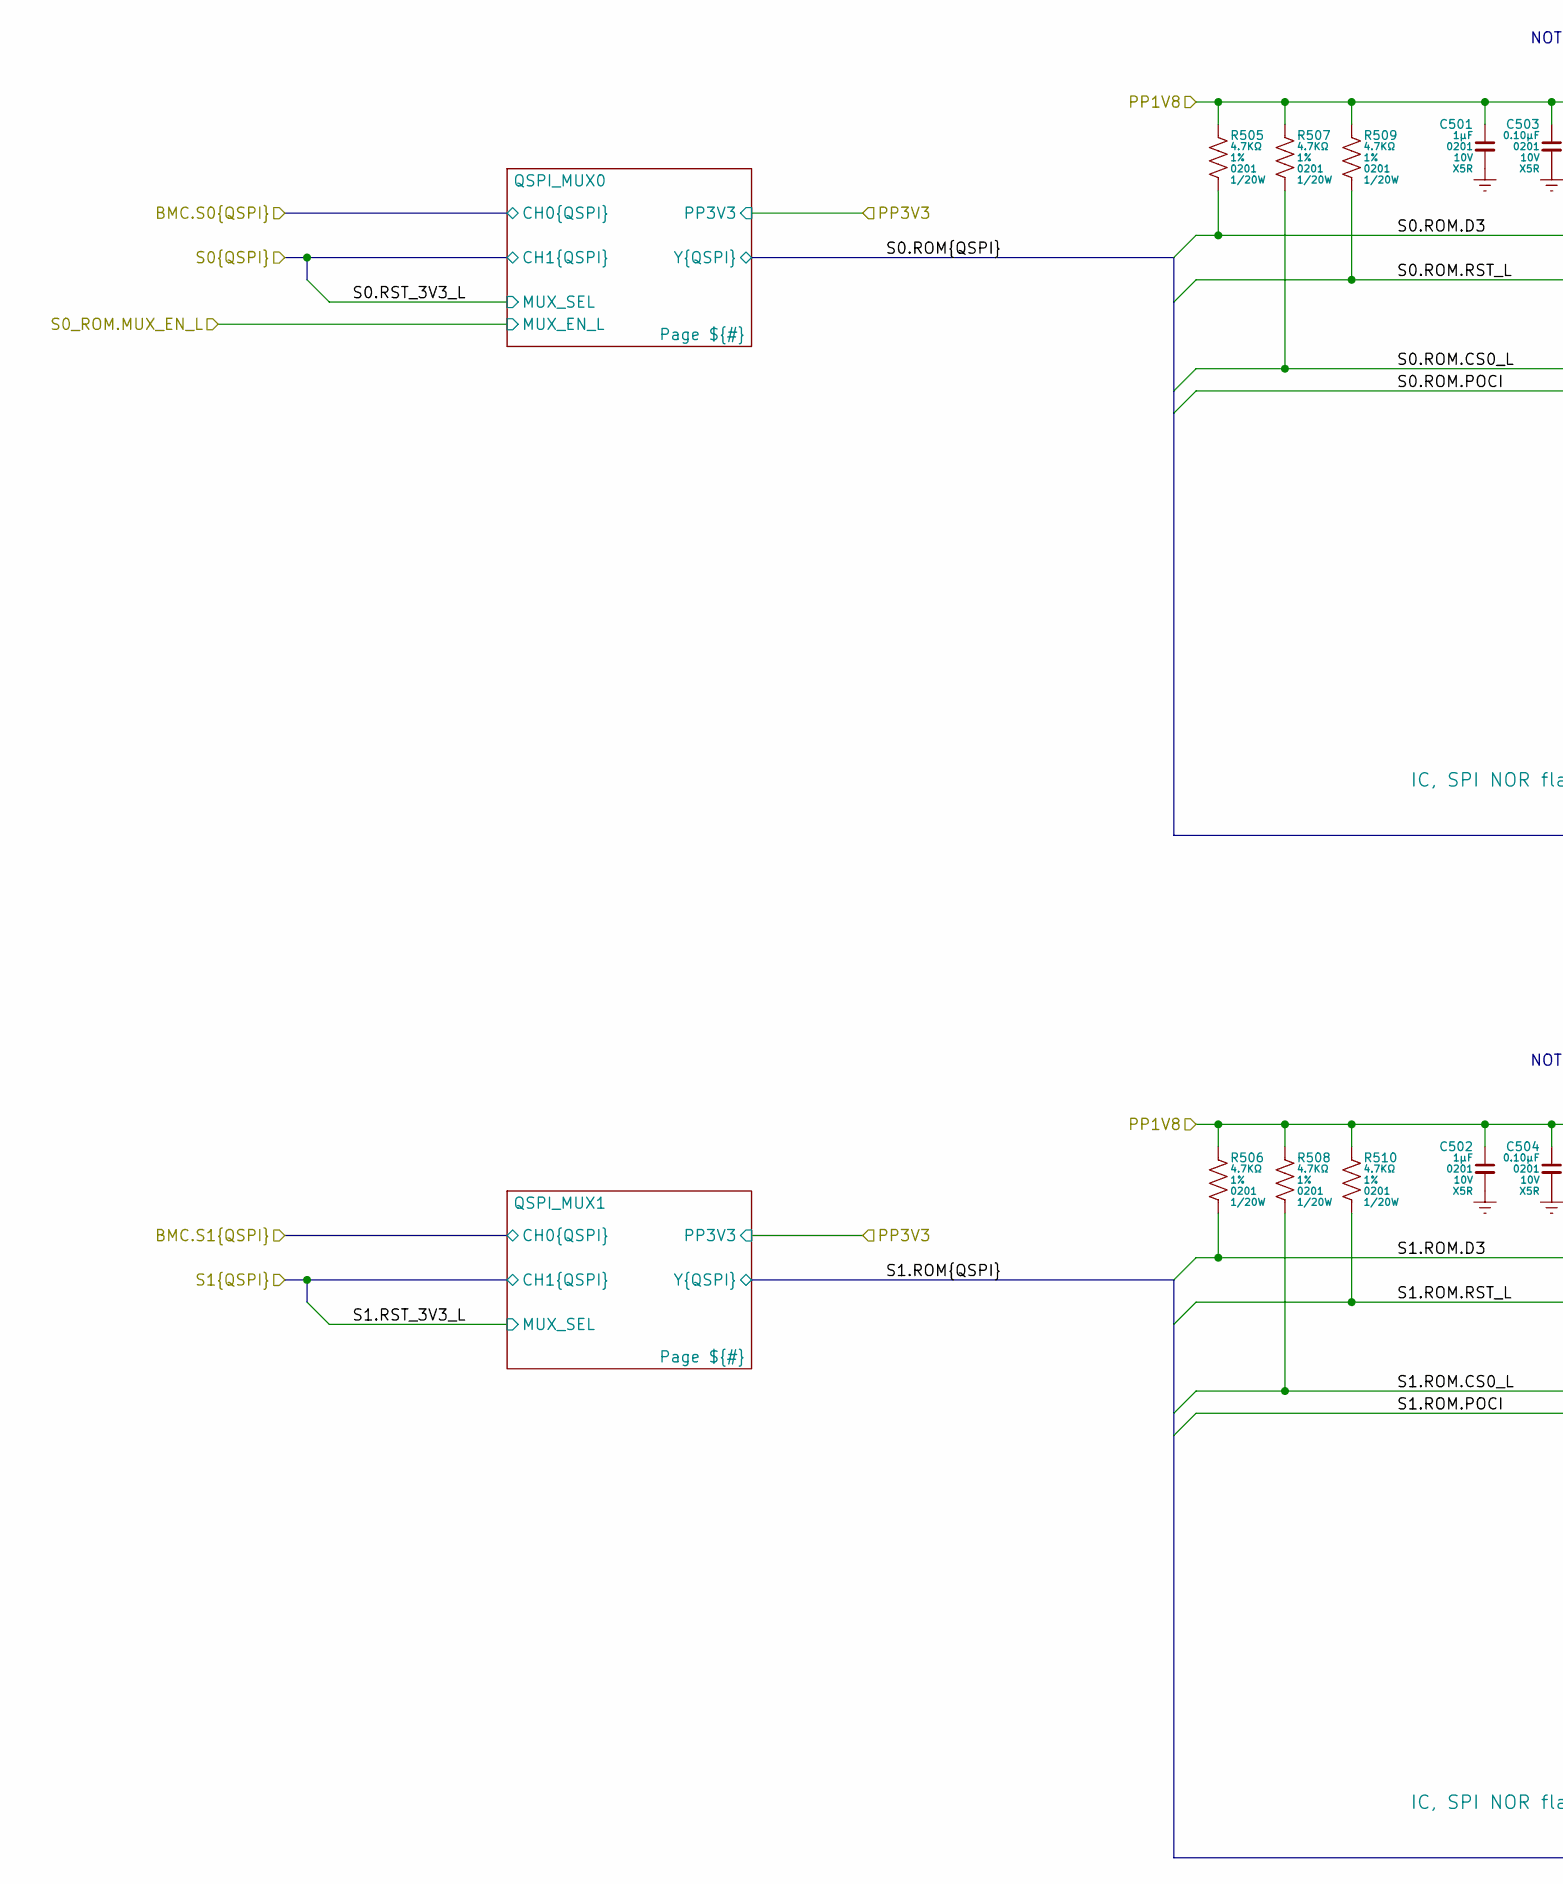
[picture p45: schematic mux_and_roms.kicad_sch, part in row 1, column 1]

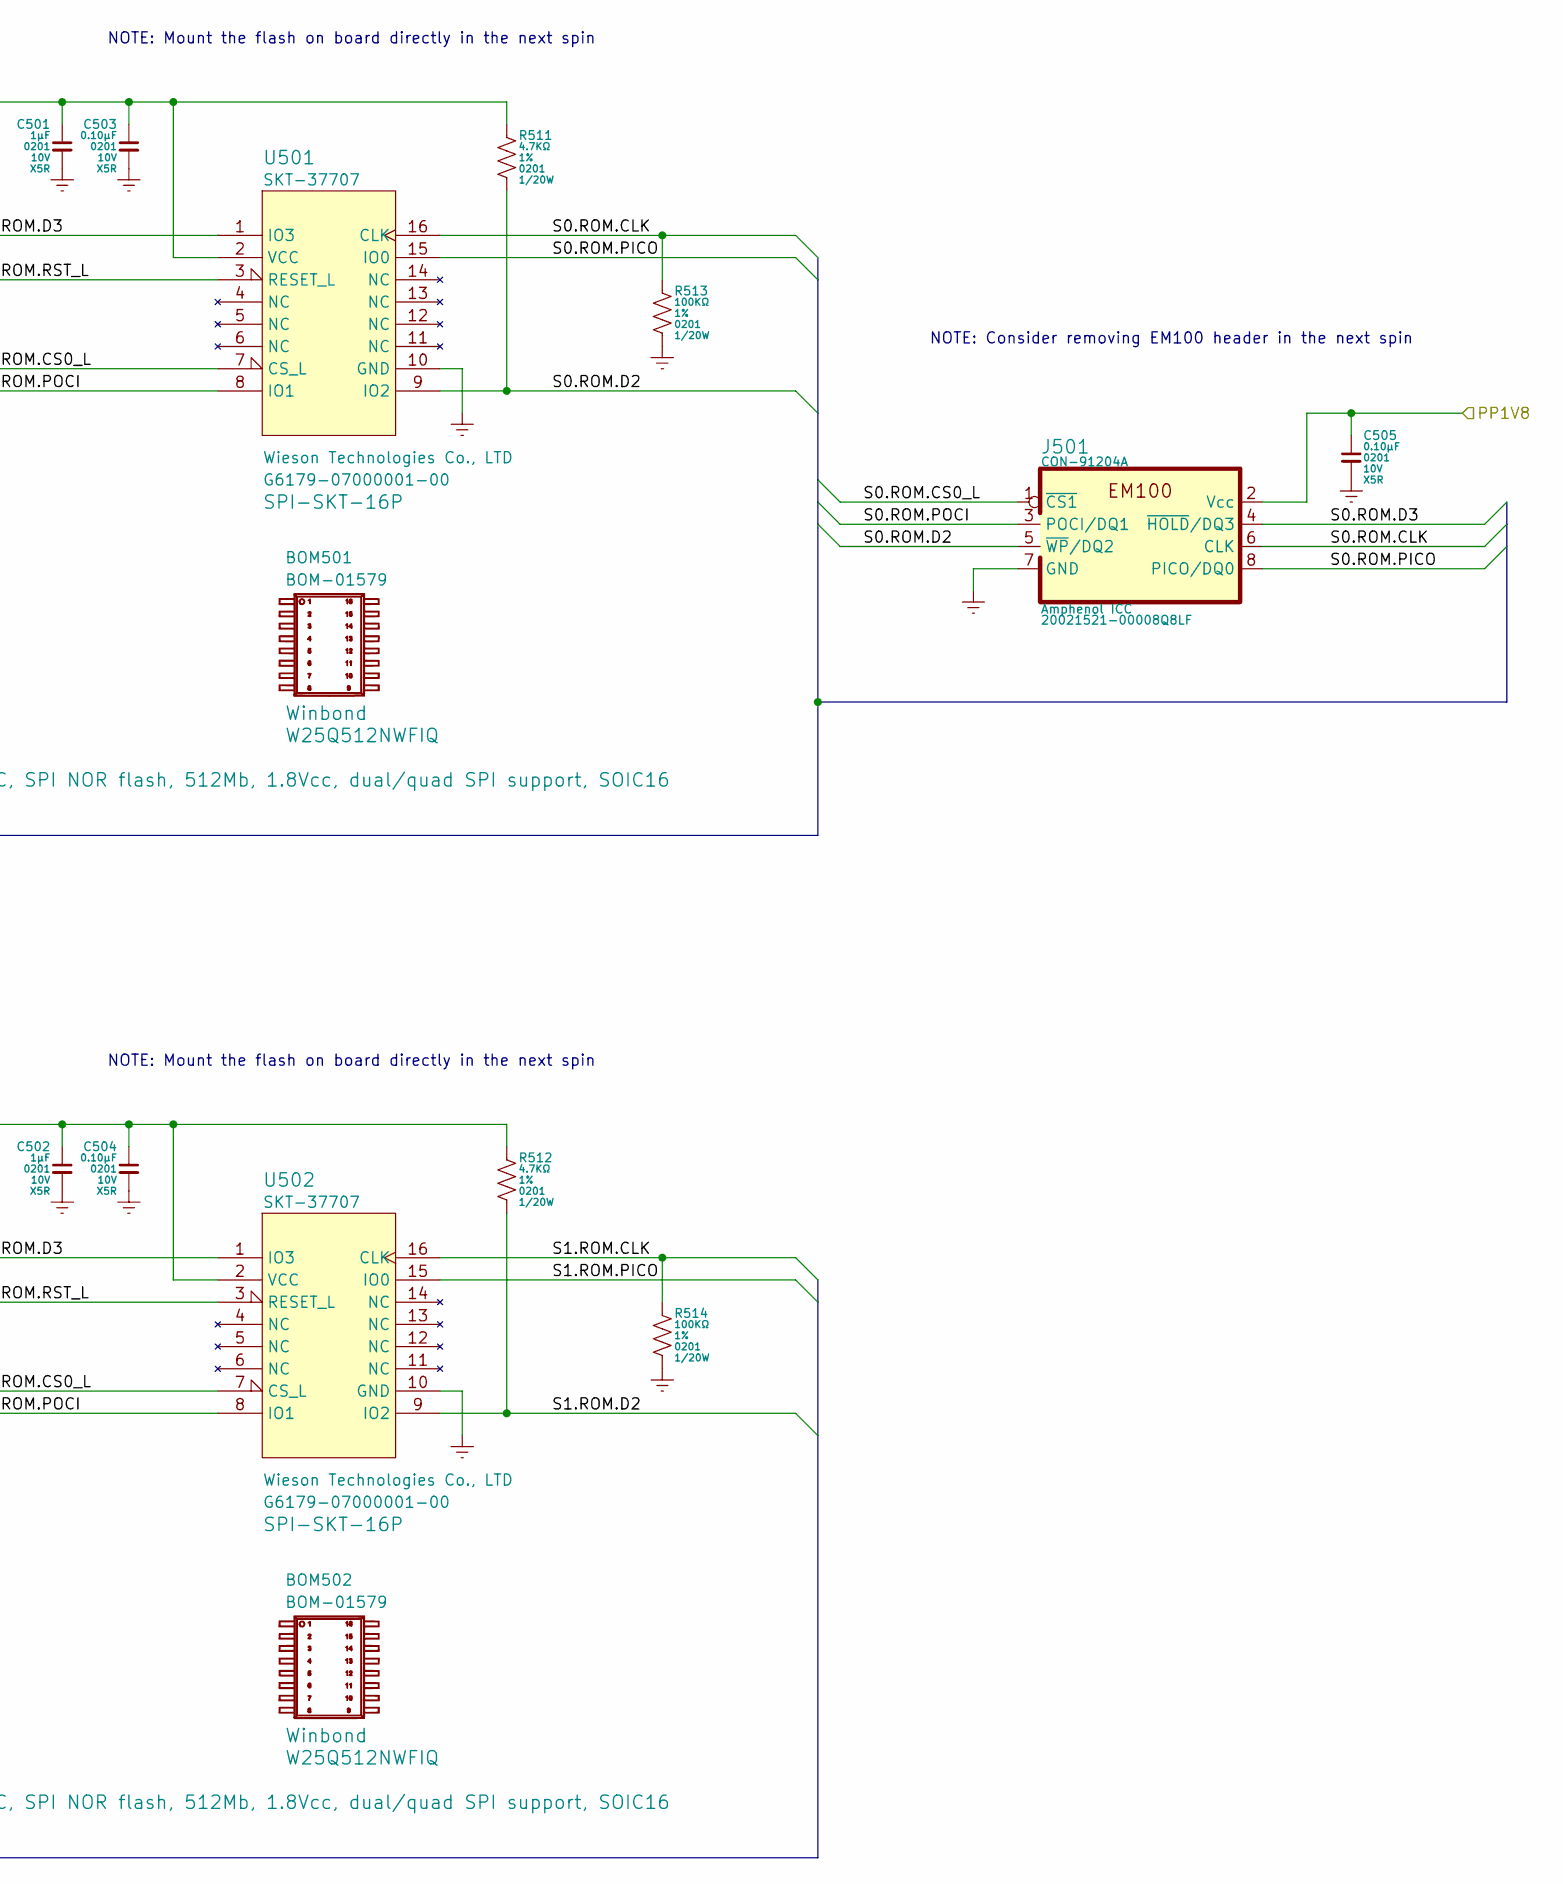
[picture p46: schematic mux_and_roms.kicad_sch, part in row 1, column 2]

Parts:
BOM501, BOM502: BOM-01579; mpn W25Q512NWFIQ
C501, C502: CCM-710AD; mpn GRM033R61A105ME15
C503, C504, C505: CCM-610AA; mpn GRM033R61A104ME15
J501: CON-91204A; mpn 20021521-00008Q8LF
R505, R506, R507, R508, R509, R510, R511, R512: RES-4470A
R513, R514: RES-6100A
U501, U502: SKT-37707; mpn G6179-07000001-00

Connections:
GND: C501.2, C502.2, C503.2, C504.2, C505.2, J501.7 (GND), R513.2, R514.2, U501.10 (GND), U502.10 (GND)
PP1V8: C501.1, C502.1, C503.1, C504.1, C505.1, J501.2 (Vcc), R505.1, R506.1, R507.1, R508.1, R509.1, R510.1, R511.1, R512.1, U501.2 (VCC), U502.2 (VCC)
S0.ROM.CLK: J501.6 (CLK), R513.1, U501.16 (CLK)
S0.ROM.CS0_L: J501.1 (~CS1), R507.2, U501.7 (CS_L)
S0.ROM.D2: J501.5 (~WP/DQ2), R511.2, U501.9 (IO2)
S0.ROM.D3: J501.4 (~HOLD/DQ3), R505.2, U501.1 (IO3)
S0.ROM.PICO: J501.8 (PICO/DQ0), U501.15 (IO0)
S0.ROM.POCI: J501.3 (POCI/DQ1), U501.8 (IO1)
S0.ROM.RST_L: R509.2, U501.3 (RESET_L)
S1.ROM.CLK: R514.1, U502.16 (CLK)
S1.ROM.CS0_L: R508.2, U502.7 (CS_L)
S1.ROM.D2: R512.2, U502.9 (IO2)
S1.ROM.D3: R506.2, U502.1 (IO3)
S1.ROM.PICO: U502.15 (IO0)
S1.ROM.POCI: U502.8 (IO1)
S1.ROM.RST_L: R510.2, U502.3 (RESET_L)

Notes on the sheet:
NOTE: Mount the flash on board directly in the next spin
NOTE: Consider removing EM100 header in the next spin
