rivosinc/scampi/sch/mux_to_cem_edge.kicad_sch

## KiCad design sch/mux_to_cem_edge.kicad_sch (2025-05-27)

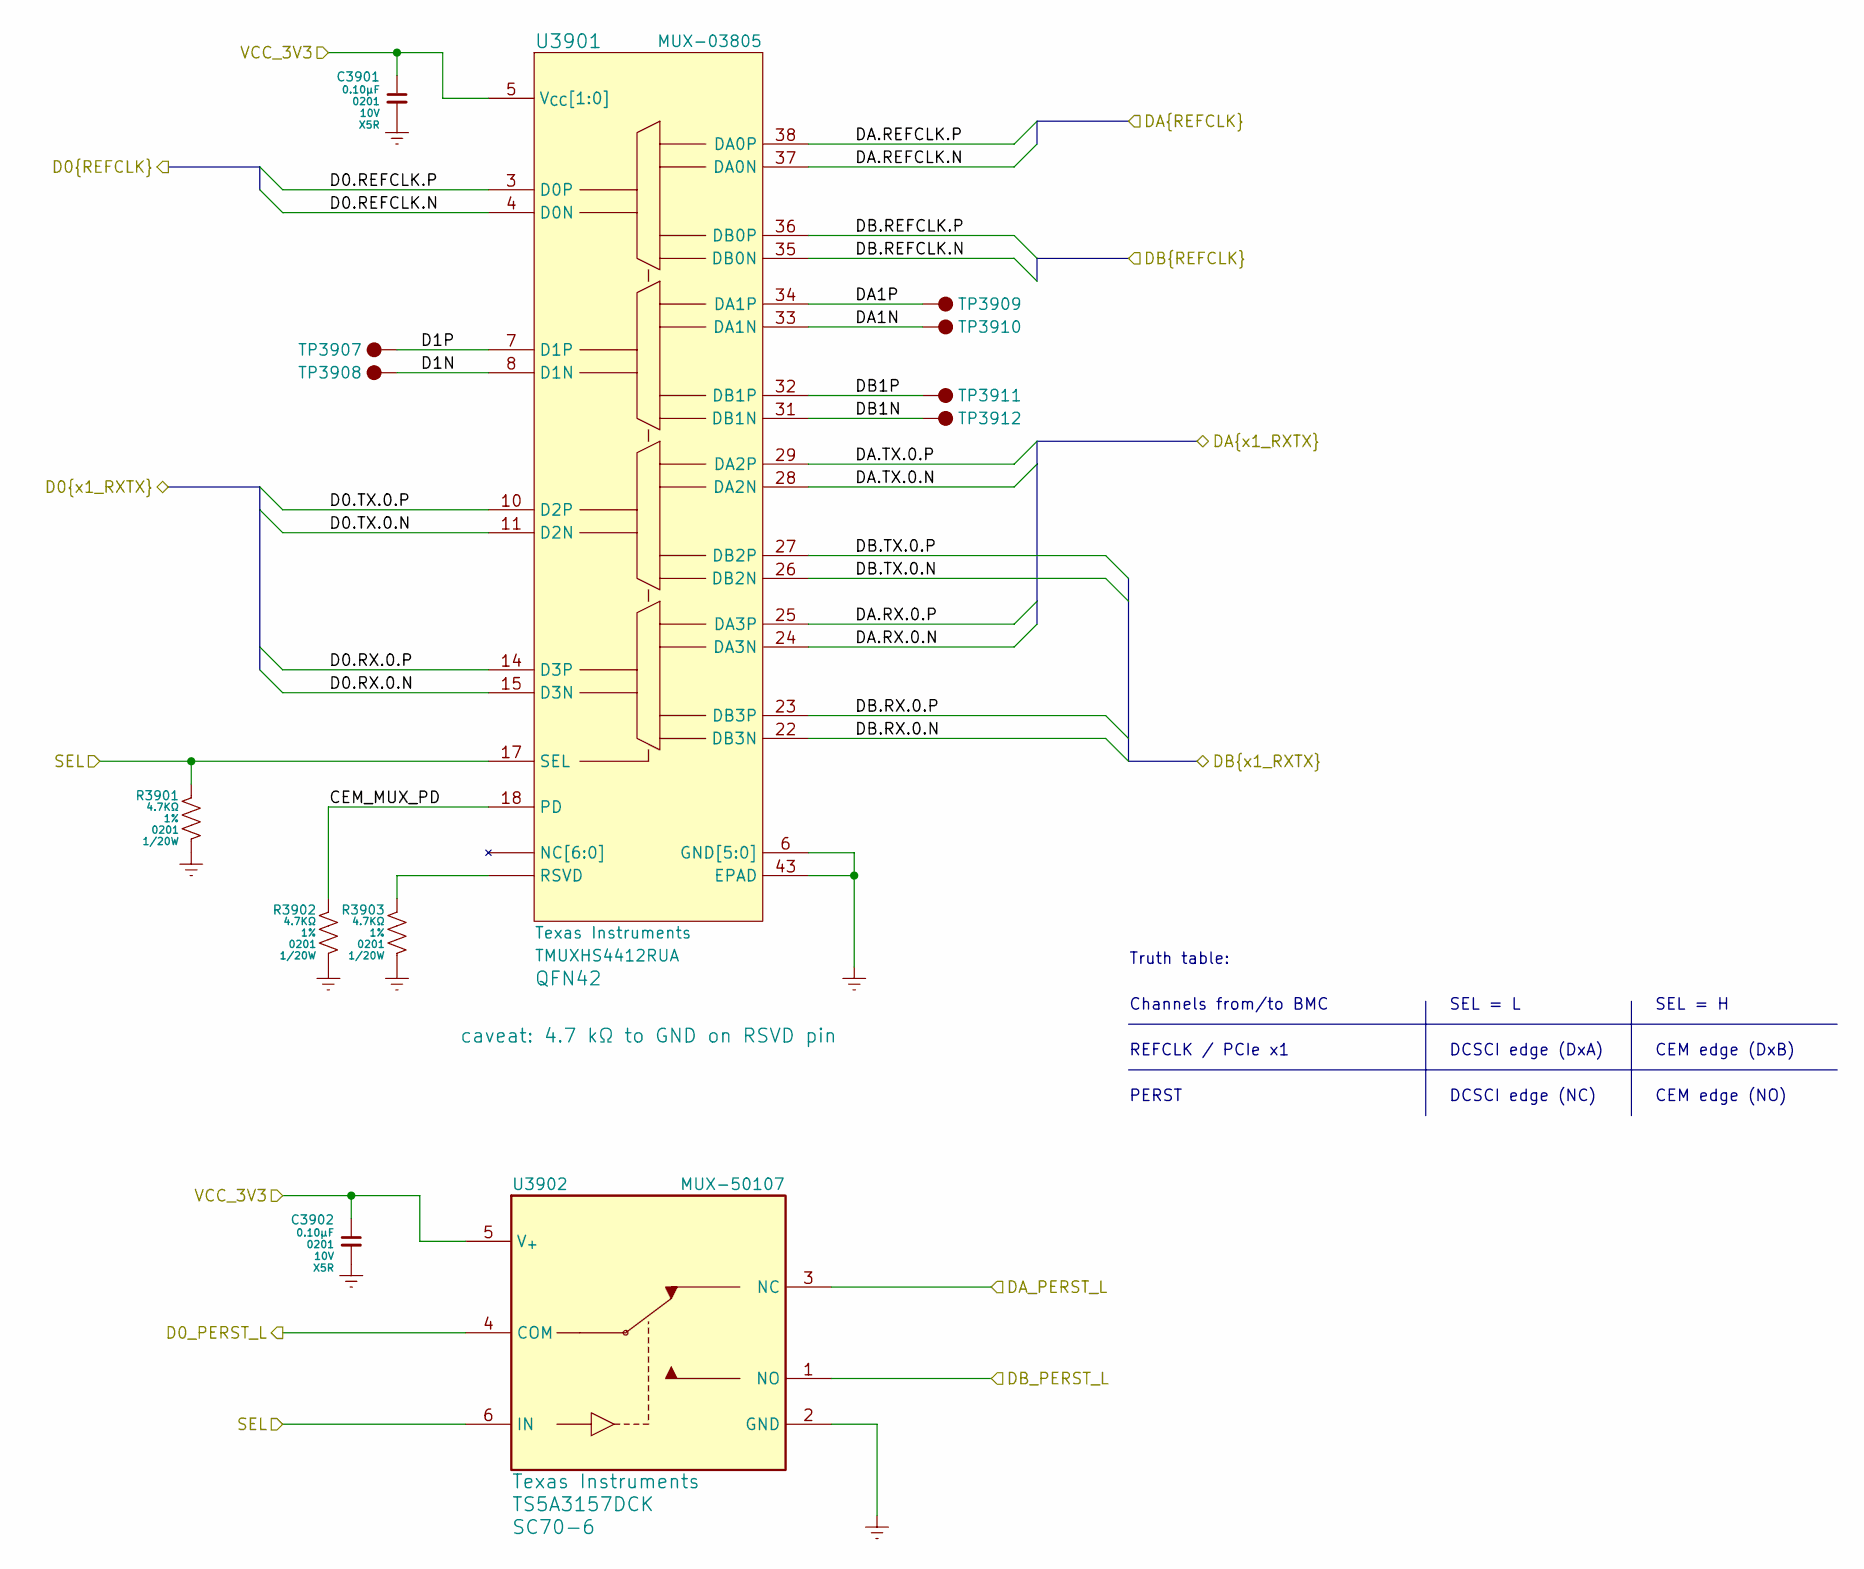
[picture p47: schematic mux_to_cem_edge.kicad_sch]

Parts:
C3901, C3902: CCM-610AA; mpn GRM033R61A104ME15
R3901, R3902, R3903: RES-4470A
TP3907, TP3908, TP3909, TP3910, TP3911, TP3912: TST-01025
U3901: MUX-03805; mpn TMUXHS4412RUA
U3902: MUX-50107; mpn TS5A3157DCK

Connections:
CEM_MUX_PD: R3902.1, U3901.18 (PD)
D0.REFCLK.N: U3901.4 (D0N)
D0.REFCLK.P: U3901.3 (D0P)
D0.RX.0.N: U3901.15 (D3N)
D0.RX.0.P: U3901.14 (D3P)
D0.TX.0.N: U3901.11 (D2N)
D0.TX.0.P: U3901.10 (D2P)
D0_PERST_L: U3902.4 (COM)
D1N: TP3908.1, U3901.8 (D1N)
D1P: TP3907.1, U3901.7 (D1P)
DA1N: TP3910.1, U3901.33 (DA1N)
DA1P: TP3909.1, U3901.34 (DA1P)
DA.REFCLK.N: U3901.37 (DA0N)
DA.REFCLK.P: U3901.38 (DA0P)
DA.RX.0.N: U3901.24 (DA3N)
DA.RX.0.P: U3901.25 (DA3P)
DA.TX.0.N: U3901.28 (DA2N)
DA.TX.0.P: U3901.29 (DA2P)
DA_PERST_L: U3902.3 (NC)
DB1N: TP3912.1, U3901.31 (DB1N)
DB1P: TP3911.1, U3901.32 (DB1P)
DB.REFCLK.N: U3901.35 (DB0N)
DB.REFCLK.P: U3901.36 (DB0P)
DB.RX.0.N: U3901.22 (DB3N)
DB.RX.0.P: U3901.23 (DB3P)
DB.TX.0.N: U3901.26 (DB2N)
DB.TX.0.P: U3901.27 (DB2P)
DB_PERST_L: U3902.1 (NO)
GND: C3901.2, C3902.2, R3901.2, R3902.2, R3903.2, U3901.6 (GND[5:0]), U3901.9 (GND[5:0]), U3901.16 (GND[5:0]), U3901.21 (GND[5:0]), U3901.30 (GND[5:0]), U3901.39 (GND[5:0]), U3901.43 (EPAD), U3902.2 (GND)
unnamed: R3903.1, U3901.42 (RSVD)
SEL: R3901.1, U3901.17 (SEL), U3902.6 (IN)
VCC_3V3: C3901.1, C3902.1, U3901.5 (V_{CC}[1:0]), U3901.13 (V_{CC}[1:0]), U3902.5 (V_{+})

Notes on the sheet:
DCSCI edge (NC)
PERST
REFCLK / PCIe x1
CEM edge (DxB)
SEL = H
DCSCI edge (DxA)
CEM edge (NO)
Truth table:
Channels from/to BMC
SEL = L
