rivosinc/scampi/sch/mux_usbc_dev.kicad_sch

## KiCad design sch/mux_usbc_dev.kicad_sch (2025-05-27)

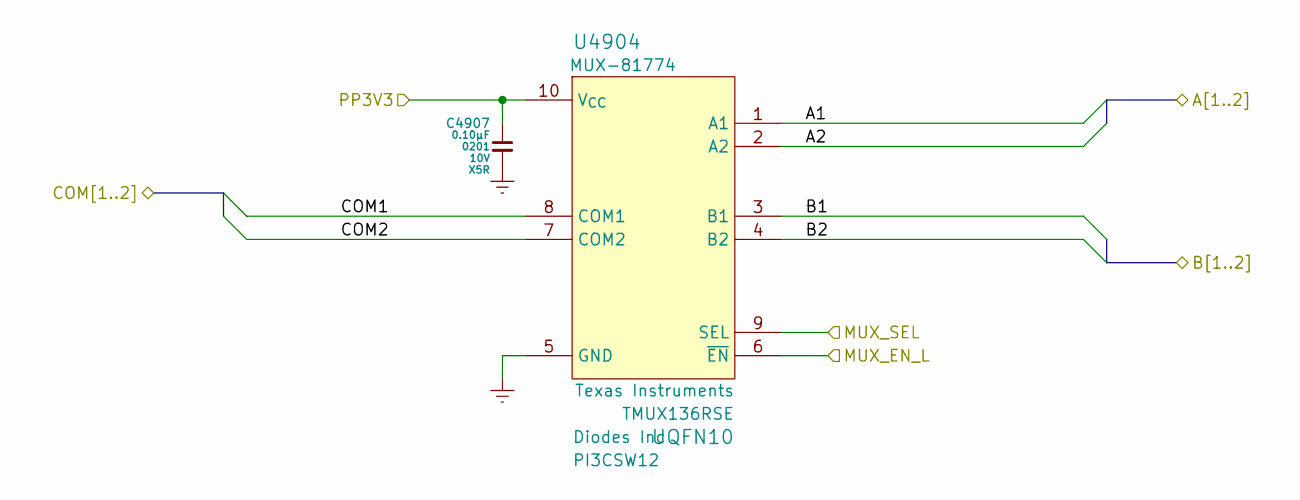
[picture p48: schematic mux_usbc_dev.kicad_sch]

Parts:
C4907: CCM-610AA; mpn GRM033R61A104ME15
U4904: MUX-81774; mpn TMUX136RSE

Connections:
A1: U4904.1 (A1)
A2: U4904.2 (A2)
B1: U4904.3 (B1)
B2: U4904.4 (B2)
COM1: U4904.8 (COM1)
COM2: U4904.7 (COM2)
GND: C4907.2, U4904.5 (GND)
MUX_EN_L: U4904.6 (~EN)
MUX_SEL: U4904.9 (SEL)
PP3V3: C4907.1, U4904.10 (V_{CC})
