rivosinc/scampi/sch/pcie.kicad_sch

## KiCad design sch/pcie.kicad_sch (2025-05-27)

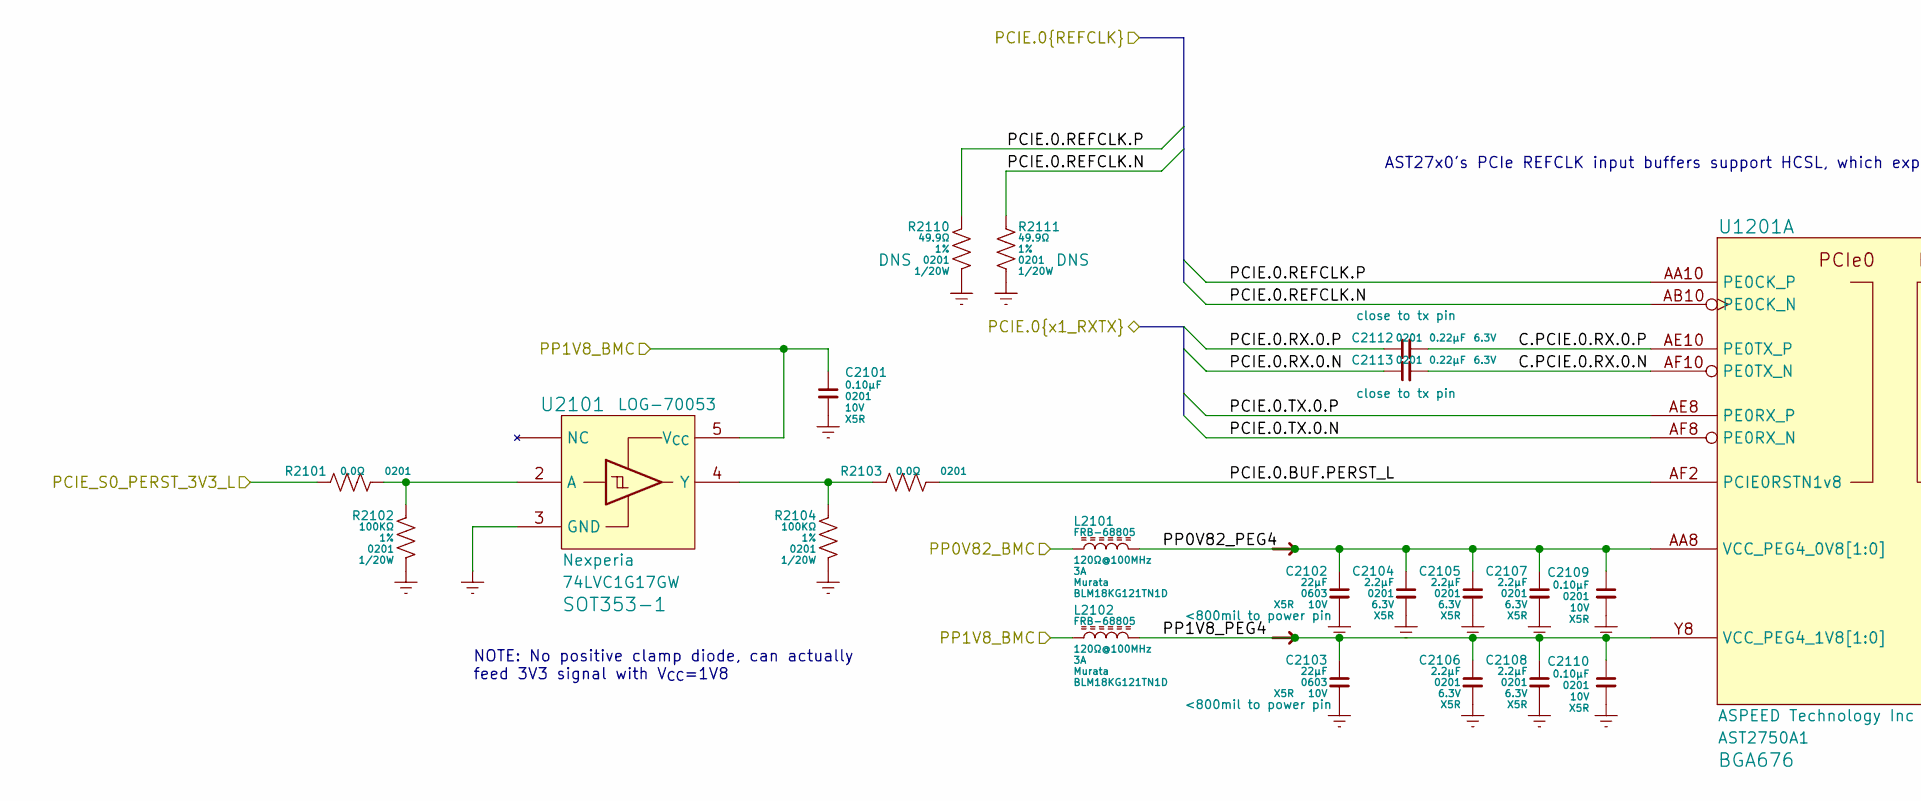
[picture p49: schematic pcie.kicad_sch, part in row 1, column 1]

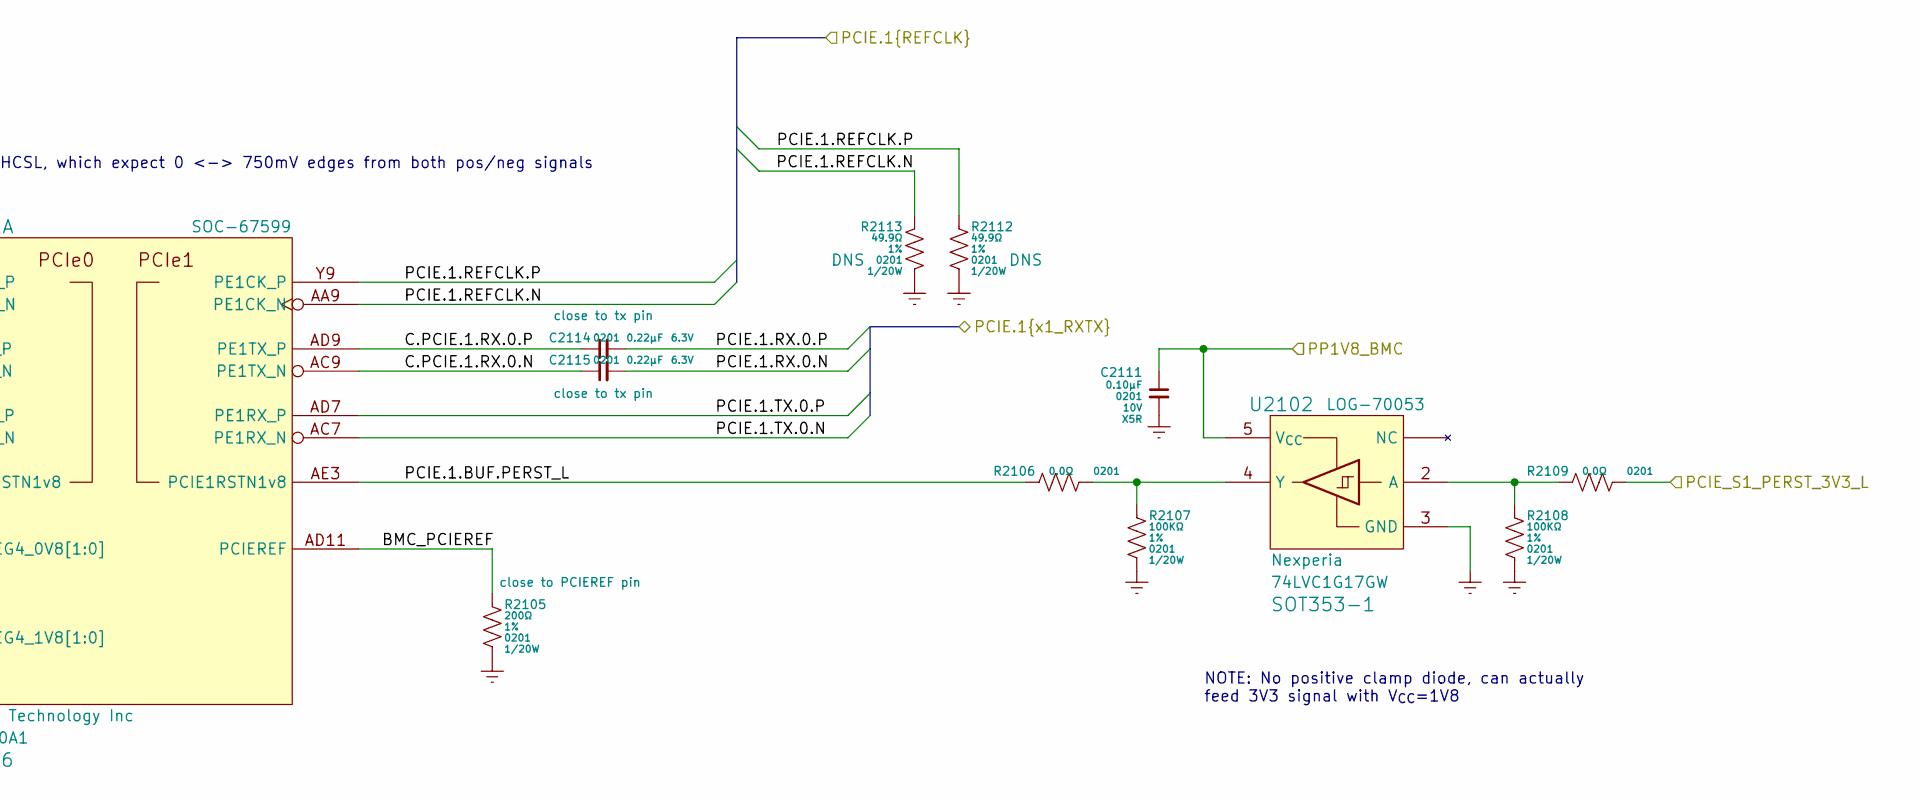
[picture p50: schematic pcie.kicad_sch, part in row 1, column 2]

Parts:
C2101, C2109, C2110, C2111: CCM-610AA; mpn GRM033R61A104ME15
C2102, C2103: CCM-822CC; mpn GRM188R61A226ME15
C2104, C2105, C2106, C2107, C2108: CCM-722AA; mpn GRM033R60J225ME01
C2112, C2113, C2114, C2115: CCM-622AA; mpn GRM033R60J224ME15
L2101, L2102: FRB-68805; mpn BLM18KG121TN1D
R2101, R2103, R2106, R2109: RES-0000A
R2102, R2104, R2107, R2108: RES-6100A
R2105: RES-3200A
R2110, R2111, R2112, R2113: RES-2499A
U1201: SOC-67599; mpn AST2750A1
U2101, U2102: LOG-70053; mpn 74LVC1G17GW

Connections:
BMC_PCIEREF: R2105.1, U1201.AD11 (PCIEREF)
C.PCIE.0.RX.0.N: C2113.2, U1201.AF10 (PE0TX_N)
C.PCIE.0.RX.0.P: C2112.2, U1201.AE10 (PE0TX_P)
C.PCIE.1.RX.0.N: C2115.1, U1201.AC9 (PE1TX_N)
C.PCIE.1.RX.0.P: C2114.1, U1201.AD9 (PE1TX_P)
GND: C2101.2, C2102.2, C2103.2, C2104.2, C2105.2, C2106.2, C2107.2, C2108.2, C2109.2, C2110.2, C2111.2, R2102.2, R2104.2, R2105.2, R2107.2, R2108.2, R2110.2, R2111.2, R2112.2, R2113.2, U2101.3 (GND), U2102.3 (GND)
unnamed: R2101.2, R2102.1, U2101.2 (A)
unnamed: R2103.1, R2104.1, U2101.4 (Y)
unnamed: R2106.2, R2107.1, U2102.4 (Y)
unnamed: R2108.1, R2109.1, U2102.2 (A)
PCIE.0.BUF.PERST_L: R2103.2, U1201.AF2 (PCIE0RSTN1v8)
PCIE.0.REFCLK.N: R2111.1, U1201.AB10 (PE0CK_N)
PCIE.0.REFCLK.P: R2110.1, U1201.AA10 (PE0CK_P)
PCIE.0.RX.0.N: C2113.1
PCIE.0.RX.0.P: C2112.1
PCIE.0.TX.0.N: U1201.AF8 (PE0RX_N)
PCIE.0.TX.0.P: U1201.AE8 (PE0RX_P)
PCIE.1.BUF.PERST_L: R2106.1, U1201.AE3 (PCIE1RSTN1v8)
PCIE.1.REFCLK.N: R2113.1, U1201.AA9 (PE1CK_N)
PCIE.1.REFCLK.P: R2112.1, U1201.Y9 (PE1CK_P)
PCIE.1.RX.0.N: C2115.2
PCIE.1.RX.0.P: C2114.2
PCIE.1.TX.0.N: U1201.AC7 (PE1RX_N)
PCIE.1.TX.0.P: U1201.AD7 (PE1RX_P)
PCIE_S0_PERST_3V3_L: R2101.1
PCIE_S1_PERST_3V3_L: R2109.2
PP0V82_BMC: L2101.1
PP0V82_PEG4: C2102.1, C2104.1, C2105.1, C2107.1, C2109.1, L2101.2, U1201.AA8 (VCC_PEG4_0V8[1:0]), U1201.AB8 (VCC_PEG4_0V8[1:0])
PP1V8_BMC: C2101.1, C2111.1, L2102.1, U2101.5 (V_{CC}), U2102.5 (V_{CC})
PP1V8_PEG4: C2103.1, C2106.1, C2108.1, C2110.1, L2102.2, U1201.AA7 (VCC_PEG4_1V8[1:0]), U1201.Y8 (VCC_PEG4_1V8[1:0])

Notes on the sheet:
NOTE: No positive clamp diode, can actually feed 3V3 signal with V_{CC}=1V8
AST27x0's PCIe REFCLK input buffers support HCSL, which expect 0 <-> 750mV edges from both pos/neg signals
