rivosinc/scampi/sch/power.kicad_sch

## KiCad design sch/power.kicad_sch (2025-05-27)

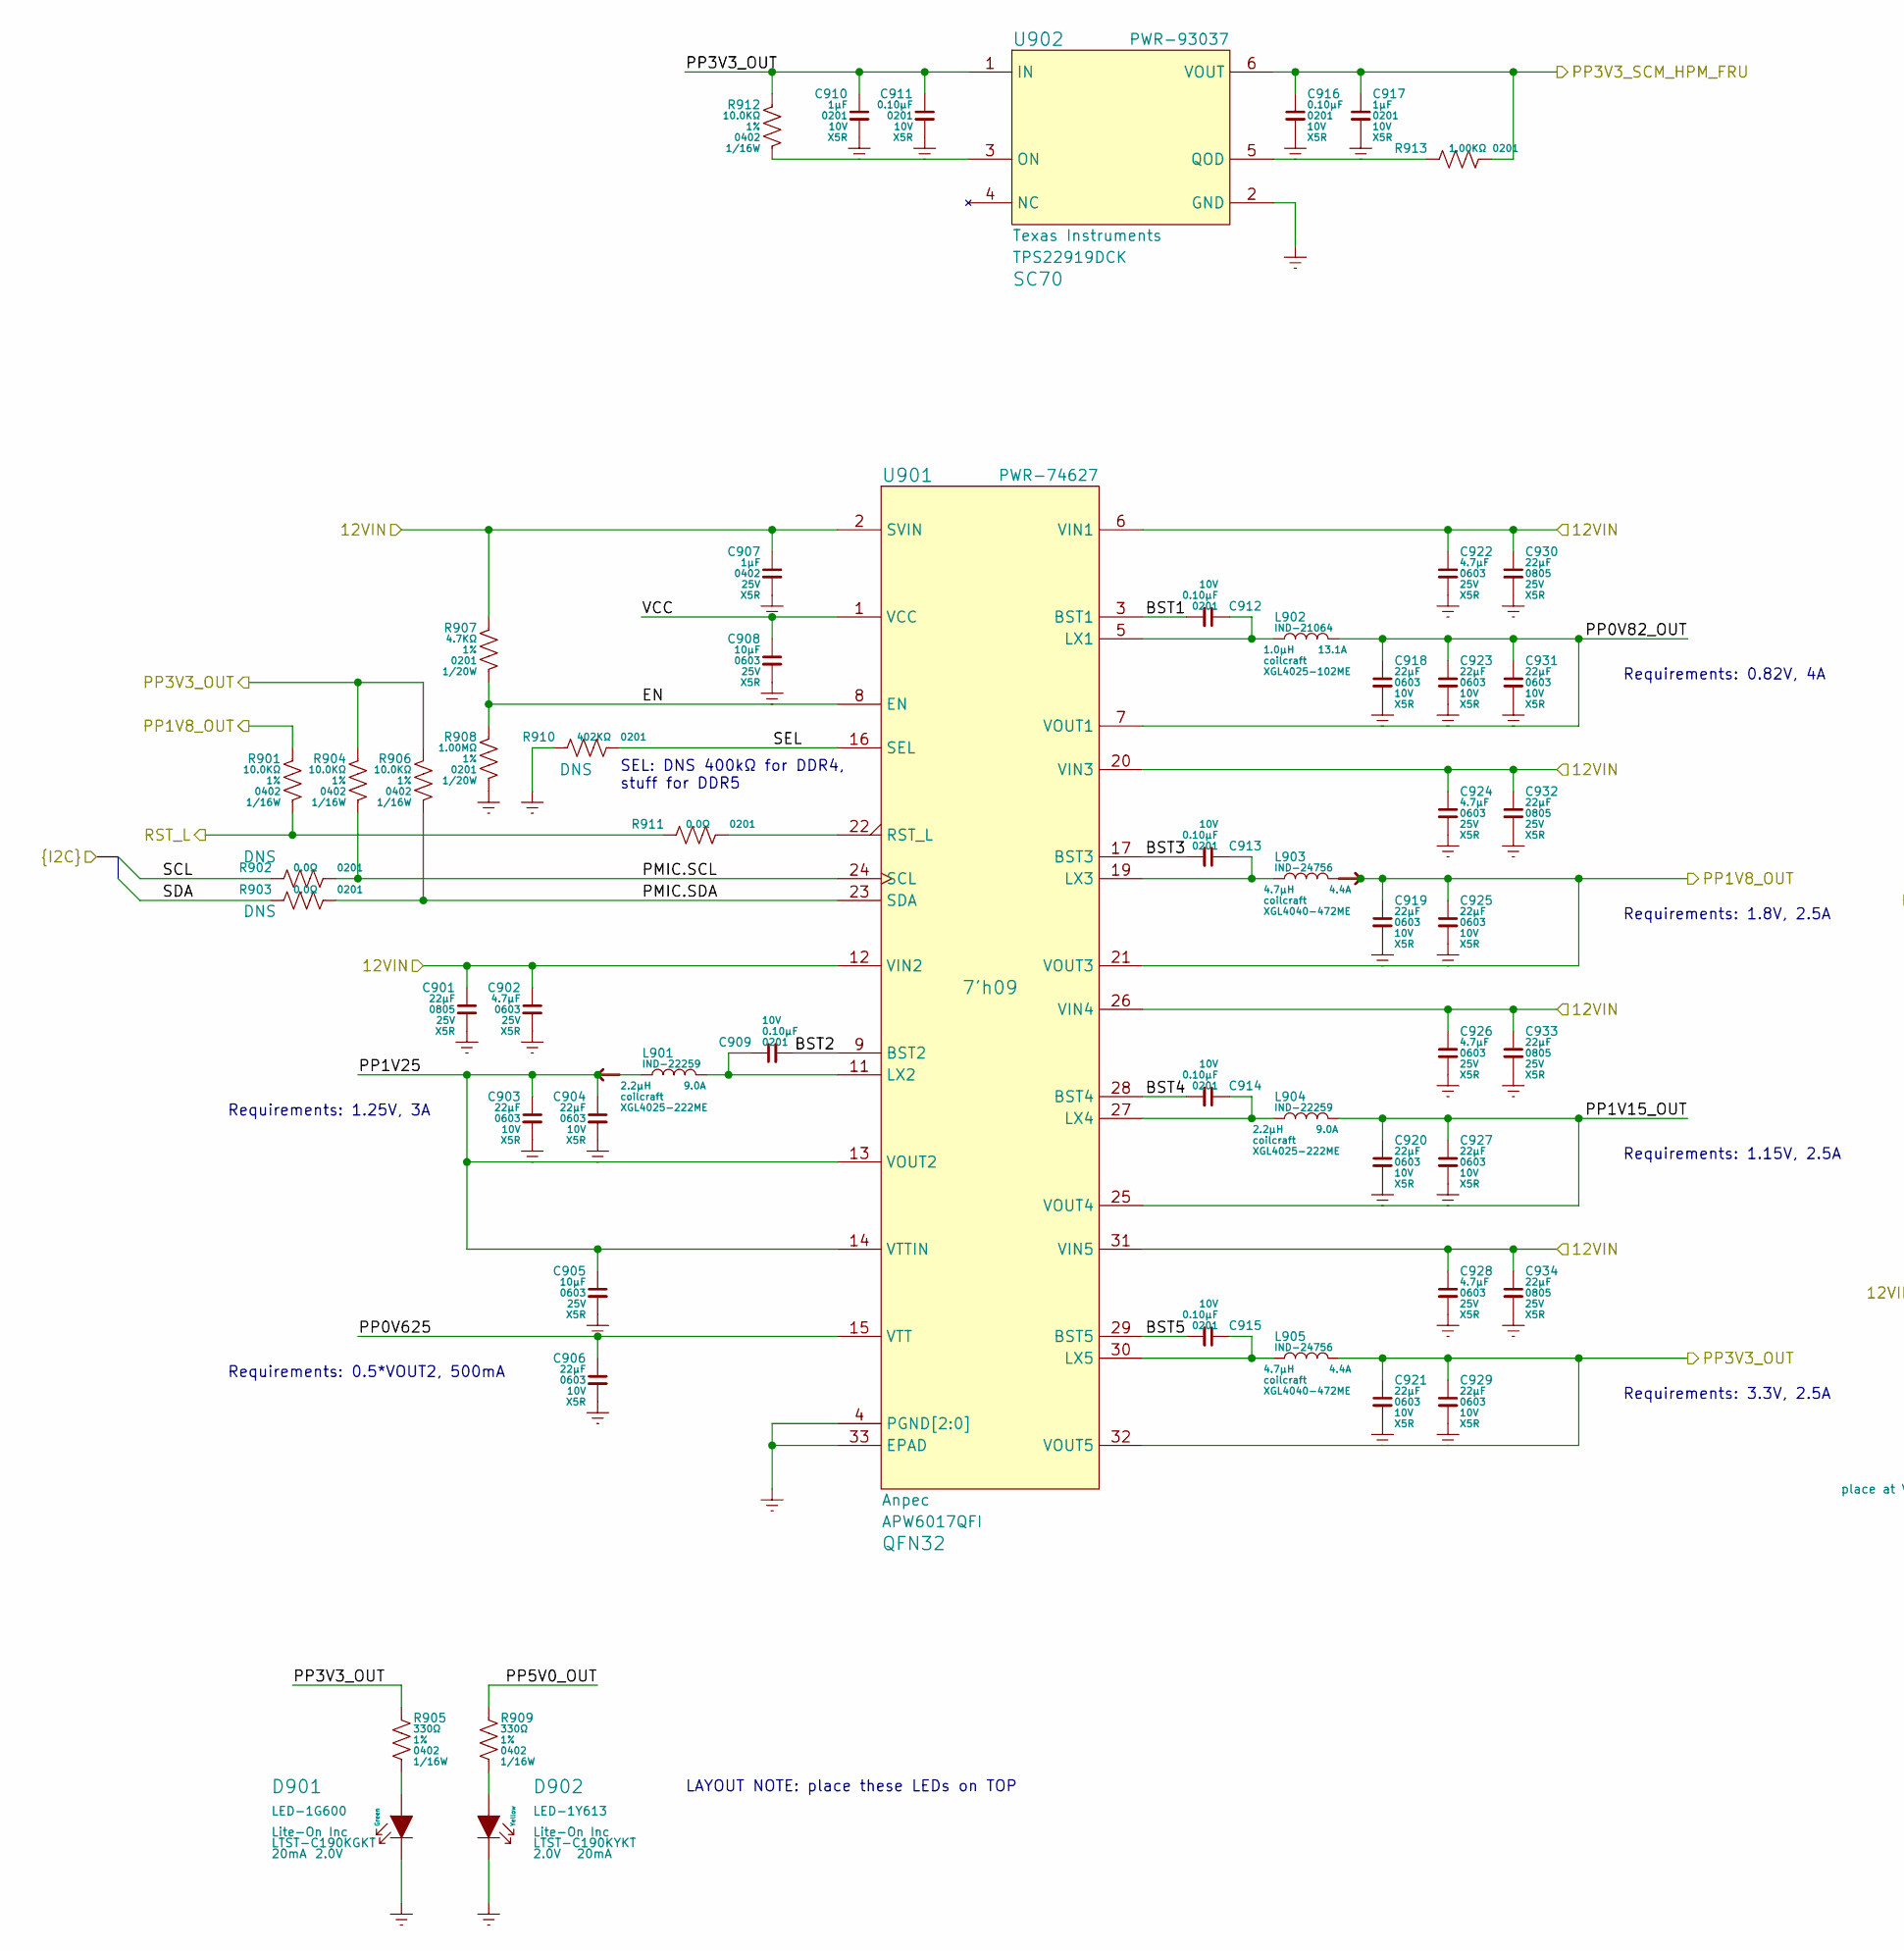
[picture p51: schematic power.kicad_sch, part in row 1, column 1]

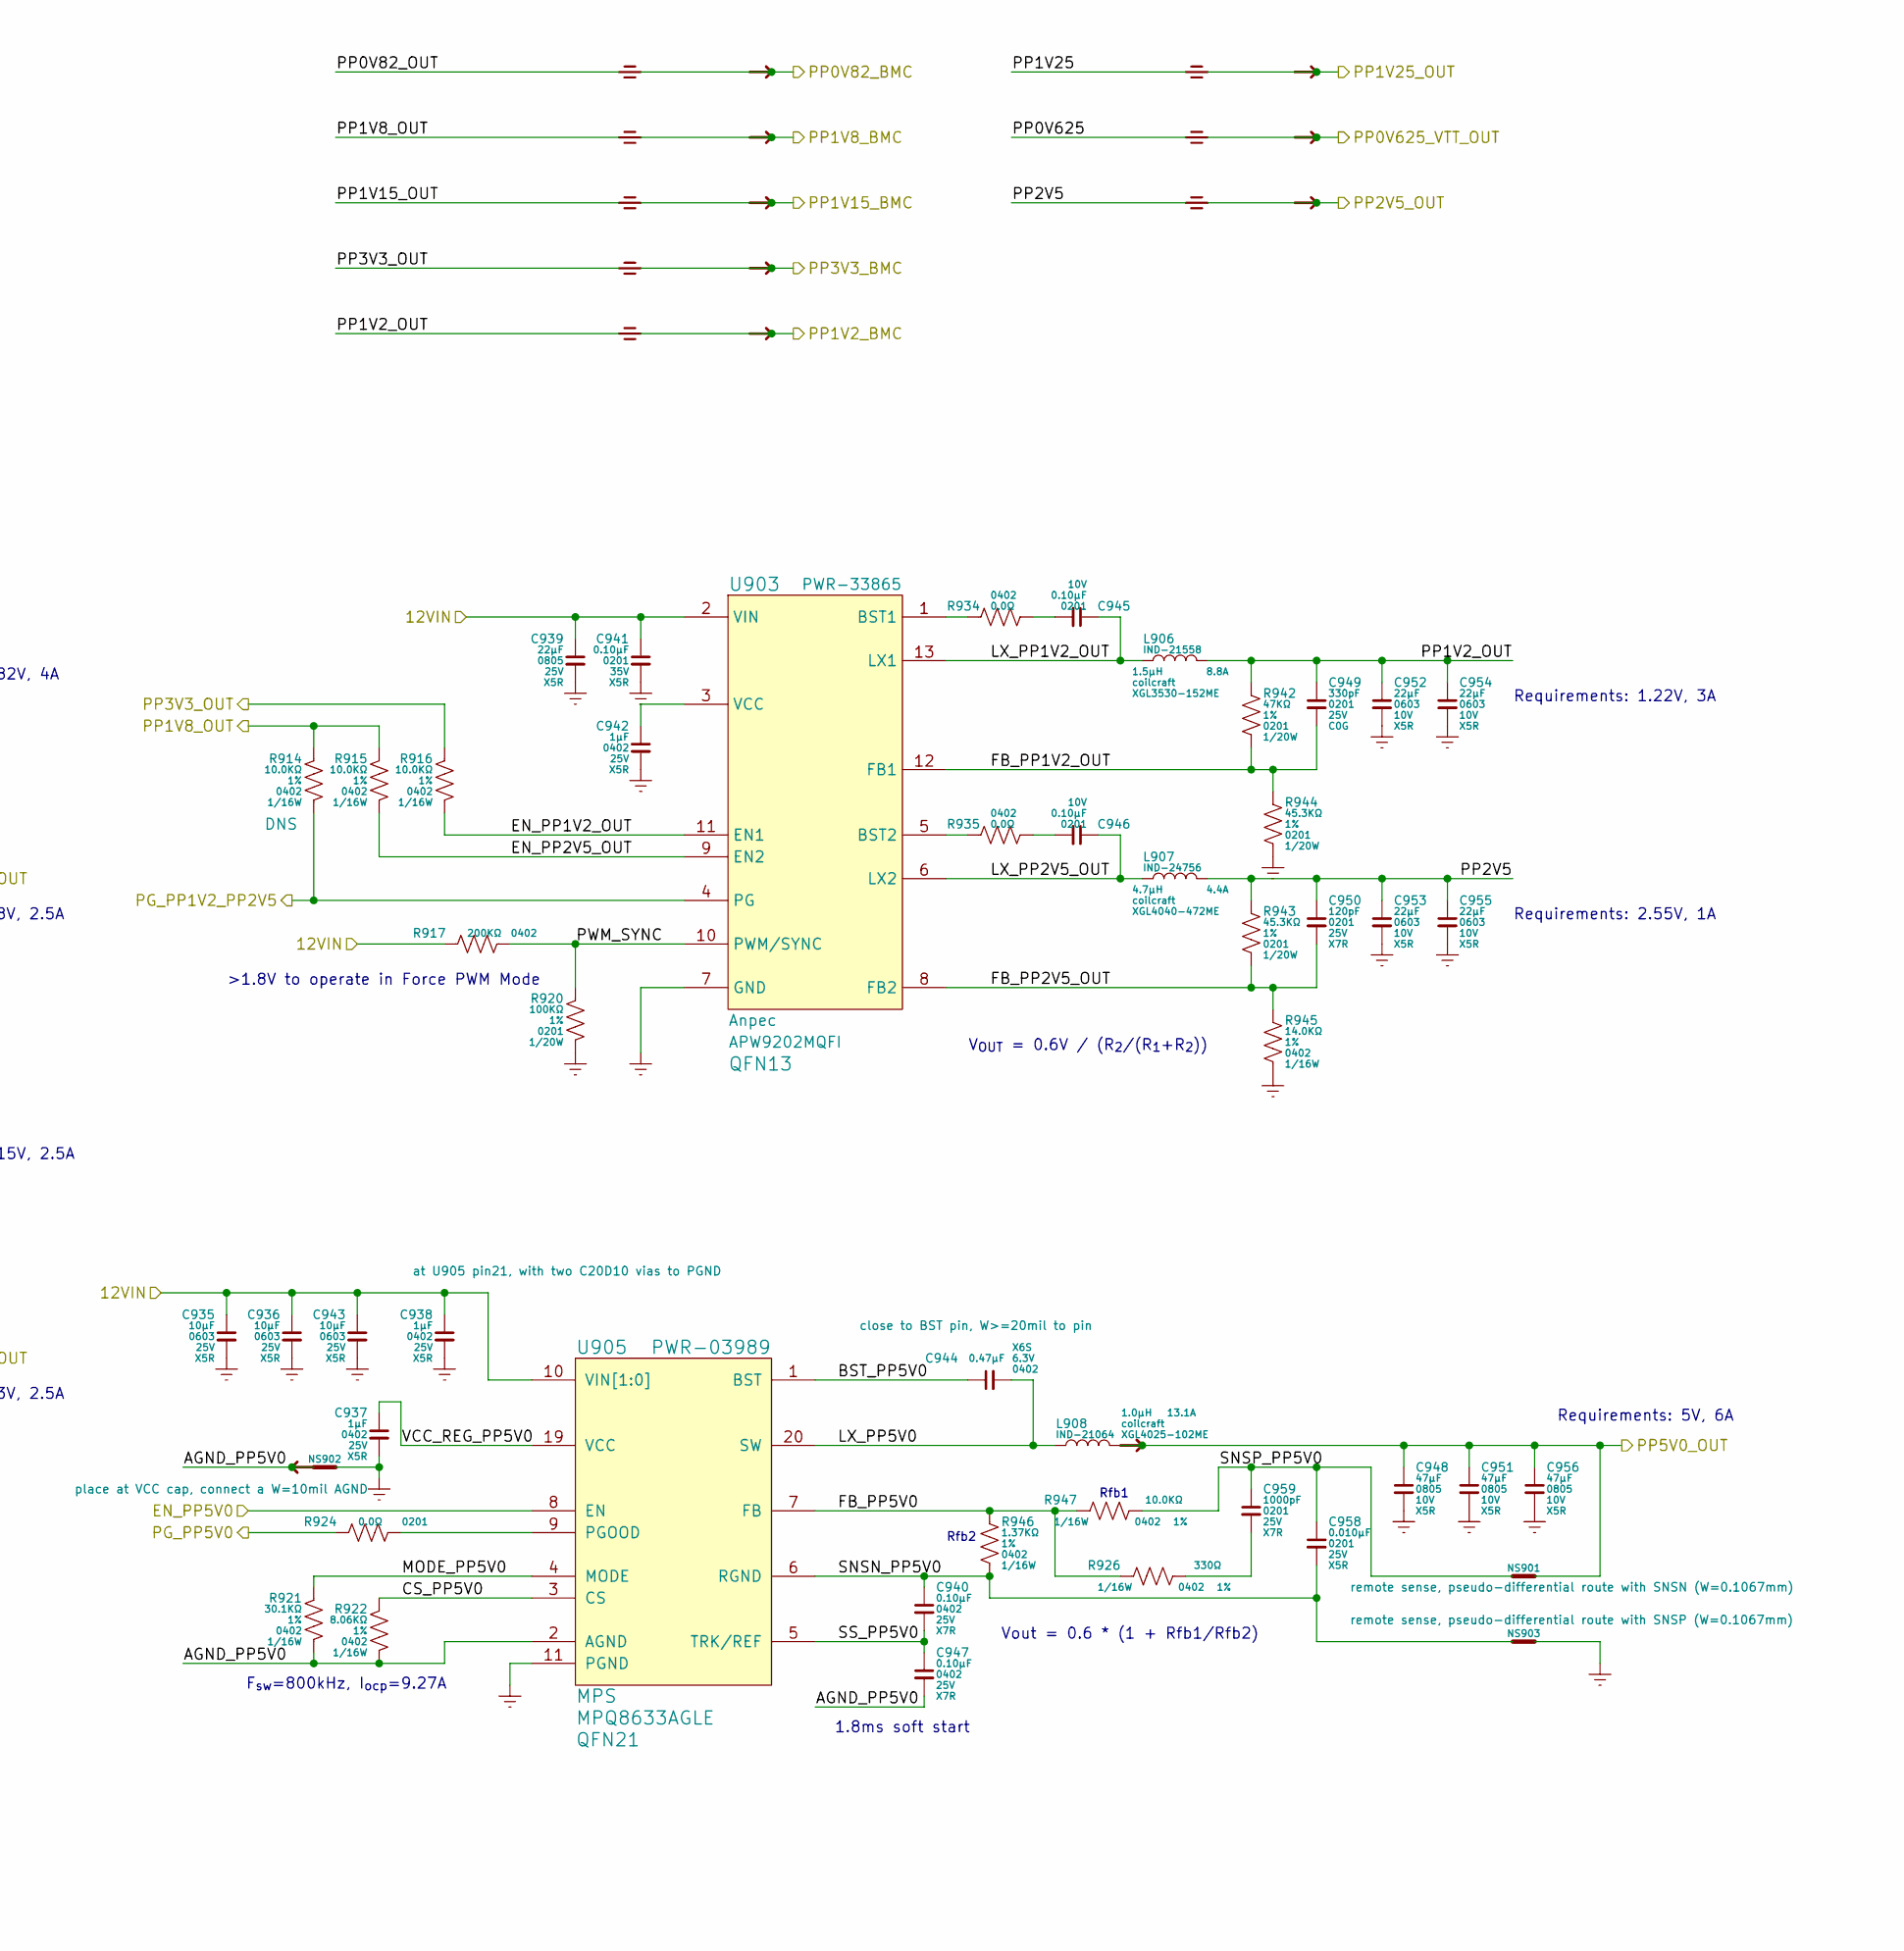
[picture p52: schematic power.kicad_sch, part in row 1, column 2]

Parts:
C901, C930, C932, C933, C934, C939: CCM-822DE; mpn GRM21BR61E226ME44
C902, C922, C924, C926, C928: CCM-747CB; mpn GRM188R61E475KE11
C903, C904, C906, C918, C919, C920, C921, C923, C925, C927, C929, C931, C952, C953, C954, C955: CCM-822CC; mpn GRM188R61A226ME15
C905, C908, C935, C936, C943: CCM-810CE; mpn GRM188R61E106KA73
C907, C937, C938, C942: CCM-710BC; mpn GRM155R61E105KA12
C909, C911, C912, C913, C914, C915, C916, C945, C946: CCM-610AA; mpn GRM033R61A104ME15
C910, C917: CCM-710AD; mpn GRM033R61A105ME15
C940, C947: CCM-610BA; mpn GRM155R71E104KE14
C941: CCM-610AE; mpn GRM033R6YA104ME14
C944: CCM-647BA; mpn GRM155C80J474KE19
C948, C951, C956: CCM-847DB; mpn GRM21BR61A476ME15
C949: CCM-333AA; mpn GRM0335C1E331JA01
C950: CCM-312AA; mpn GRM033R71E121KA01
C958: CCM-510AC; mpn GRM033R61E103MA12
C959: CCM-410AA; mpn GRM033R71E102KA01
D901: LED-1G600; mpn LTST-C190KGKT
D902: LED-1Y613; mpn LTST-C190KYKT
L901, L904: IND-22259; mpn XGL4025-222ME
L902, L908: IND-21064; mpn XGL4025-102ME
L903, L905, L907: IND-24756; mpn XGL4040-472ME
L906: IND-21558; mpn XGL3530-152ME
NS901, NS902, NS903: NET-10102
NT902, NT903, NT904, NT905, NT906, NT907, NT908, NT909: NET-10002
R901, R904, R906, R912, R914, R915, R916, R947: RES-5100B
R902, R903, R911, R924: RES-0000A
R905, R909, R926: RES-3330B
R907: RES-4470A
R908: RES-7100A
R910: RES-6402A
R913: RES-4100A
R917: RES-6200B
R920: RES-6100A
R921: RES-5301B
R922: RES-4806B
R934, R935: RES-0000B
R942: RES-5470A
R943, R944: RES-5453A
R945: RES-5140B
R946: RES-4137B
U901: PWR-74627; mpn APW6017QFI
U902: PWR-93037; mpn TPS22919DCK
U903: PWR-33865; mpn APW9202MQFI
U905: PWR-03989; mpn MPQ8633AGLE

Connections:
12VIN: C901.1, C902.1, C907.1, C922.1, C924.1, C926.1, C928.1, C930.1, C932.1, C933.1, C934.1, C935.1, C936.1, C938.1, C939.1, C941.1, C943.1, R907.1, R917.1, U901.2 (SVIN), U901.6 (VIN1), U901.12 (VIN2), U901.20 (VIN3), U901.26 (VIN4), U901.31 (VIN5), U903.2 (VIN), U905.10 (VIN[1:0]), U905.21 (VIN[1:0])
AGND_PP5V0: C947.2, NS902.1, R921.2, R922.2, U905.2 (AGND)
BST1: C912.2, U901.3 (BST1)
BST2: C909.2, U901.9 (BST2)
BST3: C913.2, U901.17 (BST3)
BST4: C914.2, U901.28 (BST4)
BST5: C915.2, U901.29 (BST5)
BST_PP5V0: C944.1, U905.1 (BST)
CS_PP5V0: R922.1, U905.3 (CS)
EN: R907.2, R908.1, U901.8 (EN)
EN_PP1V2_OUT: R916.2, U903.11 (EN1)
EN_PP2V5_OUT: R915.2, U903.9 (EN2)
EN_PP5V0: U905.8 (EN)
FB_PP1V2_OUT: C949.2, R942.2, R944.1, U903.12 (FB1)
FB_PP2V5_OUT: C950.2, R943.2, R945.1, U903.8 (FB2)
FB_PP5V0: R926.2, R946.1, R947.2, U905.7 (FB)
GND: C901.2, C902.2, C903.2, C904.2, C905.2, C906.2, C907.2, C908.2, C910.2, C911.2, C916.2, C917.2, C918.2, C919.2, C920.2, C921.2, C922.2, C923.2, C924.2, C925.2, C926.2, C927.2, C928.2, C929.2, C930.2, C931.2, C932.2, C933.2, C934.2, C935.2, C936.2, C937.2, C938.2, C939.2, C941.2, C942.2, C943.2, C948.2, C951.2, C952.2, C953.2, C954.2, C955.2, C956.2, D901.K, D902.K, NS902.2, NS903.2, R908.2, R910.1, R920.2, R944.2, R945.2, U901.4 (PGND[2:0]), U901.10 (PGND[2:0]), U901.18 (PGND[2:0]), U901.33 (EPAD), U902.2 (GND), U903.7 (GND), U905.11 (PGND)
LX_PP1V2_OUT: C945.1, L906.1, U903.13 (LX1)
LX_PP2V5_OUT: C946.1, L907.1, U903.6 (LX2)
LX_PP5V0: C944.2, L908.1, U905.20 (SW)
MODE_PP5V0: R921.1, U905.4 (MODE)
unnamed: C909.1, L901.2, U901.11 (LX2)
unnamed: C912.1, L902.1, U901.5 (LX1)
unnamed: C913.1, L903.1, U901.19 (LX3)
unnamed: C914.1, L904.1, U901.27 (LX4)
unnamed: C915.1, L905.1, U901.30 (LX5)
unnamed: C942.1, U903.3 (VCC)
unnamed: C945.2, R934.2
unnamed: C946.2, R935.2
unnamed: C959.2, R926.1
unnamed: D901.A, R905.2
unnamed: D902.A, R909.2
unnamed: R911.2, U901.22 (RST_L)
unnamed: R912.2, U902.3 (ON)
unnamed: R913.1, U902.5 (QOD)
unnamed: R924.2, U905.9 (PGOOD)
unnamed: R934.1, U903.1 (BST1)
unnamed: R935.1, U903.5 (BST2)
PG_PP1V2_PP2V5: R914.2, U903.4 (PG)
PG_PP5V0: R924.1
PMIC.SCL: R902.2, R904.2, U901.24 (SCL)
PMIC.SDA: R903.2, R906.2, U901.23 (SDA)
PP0V82_BMC: NT902.2
PP0V82_OUT: C918.1, C923.1, C931.1, L902.2, NT902.1, U901.7 (VOUT1)
PP0V625: C906.1, NT908.1, U901.15 (VTT)
PP0V625_VTT_OUT: NT908.2
PP1V2_BMC: NT906.2
PP1V2_OUT: C949.1, C952.1, C954.1, L906.2, NT906.1, R942.1
PP1V8_BMC: NT903.2
PP1V8_OUT: C919.1, C925.1, L903.2, NT903.1, R901.1, R914.1, R915.1, U901.21 (VOUT3)
PP1V15_BMC: NT904.2
PP1V15_OUT: C920.1, C927.1, L904.2, NT904.1, U901.25 (VOUT4)
PP1V25: C903.1, C904.1, C905.1, L901.1, NT907.1, U901.13 (VOUT2), U901.14 (VTTIN)
PP1V25_OUT: NT907.2
PP2V5: C950.1, C953.1, C955.1, L907.2, NT909.1, R943.1
PP2V5_OUT: NT909.2
PP3V3_BMC: NT905.2
PP3V3_OUT: C910.1, C911.1, C921.1, C929.1, L905.2, NT905.1, R904.1, R905.1, R906.1, R912.1, R916.1, U901.32 (VOUT5), U902.1 (IN)
PP3V3_SCM_HPM_FRU: C916.1, C917.1, R913.2, U902.6 (VOUT)
PP5V0_OUT: C948.1, C951.1, C956.1, L908.2, NS901.2, R909.1
PWM_SYNC: R917.2, R920.1, U903.10 (PWM/SYNC)
RST_L: R901.2, R911.1
SCL: R902.1
SDA: R903.1
SEL: R910.2, U901.16 (SEL)
SNSN_PP5V0: C940.1, C958.2, NS903.1, R946.2, U905.6 (RGND)
SNSP_PP5V0: C958.1, C959.1, NS901.1, R947.1
SS_PP5V0: C940.2, C947.1, U905.5 (TRK/REF)
VCC: C908.1, U901.1 (VCC)
VCC_REG_PP5V0: C937.1, U905.19 (VCC)

Notes on the sheet:
Vout = 0.6 * (1 + Rfb1/Rfb2)
Rfb2
LAYOUT NOTE: place these LEDs on TOP
1.8ms soft start
Requirements: 0.5*VOUT2, 500mA
Requirements: 0.82V, 4A
Requirements: 5V, 6A
Rfb1
Requirements: 1.8V, 2.5A
Requirements: 3.3V, 2.5A
Requirements: 1.15V, 2.5A
Requirements: 1.25V, 3A
Requirements: 2.55V, 1A
V_{OUT} = 0.6V / (R_{2}/(R_{1}+R_{2}))
Requirements: 1.22V, 3A
SEL: DNS 400kΩ for DDR4, stuff for DDR5
F_{sw}=800kHz, I_{ocp}=9.27A
>1.8V to operate in Force PWM Mode
