rivosinc/scampi/sch/qspi_mux0.kicad_sch

## KiCad design sch/qspi_mux0.kicad_sch (2025-05-27)

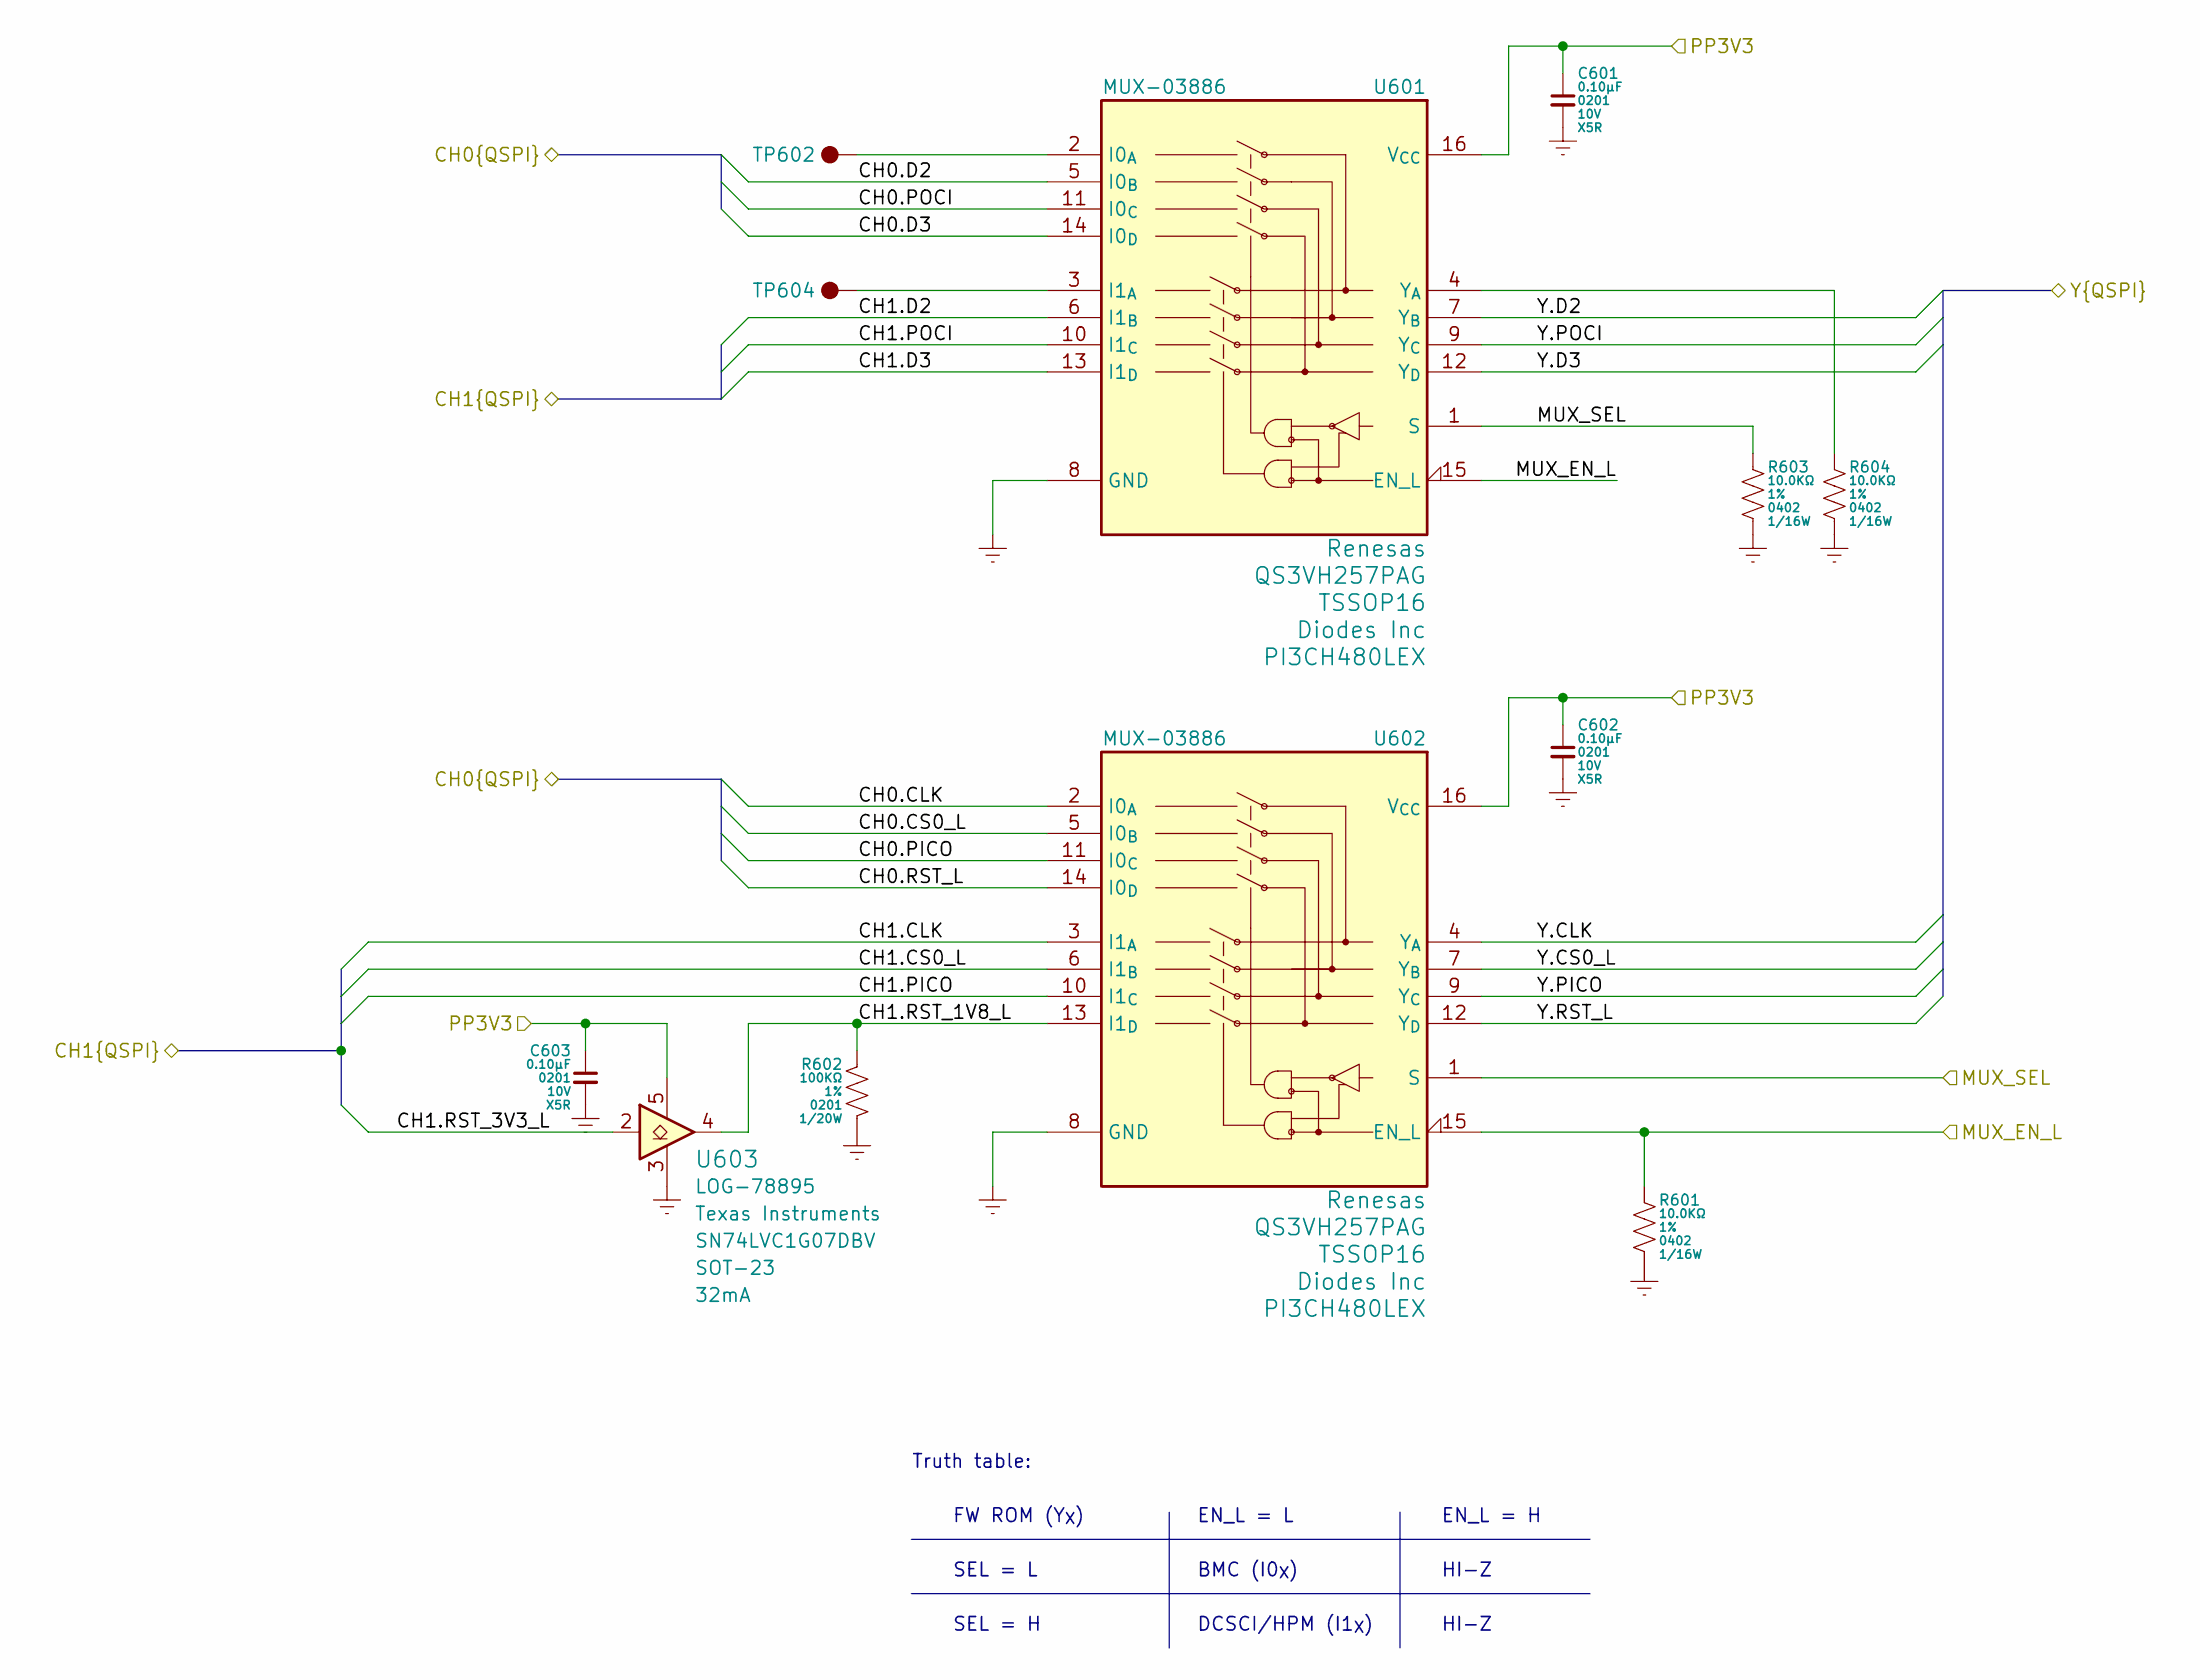
[picture p53: schematic qspi_mux0.kicad_sch]

Parts:
C601, C602, C603: CCM-610AA; mpn GRM033R61A104ME15
R601, R603, R604: RES-5100B
R602: RES-6100A
TP602, TP604: TST-01025
U601, U602: MUX-03886; mpn QS3VH257PAG
U603: LOG-78895; mpn SN74LVC1G07DBV

Connections:
CH0.CLK: U602.2 (I0_{A})
CH0.CS0_L: U602.5 (I0_{B})
CH0.D2: U601.5 (I0_{B})
CH0.D3: U601.14 (I0_{D})
CH0.PICO: U602.11 (I0_{C})
CH0.POCI: U601.11 (I0_{C})
CH0.RST_L: U602.14 (I0_{D})
CH1.CLK: U602.3 (I1_{A})
CH1.CS0_L: U602.6 (I1_{B})
CH1.D2: U601.6 (I1_{B})
CH1.D3: U601.13 (I1_{D})
CH1.PICO: U602.10 (I1_{C})
CH1.POCI: U601.10 (I1_{C})
CH1.RST_1V8_L: R602.1, U602.13 (I1_{D})
GND: C601.2, C602.2, C603.2, R601.2, R602.2, R603.2, R604.2, U601.8 (GND), U602.8 (GND)
MUX_EN_L: R601.1, U601.15 (EN_L), U602.15 (EN_L)
MUX_SEL: R603.1, U601.1 (S), U602.1 (S)
unnamed: R604.1, U601.4 (Y_{A})
unnamed: TP602.1, U601.2 (I0_{A})
unnamed: TP604.1, U601.3 (I1_{A})
PP3V3: C601.1, C602.1, C603.1, U601.16 (V_{CC}), U602.16 (V_{CC})
Y.CLK: U602.4 (Y_{A})
Y.CS0_L: U602.7 (Y_{B})
Y.D2: U601.7 (Y_{B})
Y.D3: U601.12 (Y_{D})
Y.PICO: U602.9 (Y_{C})
Y.POCI: U601.9 (Y_{C})
Y.RST_L: U602.12 (Y_{D})

Notes on the sheet:
Truth table:
SEL = L
EN_L = L
FW ROM (Y_{X})
HI-Z
SEL = H
DCSCI/HPM (I1_{X})
EN_L = H
BMC (I0_{X})
