rivosinc/scampi/sch/qspi_mux1.kicad_sch

## KiCad design sch/qspi_mux1.kicad_sch (2025-05-27)

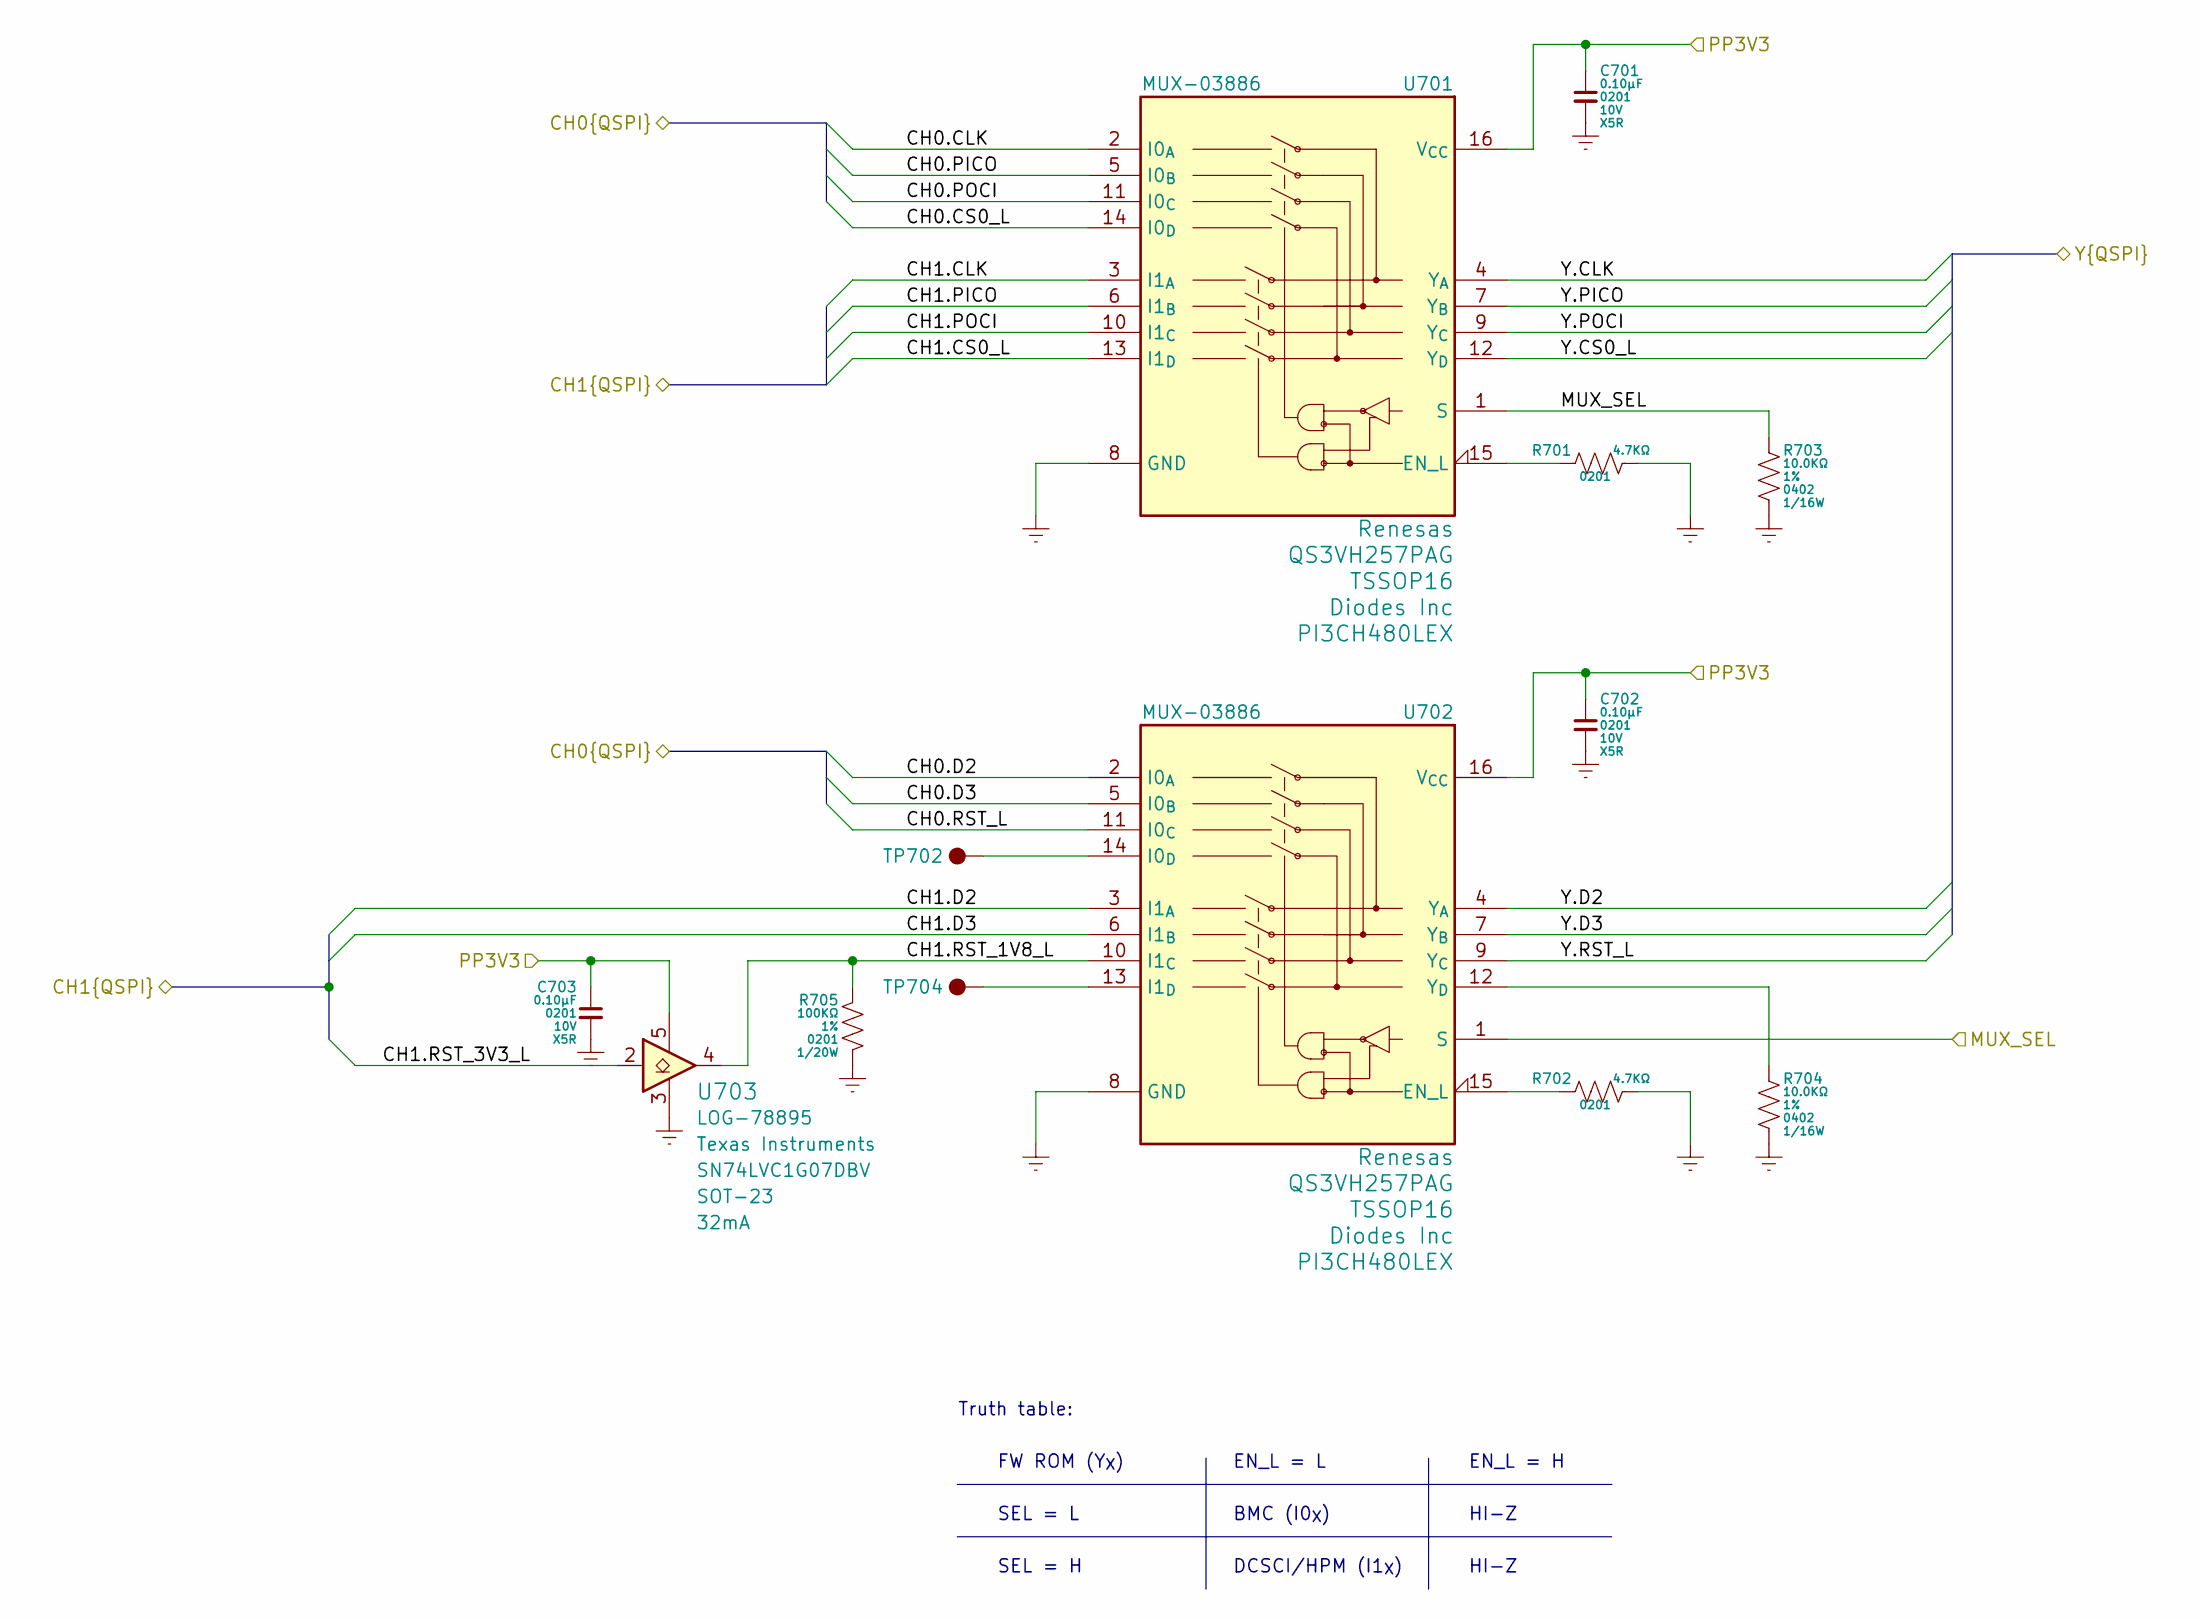
[picture p54: schematic qspi_mux1.kicad_sch]

Parts:
C701, C702, C703: CCM-610AA; mpn GRM033R61A104ME15
R701, R702: RES-4470A
R703, R704: RES-5100B
R705: RES-6100A
TP702, TP704: TST-01025
U701, U702: MUX-03886; mpn QS3VH257PAG
U703: LOG-78895; mpn SN74LVC1G07DBV

Connections:
CH0.CLK: U701.2 (I0_{A})
CH0.CS0_L: U701.14 (I0_{D})
CH0.D2: U702.2 (I0_{A})
CH0.D3: U702.5 (I0_{B})
CH0.PICO: U701.5 (I0_{B})
CH0.POCI: U701.11 (I0_{C})
CH0.RST_L: U702.11 (I0_{C})
CH1.CLK: U701.3 (I1_{A})
CH1.CS0_L: U701.13 (I1_{D})
CH1.D2: U702.3 (I1_{A})
CH1.D3: U702.6 (I1_{B})
CH1.PICO: U701.6 (I1_{B})
CH1.POCI: U701.10 (I1_{C})
CH1.RST_1V8_L: R705.1, U702.10 (I1_{C})
GND: C701.2, C702.2, C703.2, R701.2, R702.2, R703.2, R704.2, R705.2, U701.8 (GND), U702.8 (GND)
MUX_SEL: R703.1, U701.1 (S), U702.1 (S)
unnamed: R701.1, U701.15 (EN_L)
unnamed: R702.1, U702.15 (EN_L)
unnamed: R704.1, U702.12 (Y_{D})
unnamed: TP702.1, U702.14 (I0_{D})
unnamed: TP704.1, U702.13 (I1_{D})
PP3V3: C701.1, C702.1, C703.1, U701.16 (V_{CC}), U702.16 (V_{CC})
Y.CLK: U701.4 (Y_{A})
Y.CS0_L: U701.12 (Y_{D})
Y.D2: U702.4 (Y_{A})
Y.D3: U702.7 (Y_{B})
Y.PICO: U701.7 (Y_{B})
Y.POCI: U701.9 (Y_{C})
Y.RST_L: U702.9 (Y_{C})

Notes on the sheet:
DCSCI/HPM (I1_{X})
SEL = H
EN_L = L
FW ROM (Y_{X})
EN_L = H
SEL = L
HI-Z
BMC (I0_{X})
Truth table:
