rivosinc/scampi/sch/rtc.kicad_sch

## KiCad design sch/rtc.kicad_sch (2025-05-27)

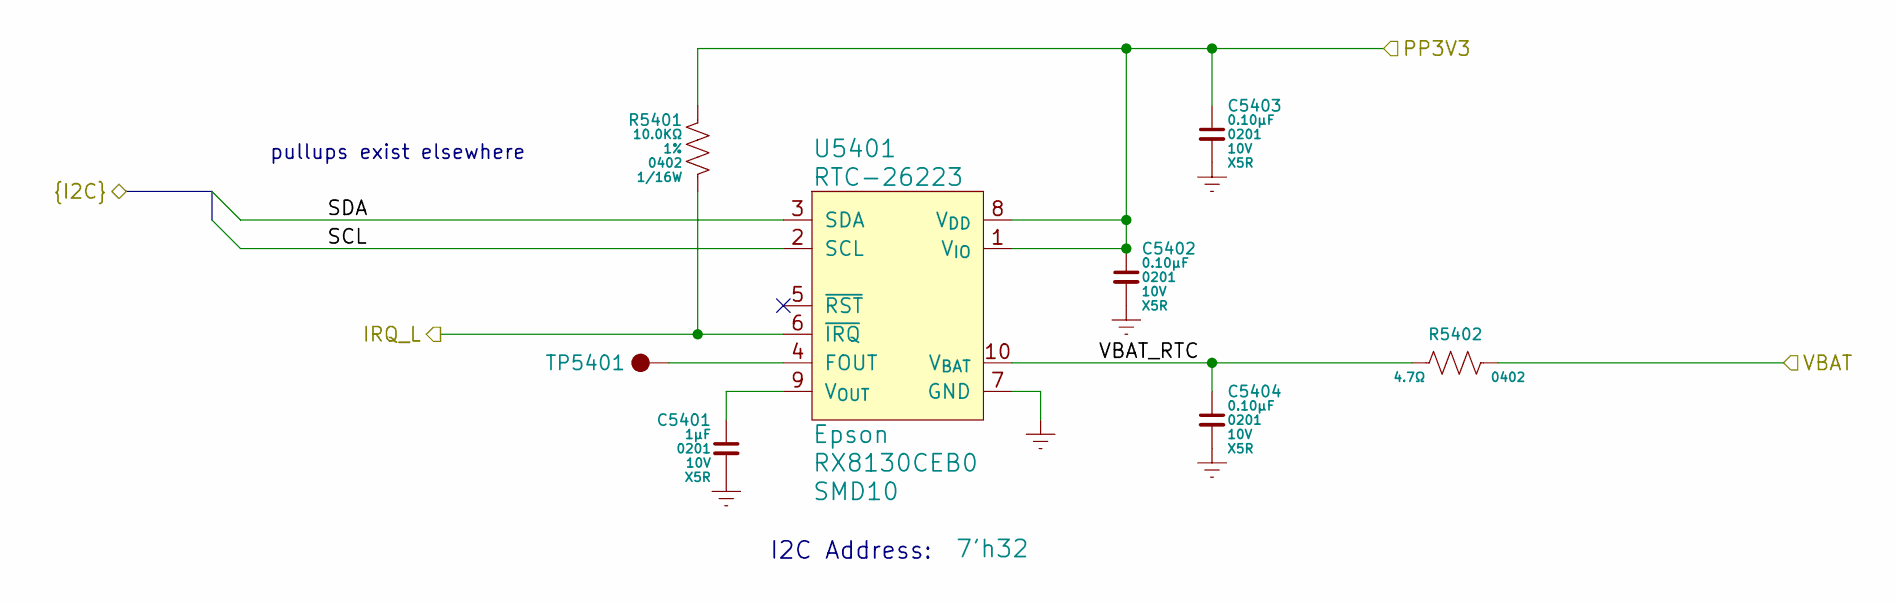
[picture p55: schematic rtc.kicad_sch]

Parts:
C5401: CCM-710AD; mpn GRM033R61A105ME15
C5402, C5403, C5404: CCM-610AA; mpn GRM033R61A104ME15
R5401: RES-5100B
R5402: RES-1470B
TP5401: TST-01025
U5401: RTC-26223; mpn RX8130CEB0

Connections:
GND: C5401.2, C5402.2, C5403.2, C5404.2, U5401.7 (GND)
IRQ_L: R5401.2, U5401.6 (~IRQ)
unnamed: C5401.1, U5401.9 (V_{OUT})
unnamed: TP5401.1, U5401.4 (FOUT)
PP3V3: C5402.1, C5403.1, R5401.1, U5401.1 (V_{IO}), U5401.8 (V_{DD})
SCL: U5401.2 (SCL)
SDA: U5401.3 (SDA)
VBAT: R5402.2
VBAT_RTC: C5404.1, R5402.1, U5401.10 (V_{BAT})

Notes on the sheet:
pullups exist elsewhere
I2C Address:
