rivosinc/scampi/sch/sgpio.kicad_sch

## KiCad design sch/sgpio.kicad_sch (2025-05-27)

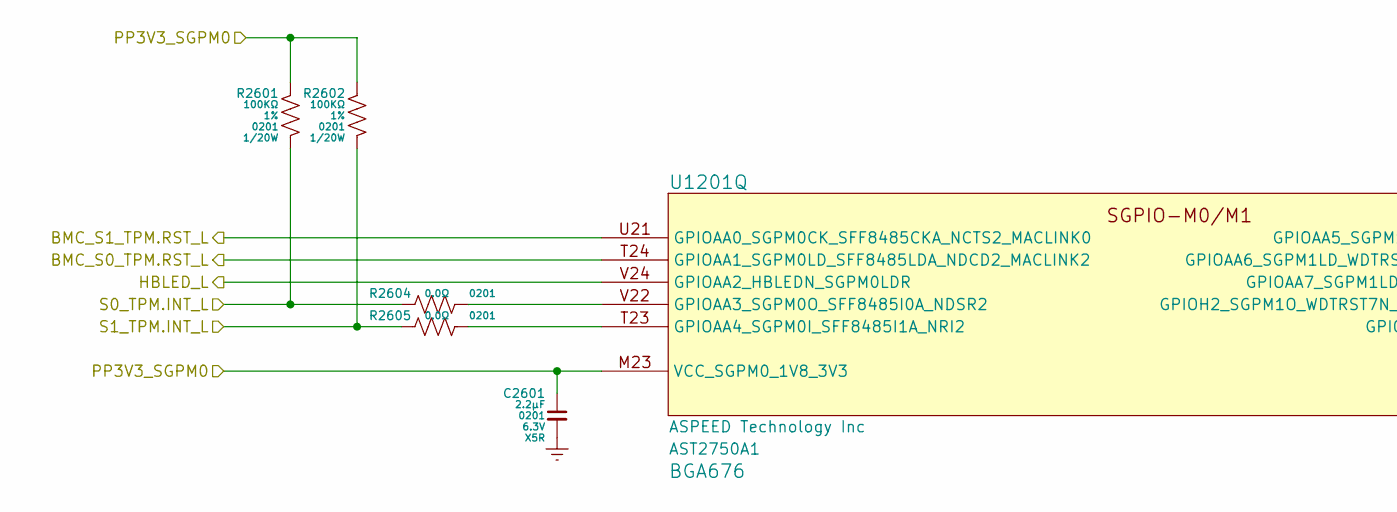
[picture p56: schematic sgpio.kicad_sch, part in row 1, column 1]

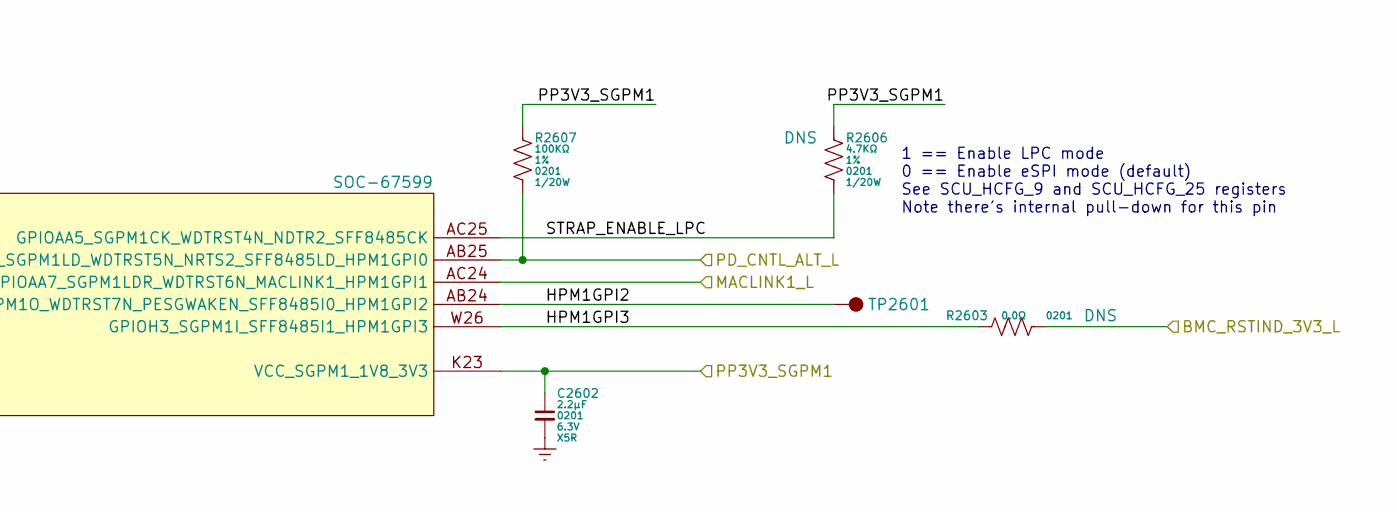
[picture p57: schematic sgpio.kicad_sch, part in row 1, column 2]

Parts:
C2601, C2602: CCM-722AA; mpn GRM033R60J225ME01
R2601, R2602, R2607: RES-6100A
R2603, R2604, R2605: RES-0000A
R2606: RES-4470A
TP2601: TST-01025
U1201: SOC-67599; mpn AST2750A1

Connections:
BMC_RSTIND_3V3_L: R2603.2
BMC_S0_TPM.RST_L: U1201.T24 (GPIOAA1_SGPM0LD_SFF8485LDA_NDCD2_MACLIN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)
BMC_S1_TPM.RST_L: U1201.U21 (GPIOAA0_SGPM0CK_SFF8485CKA_NCTS2_MACLIN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)
GND: C2601.2, C2602.2
HBLED_L: U1201.V24 (GPIOAA2_HBLEDN_SGPM0LDR)
HPM1GPI2: TP2601.1, U1201.AB24 (GPIOH2_SGPM1O_WDTRST7N_PESGWAKEN_SFF848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)
HPM1GPI3: R2603.1, U1201.W26 (GPIOH3_SGPM1I_SFF8485I1_HPM1GPI3)
MACLINK1_L: U1201.AC24 (GPIOAA7_SGPM1LDR_WDTRST6N_MACLINK1_HPM1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)
unnamed: R2604.2, U1201.V22 (GPIOAA3_SGPM0O_SFF8485I0A_NDSR2)
unnamed: R2605.2, U1201.T23 (GPIOAA4_SGPM0I_SFF8485I1A_NRI2)
PD_CNTL_ALT_L: R2607.2, U1201.AB25 (GPIOAA6_SGPM1LD_WDTRST5N_NRTS2_SFF8485L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)
PP3V3_SGPM0: C2601.1, R2601.1, R2602.1, U1201.M23 (VCC_SGPM0_1V8_3V3)
PP3V3_SGPM1: C2602.1, R2606.1, R2607.1, U1201.K23 (VCC_SGPM1_1V8_3V3)
S0_TPM.INT_L: R2601.2, R2604.1
S1_TPM.INT_L: R2602.2, R2605.1
STRAP_ENABLE_LPC: R2606.2, U1201.AC25 (GPIOAA5_SGPM1CK_WDTRST4N_NDTR2_SFF8485CK)

Notes on the sheet:
1 == Enable LPC mode 0 == Enable eSPI mode (default) See SCU_HCFG_9 and SCU_HCFG_25 registers Note there's internal pull-down for this pin
