rivosinc/scampi/sch/spi.kicad_sch

## KiCad design sch/spi.kicad_sch (2025-05-27)

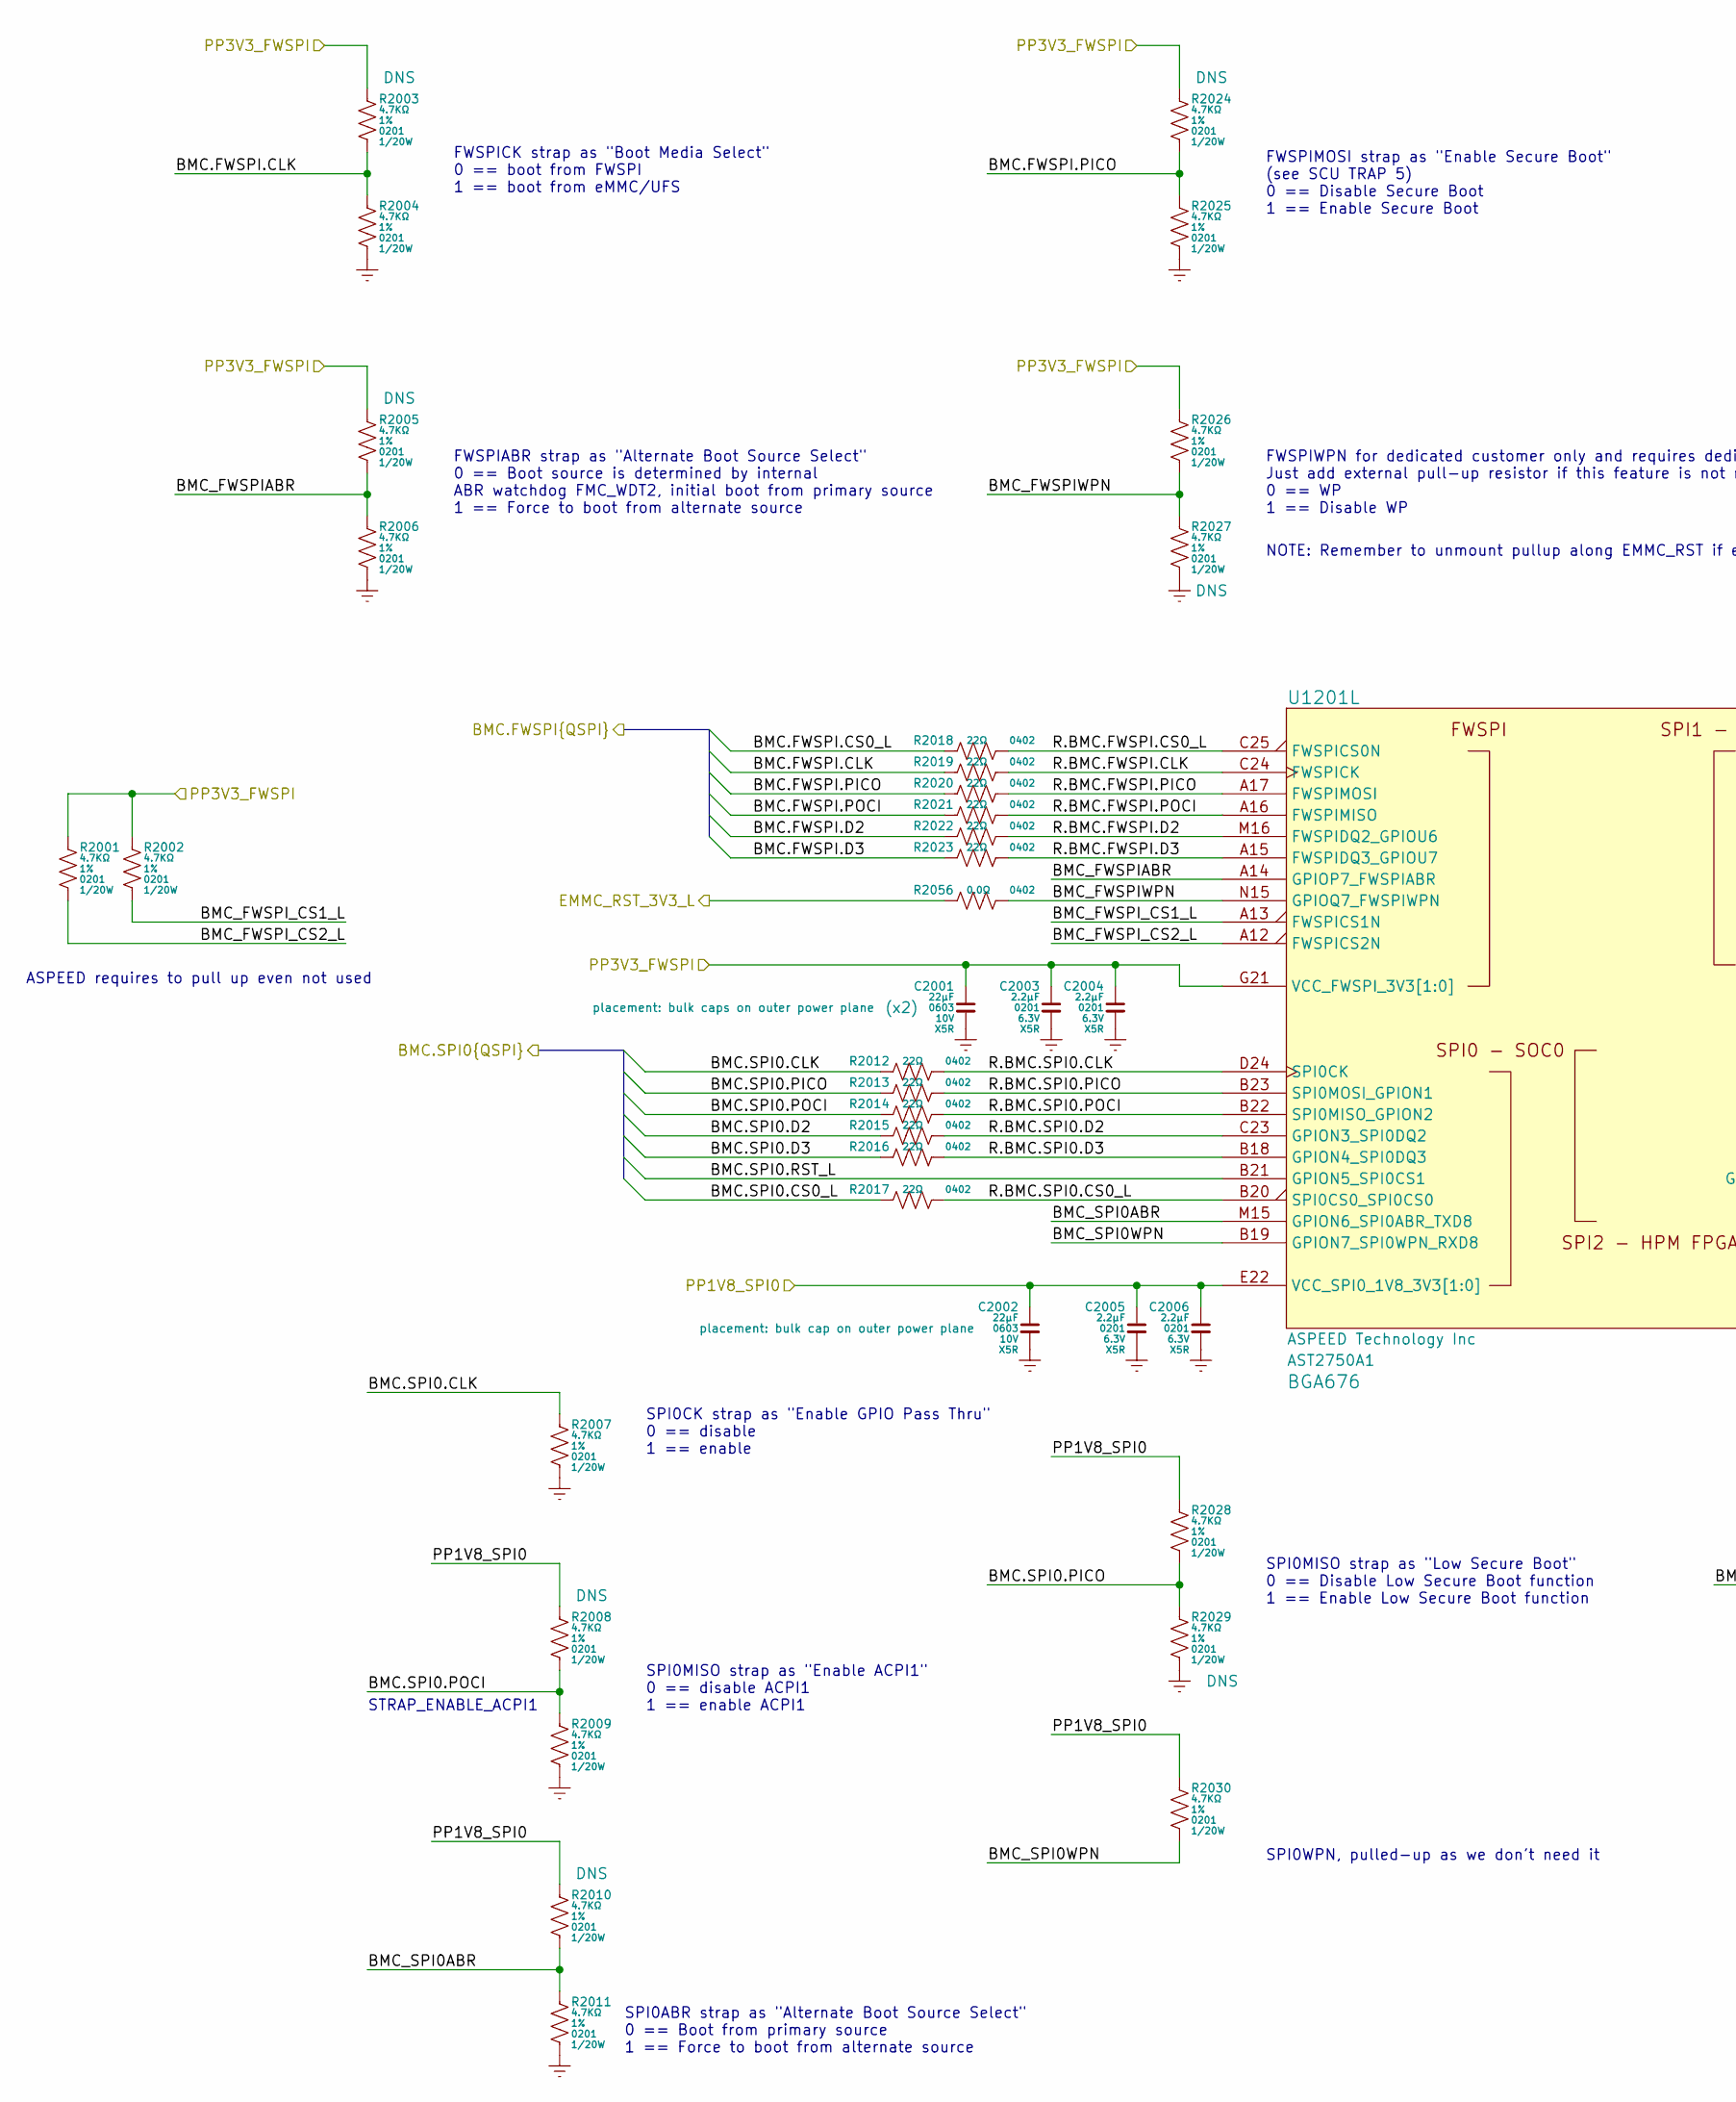
[picture p58: schematic spi.kicad_sch, part in row 1, column 1]

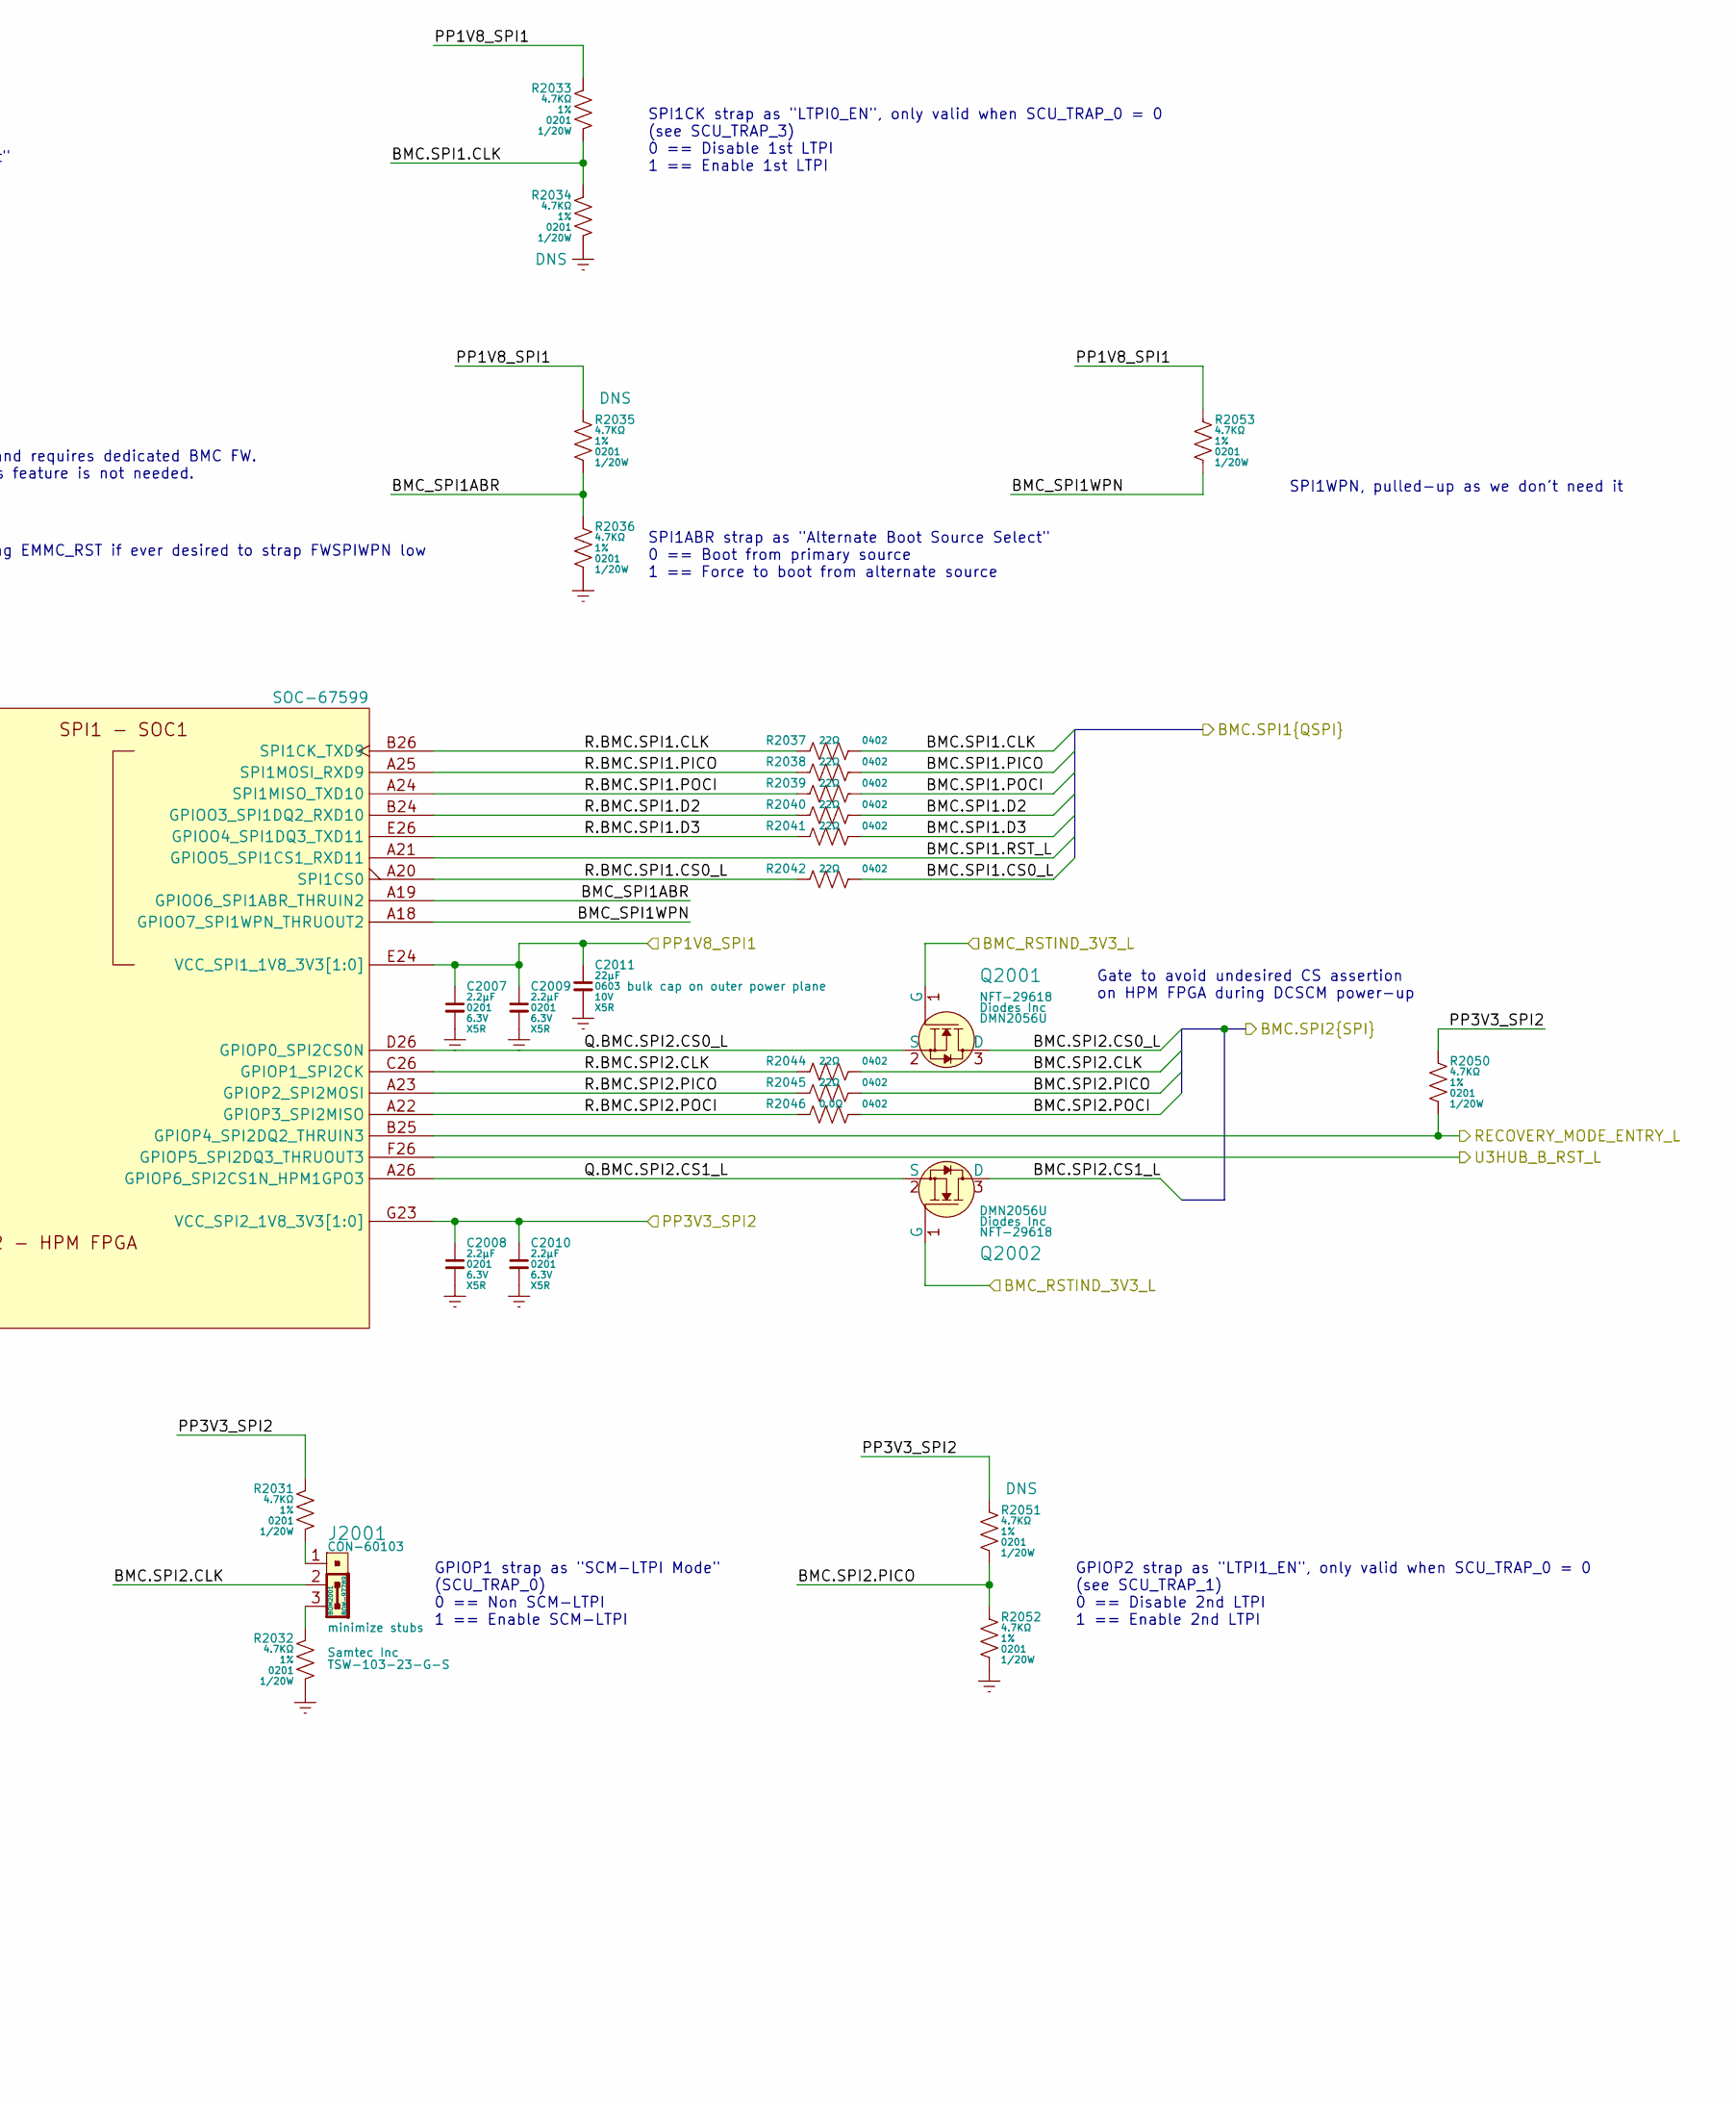
[picture p59: schematic spi.kicad_sch, part in row 1, column 2]

Parts:
BOM2001: BOM-97789; mpn 881545-1
C2001, C2002, C2011: CCM-822CC; mpn GRM188R61A226ME15
C2003, C2004, C2005, C2006, C2007, C2008, C2009, C2010: CCM-722AA; mpn GRM033R60J225ME01
J2001: CON-60103; mpn TSW-103-23-G-S
Q2001, Q2002: NFT-29618; mpn DMN2056U
R2001, R2002, R2003, R2004, R2005, R2006, R2007, R2008, R2009, R2010, R2011, R2024, R2025, R2026, R2027, R2028, R2029, R2030, R2031, R2032, R2033, R2034, R2035, R2036, R2050, R2051, R2052, R2053: RES-4470A
R2012, R2013, R2014, R2015, R2016, R2017, R2018, R2019, R2020, R2021, R2022, R2023, R2037, R2038, R2039, R2040, R2041, R2042, R2044, R2045: RES-2220B
R2046, R2056: RES-0000B
U1201: SOC-67599; mpn AST2750A1

Connections:
BMC.FWSPI.CLK: R2003.2, R2004.1, R2019.1
BMC.FWSPI.CS0_L: R2018.1
BMC.FWSPI.D2: R2022.1
BMC.FWSPI.D3: R2023.1
BMC.FWSPI.PICO: R2020.1, R2024.2, R2025.1
BMC.FWSPI.POCI: R2021.1
BMC.SPI0.CLK: R2007.1, R2012.1
BMC.SPI0.CS0_L: R2017.1
BMC.SPI0.D2: R2015.1
BMC.SPI0.D3: R2016.1
BMC.SPI0.PICO: R2013.1, R2028.2, R2029.1
BMC.SPI0.POCI: R2008.2, R2009.1, R2014.1
BMC.SPI0.RST_L: U1201.B21 (GPION5_SPI0CS1)
BMC.SPI1.CLK: R2033.2, R2034.1, R2037.2
BMC.SPI1.CS0_L: R2042.2
BMC.SPI1.D2: R2040.2
BMC.SPI1.D3: R2041.2
BMC.SPI1.PICO: R2038.2
BMC.SPI1.POCI: R2039.2
BMC.SPI1.RST_L: U1201.A21 (GPIOO5_SPI1CS1_RXD11)
BMC.SPI2.CLK: J2001.2, R2044.2
BMC.SPI2.CS0_L: Q2001.3 (D)
BMC.SPI2.CS1_L: Q2002.3 (D)
BMC.SPI2.PICO: R2045.2, R2051.2, R2052.1
BMC.SPI2.POCI: R2046.2
BMC_FWSPIABR: R2005.2, R2006.1, U1201.A14 (GPIOP7_FWSPIABR)
BMC_FWSPIWPN: R2026.2, R2027.1, R2056.2, U1201.N15 (GPIOQ7_FWSPIWPN)
BMC_FWSPI_CS1_L: R2002.2, U1201.A13 (FWSPICS1N)
BMC_FWSPI_CS2_L: R2001.2, U1201.A12 (FWSPICS2N)
BMC_RSTIND_3V3_L: Q2001.1 (G), Q2002.1 (G)
BMC_SPI0ABR: R2010.2, R2011.1, U1201.M15 (GPION6_SPI0ABR_TXD8)
BMC_SPI0WPN: R2030.2, U1201.B19 (GPION7_SPI0WPN_RXD8)
BMC_SPI1ABR: R2035.2, R2036.1, U1201.A19 (GPIOO6_SPI1ABR_THRUIN2)
BMC_SPI1WPN: R2053.2, U1201.A18 (GPIOO7_SPI1WPN_THRUOUT2)
EMMC_RST_3V3_L: R2056.1
GND: C2001.2, C2002.2, C2003.2, C2004.2, C2005.2, C2006.2, C2007.2, C2008.2, C2009.2, C2010.2, C2011.2, R2004.2, R2006.2, R2007.2, R2009.2, R2011.2, R2025.2, R2027.2, R2029.2, R2032.2, R2034.2, R2036.2, R2052.2
unnamed: J2001.1, R2031.2
unnamed: J2001.3, R2032.1
PP1V8_SPI0: C2002.1, C2005.1, C2006.1, R2008.1, R2010.1, R2028.1, R2030.1, U1201.E22 (VCC_SPI0_1V8_3V3[1:0]), U1201.E23 (VCC_SPI0_1V8_3V3[1:0])
PP1V8_SPI1: C2007.1, C2009.1, C2011.1, R2033.1, R2035.1, R2053.1, U1201.E24 (VCC_SPI1_1V8_3V3[1:0]), U1201.F24 (VCC_SPI1_1V8_3V3[1:0])
PP3V3_FWSPI: C2001.1, C2003.1, C2004.1, R2001.1, R2002.1, R2003.1, R2005.1, R2024.1, R2026.1, U1201.G21 (VCC_FWSPI_3V3[1:0]), U1201.G22 (VCC_FWSPI_3V3[1:0])
PP3V3_SPI2: C2008.1, C2010.1, R2031.1, R2050.1, R2051.1, U1201.G23 (VCC_SPI2_1V8_3V3[1:0]), U1201.H23 (VCC_SPI2_1V8_3V3[1:0])
Q.BMC.SPI2.CS0_L: Q2001.2 (S), U1201.D26 (GPIOP0_SPI2CS0N)
Q.BMC.SPI2.CS1_L: Q2002.2 (S), U1201.A26 (GPIOP6_SPI2CS1N_HPM1GPO3)
R.BMC.FWSPI.CLK: R2019.2, U1201.C24 (FWSPICK)
R.BMC.FWSPI.CS0_L: R2018.2, U1201.C25 (FWSPICS0N)
R.BMC.FWSPI.D2: R2022.2, U1201.M16 (FWSPIDQ2_GPIOU6)
R.BMC.FWSPI.D3: R2023.2, U1201.A15 (FWSPIDQ3_GPIOU7)
R.BMC.FWSPI.PICO: R2020.2, U1201.A17 (FWSPIMOSI)
R.BMC.FWSPI.POCI: R2021.2, U1201.A16 (FWSPIMISO)
R.BMC.SPI0.CLK: R2012.2, U1201.D24 (SPI0CK)
R.BMC.SPI0.CS0_L: R2017.2, U1201.B20 (SPI0CS0_SPI0CS0)
R.BMC.SPI0.D2: R2015.2, U1201.C23 (GPION3_SPI0DQ2)
R.BMC.SPI0.D3: R2016.2, U1201.B18 (GPION4_SPI0DQ3)
R.BMC.SPI0.PICO: R2013.2, U1201.B23 (SPI0MOSI_GPION1)
R.BMC.SPI0.POCI: R2014.2, U1201.B22 (SPI0MISO_GPION2)
R.BMC.SPI1.CLK: R2037.1, U1201.B26 (SPI1CK_TXD9)
R.BMC.SPI1.CS0_L: R2042.1, U1201.A20 (SPI1CS0)
R.BMC.SPI1.D2: R2040.1, U1201.B24 (GPIOO3_SPI1DQ2_RXD10)
R.BMC.SPI1.D3: R2041.1, U1201.E26 (GPIOO4_SPI1DQ3_TXD11)
R.BMC.SPI1.PICO: R2038.1, U1201.A25 (SPI1MOSI_RXD9)
R.BMC.SPI1.POCI: R2039.1, U1201.A24 (SPI1MISO_TXD10)
R.BMC.SPI2.CLK: R2044.1, U1201.C26 (GPIOP1_SPI2CK)
R.BMC.SPI2.PICO: R2045.1, U1201.A23 (GPIOP2_SPI2MOSI)
R.BMC.SPI2.POCI: R2046.1, U1201.A22 (GPIOP3_SPI2MISO)
RECOVERY_MODE_ENTRY_L: R2050.2, U1201.B25 (GPIOP4_SPI2DQ2_THRUIN3)
U3HUB_B_RST_L: U1201.F26 (GPIOP5_SPI2DQ3_THRUOUT3)

Notes on the sheet:
SPI0MISO strap as "Low Secure Boot" 0 == Disable Low Secure Boot function 1 == Enable Low Secure Boot function
GPIOP2 strap as "LTPI1_EN", only valid when SCU_TRAP_0 = 0 (see SCU_TRAP_1) 0 == Disable 2nd LTPI 1 == Enable 2nd LTPI
FWSPIMOSI strap as "Enable Secure Boot" (see SCU TRAP 5) 0 == Disable Secure Boot 1 == Enable Secure Boot
FWSPIABR strap as "Alternate Boot Source Select" 0 == Boot source is determined by internal ABR watchdog FMC_WDT2, initial boot from primary source 1 == Force to boot from alternate source
SPI1ABR strap as "Alternate Boot Source Select" 0 == Boot from primary source 1 == Force to boot from alternate source
FWSPIWPN for dedicated customer only and requires dedicated BMC FW. Just add external pull-up resistor if this feature is not needed. 0 == WP 1 == Disable WP
NOTE: Remember to unmount pullup along EMMC_RST if ever desired to strap FWSPIWPN low
ASPEED requires to pull up even not used
SPI1WPN, pulled-up as we don't need it
Gate to avoid undesired CS assertion on HPM FPGA during DCSCM power-up
SPI0WPN, pulled-up as we don't need it
SPI0CK strap as "Enable GPIO Pass Thru" 0 == disable 1 == enable
STRAP_ENABLE_ACPI1
SPI1CK strap as "LTPI0_EN", only valid when SCU_TRAP_0 = 0 (see SCU_TRAP_3) 0 == Disable 1st LTPI 1 == Enable 1st LTPI
SPI0ABR strap as "Alternate Boot Source Select" 0 == Boot from primary source 1 == Force to boot from alternate source
SPI0MISO strap as "Enable ACPI1" 0 == disable ACPI1 1 == enable ACPI1
GPIOP1 strap as "SCM-LTPI Mode" (SCU_TRAP_0) 0 == Non SCM-LTPI 1 == Enable SCM-LTPI
FWSPICK strap as "Boot Media Select" 0 == boot from FWSPI 1 == boot from eMMC/UFS
