rivosinc/scampi/sch/tpm_headers.kicad_sch

## KiCad design sch/tpm_headers.kicad_sch (2025-05-27)

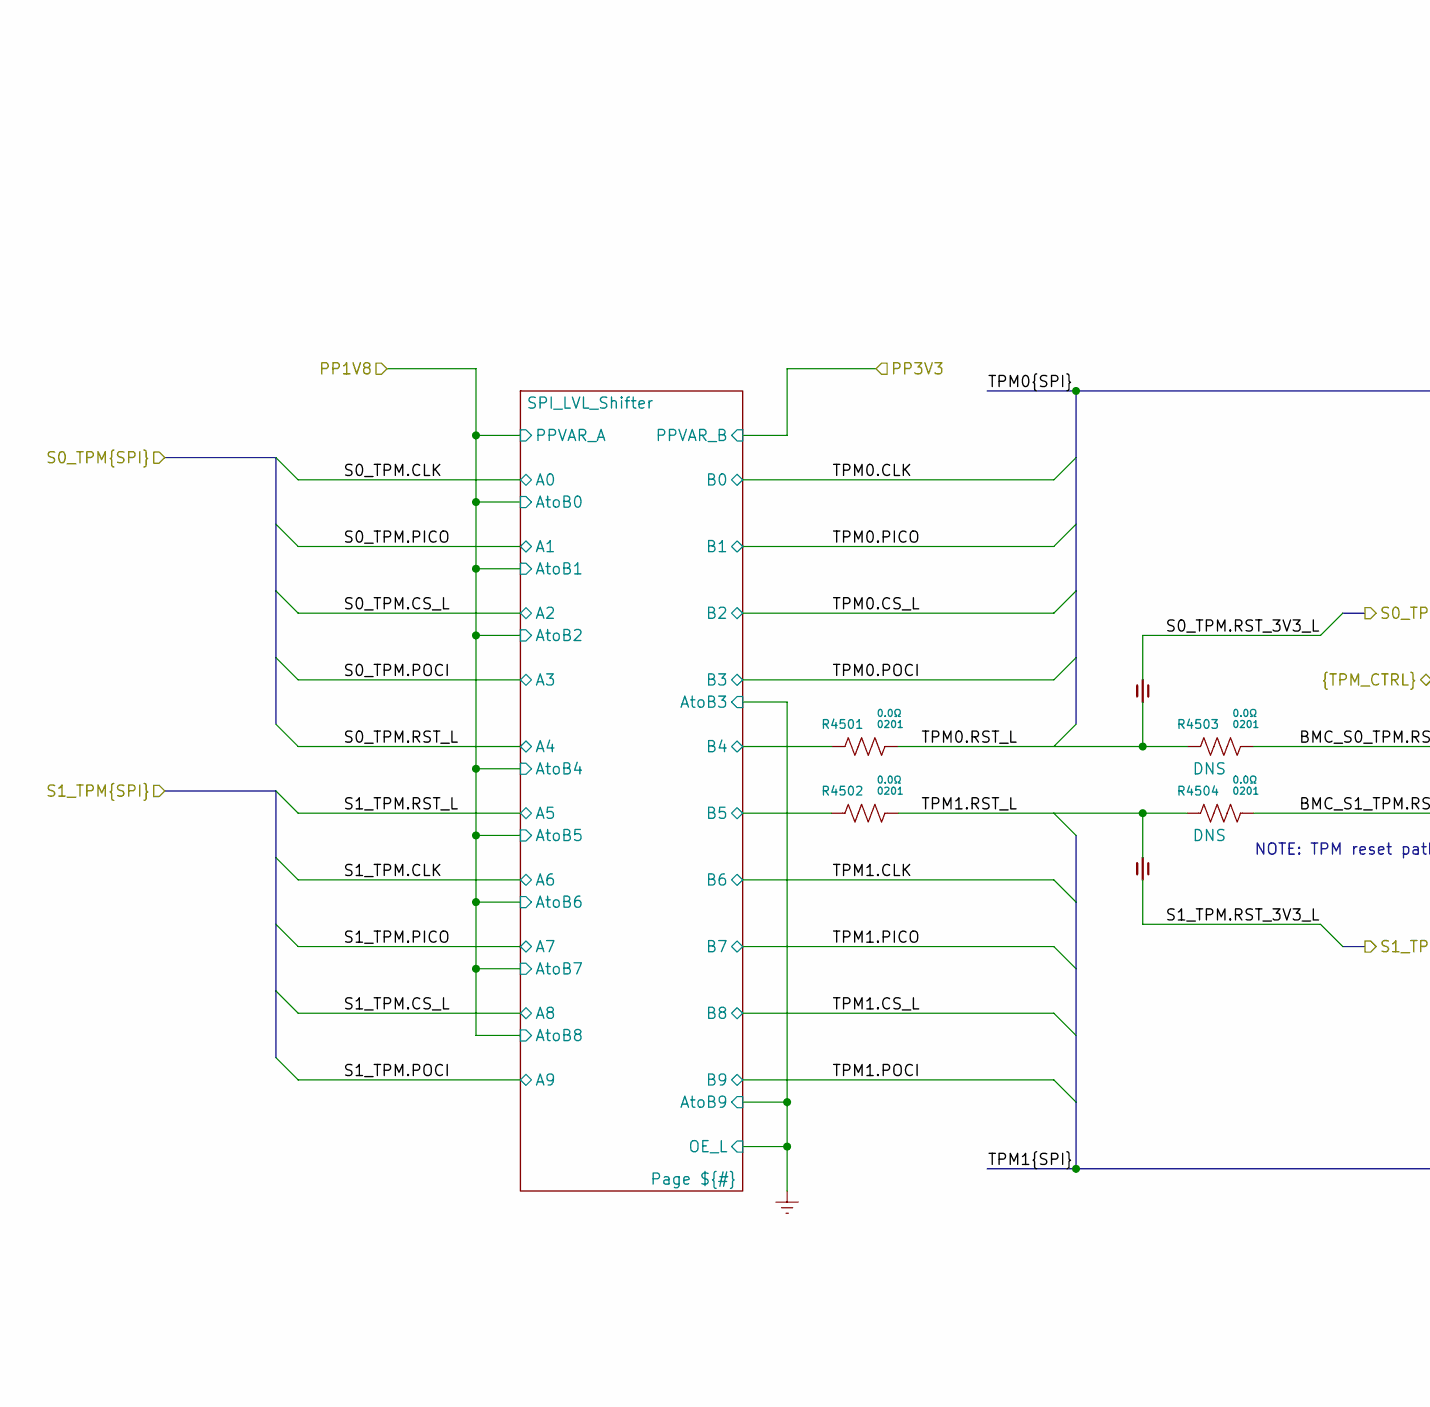
[picture p60: schematic tpm_headers.kicad_sch, part in row 1, column 1]

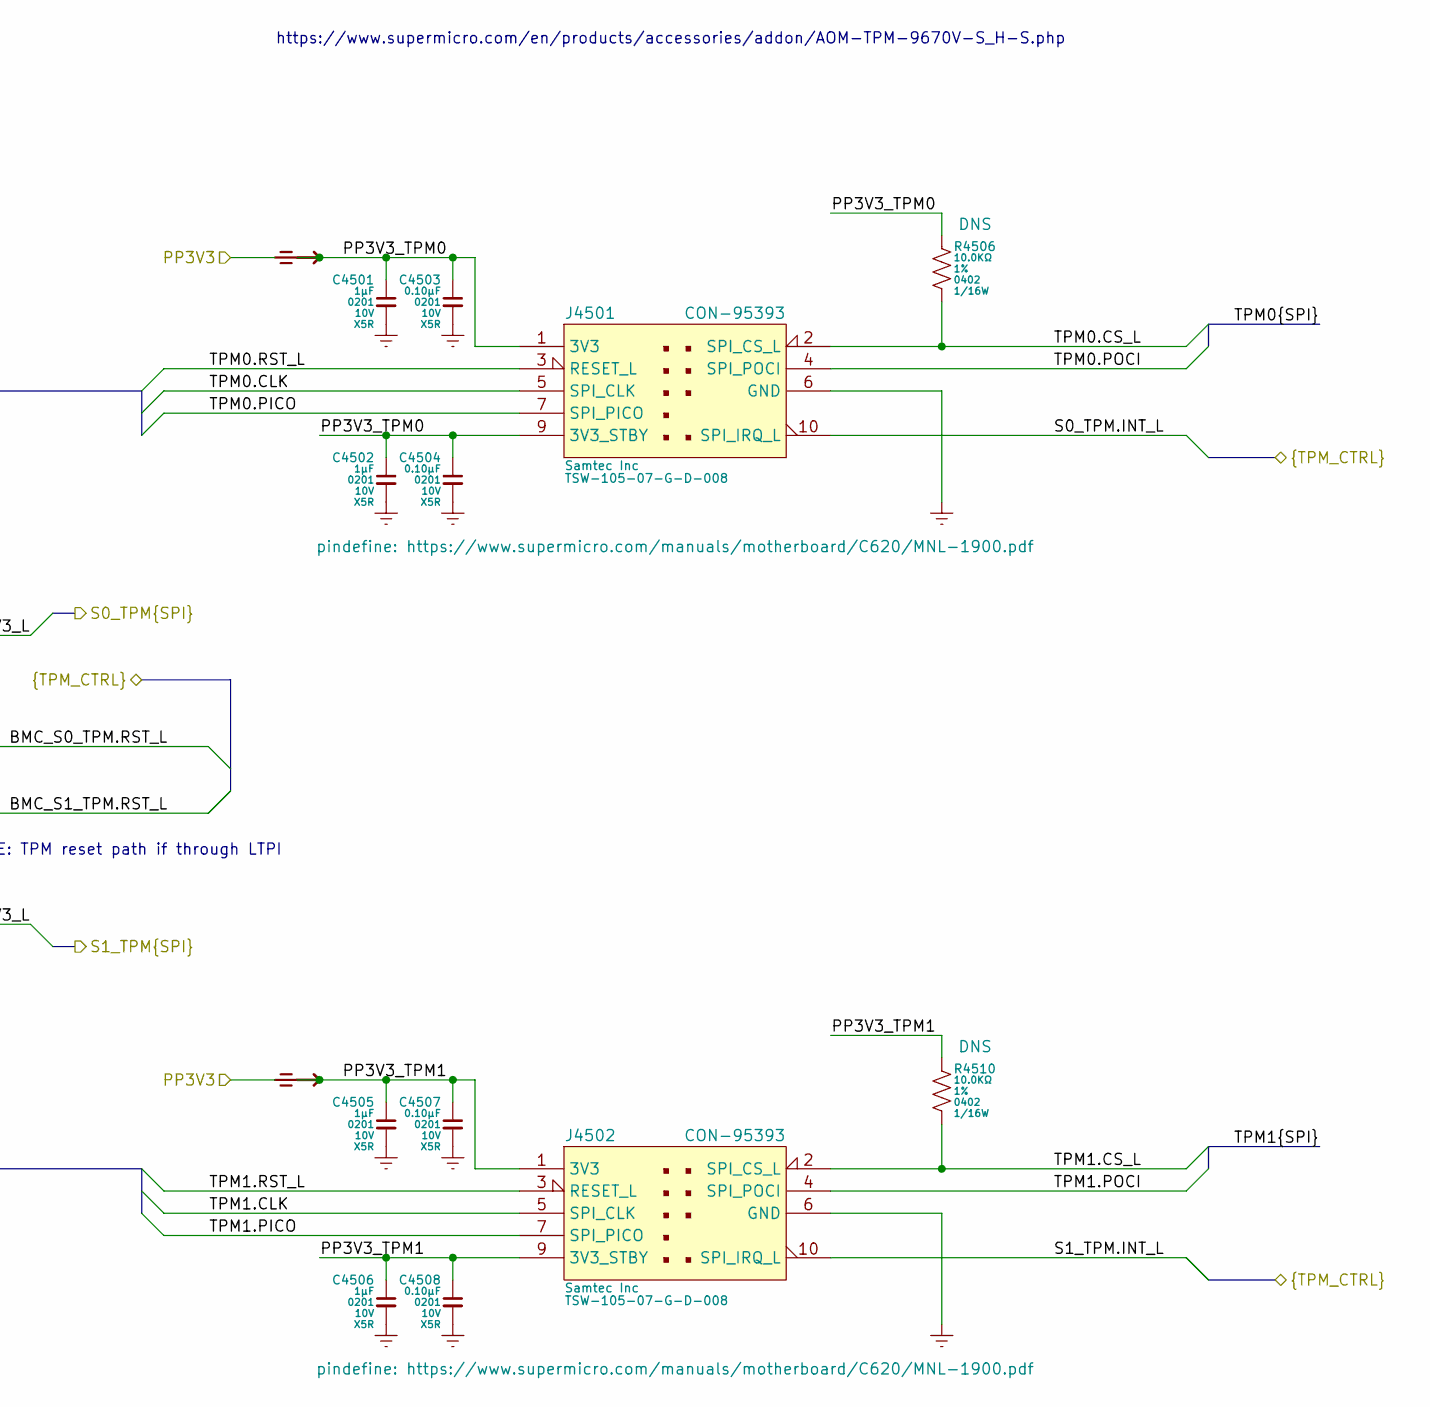
[picture p61: schematic tpm_headers.kicad_sch, part in row 1, column 2]

Parts:
C4501, C4502, C4505, C4506: CCM-710AD; mpn GRM033R61A105ME15
C4503, C4504, C4507, C4508: CCM-610AA; mpn GRM033R61A104ME15
J4501, J4502: CON-95393; mpn TSW-105-07-G-D-008
NT4501, NT4502, NT4503, NT4505: NET-10002
R4501, R4502, R4503, R4504: RES-0000A
R4506, R4510: RES-5100B

Connections:
B4: R4501.2
B5: R4502.2
BMC_S0_TPM.RST_L: R4503.1
BMC_S1_TPM.RST_L: R4504.1
GND: C4501.2, C4502.2, C4503.2, C4504.2, C4505.2, C4506.2, C4507.2, C4508.2, J4501.6 (GND), J4502.6 (GND)
PP3V3: NT4501.1, NT4502.1
PP3V3_TPM0: C4501.1, C4502.1, C4503.1, C4504.1, J4501.1 (3V3), J4501.9 (3V3_STBY), NT4501.2, R4506.1
PP3V3_TPM1: C4505.1, C4506.1, C4507.1, C4508.1, J4502.1 (3V3), J4502.9 (3V3_STBY), NT4502.2, R4510.1
S0_TPM.INT_L: J4501.10 (SPI_IRQ_L)
S0_TPM.RST_3V3_L: NT4503.2
S1_TPM.INT_L: J4502.10 (SPI_IRQ_L)
S1_TPM.RST_3V3_L: NT4505.1
TPM0.CLK: J4501.5 (SPI_CLK)
TPM0.CS_L: J4501.2 (SPI_CS_L), R4506.2
TPM0.PICO: J4501.7 (SPI_PICO)
TPM0.POCI: J4501.4 (SPI_POCI)
TPM0.RST_L: J4501.3 (RESET_L), NT4503.1, R4501.1, R4503.2
TPM1.CLK: J4502.5 (SPI_CLK)
TPM1.CS_L: J4502.2 (SPI_CS_L), R4510.2
TPM1.PICO: J4502.7 (SPI_PICO)
TPM1.POCI: J4502.4 (SPI_POCI)
TPM1.RST_L: J4502.3 (RESET_L), NT4505.2, R4502.1, R4504.2

Notes on the sheet:
NOTE: TPM reset path if through LTPI
https://www.supermicro.com/en/products/accessories/addon/AOM-TPM-9670V-S_H-S.php
