rivosinc/scampi/sch/typec.kicad_sch

## KiCad design sch/typec.kicad_sch (2025-05-27)

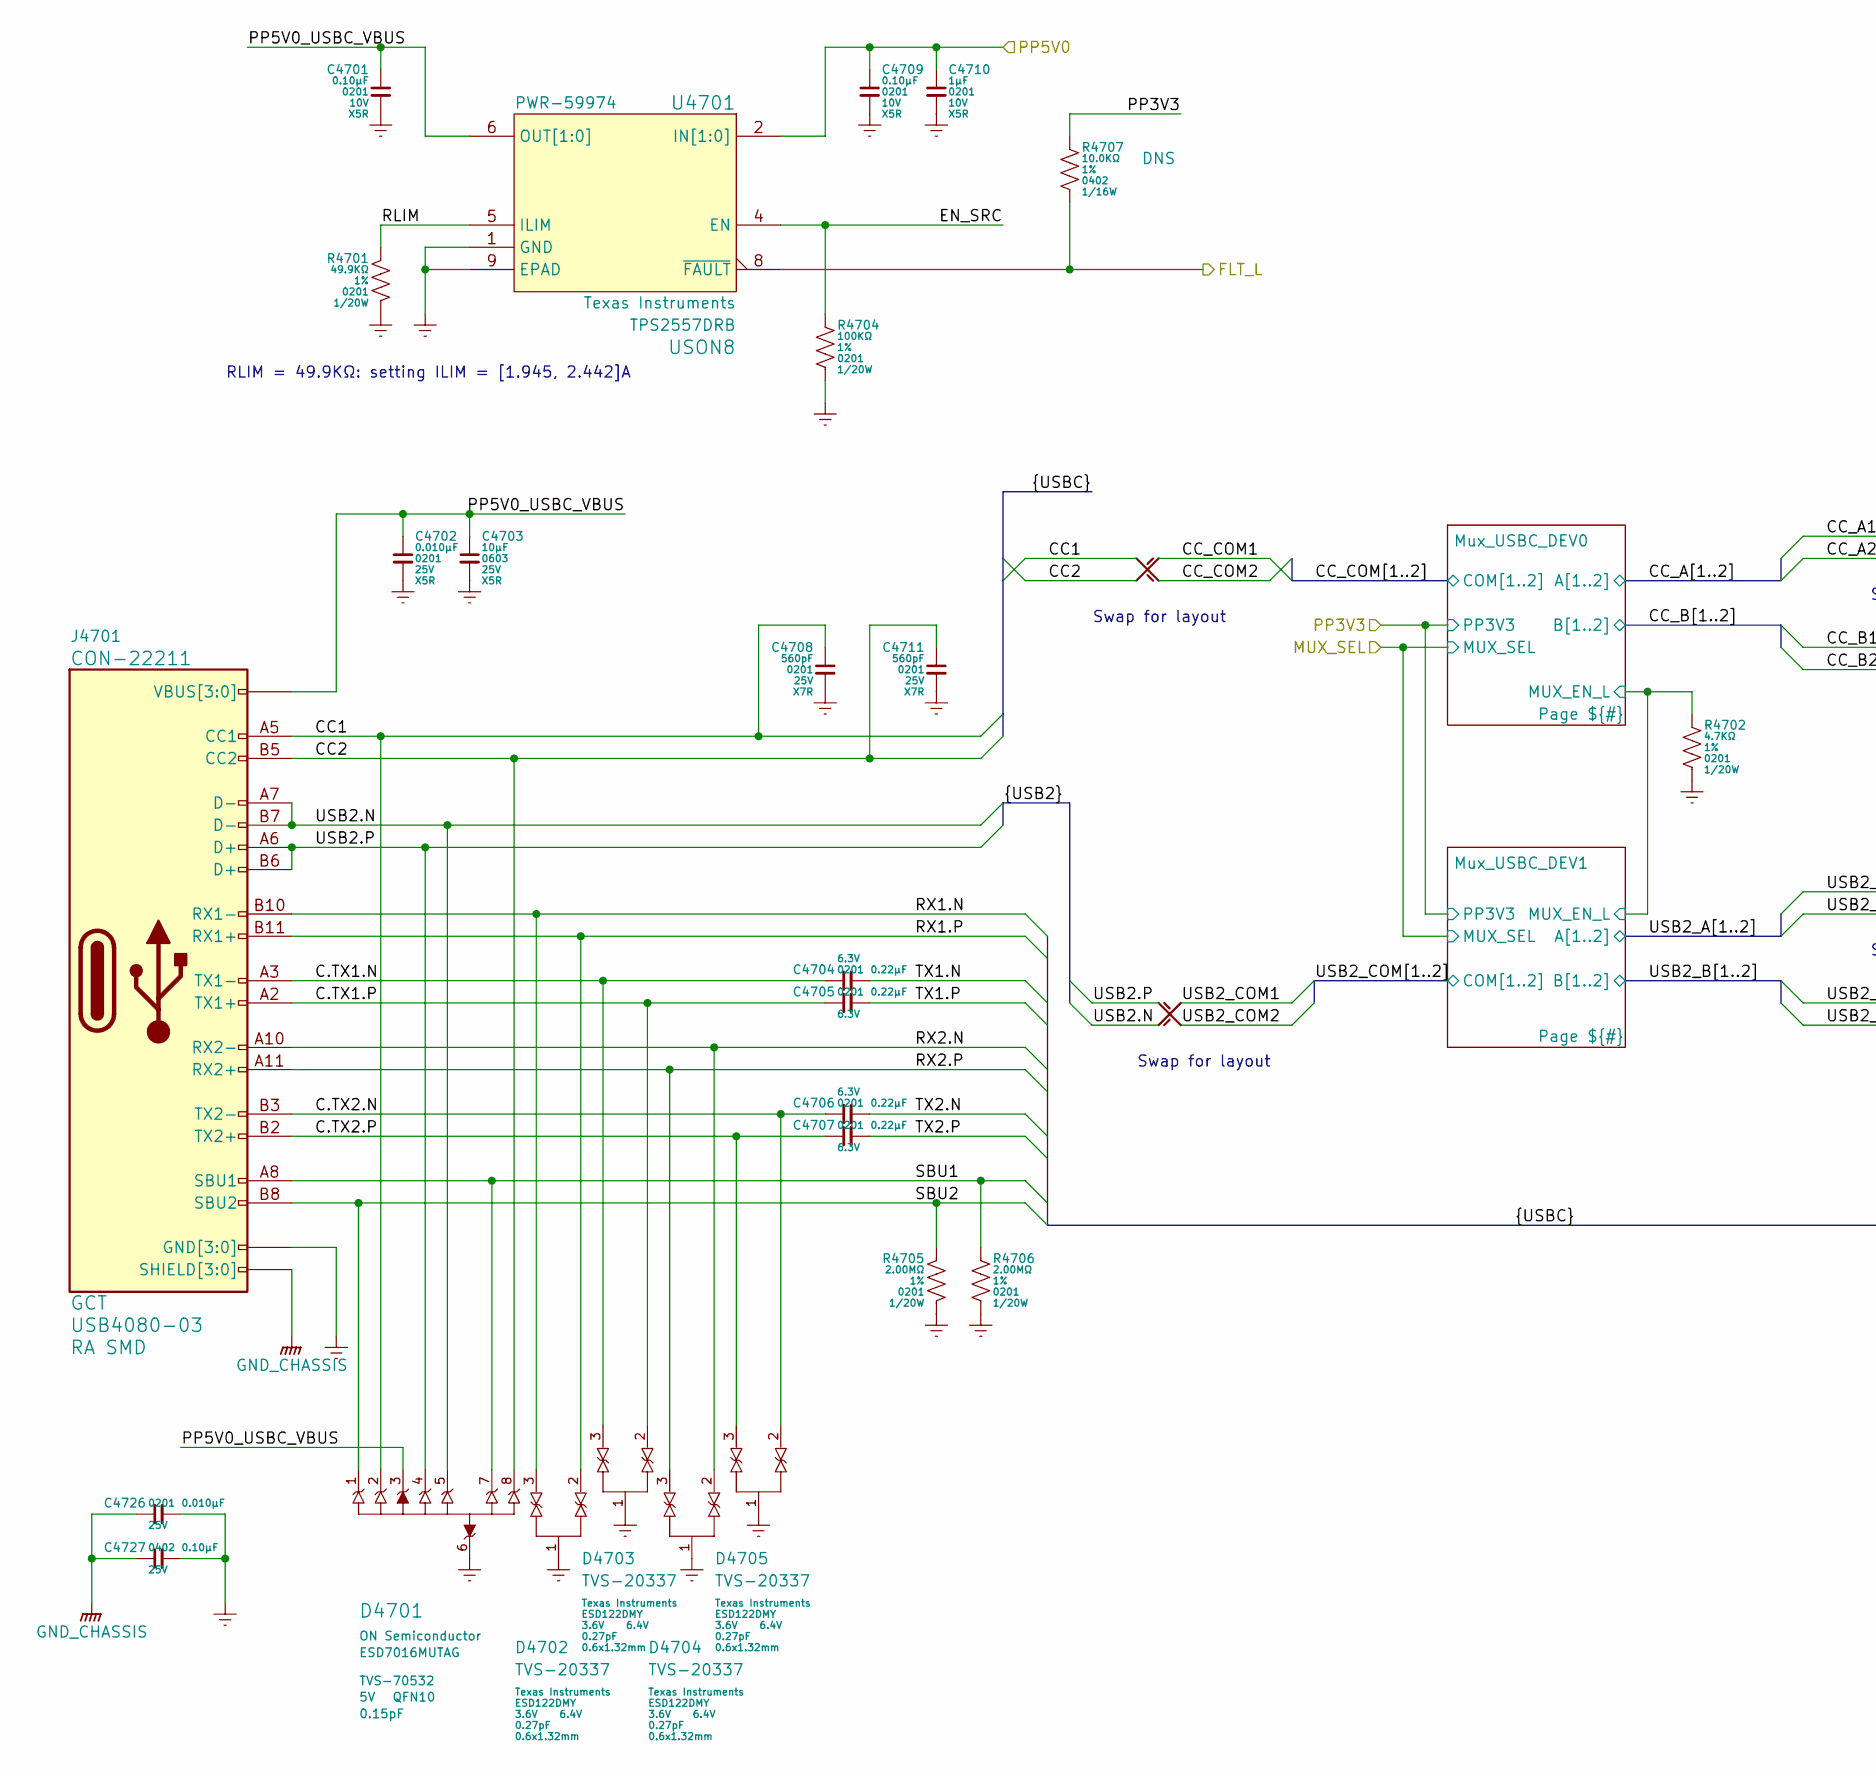
[picture p62: schematic typec.kicad_sch, part in row 1, column 1]

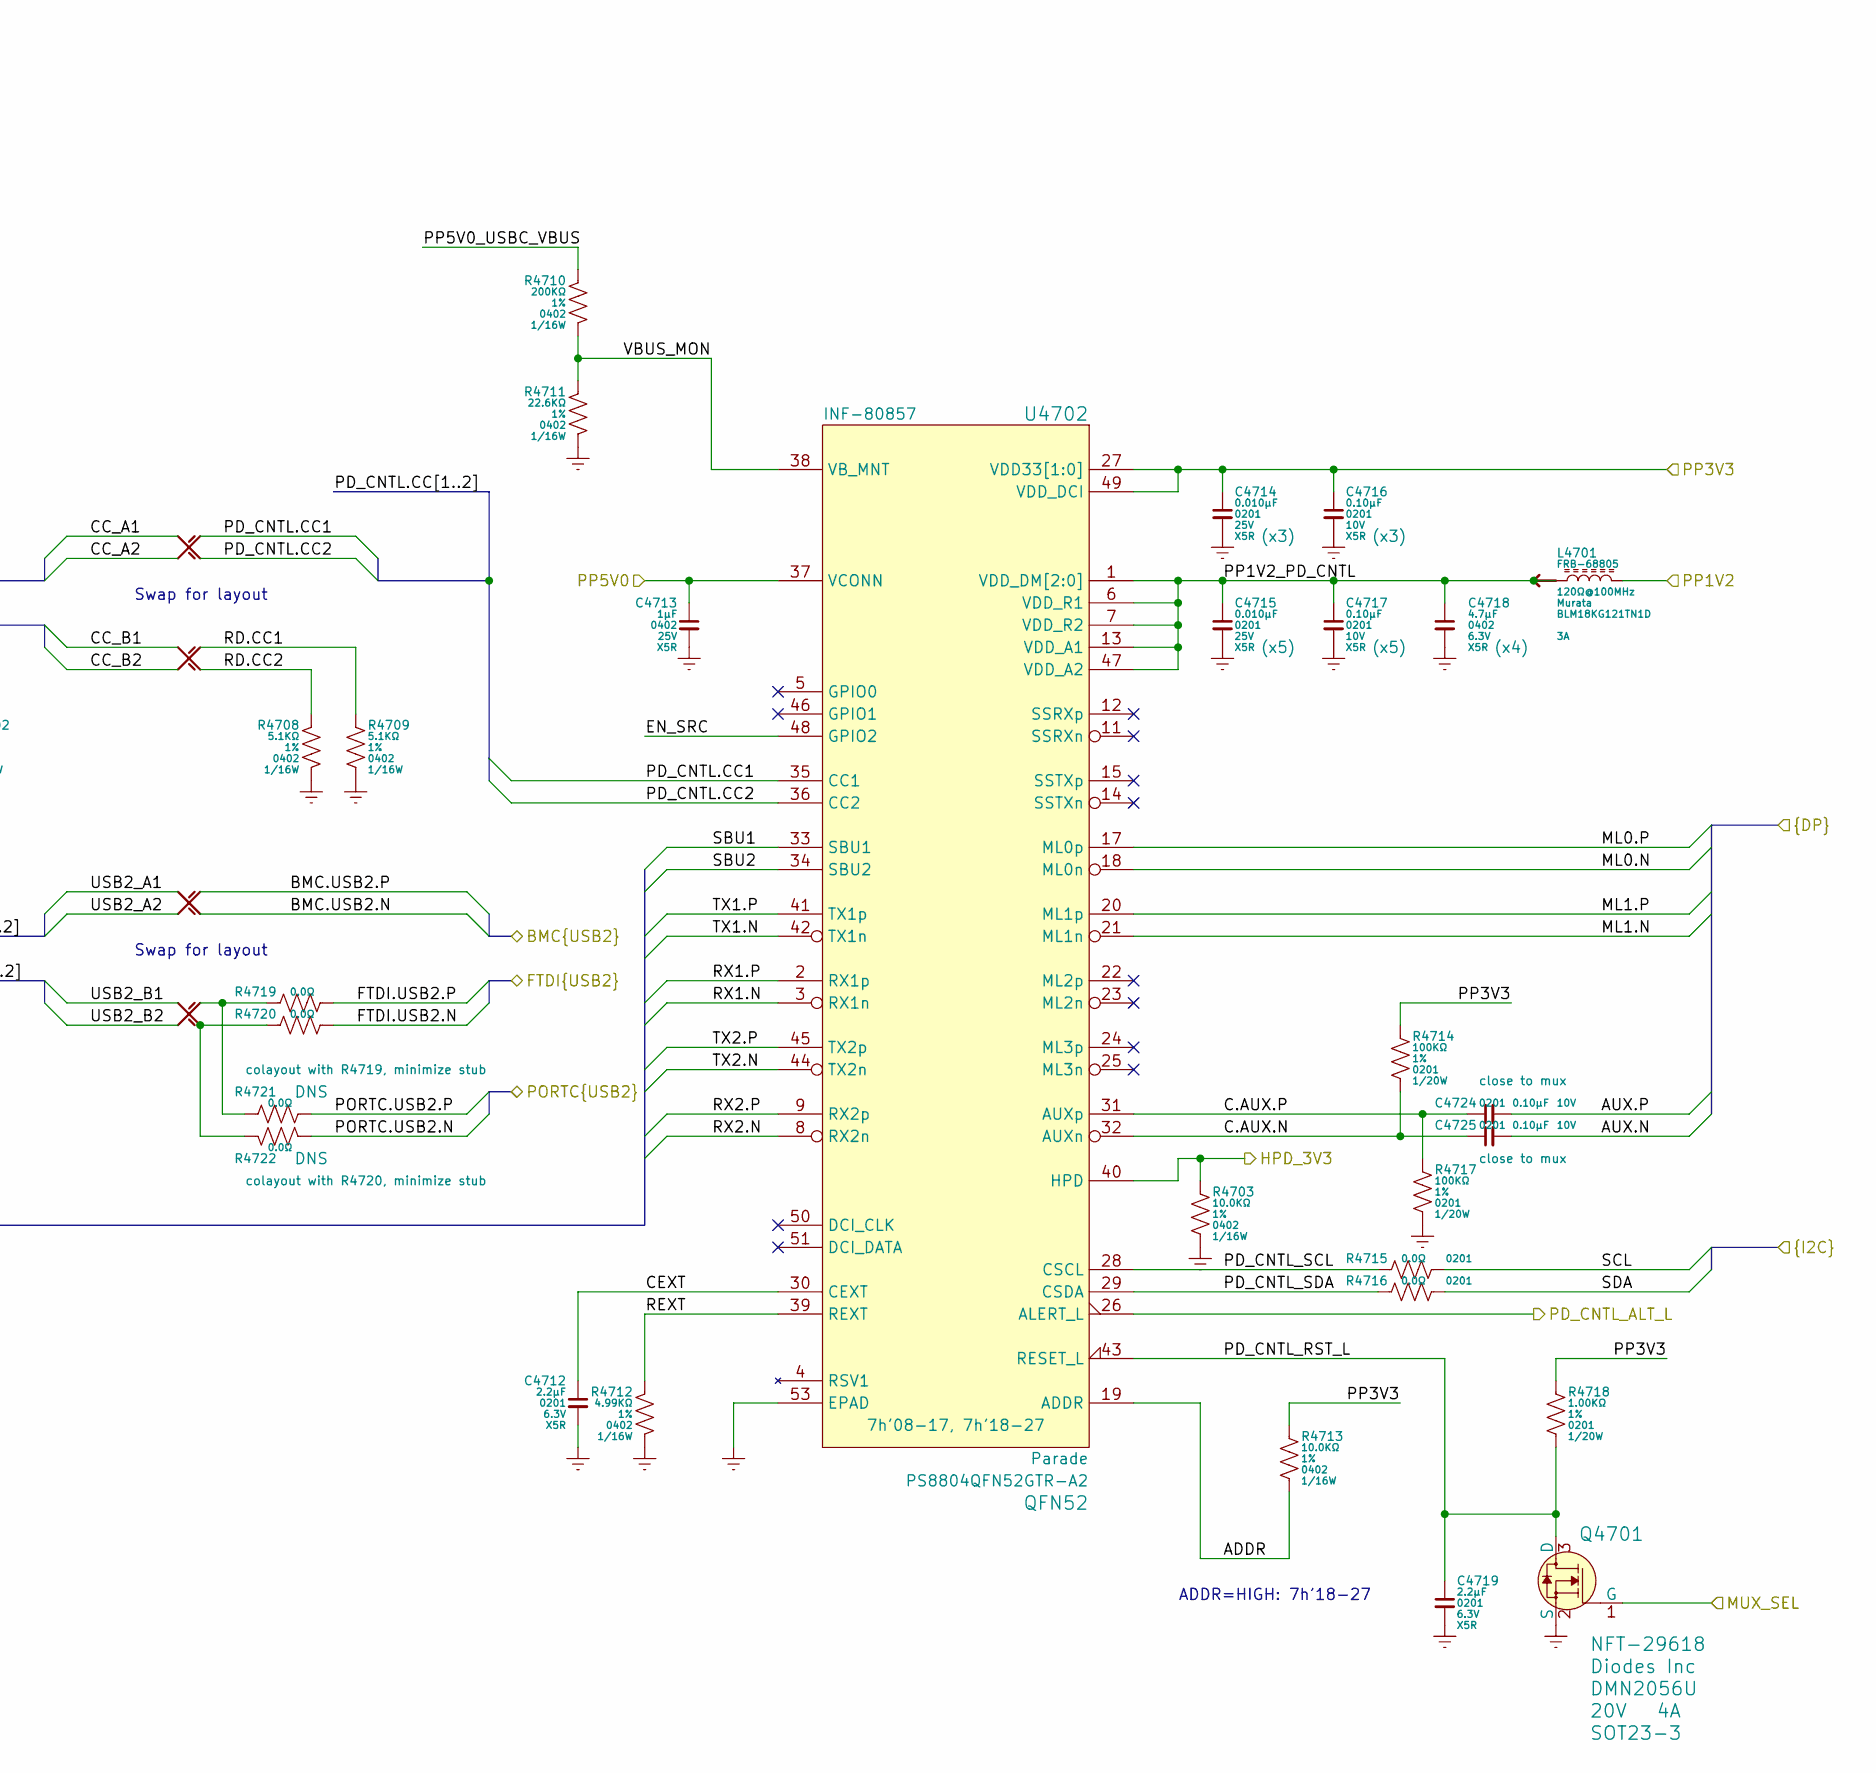
[picture p63: schematic typec.kicad_sch, part in row 1, column 2]

Parts:
C4701, C4709, C4716, C4717, C4724, C4725: CCM-610AA; mpn GRM033R61A104ME15
C4702, C4714, C4715, C4726: CCM-510AC; mpn GRM033R61E103MA12
C4703: CCM-810CE; mpn GRM188R61E106KA73
C4704, C4705, C4706, C4707: CCM-622AA; mpn GRM033R60J224ME15
C4708, C4711: CCM-356AA; mpn GRM033R71E561KA01
C4710: CCM-710AD; mpn GRM033R61A105ME15
C4712, C4719: CCM-722AA; mpn GRM033R60J225ME01
C4713: CCM-710BC; mpn GRM155R61E105KA12
C4718: CCM-747BC; mpn GRM155R60J475ME47
C4727: CCM-610BA; mpn GRM155R71E104KE14
D4701: TVS-70532; mpn ESD7016MUTAG
D4702, D4703, D4704, D4705: TVS-20337; mpn ESD122DMY
J4701: CON-22211; mpn USB4080-03
L4701: FRB-68805; mpn BLM18KG121TN1D
NT4701, NT4702, NT4703, NT4704, NT4705, NT4711: NET-20002
Q4701: NFT-29618; mpn DMN2056U
R4701: RES-5499A
R4702: RES-4470A
R4703, R4707, R4713: RES-5100B
R4704, R4714, R4717: RES-6100A
R4705, R4706: RES-7200A
R4708, R4709: RES-4510B
R4710: RES-6200B
R4711: RES-5226B
R4712: RES-4499B
R4715, R4716, R4719, R4720, R4721, R4722: RES-0000A
R4718: RES-4100A
U4701: PWR-59974; mpn TPS2557DRB
U4702: INF-80857; mpn PS8804QFN52GTR-A2

Connections:
ADDR: R4713.2, U4702.19 (ADDR)
AUX.N: C4725.2
AUX.P: C4724.2
BMC.USB2.N: NT4702.A4
BMC.USB2.P: NT4702.A3
C.AUX.N: C4725.1, R4714.2, U4702.32 (AUXn)
C.AUX.P: C4724.1, R4717.1, U4702.31 (AUXp)
C.TX1.N: C4704.1, D4703.3 (IO2), J4701.A3 (TX1-)
C.TX1.P: C4705.1, D4703.2 (IO1), J4701.A2 (TX1+)
C.TX2.N: C4706.1, D4705.2 (IO1), J4701.B3 (TX2-)
C.TX2.P: C4707.1, D4705.3 (IO2), J4701.B2 (TX2+)
CC1: C4708.1, D4701.2, J4701.A5 (CC1), NT4704.B4
CC2: C4711.1, D4701.8, J4701.B5 (CC2), NT4704.B3
CC_A1: NT4705.B4
CC_A2: NT4705.B3
CC_B1: NT4703.B4
CC_B2: NT4703.B3
CC_COM1: NT4704.A3
CC_COM2: NT4704.A4
CEXT: C4712.1, U4702.30 (CEXT)
EN_SRC: R4704.1, U4701.4 (EN), U4702.48 (GPIO2)
FLT_L: R4707.2, U4701.8 (~FAULT)
FTDI.USB2.N: R4720.2
FTDI.USB2.P: R4719.2
GND: C4701.2, C4702.2, C4703.2, C4708.2, C4709.2, C4710.2, C4711.2, C4712.2, C4713.2, C4714.2, C4715.2, C4716.2, C4717.2, C4718.2, C4719.2, C4726.2, C4727.2, D4701.6, D4702.1 (GND), D4703.1 (GND), D4704.1 (GND), D4705.1 (GND), J4701.A1 (GND[3:0]), J4701.A12 (GND[3:0]), J4701.B1 (GND[3:0]), J4701.B12 (GND[3:0]), Q4701.2 (S), R4701.2, R4702.2, R4703.2, R4704.2, R4705.2, R4706.2, R4708.2, R4709.2, R4711.2, R4712.2, R4717.2, U4701.1 (GND), U4701.9 (EPAD), U4702.53 (EPAD)
GND_CHASSIS: C4726.1, C4727.1, J4701.25 (SHIELD[3:0]), J4701.26 (SHIELD[3:0]), J4701.27 (SHIELD[3:0]), J4701.28 (SHIELD[3:0])
HPD_3V3: R4703.1, U4702.40 (HPD)
ML0.N: U4702.18 (ML0n)
ML0.P: U4702.17 (ML0p)
ML1.N: U4702.21 (ML1n)
ML1.P: U4702.20 (ML1p)
MUX_EN_L: R4702.1
MUX_SEL: Q4701.1 (G)
unnamed: NT4701.A3, R4719.1, R4721.1
unnamed: NT4701.A4, R4720.1, R4722.1
PD_CNTL.CC1: NT4705.A3, U4702.35 (CC1)
PD_CNTL.CC2: NT4705.A4, U4702.36 (CC2)
PD_CNTL_ALT_L: U4702.26 (ALERT_L)
PD_CNTL_RST_L: C4719.1, Q4701.3 (D), R4718.2, U4702.43 (RESET_L)
PD_CNTL_SCL: R4715.1, U4702.28 (CSCL)
PD_CNTL_SDA: R4716.1, U4702.29 (CSDA)
PORTC.USB2.N: R4722.2
PORTC.USB2.P: R4721.2
PP1V2: L4701.2
PP1V2_PD_CNTL: C4715.1, C4717.1, C4718.1, L4701.1, U4702.1 (VDD_DM[2:0]), U4702.6 (VDD_R1), U4702.7 (VDD_R2), U4702.10 (VDD_DM[2:0]), U4702.13 (VDD_A1), U4702.16 (VDD_DM[2:0]), U4702.47 (VDD_A2)
PP3V3: C4714.1, C4716.1, R4707.1, R4713.1, R4714.1, R4718.1, U4702.27 (VDD33[1:0]), U4702.49 (VDD_DCI), U4702.52 (VDD33[1:0])
PP5V0: C4709.1, C4710.1, C4713.1, U4701.2 (IN[1:0]), U4701.3 (IN[1:0]), U4702.37 (VCONN)
PP5V0_USBC_VBUS: C4701.1, C4702.1, C4703.1, D4701.3, J4701.A4 (VBUS[3:0]), J4701.A9 (VBUS[3:0]), J4701.B4 (VBUS[3:0]), J4701.B9 (VBUS[3:0]), R4710.1, U4701.6 (OUT[1:0]), U4701.7 (OUT[1:0])
RD.CC1: NT4703.A3, R4709.1
RD.CC2: NT4703.A4, R4708.1
REXT: R4712.1, U4702.39 (REXT)
RLIM: R4701.1, U4701.5 (ILIM)
RX1.N: D4702.3 (IO2), J4701.B10 (RX1-), U4702.3 (RX1n)
RX1.P: D4702.2 (IO1), J4701.B11 (RX1+), U4702.2 (RX1p)
RX2.N: D4704.2 (IO1), J4701.A10 (RX2-), U4702.8 (RX2n)
RX2.P: D4704.3 (IO2), J4701.A11 (RX2+), U4702.9 (RX2p)
SBU1: D4701.7, J4701.A8 (SBU1), R4706.1, U4702.33 (SBU1)
SBU2: D4701.1, J4701.B8 (SBU2), R4705.1, U4702.34 (SBU2)
SCL: R4715.2
SDA: R4716.2
TX1.N: C4704.2, U4702.42 (TX1n)
TX1.P: C4705.2, U4702.41 (TX1p)
TX2.N: C4706.2, U4702.44 (TX2n)
TX2.P: C4707.2, U4702.45 (TX2p)
USB2.N: D4701.5, J4701.A7 (D-), J4701.B7 (D-), NT4711.A4
USB2.P: D4701.4, J4701.A6 (D+), J4701.B6 (D+), NT4711.A3
USB2_A1: NT4702.B4
USB2_A2: NT4702.B3
USB2_B1: NT4701.B4
USB2_B2: NT4701.B3
USB2_COM1: NT4711.B4
USB2_COM2: NT4711.B3
VBUS_MON: R4710.2, R4711.1, U4702.38 (VB_MNT)

Notes on the sheet:
Swap for layout
RLIM = 49.9KΩ: setting ILIM = [1.945, 2.442]A
ADDR=HIGH: 7h'18-27
