rivosinc/scampi/sch/uart.kicad_sch

## KiCad design sch/uart.kicad_sch (2025-05-27)

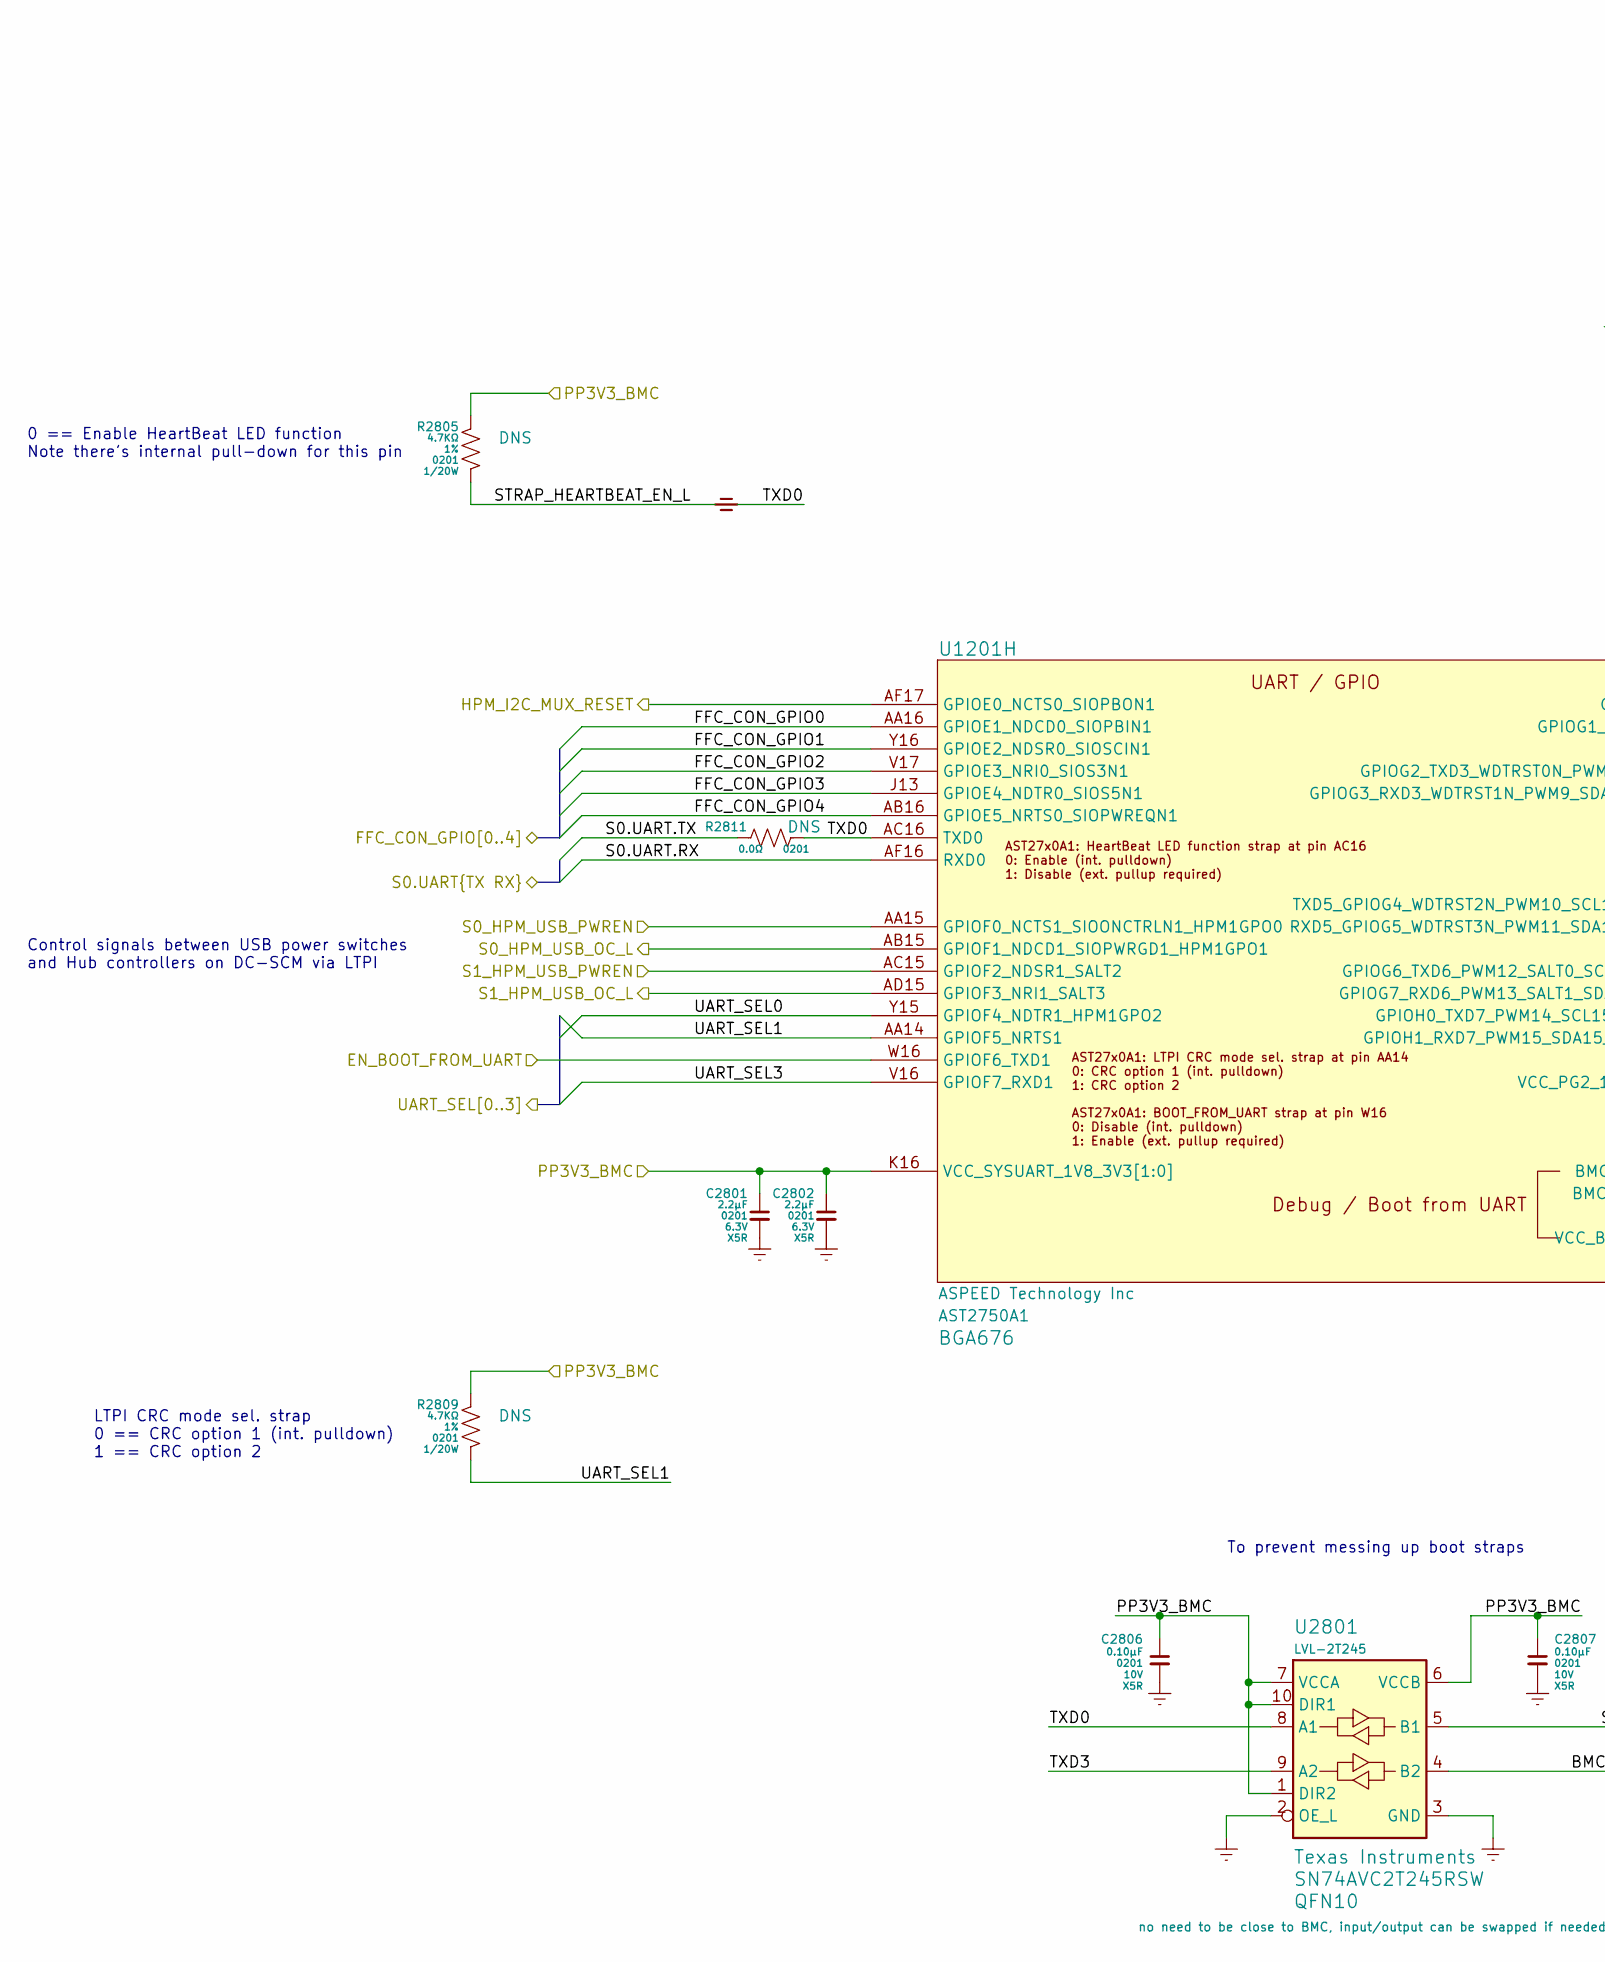
[picture p64: schematic uart.kicad_sch, part in row 1, column 1]

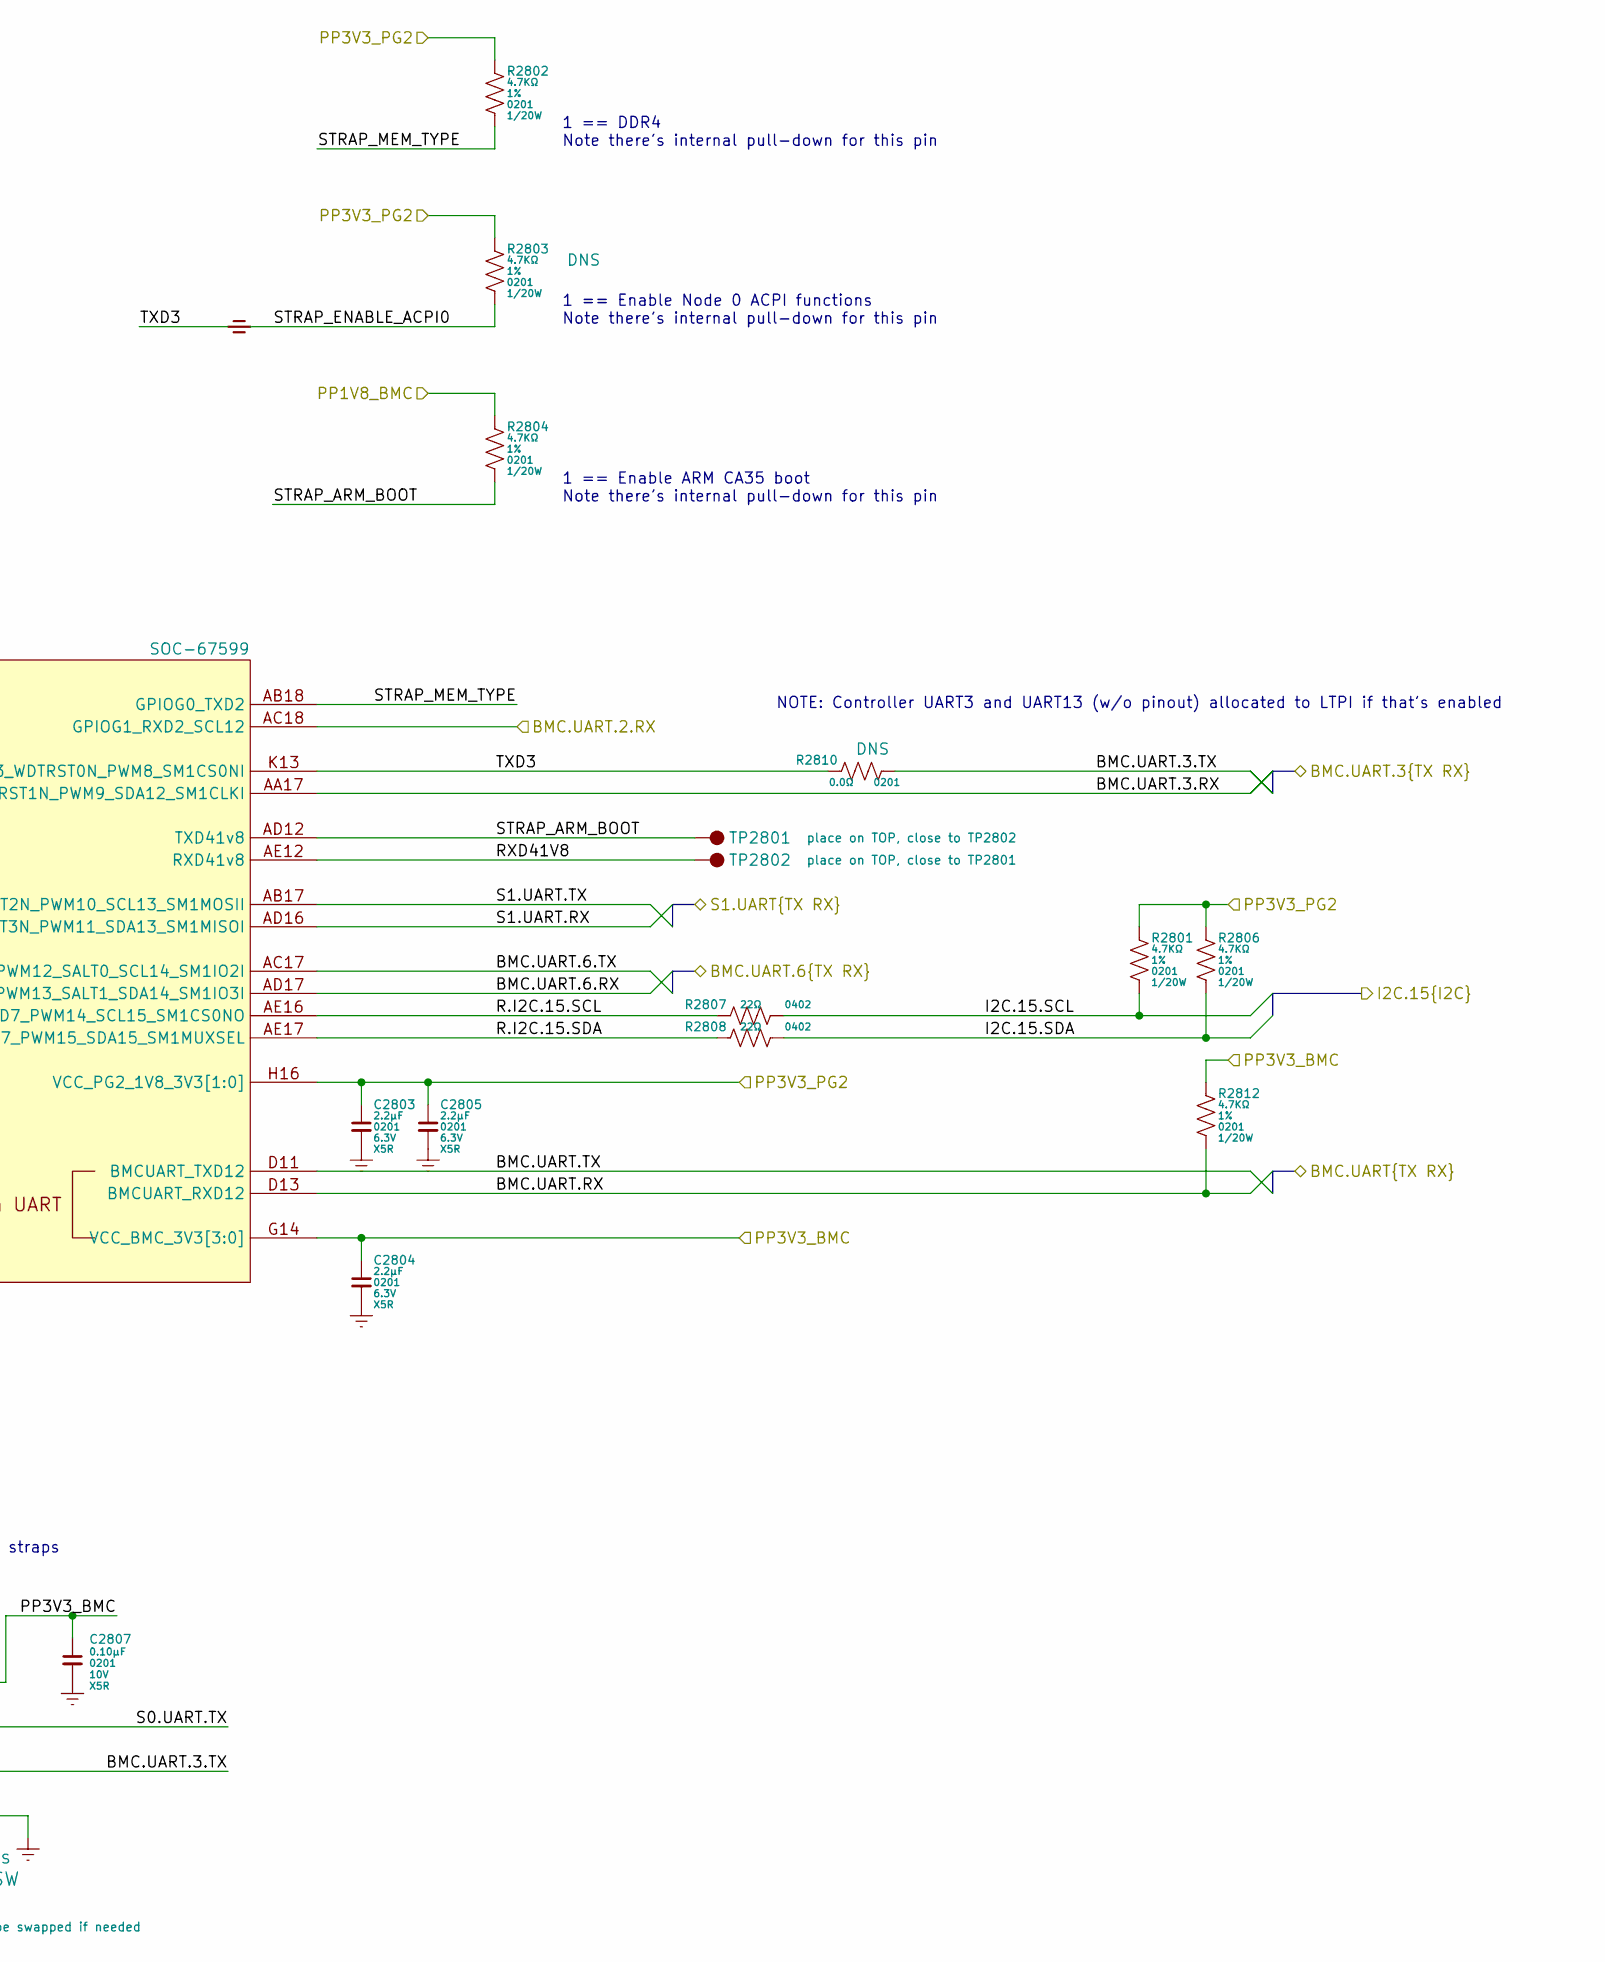
[picture p65: schematic uart.kicad_sch, part in row 1, column 2]

Parts:
C2801, C2802, C2803, C2804, C2805: CCM-722AA; mpn GRM033R60J225ME01
C2806, C2807: CCM-610AA; mpn GRM033R61A104ME15
NT2801, NT2802: NET-10002
R2801, R2802, R2803, R2804, R2805, R2806, R2809, R2812: RES-4470A
R2807, R2808: RES-2220B
R2810, R2811: RES-0000A
TP2801, TP2802: TST-01025
U1201: SOC-67599; mpn AST2750A1
U2801: LVL-2T245; mpn SN74AVC2T245RSW

Connections:
BMC.UART.2.RX: U1201.AC18 (GPIOG1_RXD2_SCL12)
BMC.UART.3.RX: U1201.AA17 (GPIOG3_RXD3_WDTRST1N_PWM9_SDA12_SM1CLKI)
BMC.UART.3.TX: R2810.2, U2801.4 (B2)
BMC.UART.6.RX: U1201.AD17 (GPIOG7_RXD6_PWM13_SALT1_SDA14_SM1IO3I)
BMC.UART.6.TX: U1201.AC17 (GPIOG6_TXD6_PWM12_SALT0_SCL14_SM1IO2I)
BMC.UART.RX: R2812.2, U1201.D13 (BMCUART_RXD12)
BMC.UART.TX: U1201.D11 (BMCUART_TXD12)
EN_BOOT_FROM_UART: U1201.W16 (GPIOF6_TXD1)
FFC_CON_GPIO0: U1201.AA16 (GPIOE1_NDCD0_SIOPBIN1)
FFC_CON_GPIO1: U1201.Y16 (GPIOE2_NDSR0_SIOSCIN1)
FFC_CON_GPIO2: U1201.V17 (GPIOE3_NRI0_SIOS3N1)
FFC_CON_GPIO3: U1201.J13 (GPIOE4_NDTR0_SIOS5N1)
FFC_CON_GPIO4: U1201.AB16 (GPIOE5_NRTS0_SIOPWREQN1)
GND: C2801.2, C2802.2, C2803.2, C2804.2, C2805.2, C2806.2, C2807.2, U2801.2 (OE_L), U2801.3 (GND)
HPM_I2C_MUX_RESET: U1201.AF17 (GPIOE0_NCTS0_SIOPBON1)
I2C.15.SCL: R2801.2, R2807.2
I2C.15.SDA: R2806.2, R2808.2
PP1V8_BMC: R2804.1
PP3V3_BMC: C2801.1, C2802.1, C2804.1, C2806.1, C2807.1, R2805.1, R2809.1, R2812.1, U1201.G14 (VCC_BMC_3V3[3:0]), U1201.K16 (VCC_SYSUART_1V8_3V3[1:0]), U1201.L16 (VCC_SYSUART_1V8_3V3[1:0]), U2801.1 (DIR2), U2801.6 (VCCB), U2801.7 (VCCA), U2801.10 (DIR1)
PP3V3_PG2: C2803.1, C2805.1, R2801.1, R2802.1, R2803.1, R2806.1, U1201.H16 (VCC_PG2_1V8_3V3[1:0]), U1201.J16 (VCC_PG2_1V8_3V3[1:0])
R.I2C.15.SCL: R2807.1, U1201.AE16 (GPIOH0_TXD7_PWM14_SCL15_SM1CS0NO)
R.I2C.15.SDA: R2808.1, U1201.AE17 (GPIOH1_RXD7_PWM15_SDA15_SM1MUXSEL)
RXD41V8: TP2802.1, U1201.AE12 (RXD41v8)
S0.UART.RX: U1201.AF16 (RXD0)
S0.UART.TX: R2811.1, U2801.5 (B1)
S0_HPM_USB_OC_L: U1201.AB15 (GPIOF1_NDCD1_SIOPWRGD1_HPM1GPO1)
S0_HPM_USB_PWREN: U1201.AA15 (GPIOF0_NCTS1_SIOONCTRLN1_HPM1GPO0)
S1.UART.RX: U1201.AD16 (RXD5_GPIOG5_WDTRST3N_PWM11_SDA13_SM1MIS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)
S1.UART.TX: U1201.AB17 (TXD5_GPIOG4_WDTRST2N_PWM10_SCL13_SM1MOS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)
S1_HPM_USB_OC_L: U1201.AD15 (GPIOF3_NRI1_SALT3)
S1_HPM_USB_PWREN: U1201.AC15 (GPIOF2_NDSR1_SALT2)
STRAP_ARM_BOOT: R2804.2, TP2801.1, U1201.AD12 (TXD41v8)
STRAP_ENABLE_ACPI0: NT2802.2, R2803.2
STRAP_HEARTBEAT_EN_L: NT2801.1, R2805.2
STRAP_MEM_TYPE: R2802.2, U1201.AB18 (GPIOG0_TXD2)
TXD0: NT2801.2, R2811.2, U1201.AC16 (TXD0), U2801.8 (A1)
TXD3: NT2802.1, R2810.1, U1201.K13 (GPIOG2_TXD3_WDTRST0N_PWM8_SM1CS0NI), U2801.9 (A2)
UART_SEL0: U1201.Y15 (GPIOF4_NDTR1_HPM1GPO2)
UART_SEL1: R2809.2, U1201.AA14 (GPIOF5_NRTS1)
UART_SEL3: U1201.V16 (GPIOF7_RXD1)

Notes on the sheet:
1 == Enable Node 0 ACPI functions Note there's internal pull-down for this pin
1 == Enable ARM CA35 boot Note there's internal pull-down for this pin
0 == Enable HeartBeat LED function Note there's internal pull-down for this pin
Control signals between USB power switches and Hub controllers on DC-SCM via LTPI
NOTE: Controller UART3 and UART13 (w/o pinout) allocated to LTPI if that's enabled
1 == DDR4 Note there's internal pull-down for this pin
LTPI CRC mode sel. strap 0 == CRC option 1 (int. pulldown) 1 == CRC option 2
To prevent messing up boot straps
