rivosinc/scampi/sch/ufs.kicad_sch

## KiCad design sch/ufs.kicad_sch (2025-05-27)

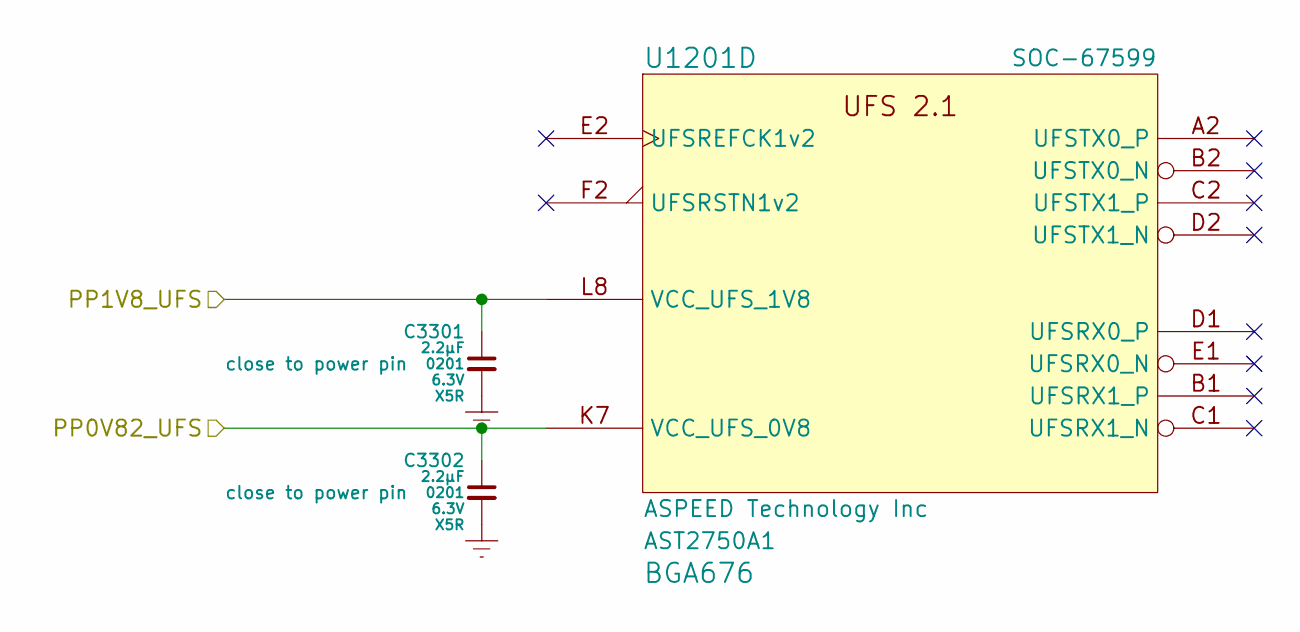
[picture p66: schematic ufs.kicad_sch]

Parts:
C3301, C3302: CCM-722AA; mpn GRM033R60J225ME01
U1201: SOC-67599; mpn AST2750A1

Connections:
GND: C3301.2, C3302.2
PP0V82_UFS: C3302.1, U1201.K7 (VCC_UFS_0V8)
PP1V8_UFS: C3301.1, U1201.L8 (VCC_UFS_1V8)
