rivosinc/scampi/sch/usb2_hub.kicad_sch

## KiCad design sch/usb2_hub.kicad_sch (2025-05-27)

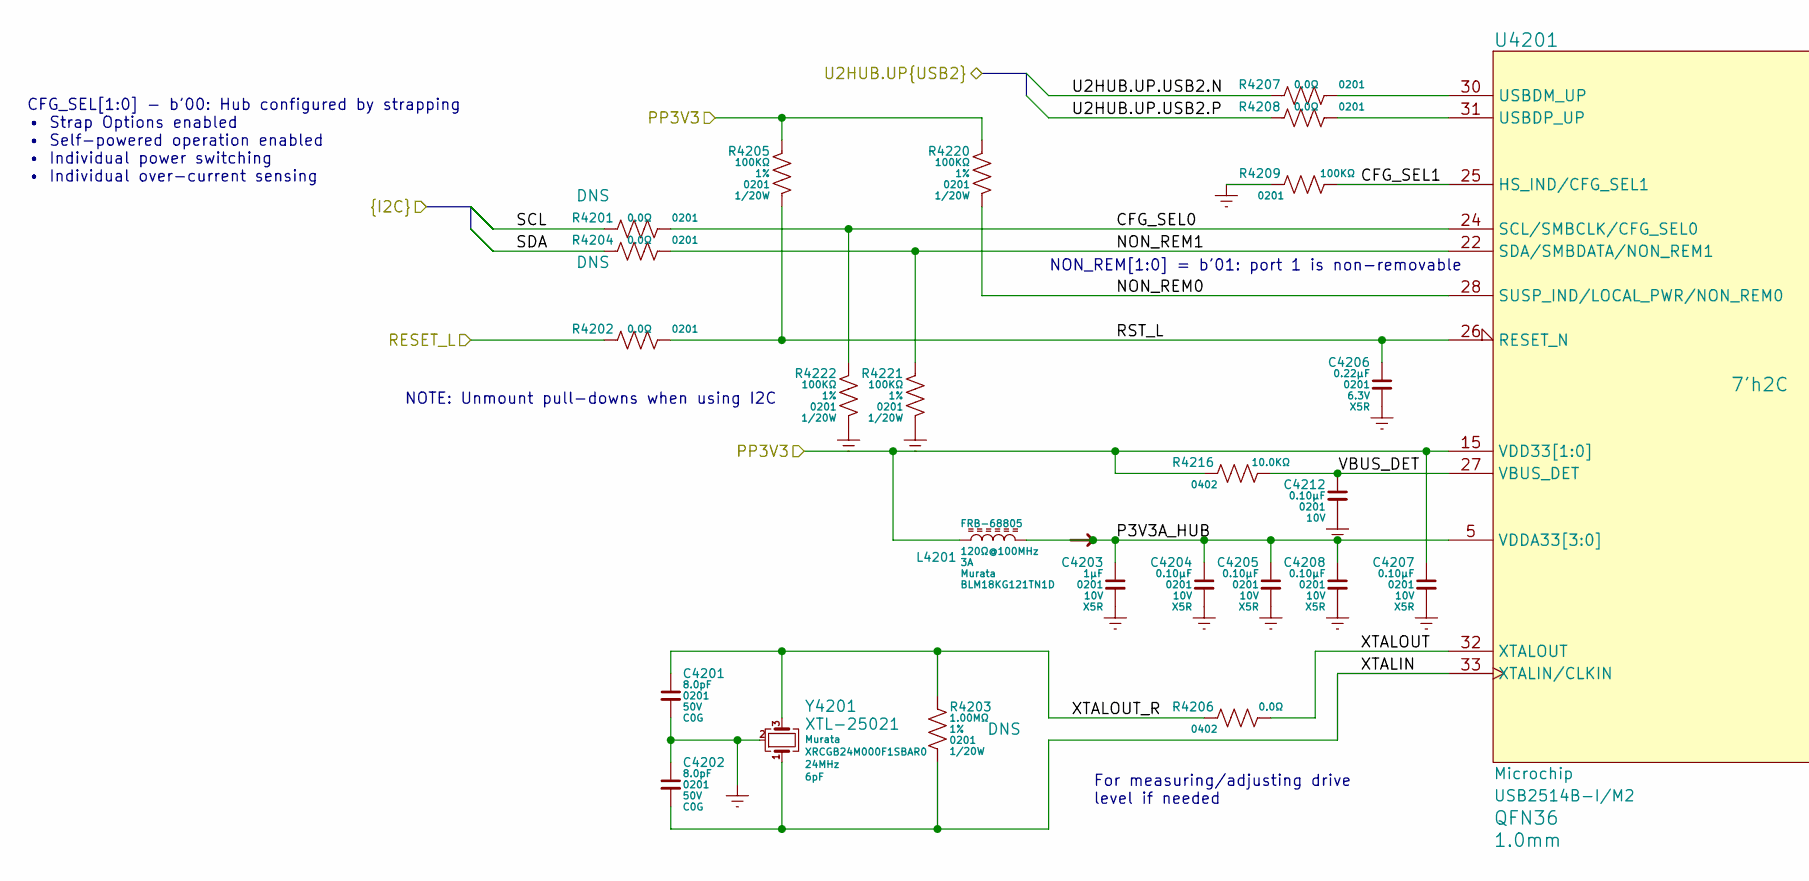
[picture p67: schematic usb2_hub.kicad_sch, part in row 1, column 1]

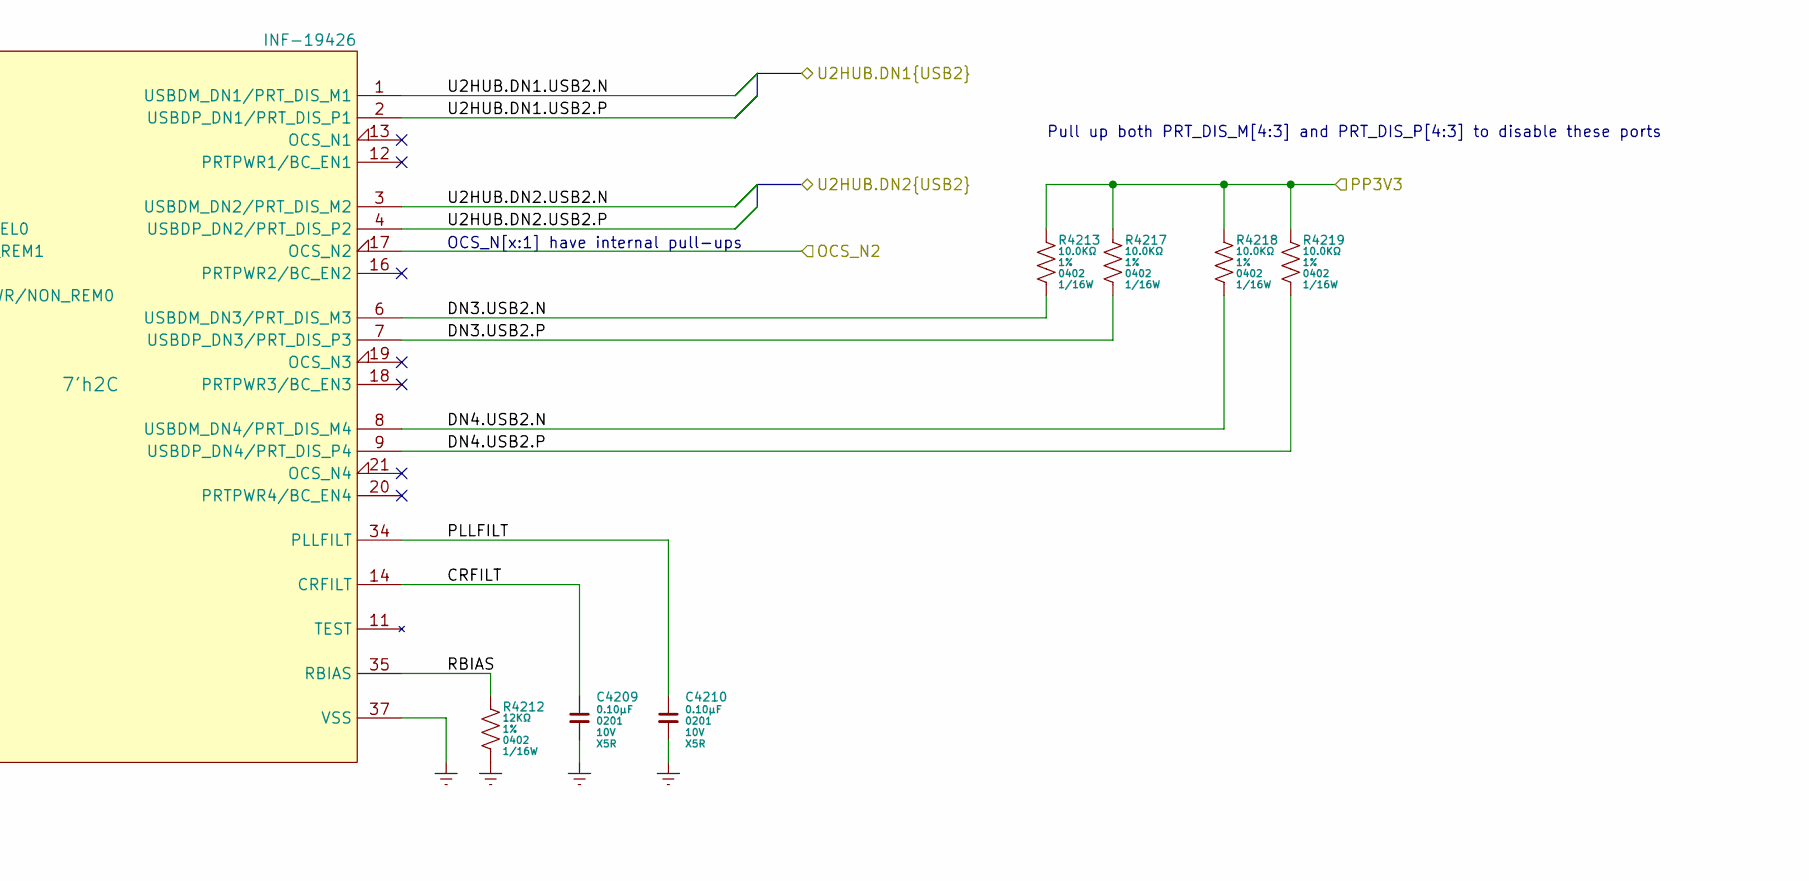
[picture p68: schematic usb2_hub.kicad_sch, part in row 1, column 2]

Parts:
C4201, C4202: CCM-180AA; mpn GRM0335C1H8R0DA01
C4203: CCM-710AD; mpn GRM033R61A105ME15
C4204, C4205, C4207, C4208, C4209, C4210, C4212: CCM-610AA; mpn GRM033R61A104ME15
C4206: CCM-622AA; mpn GRM033R60J224ME15
L4201: FRB-68805; mpn BLM18KG121TN1D
R4201, R4202, R4204, R4207, R4208: RES-0000A
R4203: RES-7100A
R4205, R4209, R4220, R4221, R4222: RES-6100A
R4206: RES-0000B
R4212: RES-5120B
R4213, R4216, R4217, R4218, R4219: RES-5100B
U4201: INF-19426; mpn USB2514B-I/M2
Y4201: XTL-25021; mpn XRCGB24M000F1SBAR0

Connections:
CFG_SEL0: R4201.2, R4222.1, U4201.24 (SCL/SMBCLK/CFG_SEL0)
CFG_SEL1: R4209.2, U4201.25 (HS_IND/CFG_SEL1)
CRFILT: C4209.1, U4201.14 (CRFILT)
DN3.USB2.N: R4213.2, U4201.6 (USBDM_DN3/PRT_DIS_M3)
DN3.USB2.P: R4217.2, U4201.7 (USBDP_DN3/PRT_DIS_P3)
DN4.USB2.N: R4218.2, U4201.8 (USBDM_DN4/PRT_DIS_M4)
DN4.USB2.P: R4219.2, U4201.9 (USBDP_DN4/PRT_DIS_P4)
GND: C4201.2, C4202.1, C4203.2, C4204.2, C4205.2, C4206.2, C4207.2, C4208.2, C4209.2, C4210.2, C4212.2, R4209.1, R4212.2, R4221.2, R4222.2, U4201.37 (VSS), Y4201.2, Y4201.4
NON_REM0: R4220.2, U4201.28 (SUSP_IND/LOCAL_PWR/NON_REM0)
NON_REM1: R4204.2, R4221.1, U4201.22 (SDA/SMBDATA/NON_REM1)
unnamed: R4207.2, U4201.30 (USBDM_UP)
unnamed: R4208.2, U4201.31 (USBDP_UP)
OCS_N2: U4201.17 (OCS_N2)
P3V3A_HUB: C4203.1, C4204.1, C4205.1, C4208.1, L4201.2, U4201.5 (VDDA33[3:0]), U4201.10 (VDDA33[3:0]), U4201.29 (VDDA33[3:0]), U4201.36 (VDDA33[3:0])
PLLFILT: C4210.1, U4201.34 (PLLFILT)
PP3V3: C4207.1, L4201.1, R4205.1, R4213.1, R4216.1, R4217.1, R4218.1, R4219.1, R4220.1, U4201.15 (VDD33[1:0]), U4201.23 (VDD33[1:0])
RBIAS: R4212.1, U4201.35 (RBIAS)
RESET_L: R4202.1
RST_L: C4206.1, R4202.2, R4205.2, U4201.26 (RESET_N)
SCL: R4201.1
SDA: R4204.1
U2HUB.DN1.USB2.N: U4201.1 (USBDM_DN1/PRT_DIS_M1)
U2HUB.DN1.USB2.P: U4201.2 (USBDP_DN1/PRT_DIS_P1)
U2HUB.DN2.USB2.N: U4201.3 (USBDM_DN2/PRT_DIS_M2)
U2HUB.DN2.USB2.P: U4201.4 (USBDP_DN2/PRT_DIS_P2)
U2HUB.UP.USB2.N: R4207.1
U2HUB.UP.USB2.P: R4208.1
VBUS_DET: C4212.1, R4216.2, U4201.27 (VBUS_DET)
XTALIN: C4202.2, R4203.2, U4201.33 (XTALIN/CLKIN), Y4201.1
XTALOUT: R4206.2, U4201.32 (XTALOUT)
XTALOUT_R: C4201.1, R4203.1, R4206.1, Y4201.3

Notes on the sheet:
OCS_N[x:1] have internal pull-ups
CFG_SEL[1:0] - b'00: Hub configured by strapping • Strap Options enabled • Self-powered operation enabled • Individual power switching • Individual over-current sensing
NOTE: Unmount pull-downs when using I2C
For measuring/adjusting drive level if needed
Pull up both PRT_DIS_M[4:3] and PRT_DIS_P[4:3] to disable these ports
NON_REM[1:0] = b'01: port 1 is non-removable
