rivosinc/scampi/sch/usb3_hub.kicad_sch

## KiCad design sch/usb3_hub.kicad_sch (2025-05-27)

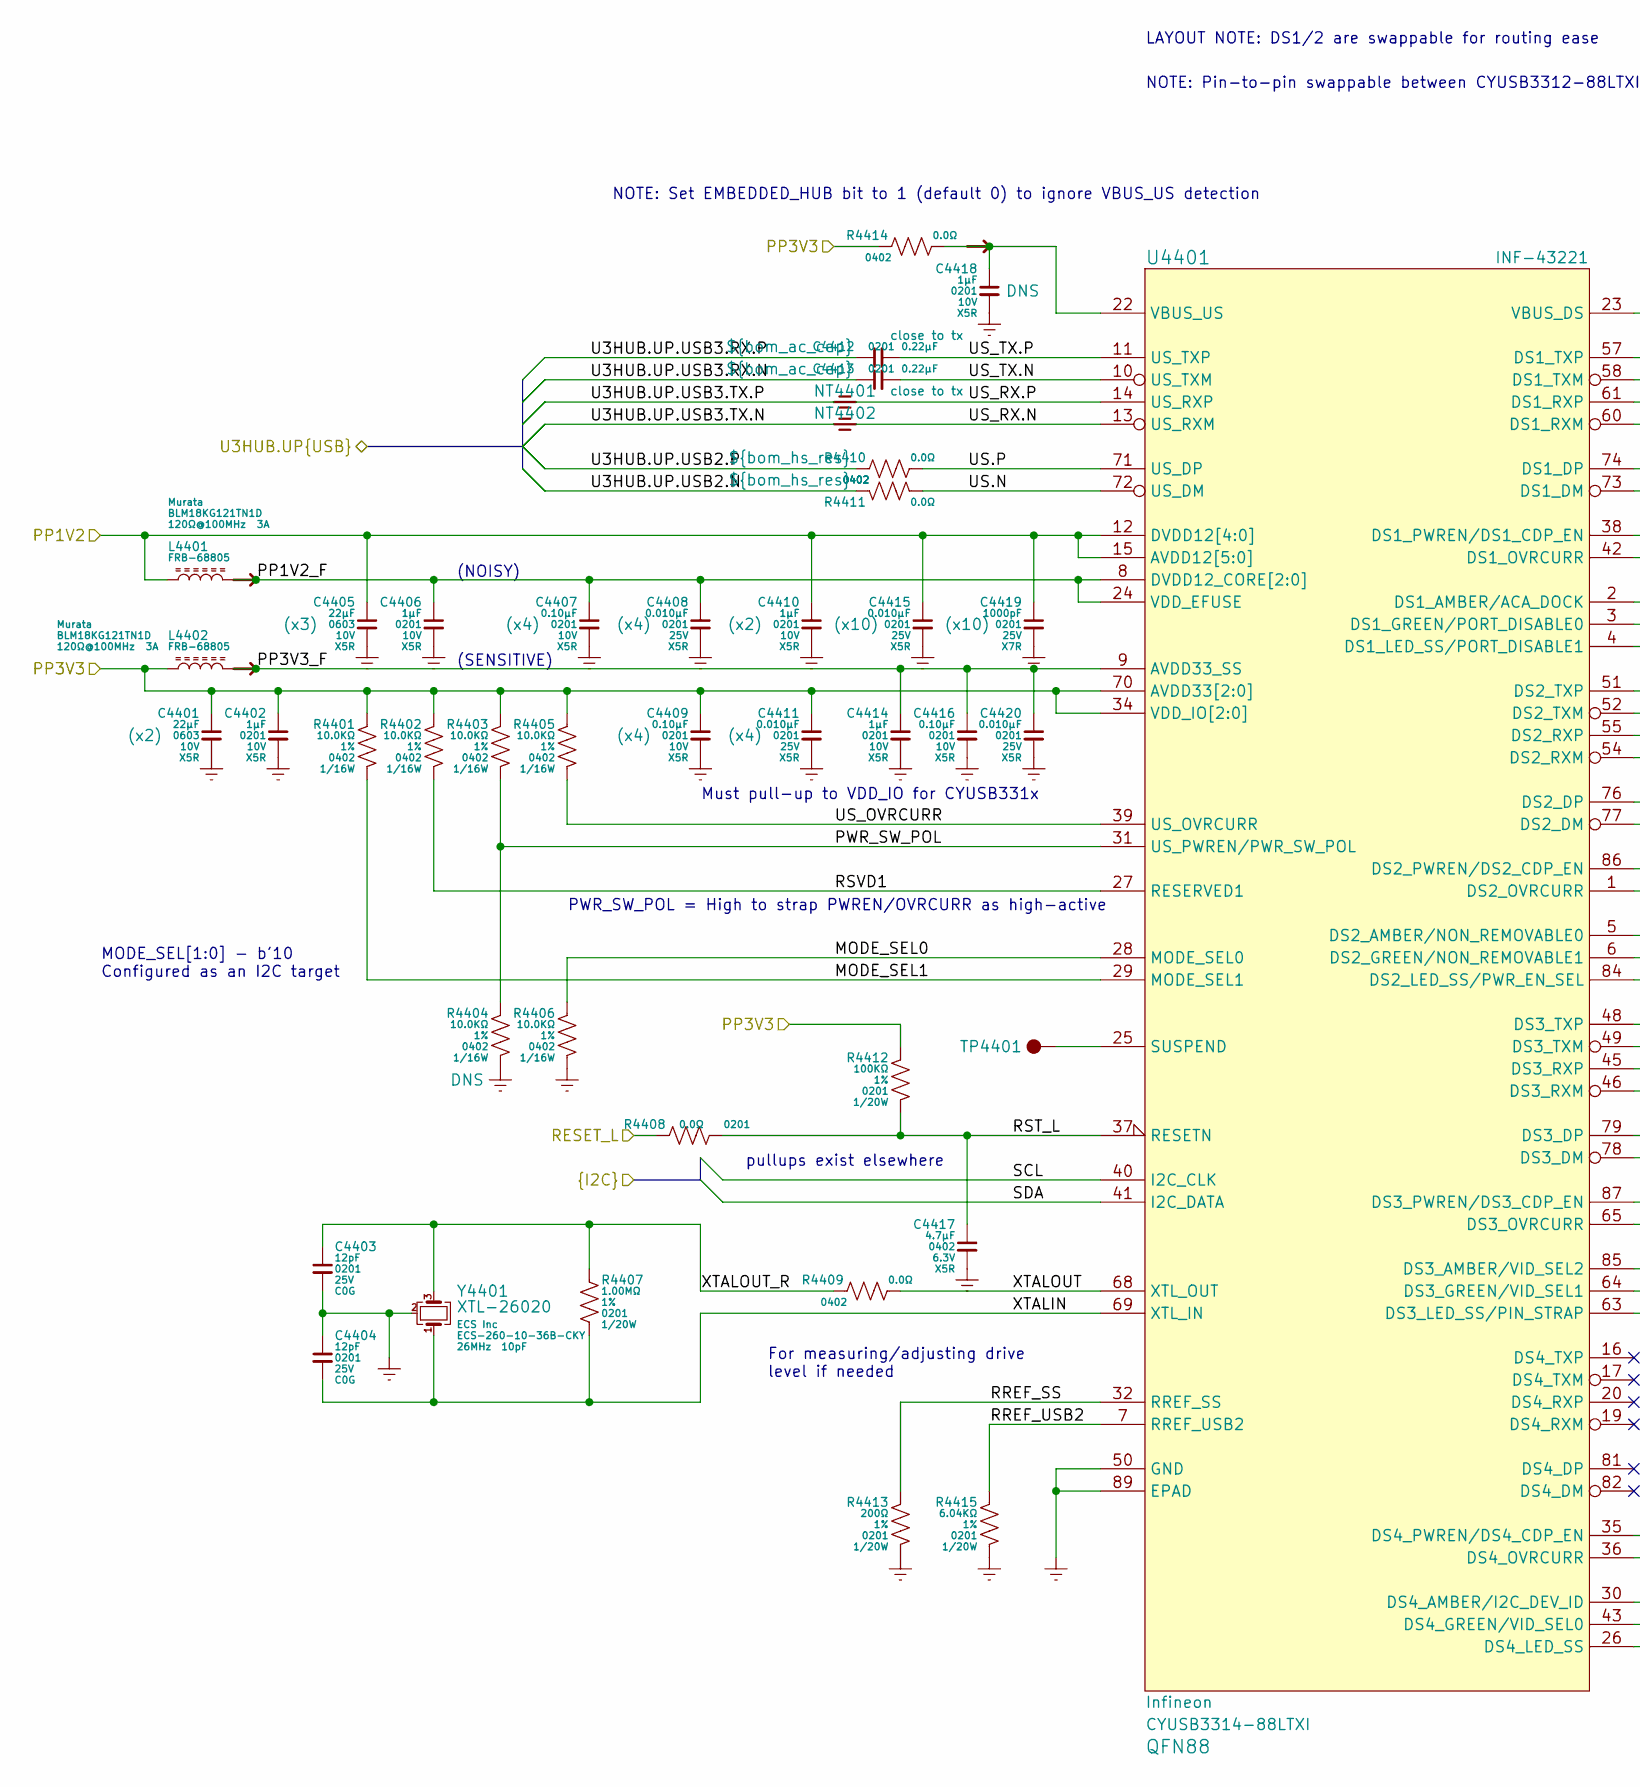
[picture p69: schematic usb3_hub.kicad_sch, part in row 1, column 1]

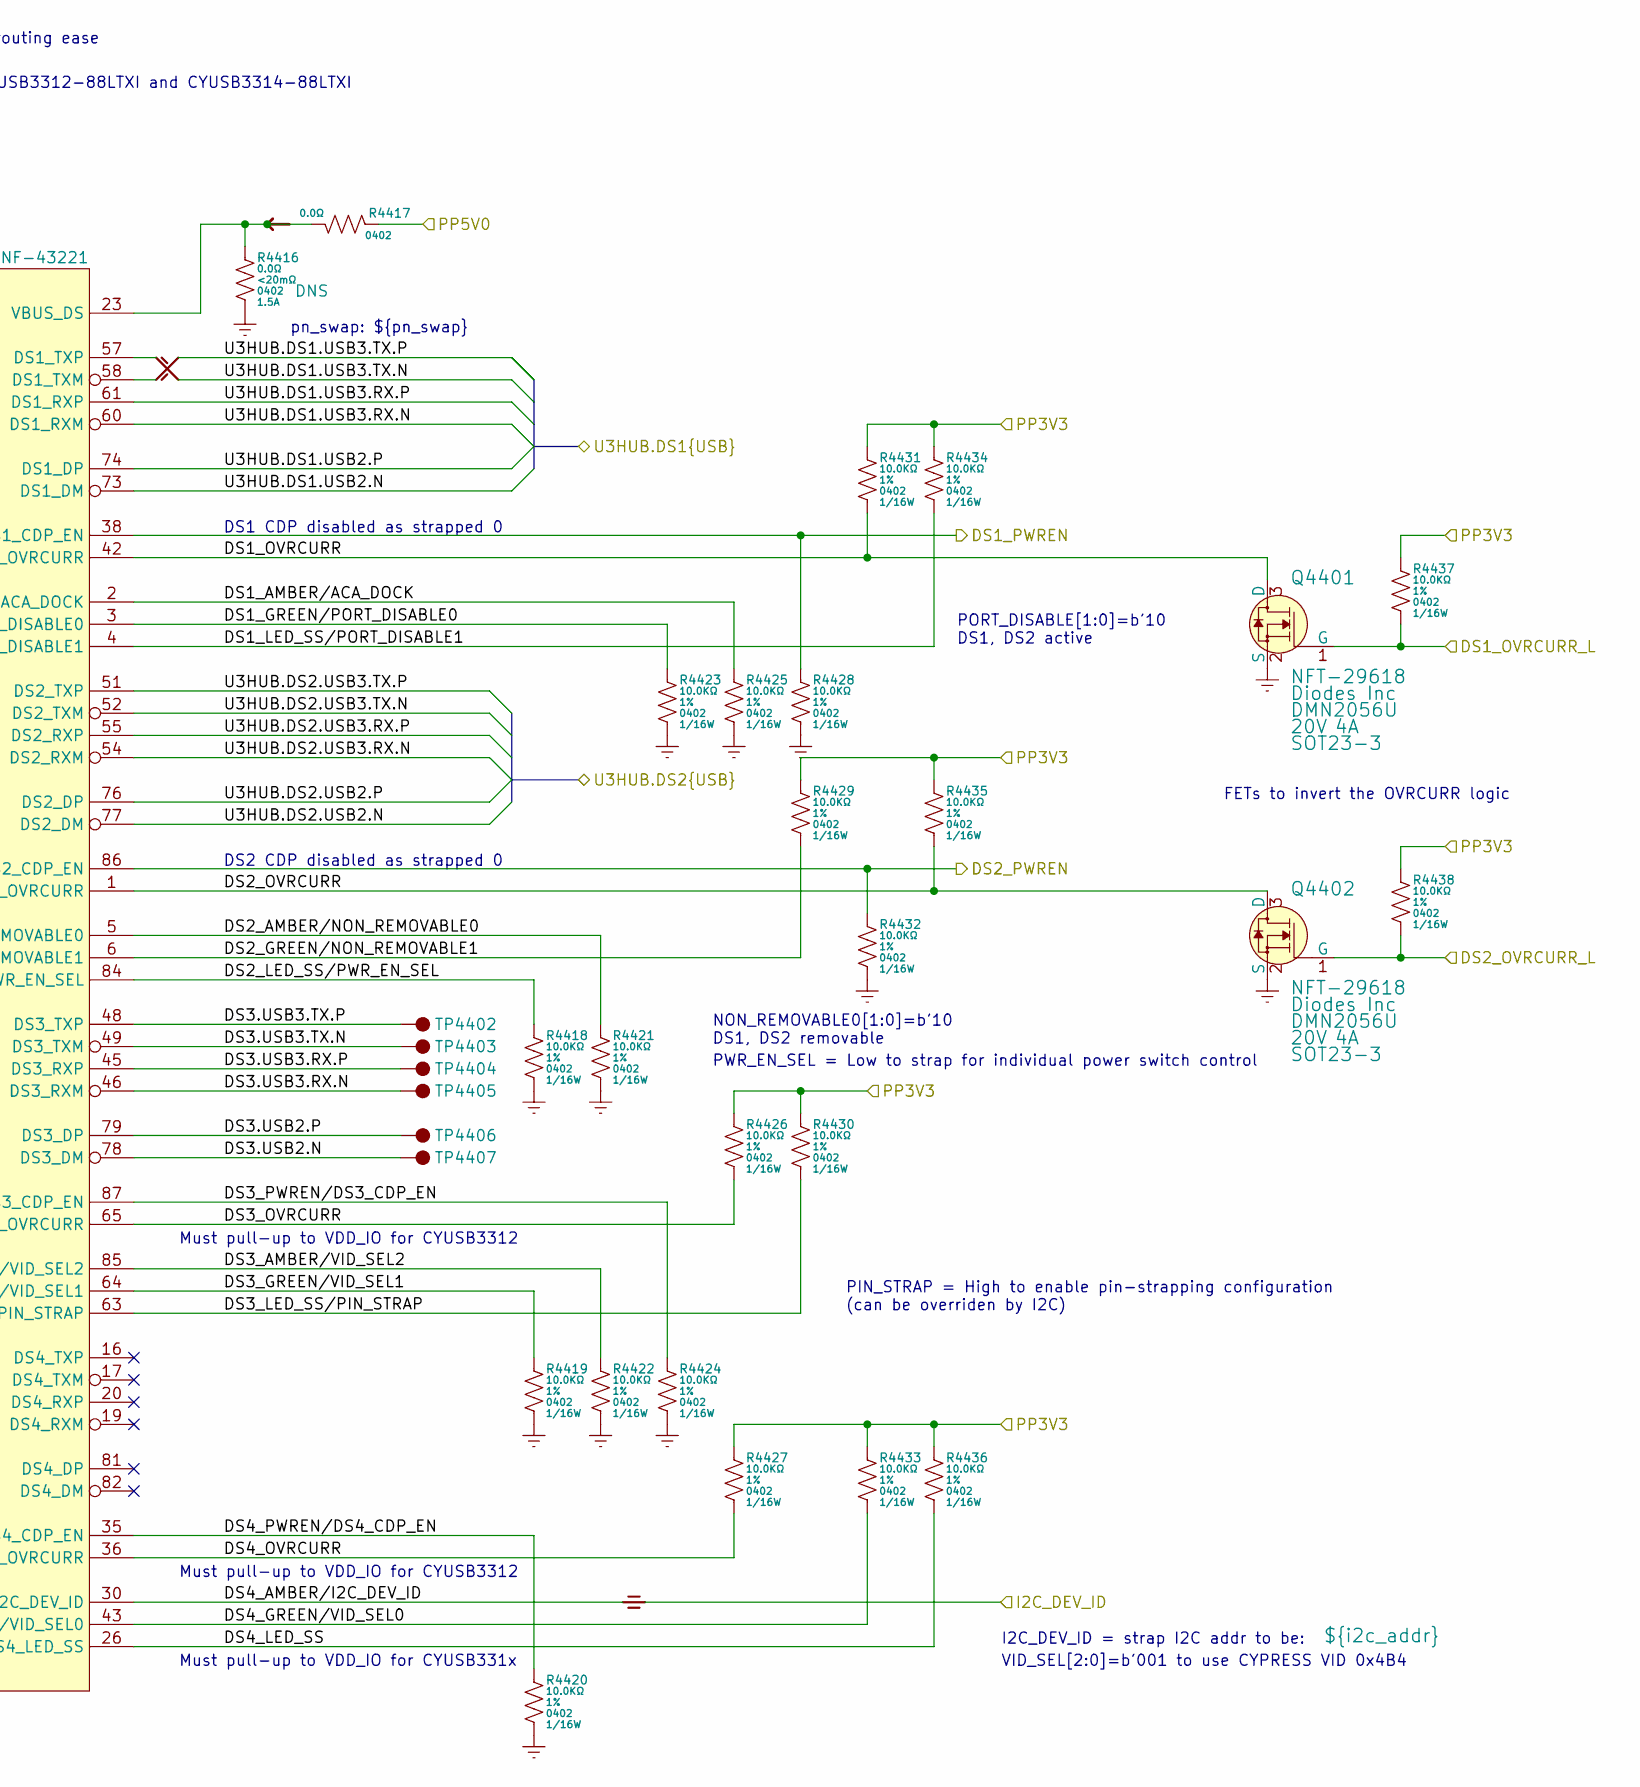
[picture p70: schematic usb3_hub.kicad_sch, part in row 1, column 2]

Parts:
C4401, C4405: CCM-822CC; mpn GRM188R61A226ME15
C4402, C4406, C4410, C4414, C4418: CCM-710AD; mpn GRM033R61A105ME15
C4403, C4404: CCM-212AA; mpn GRM0335C1E120JA01
C4407, C4409, C4416: CCM-610AA; mpn GRM033R61A104ME15
C4408, C4411, C4415, C4420: CCM-510AC; mpn GRM033R61E103MA12
C4412, C4413: CCM-622AA; mpn GRM033R60J224ME15
C4417: CCM-747BC; mpn GRM155R60J475ME47
C4419: CCM-410AA; mpn GRM033R71E102KA01
L4401, L4402: FRB-68805; mpn BLM18KG121TN1D
NT2: NET-20002
NT4401, NT4402, NT4403: NET-10002
Q4401, Q4402: NFT-29618; mpn DMN2056U
R4401, R4402, R4403, R4404, R4405, R4406, R4418, R4419, R4420, R4421, R4422, R4423, R4424, R4425, R4426, R4427, R4428, R4429, R4430, R4431, R4432, R4433, R4434, R4435, R4436, R4437, R4438: RES-5100B
R4407: RES-7100A
R4408: RES-0000A
R4409, R4410, R4411, R4414, R4416, R4417: RES-0000B
R4412: RES-6100A
R4413: RES-3200A
R4415: RES-4604A
TP4401, TP4402, TP4403, TP4404, TP4405, TP4406, TP4407: TST-01025
U4401: INF-43221; mpn CYUSB3314-88LTXI
Y4401: XTL-26020; mpn ECS-260-10-36B-CKY

Connections:
DS1_AMBER/ACA_DOCK: R4425.1, U4401.2 (DS1_AMBER/ACA_DOCK)
DS1_GREEN/PORT_DISABLE0: R4423.1, U4401.3 (DS1_GREEN/PORT_DISABLE0)
DS1_LED_SS/PORT_DISABLE1: R4434.2, U4401.4 (DS1_LED_SS/PORT_DISABLE1)
DS1_OVRCURR: Q4401.3 (D), R4431.2, U4401.42 (DS1_OVRCURR)
DS1_OVRCURR_L: Q4401.1 (G), R4437.2
DS1_PWREN: R4428.1, U4401.38 (DS1_PWREN/DS1_CDP_EN)
DS2_AMBER/NON_REMOVABLE0: R4421.1, U4401.5 (DS2_AMBER/NON_REMOVABLE0)
DS2_GREEN/NON_REMOVABLE1: R4429.2, U4401.6 (DS2_GREEN/NON_REMOVABLE1)
DS2_LED_SS/PWR_EN_SEL: R4418.1, U4401.84 (DS2_LED_SS/PWR_EN_SEL)
DS2_OVRCURR: Q4402.3 (D), R4435.2, U4401.1 (DS2_OVRCURR)
DS2_OVRCURR_L: Q4402.1 (G), R4438.2
DS2_PWREN: R4432.1, U4401.86 (DS2_PWREN/DS2_CDP_EN)
DS3.USB2.N: TP4407.1, U4401.78 (DS3_DM)
DS3.USB2.P: TP4406.1, U4401.79 (DS3_DP)
DS3.USB3.RX.N: TP4405.1, U4401.46 (DS3_RXM)
DS3.USB3.RX.P: TP4404.1, U4401.45 (DS3_RXP)
DS3.USB3.TX.N: TP4403.1, U4401.49 (DS3_TXM)
DS3.USB3.TX.P: TP4402.1, U4401.48 (DS3_TXP)
DS3_AMBER/VID_SEL2: R4422.1, U4401.85 (DS3_AMBER/VID_SEL2)
DS3_GREEN/VID_SEL1: R4419.1, U4401.64 (DS3_GREEN/VID_SEL1)
DS3_LED_SS/PIN_STRAP: R4430.2, U4401.63 (DS3_LED_SS/PIN_STRAP)
DS3_OVRCURR: R4426.2, U4401.65 (DS3_OVRCURR)
DS3_PWREN/DS3_CDP_EN: R4424.1, U4401.87 (DS3_PWREN/DS3_CDP_EN)
DS4_AMBER/I2C_DEV_ID: NT4403.1, U4401.30 (DS4_AMBER/I2C_DEV_ID)
DS4_GREEN/VID_SEL0: R4433.2, U4401.43 (DS4_GREEN/VID_SEL0)
DS4_LED_SS: R4436.2, U4401.26 (DS4_LED_SS)
DS4_OVRCURR: R4427.2, U4401.36 (DS4_OVRCURR)
DS4_PWREN/DS4_CDP_EN: R4420.1, U4401.35 (DS4_PWREN/DS4_CDP_EN)
GND: C4401.2, C4402.2, C4403.2, C4404.1, C4405.2, C4406.2, C4407.2, C4408.2, C4409.2, C4410.2, C4411.2, C4414.2, C4415.2, C4416.2, C4417.2, C4418.2, C4419.2, C4420.2, Q4401.2 (S), Q4402.2 (S), R4404.2, R4406.2, R4413.2, R4415.2, R4416.2, R4418.2, R4419.2, R4420.2, R4421.2, R4422.2, R4423.2, R4424.2, R4425.2, R4428.2, R4432.2, U4401.50 (GND), U4401.89 (EPAD), Y4401.2, Y4401.4
I2C_DEV_ID: NT4403.2
MODE_SEL0: R4406.1, U4401.28 (MODE_SEL0)
MODE_SEL1: R4401.2, U4401.29 (MODE_SEL1)
unnamed: C4418.1, R4414.2, U4401.22 (VBUS_US)
unnamed: NT2.A3, U4401.57 (DS1_TXP)
unnamed: NT2.A4, U4401.58 (DS1_TXM)
unnamed: R4416.1, R4417.2, U4401.23 (VBUS_DS)
unnamed: TP4401.1, U4401.25 (SUSPEND)
PP1V2: C4405.1, C4410.1, C4415.1, C4419.1, L4401.1, U4401.12 (DVDD12[4:0]), U4401.15 (AVDD12[5:0]), U4401.18 (DVDD12[4:0]), U4401.21 (AVDD12[5:0]), U4401.44 (AVDD12[5:0]), U4401.47 (DVDD12[4:0]), U4401.53 (DVDD12[4:0]), U4401.56 (AVDD12[5:0]), U4401.59 (DVDD12[4:0]), U4401.62 (AVDD12[5:0]), U4401.67 (AVDD12[5:0])
PP1V2_F: C4406.1, C4407.1, C4408.1, L4401.2, U4401.8 (DVDD12_CORE[2:0]), U4401.24 (VDD_EFUSE), U4401.33 (DVDD12_CORE[2:0]), U4401.83 (DVDD12_CORE[2:0])
PP3V3: C4401.1, C4402.1, C4409.1, C4411.1, L4402.1, R4401.1, R4402.1, R4403.1, R4405.1, R4412.1, R4414.1, R4426.1, R4427.1, R4429.1, R4430.1, R4431.1, R4433.1, R4434.1, R4435.1, R4436.1, R4437.1, R4438.1, U4401.34 (VDD_IO[2:0]), U4401.66 (VDD_IO[2:0]), U4401.70 (AVDD33[2:0]), U4401.75 (AVDD33[2:0]), U4401.80 (AVDD33[2:0]), U4401.88 (VDD_IO[2:0])
PP3V3_F: C4414.1, C4416.1, C4420.1, L4402.2, U4401.9 (AVDD33_SS)
PP5V0: R4417.1
PWR_SW_POL: R4403.2, R4404.1, U4401.31 (US_PWREN/PWR_SW_POL)
RESET_L: R4408.1
RREF_SS: R4413.1, U4401.32 (RREF_SS)
RREF_USB2: R4415.1, U4401.7 (RREF_USB2)
RST_L: C4417.1, R4408.2, R4412.2, U4401.37 (RESETN)
RSVD1: R4402.2, U4401.27 (RESERVED1)
SCL: U4401.40 (I2C_CLK)
SDA: U4401.41 (I2C_DATA)
U3HUB.DS1.USB2.N: U4401.73 (DS1_DM)
U3HUB.DS1.USB2.P: U4401.74 (DS1_DP)
U3HUB.DS1.USB3.RX.N: U4401.60 (DS1_RXM)
U3HUB.DS1.USB3.RX.P: U4401.61 (DS1_RXP)
U3HUB.DS1.USB3.TX.N: NT2.B3
U3HUB.DS1.USB3.TX.P: NT2.B4
U3HUB.DS2.USB2.N: U4401.77 (DS2_DM)
U3HUB.DS2.USB2.P: U4401.76 (DS2_DP)
U3HUB.DS2.USB3.RX.N: U4401.54 (DS2_RXM)
U3HUB.DS2.USB3.RX.P: U4401.55 (DS2_RXP)
U3HUB.DS2.USB3.TX.N: U4401.52 (DS2_TXM)
U3HUB.DS2.USB3.TX.P: U4401.51 (DS2_TXP)
U3HUB.UP.USB2.N: R4411.1
U3HUB.UP.USB2.P: R4410.1
U3HUB.UP.USB3.RX.N: C4413.1
U3HUB.UP.USB3.RX.P: C4412.1
U3HUB.UP.USB3.TX.N: NT4402.1
U3HUB.UP.USB3.TX.P: NT4401.1
US.N: R4411.2, U4401.72 (US_DM)
US.P: R4410.2, U4401.71 (US_DP)
US_OVRCURR: R4405.2, U4401.39 (US_OVRCURR)
US_RX.N: NT4402.2, U4401.13 (US_RXM)
US_RX.P: NT4401.2, U4401.14 (US_RXP)
US_TX.N: C4413.2, U4401.10 (US_TXM)
US_TX.P: C4412.2, U4401.11 (US_TXP)
XTALIN: C4404.2, R4407.2, U4401.69 (XTL_IN), Y4401.1
XTALOUT: R4409.2, U4401.68 (XTL_OUT)
XTALOUT_R: C4403.1, R4407.1, R4409.1, Y4401.3

Notes on the sheet:
PIN_STRAP = High to enable pin-strapping configuration (can be overriden by I2C)
MODE_SEL[1:0] - b'10 Configured as an I2C target
For measuring/adjusting drive level if needed
NON_REMOVABLE0[1:0]=b'10 DS1, DS2 removable
pn_swap: ${pn_swap}
DS2 CDP disabled as strapped 0
Must pull-up to VDD_IO for CYUSB331x
(SENSITIVE)
Must pull-up to VDD_IO for CYUSB3312
NOTE: Pin-to-pin swappable between CYUSB3312-88LTXI and CYUSB3314-88LTXI
I2C_DEV_ID = strap I2C addr to be:
(NOISY)
VID_SEL[2:0]=b'001 to use CYPRESS VID 0x4B4
FETs to invert the OVRCURR logic
PORT_DISABLE[1:0]=b'10 DS1, DS2 active
NOTE: Set EMBEDDED_HUB bit to 1 (default 0) to ignore VBUS_US detection
DS1 CDP disabled as strapped 0
pullups exist elsewhere
PWR_SW_POL = High to strap PWREN/OVRCURR as high-active
PWR_EN_SEL = Low to strap for individual power switch control
LAYOUT NOTE: DS1/2 are swappable for routing ease
