rivosinc/scampi/sch/usb.kicad_sch

## KiCad design sch/usb.kicad_sch (2025-05-27)

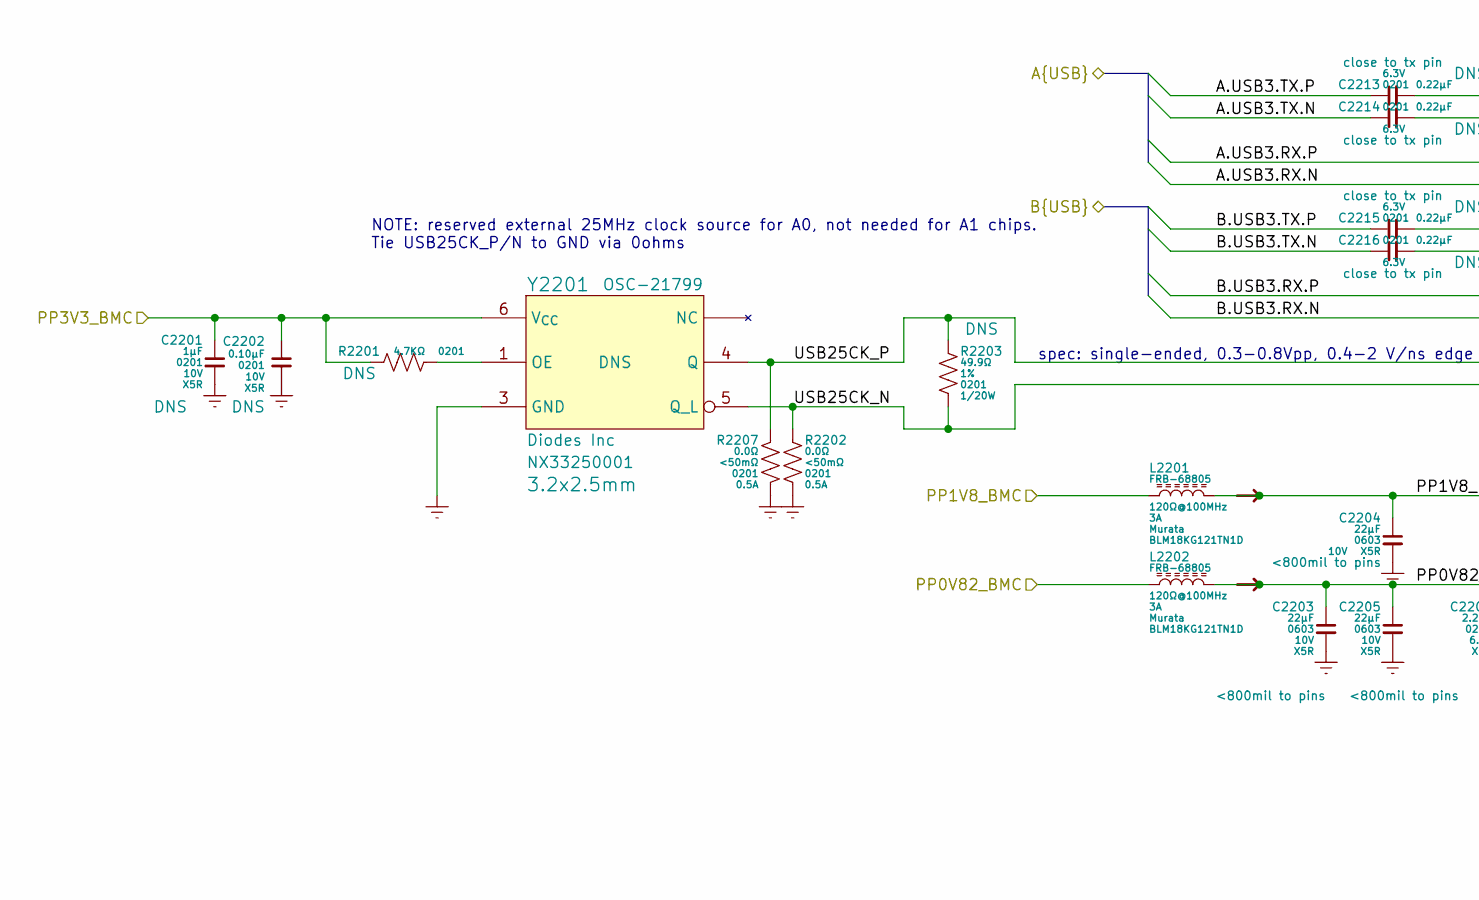
[picture p71: schematic usb.kicad_sch, part in row 1, column 1]

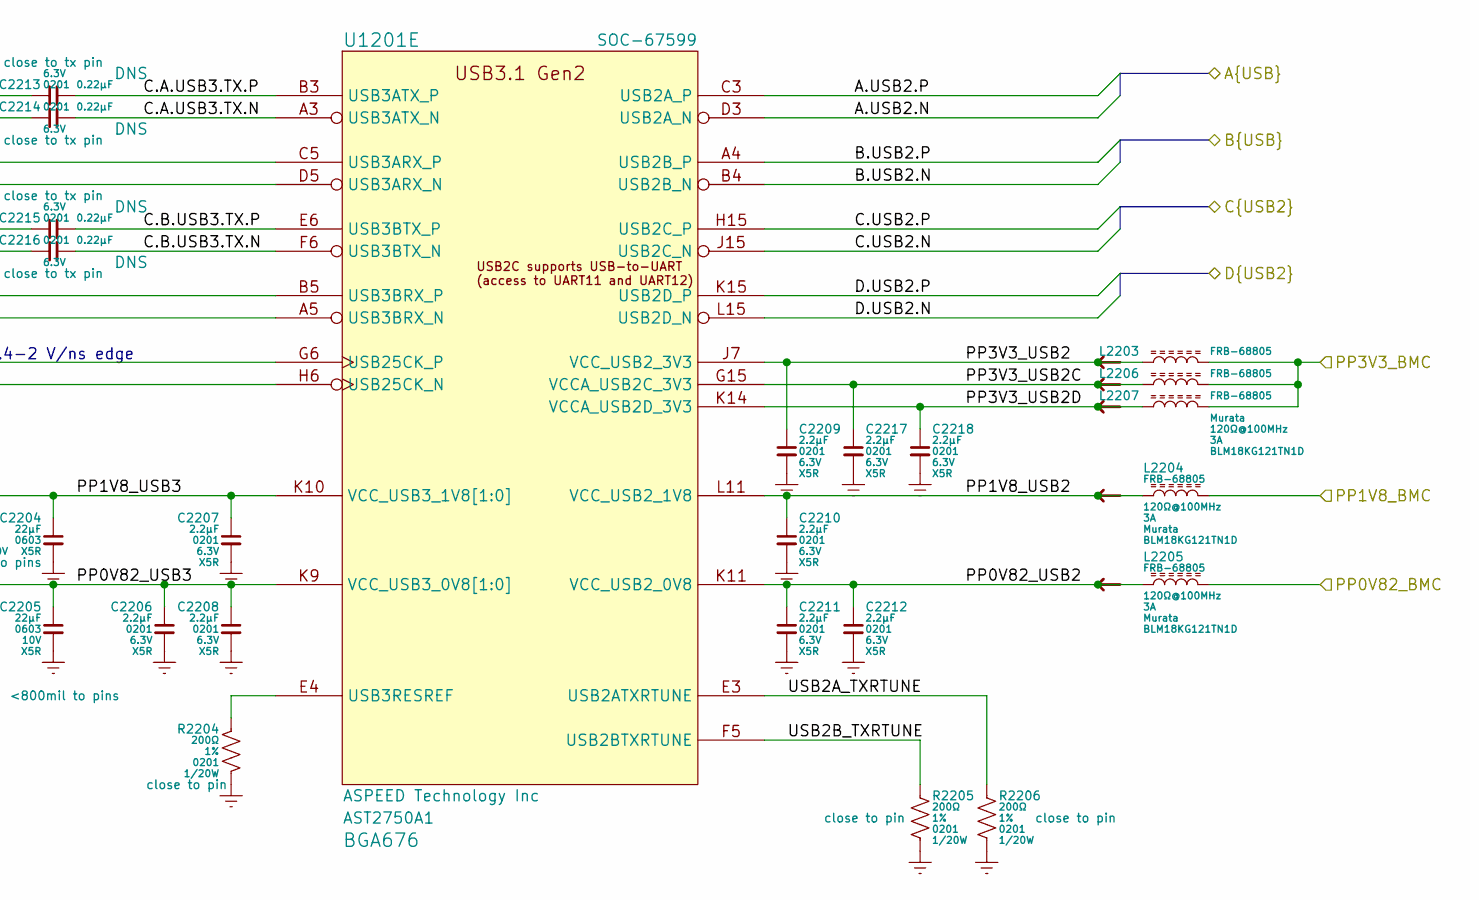
[picture p72: schematic usb.kicad_sch, part in row 1, column 2]

Parts:
C2201: CCM-710AD; mpn GRM033R61A105ME15
C2202: CCM-610AA; mpn GRM033R61A104ME15
C2203, C2204, C2205: CCM-822CC; mpn GRM188R61A226ME15
C2206, C2207, C2208, C2209, C2210, C2211, C2212, C2217, C2218: CCM-722AA; mpn GRM033R60J225ME01
C2213, C2214, C2215, C2216: CCM-622AA; mpn GRM033R60J224ME15
L2201, L2202, L2203, L2204, L2205, L2206, L2207: FRB-68805; mpn BLM18KG121TN1D
R2201: RES-4470A
R2202, R2207: RES-0000A
R2203: RES-2499A
R2204, R2205, R2206: RES-3200A
U1201: SOC-67599; mpn AST2750A1
Y2201: OSC-21799; mpn NX33250001

Connections:
A.USB2.N: U1201.D3 (USB2A_N)
A.USB2.P: U1201.C3 (USB2A_P)
A.USB3.RX.N: U1201.D5 (USB3ARX_N)
A.USB3.RX.P: U1201.C5 (USB3ARX_P)
A.USB3.TX.N: C2214.1
A.USB3.TX.P: C2213.1
B.USB2.N: U1201.B4 (USB2B_N)
B.USB2.P: U1201.A4 (USB2B_P)
B.USB3.RX.N: U1201.A5 (USB3BRX_N)
B.USB3.RX.P: U1201.B5 (USB3BRX_P)
B.USB3.TX.N: C2216.1
B.USB3.TX.P: C2215.1
C.A.USB3.TX.N: C2214.2, U1201.A3 (USB3ATX_N)
C.A.USB3.TX.P: C2213.2, U1201.B3 (USB3ATX_P)
C.B.USB3.TX.N: C2216.2, U1201.F6 (USB3BTX_N)
C.B.USB3.TX.P: C2215.2, U1201.E6 (USB3BTX_P)
C.USB2.N: U1201.J15 (USB2C_N)
C.USB2.P: U1201.H15 (USB2C_P)
D.USB2.N: U1201.L15 (USB2D_N)
D.USB2.P: U1201.K15 (USB2D_P)
GND: C2201.2, C2202.2, C2203.2, C2204.2, C2205.2, C2206.2, C2207.2, C2208.2, C2209.2, C2210.2, C2211.2, C2212.2, C2217.2, C2218.2, R2202.2, R2204.2, R2205.2, R2206.2, R2207.2, Y2201.3 (GND)
unnamed: R2201.2, Y2201.1 (OE)
unnamed: R2204.1, U1201.E4 (USB3RESREF)
PP0V82_BMC: L2202.1, L2205.2
PP0V82_USB2: C2211.1, C2212.1, L2205.1, U1201.K11 (VCC_USB2_0V8)
PP0V82_USB3: C2203.1, C2205.1, C2206.1, C2208.1, L2202.2, U1201.K9 (VCC_USB3_0V8[1:0]), U1201.L9 (VCC_USB3_0V8[1:0])
PP1V8_BMC: L2201.1, L2204.2
PP1V8_USB2: C2210.1, L2204.1, U1201.L11 (VCC_USB2_1V8)
PP1V8_USB3: C2204.1, C2207.1, L2201.2, U1201.K10 (VCC_USB3_1V8[1:0]), U1201.L10 (VCC_USB3_1V8[1:0])
PP3V3_BMC: C2201.1, C2202.1, L2203.2, L2206.2, L2207.2, R2201.1, Y2201.6 (V_{CC})
PP3V3_USB2: C2209.1, L2203.1, U1201.J7 (VCC_USB2_3V3)
PP3V3_USB2C: C2217.1, L2206.1, U1201.G15 (VCCA_USB2C_3V3)
PP3V3_USB2D: C2218.1, L2207.1, U1201.K14 (VCCA_USB2D_3V3)
USB2A_TXRTUNE: R2206.1, U1201.E3 (USB2ATXRTUNE)
USB2B_TXRTUNE: R2205.1, U1201.F5 (USB2BTXRTUNE)
USB25CK_N: R2202.1, R2203.2, U1201.H6 (USB25CK_N), Y2201.5 (Q_L)
USB25CK_P: R2203.1, R2207.1, U1201.G6 (USB25CK_P), Y2201.4 (Q)

Notes on the sheet:
NOTE: reserved external 25MHz clock source for A0, not needed for A1 chips. Tie USB25CK_P/N to GND via 0ohms
spec: single-ended, 0.3-0.8Vpp, 0.4-2 V/ns edge
