rivosinc/scampi/sch/usb_conns.kicad_sch

## KiCad design sch/usb_conns.kicad_sch (2025-05-27)

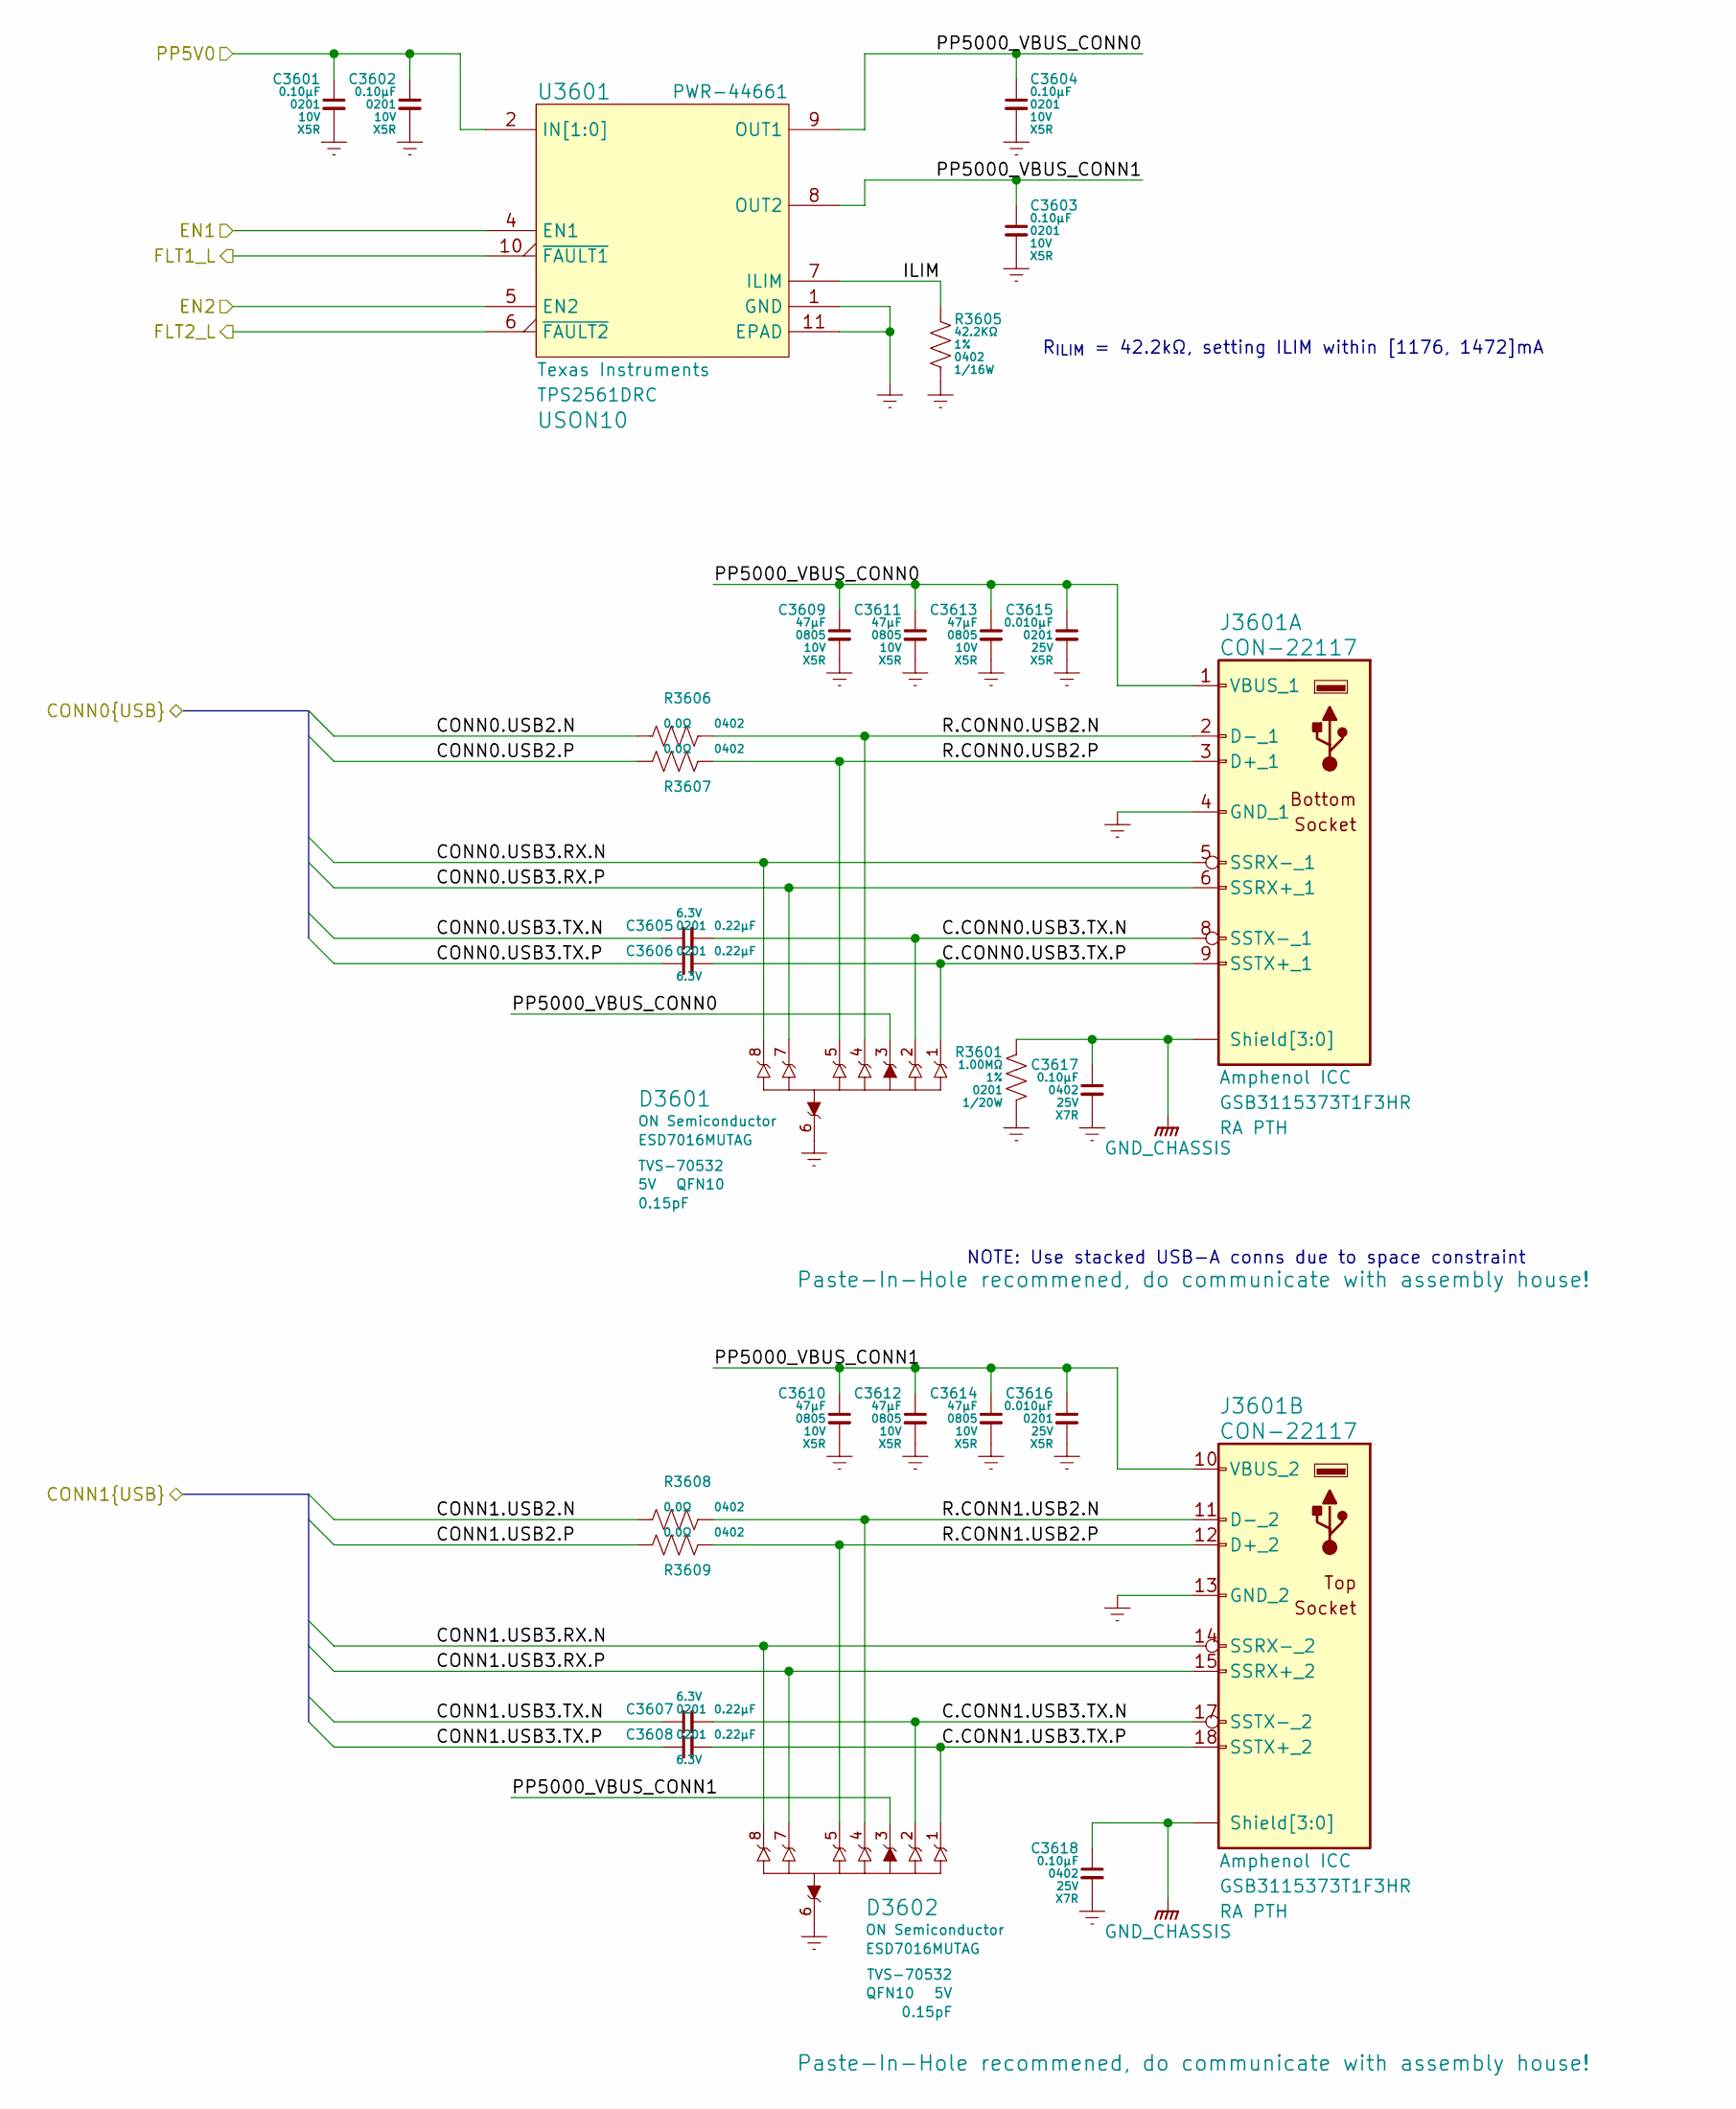
[picture p73: schematic usb_conns.kicad_sch]

Parts:
C3601, C3602, C3603, C3604: CCM-610AA; mpn GRM033R61A104ME15
C3605, C3606, C3607, C3608: CCM-622AA; mpn GRM033R60J224ME15
C3609, C3610, C3611, C3612, C3613, C3614: CCM-847DB; mpn GRM21BR61A476ME15
C3615, C3616: CCM-510AC; mpn GRM033R61E103MA12
C3617, C3618: CCM-610BA; mpn GRM155R71E104KE14
D3601, D3602: TVS-70532; mpn ESD7016MUTAG
J3601: CON-22117; mpn GSB3115373T1F3HR
R3601: RES-7100A
R3605: RES-5422B
R3606, R3607, R3608, R3609: RES-0000B
U3601: PWR-44661; mpn TPS2561DRC

Connections:
C.CONN0.USB3.TX.N: C3605.2, D3601.2, J3601.8 (SSTX-_1)
C.CONN0.USB3.TX.P: C3606.2, D3601.1, J3601.9 (SSTX+_1)
C.CONN1.USB3.TX.N: C3607.2, D3602.2, J3601.17 (SSTX-_2)
C.CONN1.USB3.TX.P: C3608.2, D3602.1, J3601.18 (SSTX+_2)
CONN0.USB2.N: R3606.1
CONN0.USB2.P: R3607.1
CONN0.USB3.RX.N: D3601.8, J3601.5 (SSRX-_1)
CONN0.USB3.RX.P: D3601.7, J3601.6 (SSRX+_1)
CONN0.USB3.TX.N: C3605.1
CONN0.USB3.TX.P: C3606.1
CONN1.USB2.N: R3608.1
CONN1.USB2.P: R3609.1
CONN1.USB3.RX.N: D3602.8, J3601.14 (SSRX-_2)
CONN1.USB3.RX.P: D3602.7, J3601.15 (SSRX+_2)
CONN1.USB3.TX.N: C3607.1
CONN1.USB3.TX.P: C3608.1
EN1: U3601.4 (EN1)
EN2: U3601.5 (EN2)
FLT1_L: U3601.10 (~FAULT1)
FLT2_L: U3601.6 (~FAULT2)
GND: C3601.2, C3602.2, C3603.2, C3604.2, C3609.2, C3610.2, C3611.2, C3612.2, C3613.2, C3614.2, C3615.2, C3616.2, C3617.2, C3618.2, D3601.6, D3602.6, J3601.4 (GND_1), J3601.7 (GND_1), J3601.13 (GND_2), J3601.16 (GND_2), R3601.2, R3605.2, U3601.1 (GND), U3601.11 (EPAD)
GND_CHASSIS: C3617.1, C3618.1, J3601.19 (Shield[3:0]), J3601.20 (Shield[3:0]), J3601.21 (Shield[3:0]), J3601.22 (Shield[3:0]), R3601.1
ILIM: R3605.1, U3601.7 (ILIM)
PP5V0: C3601.1, C3602.1, U3601.2 (IN[1:0]), U3601.3 (IN[1:0])
PP5000_VBUS_CONN0: C3604.1, C3609.1, C3611.1, C3613.1, C3615.1, D3601.3, J3601.1 (VBUS_1), U3601.9 (OUT1)
PP5000_VBUS_CONN1: C3603.1, C3610.1, C3612.1, C3614.1, C3616.1, D3602.3, J3601.10 (VBUS_2), U3601.8 (OUT2)
R.CONN0.USB2.N: D3601.4, J3601.2 (D-_1), R3606.2
R.CONN0.USB2.P: D3601.5, J3601.3 (D+_1), R3607.2
R.CONN1.USB2.N: D3602.4, J3601.11 (D-_2), R3608.2
R.CONN1.USB2.P: D3602.5, J3601.12 (D+_2), R3609.2

Notes on the sheet:
NOTE: Use stacked USB-A conns due to space constraint
R_{ILIM} = 42.2kΩ, setting ILIM within [1176, 1472]mA
