rivosinc/scampi/sch/usb_hubs.kicad_sch

## KiCad design sch/usb_hubs.kicad_sch (2025-05-27)

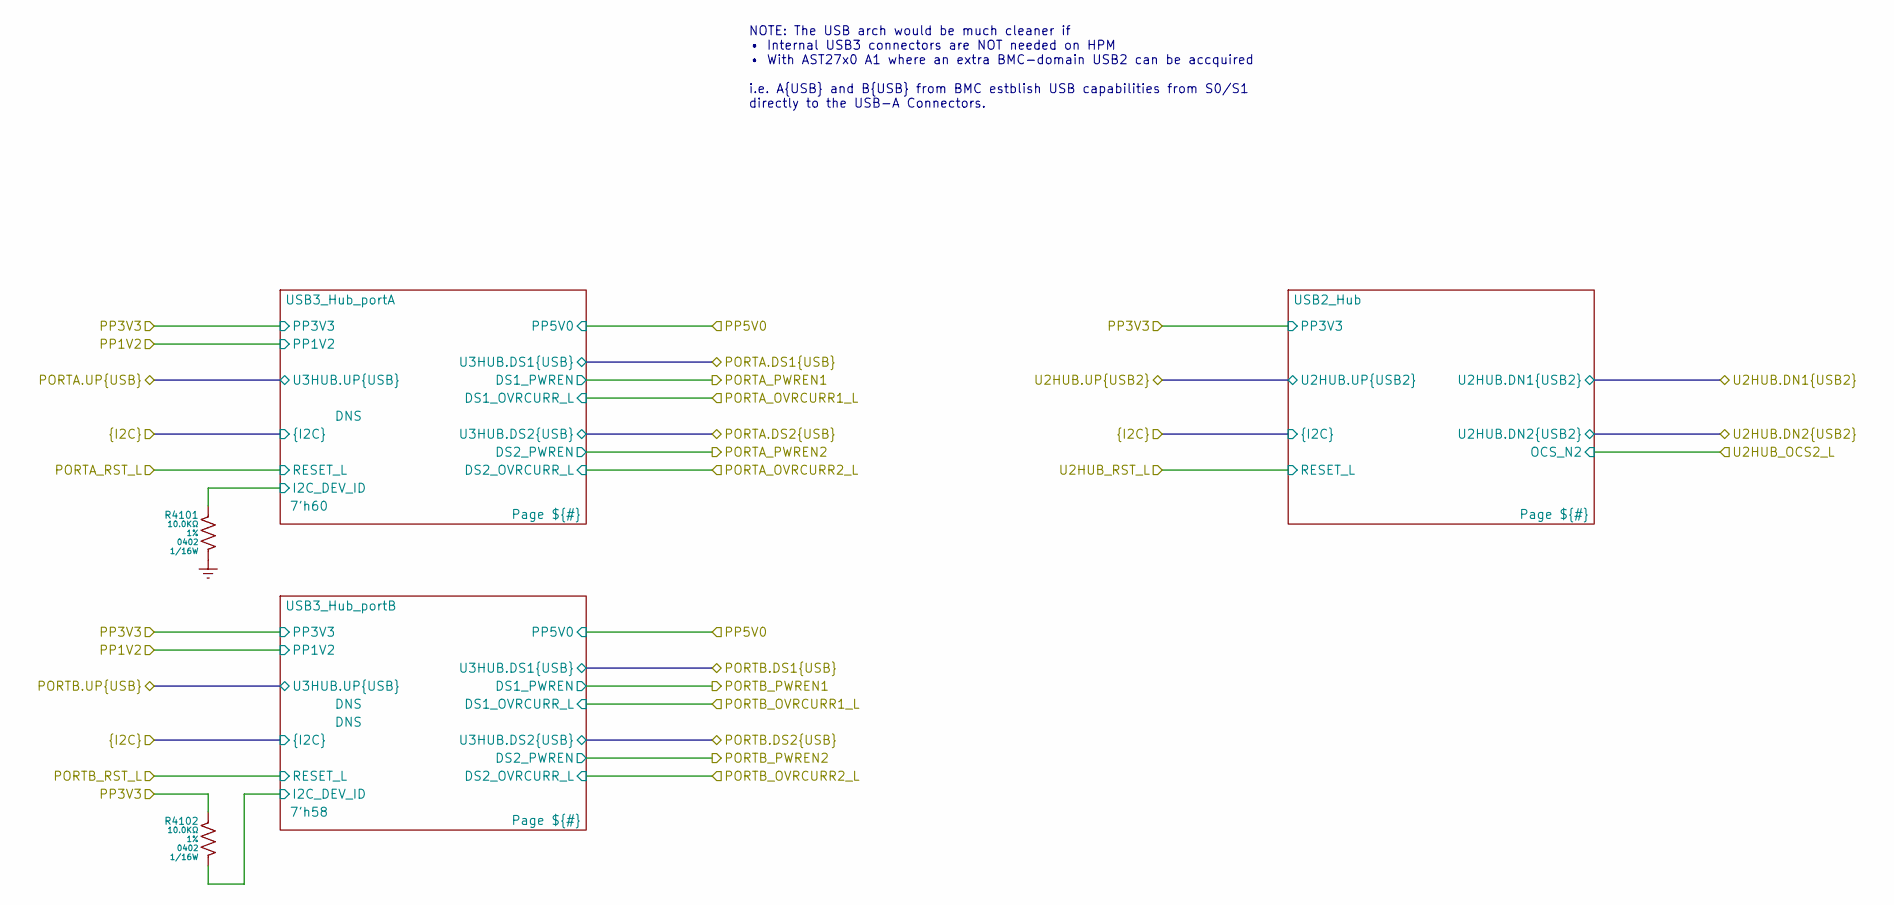
[picture p74: schematic usb_hubs.kicad_sch]

Parts:
R4101, R4102: RES-5100B

Connections:
GND: R4101.2
I2C_DEV_ID: R4101.1, R4102.2
PP3V3: R4102.1

Notes on the sheet:
NOTE: The USB arch would be much cleaner if • Internal USB3 connectors are NOT needed on HPM • With AST27x0 A1 where an extra BMC-domain USB2 can be accquired i.e. A{USB} and B{USB} from BMC estblish USB capabilities from S0/S1 directly to the USB-A Connectors.
