rivosinc/scampi/sch/vga.kicad_sch

## KiCad design sch/vga.kicad_sch (2025-05-27)

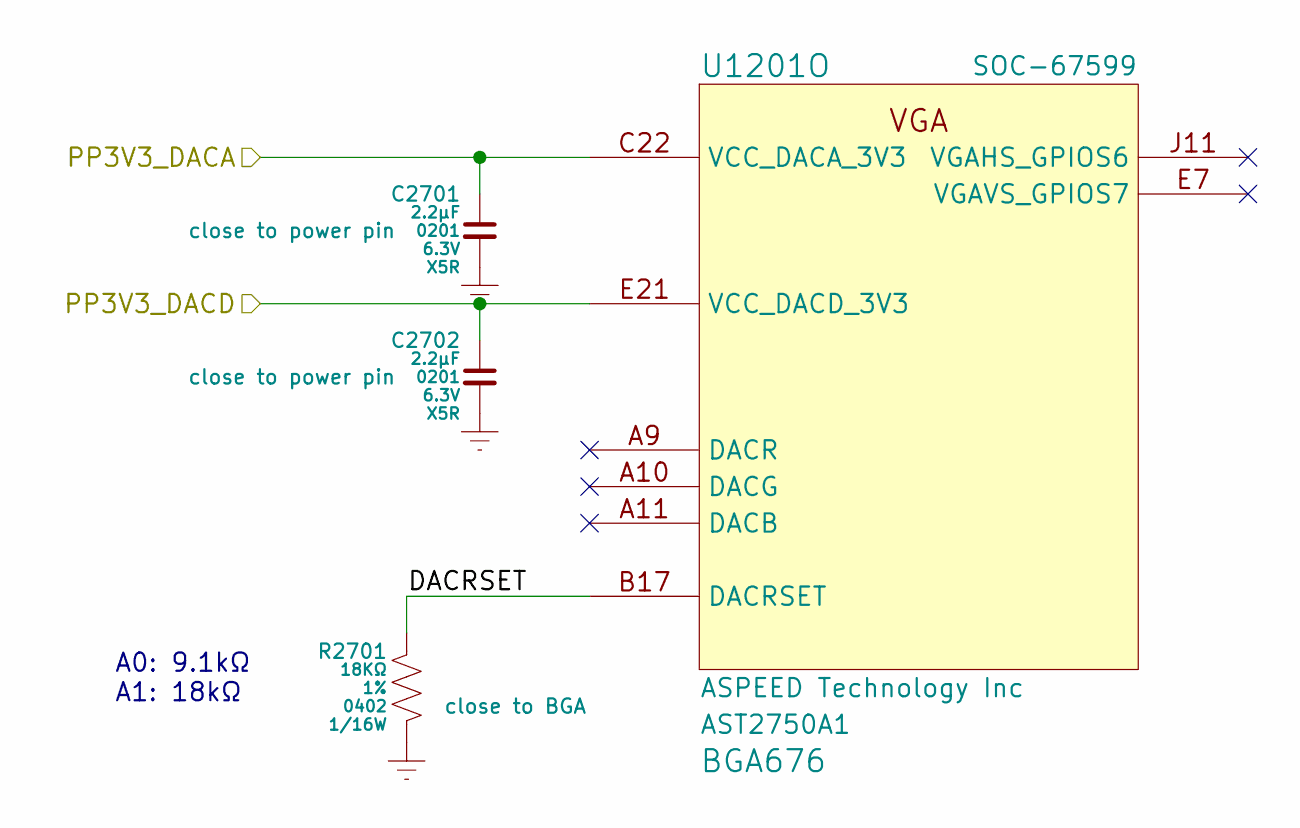
[picture p75: schematic vga.kicad_sch]

Parts:
C2701, C2702: CCM-722AA; mpn GRM033R60J225ME01
R2701: RES-5180B
U1201: SOC-67599; mpn AST2750A1

Connections:
DACRSET: R2701.1, U1201.B17 (DACRSET)
GND: C2701.2, C2702.2, R2701.2
PP3V3_DACA: C2701.1, U1201.C22 (VCC_DACA_3V3)
PP3V3_DACD: C2702.1, U1201.E21 (VCC_DACD_3V3)

Notes on the sheet:
A0: 9.1kΩ A1: 18kΩ
